xigua862/SMARTCAR2/CYH-NYY19届负压镜头纯跟踪算法/CYH-NYY19届负压镜头逆透视代码/视觉/灰度分布图/415e09331354bd54e4fce17c8508f7d.jpg

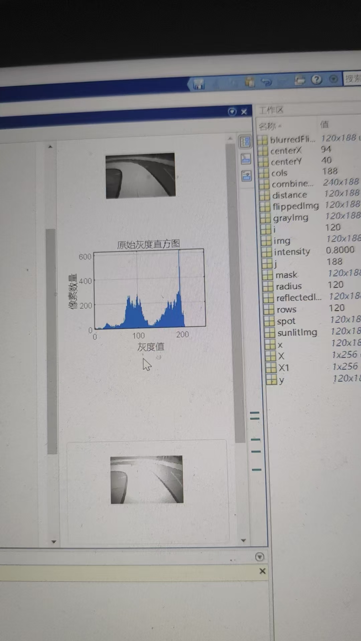
CYH-NYY19届负压镜头纯跟踪算法/CYH-NYY19届负压镜头逆透视代码/视觉/灰度分布图/415e09331354bd54e4fce17c8508f7d.jpg
