xigua862/SMARTCAR2/交接3-唯一入口-20261003.md

# B 车（微缩车）· 唯一入口 · 合并版

---

## §0 一页现状（2026-10-04 夜 · **PCB 阶段**）★ 新对话先读这一节

> 本节比下面的 §1~§5 新。**冲突时以本节为准。**

### 0.1 一句话

**原理图全部画完（DRC 已清）；PCB 刚开始 —— 板框和 5 个安装孔已定，正在布局。**

### 0.2 PCB 当前数据（直接可画）

```
板框      66 × 88mm  【实际做 87】（每侧 0.5mm 磨轮量）；厚 2.0mm
          后缘与框架后缘平齐，超长的 11.5mm 全部堆在车头
安装孔 5 个：Y（距板前缘）= 14 / 28 / 37 / 54 / 63     ← 前轴 28、后轴 54（轴距 26 ✓）
          孔径 φ2.2~2.4；配 M2×8~10 + 六面螺母
          X = 框架孔横向位置 ⏳【仍未量】——量法：框架孔中心 → 轮子内侧面的距离；<3mm 就把孔改成"板边开口槽"
转向中心  板前缘后 41mm
探头连线  板前缘【前】17mm（L=45）；可调 −7 ~ −27（L=35~55）⇒ 舌板前伸 ≥17mm
电路板    垫高 6~8mm（架在上排孔上方）→ 夹层 17~18mm 装下 15mm 电池
```

### 0.3 机械上的大变更（2026-10-04）

**侧框架前后翻转** → **编码器靠近车头、电机靠近车尾** ⇒ 编码器→前·核心、电机→后·驱动，**两条线不再交叉** ✓

⚠ 固件里 **"电机方向"翻一次**（两个一起）；编码器"左右一侧取负号"**不用变**（电机与编码器同在一框，相对关系未变）

### 0.4 这次会话（10-03→10-04）定下/改掉的东西

| 项 | 结论 |
|---|---|
| **灰度** | 外购龙邱 8 路模拟量 + **用「并出」10P**：**A0~A7 → PA0~PA7**（ADC 扫描+DMA，≈10µs、零偏斜）；**8 组 1k/1.5k + 100nF 分压**（模块供 5V）；"串出/1ADC+3GPIO"方案**作废** |
| **按键 ×2** | `PC13` = 正式发车键；`PB0` = 测试开始键（测试模式：电机 IN1=IN2=0 滑行+休眠、不循迹、等串口采数）|
| **LED ×3** | `PC14 / PC15 / PA12`，**串 470Ω** |
| **蜂鸣器** | **有源 5V**（PB10 → 1kΩ → SS8050 低边 + 1N4148W 续流）；**有源 = 只能开/关，不能 PWM 调音** |
| **编码器线序** | 6P（**GH1.25-6PWT**）：`1 GND / 2 VCC(3.3V) / 3 LSB(A相) / 4 DIR / 5 Z相 / 6 B相` —— **只用 A/B**（DIR、Z 留焊盘悬空）。左 = 3→PA15、6→PB3；右 = 3→PB4、6→PB5 |
| **驱动** | AT8236（**普通版**：VREF 接 3.3V；或 N 版）**R_ISEN = 0.11Ω/2512/≥1W → 3A**；⚠ ISEN 绝对最大 0.5V ⇒ R ≤ 0.167Ω |
| **保险** | VM 轨 = **一次性慢熔 10A（2410）**；逻辑轨 = 0.5A PTC（SMD1206-050-16）**两路分开** |
| **电源** | 5V 轨 ≈**320mA**（灰度 170 + LDO 输入 120 + 蜂鸣 30）→ 降压模块 **≥400mA**；**LDO = ME6211C33M5G-N**（3.3V 只喂 MCU/IMU/编码器/LED ≈120mA）|
| **空闲脚** | 全车只剩 **PB11**（PA4~PA7 已给灰度的 A4~A7）|
| **结构结论** | 结构件用 **PCB 不用碳板**（碳纤维导电 + 校赛不称重）|

### 0.5 ⏳ 待实测（按优先级；前 3 条阻塞后续）

1. **★喷绘布 940nm 对比度**（最高优先）：布 = 白 PVC + 黑墨，近红外可能穿透 → 黑态地基塌。用灰度模块**供 5V**在布上压白线/压黑底，量 **AO** 输出差
2. **★BN30-HSA 内部减速比**：总比 = 内部比 × 4.4。**总比 >28 连 R200 的 1.4m/s 都到不了**；建议 ≤20 ⇒ 决定要不要换齿轮配对（44+10 / 40+14 / 34+20，中心距都是 13.5mm）
3. **★框架孔的横向位置 X**（板框孔位最后一块拼图）
4. **灰度模块**：最小检测高度（6mm 能否认线）、**输出电平**（确认 8 组 1k/1.5k 分压到底需不需要）
5. **编码器实际计数率**（推车 1m）→ 若 k=4.4 则 1.2m/s 时 ≈**299kHz**，>200kHz 要换方案
6. **IMU 静止 10s 漂移 <1°** → 不过关则"惯导为主线"降级
7. 电池内阻（顶住轮子看压降，跌 >1.5V 要换）

### 0.6 ⚠ 悬案：串口"能发不能收"（历史复发问题）

用户原话："**之前串口总是出现单片机能发不能收的情况**"。常规项**他都已查出过、当时毫无问题**，所以别再从头念常规清单。

**已排除（查过没问题的）**：`huart1.Init.Mode = UART_MODE_TX_RX`、RX 脚配成输入（不是 AF_PP）、USART1 重映射、RXNEIE + NVIC 使能、TX/RX 交叉、共地。

**下一步该量的（用户自己列过、当时没量完）**：
1. **只插一条 USB** 时发命令应能回（验地环）—— 你板子现在是 **SWD + 串口合在一个 6P 座** ✓ 若 DAPLink 带 **虚拟串口(VCP)** ⇒ 只用一根 USB，地环从根上消失 ★ 最优先试这个
2. 量**板子 GND ↔ USB转TTL GND 的直流电压**：**>0.3V 即地环** ✗
3. 量 **USB转TTL 的 TXD ↔ MCU 的 RX 脚通断**：须 **0Ω**
4. 拿示波器看 RX 脚**空闲电平**与**收到数据时的实际波形**（是不是电压幅度不够 / 被拉死 / 一直低）

**板子上已做的 3 条防它**：① RX（PB7）**别加电容**（可加 10k 上拉到 3.3V）② 丝印写清 **`TX→接对方RX` / `RX←接对方TX`** ③ 尽量**只用一根 USB**（DAPLink VCP）

### 0.7 纪律（这次重申过的，接手人必须遵守）

1. **改稿先商量** ✗ 不许用"很自然的口吻"擅自改 —— 用户 10-04 明确批评过。要动文件先交"**要动哪几处**"清单
2. **机械 / 结构 / 装配 / 走线布局：不主动出主意** ✗ —— 用户原话"**只要关于机械你真的啥都不行，算了算了我自己搞**"。他问才答，且先说明"这是猜的、依据是什么、哪里不确定"
3. **机械数据只能靠他量**（我看的是截图，没有实物和三维感 ✗）
4. 结论先行 + 厚实质（每个结论带算术或出处）；但**"厚实质"不等于"厚猜测"**
5. 每改一步 **commit**（ASCII message）；军师只写文件、**提交归工人**
6. 项目隔离：只谈 B 车，不串 test17 / A 车
7. 只有他能决定的：**尺寸测量 / 空间判断 / 装配顺序 / 手感**

---

> **接手请只从这里读起。** 本文件由军师 2026-10-03 整合，**取代 `交接-B车-微缩车-20261002.md`（已作废）与 `交接2-B车-进度打包-20261002.md`（降为历史细节）作为入口**。
> 本文件只做两件事：**① 教你怎么判断哪份文档是真实信息；② 给出全部文档的状态表。** 具体的接口/尺寸/电路定稿一律以 §3 那三份正文为准，本文不复制它们的内容（复制必过期）。

---

## §0.5 唯一判定规则：按修改时间，从新往旧找

**真实信息 = 最近被修改的那几份。** 以后拿到这个文件夹，先跑这两条：

```bash
cd C:\Users\asus\Desktop\test16
ls -lat --time-style=long-iso .          # 根目录
ls -lat --time-style=long-iso 文档\      # 文档
```

落款日期**不可信**——文档正文里的"日期/v1.7"只是写作时的版本号，不代表它现在还有效。
例：`框架定稿` 落款 10-02 v1.7，但其中 **§1.1 尺寸表、§2.5 收腰排布、§2.1/§2.4 自画灰度子板** 都已被 10-03 的增量清单推翻（见 §2 表末"待并入"一行）。

> **历史件一律保留、不删**（这是 交接2 §10 的硬要求），但**禁止当现状引用**。

---

## 1. 一句话现状（2026-10-03）

- **项目**：B 车（微缩车），报 **机器车循迹**（校赛 + 普通省赛）——**不是**"飞檐走壁"组口径，电磁那套已整块删除。
- **规则硬点**：投影宽 ≤300mm；主控/传感器不限；**"主控/电机驱动/传感器至少其一"的板必须自画并印"2026 机器车循迹+队伍名"丝印** → 传感器可买，**主板必须自画**；不要求重量（减重优化已撤销）。
- **赛道**：5m×5m 黑色哑光喷绘布 + **25mm 白线**；A 区 R200 四连 S 波（瓶颈）→ C 区十字 → E 区 4 个 R300 相切圆环。
- **已定架构（v1.8）**：**结构底板（2.0mm PCB、双面铺铜、哑黑阻焊、不装元件）+ 上方电路板（核心+电源+传感接口，驱动可分可合）**；3S / 严禁 4S；AT8236×2（+1 预留风机）；**驱动构型 = 2 个电机**（每侧一个 N30 带同侧两轮）；循迹用**外购龙邱 8 路模拟量灰度模块**（自画灰度子板作废，原理图留档）；**★主线 = 惯导为主、光电为辅**（IMU660RC）；**控制周期目标 5ms**；**结构件用 PCB 不用碳板**（碳纤维导电 + 校赛不称重）。
- **实测真值**：轮距 **110** / 外到外 **132** / **轴距 26** / 轮径 **23** / 原车底板 **88×66** / 侧框架孔 y=0/9/26/35/49（φ2）/ 齿轮 0.5 模 44T+10T（合计 54、中心距 13.5）/ 电池 3S 2000mAh 63×18×15。
- **实测真值**（覆盖所有旧假设）：轮距 **110**、外到外 **132**、车底板 **88×66**。
- **最大风险**：喷绘布是"白 PVC + 黑墨"，**940nm 近红外可能穿透** → 黑白对比度不成立。

---

## 2. ★文档状态表

> 状态口径：**权威** = 现在照着做；**有效** = 内容仍对、供参考；**历史** = 只作来龙去脉，别当现状；**作废** = 明确别用。

### 根目录

| 文件 | 最后修改 | 状态 | 一句话 |
|---|---|---|---|
| **`交接3-唯一入口-20261003.md`（本文）** | 10-03 12:0x | **权威·入口** | 你正在看的；判定规则 + 文档状态表 |
| `README.md` | 10-03 00:15 | **权威** | **军师/工人协作规范**（可移植模板）：改文档的三道门、硬纪律、画图习惯 |
| `交接-B车-微缩车-20261002.md` | 10-02 15:33 | ❌ **作废** | 开工交接，当时结论是"已搁置"（三合一板 1800~2060 元太贵）→ 已被 交接2 推翻 |
| `交接2-B车-进度打包-20261002.md` | 10-02 22:25 | ⚠️ **历史（细节仍值钱）** | 进度打包；**§3 实测真值、§8 错误黑名单、§9 阻塞项**仍是最全的一份，值得读 |

### 文档 /

| 文件 | 最后修改 | 状态 | 一句话 |
|---|---|---|---|
| **`开场提示词-与设计理念-20261003.md`** | **10-03** | **★权威·入口配套** | 开新对话（任何 AI）时把 **§1 整段贴进去**；§2 是十条设计理念各自的来由 |
| **`框架定稿-B车C8T6-20261002.md`** | **10-03（v1.8）** | **★权威·法律** | 接口/架构/尺寸定稿。**v1.8 已并入 10-03 全部结论**（含 §0.5 变更表 + 末尾"画板检查表"）；§1.1/§2.1/§2.4/§2.5/§2.6 已按实测真值重写 |
| `待并入v1.8-清单-20261003.md` | 10-03 00:40 | ✅ **已并入 v1.8，降为留档** | 增量来源记录（规则依据、惯导主线、2 电机口径、6 个待测数、军师自查项、§五实测值）|
| **`讨论-外购循迹模块选型-20261003.md`** | 10-03 00:31 | **★权威·最新** | 模块选型讨论稿 → 已定：**买龙邱 8 路模拟量款**；含向客服的 8 个问题 |
| **`引脚图-B车C8T6-20261002.html`** | **10-03（v1.8）** | **★权威·配套** | 48 脚逐脚分配 + 电源树 + 前瞻/舌板 + 画板前必读；**灰度那整块已换成"外购模块接口"** |
| **`文档/PCB布线作业指导-20261004.md`** | **10-04** | **★权威·配套（画板时贴手边）** | §1 开工前定死 7 项（板框 66×88→**实际做 87**、**5 个孔位 Y=14.5/23.5/40.5/49.5/63.5**、垫高 6~8mm、铺铜、丝印、舌板）· §2 布局顺序 · §3 三条最要命（星形单点地 / 灰度模拟线 / AT8236 散热）· §4 小事 · §5 出 Gerber 前自检 |
| **`文档/AT8236-照这个画-20261003.md`** | **10-03** | **★权威·配套** | AT8236 应用电路"照这个画"：管脚定义 / 真值表 / **限流公式 `ITRIP=VREF/(10·R)`** / 版图建议 + **两个固件坑**（`00`=滑行且休眠、消隐 2.2µs）。**手册存 `硬件工程/AT8236数据手册.pdf`** |
| **`购物车清单-B车C8T6-20261002.md`** | **10-03（v1.8）** | **★权威·配套** | 总账 ≈320；ITR9909/LM393/电位器转**"暂缓（退路）"**；新增灰度模块/连接器/弹簧垫圈；电池已有 |
| `赛道情报-黑底白线5m-20261002.md` | 10-02 15:14 | 有效 | 赛道尺寸/最小半径 R200/红外规格/圆环与十字方案（§5 §6 已自我更正） |
| `源码调查-Retirement-Dance-20261002.md` | 10-02 14:58 | 有效 | 国赛源码（STC32G 逐飞库）+ **规则原文** + 引脚占用表 + 差比和公式与默认参数 |
| `开源整车情报-飞檐走壁致远探界-20261002.md` | 10-02 13:41 | 有效 | 那份 epro2 的出处：**21 届国一第二名整车开源**（三合一 V3.0 板） |
| `提速情报-三个开源包扒出来的-20260924.md` | 09-24 23:55 | 有效 | 三个竞赛开源包的算法/提速情报整理 |
| `赛道图-5000x5000-黑底白线.png` | 09-22 16:18 | 有效 | **赛道原图**（960×960 CAD 截图） |
| `接线对照表.html` | 10-02 17:27 | 有效（入门用） | 旧车入门款（TB6612 + 5 路）接线，已加作废指引 |
| `下单清单-今天就能拍板-20261002.md` | 10-02 17:27 | ❌ **费用/器件部分作废** | 2000 元三合一板方案 → 看 `购物车清单` |
| `改板清单-三合一板改红外-20261002.md` | 10-02 15:14 | ⚠️ **历史** | "沿用三合一板（STC32G）"的方向已被"自画 C8T6"取代 |
| `D1-能抄什么-必须改什么-20261002.md` | 10-02 12:39 | ⚠️ **历史** | D1 产出；其"TC264 还是 C8T6"的待定问题**已定 = C8T6** |
| `循迹小车使用手册.md` / `画板手册.md` | 08-20 / 08-19 | ⚠️ **历史** | **旧车（已出售那台）**资料，与 B 车无关 |

### 其他目录

| 目录 | 内容 | 状态 |
|---|---|---|
| `开源工程/`（8 包） | 飞檐走壁 STC32G 源码 / Micro_car 微缩车模型 / 车模 / TC264 库 / 马铃薯区赛+国赛 / 19 届负压 / 100g 爬壁车 | **算法情报可抄，机械尺寸别抄** |
| `硬件工程/` | 两份 `.epro2` + BOM + STC32G 电调说明书 | 有效（疯狂电路_V2 那份是别人的板，参考用） |
| `固件-STM32空壳/` | 旧车遗留代码 | **废弃，参考价值不多**（用户 10-03 判定）|
| `脚本/` | probe-epro2 / -bom / -titles / probe-xlsx | 四个探测工具，可复用 |
| `压缩包/` | zip / 7z / rar（git 已忽略） | 原始下载件 |
| `.qoder-cn/` | 另一个 AI IDE 的配置 | 与项目无关 |

---

## 3. 当前唯一权威（改设计只能看这三份）

1. **`文档\框架定稿-B车C8T6-20261002.md`** —— 法律（改它最贵）；改动要先走 §2 表末那行"待并入"清单，**攒够了一次性出 v1.8**。
2. **`文档\待并入v1.8-清单-20261003.md`** —— 尚未并入正文的增量；**它比框架定稿新**，两者冲突时**以它为准**。
3. **`文档\讨论-外购循迹模块选型-20261003.md`** —— 模块选型的最终结论（买龙邱模拟量款）。

> 规矩：数据没实测完**不动正文数字**；改正文要过"实测/出处 + 用户拍板 + 写出处"三道门（见 `README.md` §三）。

---

## 4. 待办与阻塞（v1.8 刷新，按优先级）

**画板可以直接开始**——尺寸真值已到齐。下面按"卡不卡画板"分两类。

### A. 卡"画板"的三条（动笔前最好先有）
1. **侧框架上下两排孔各自离地多高 + 两框架内侧间距** → 决定结构底板与电路板的分层高度、底板横向可用宽度。
2. **灰度模块"安装耳平面 → 探头面"高度** → 倒推舌板（上板）必须落在哪个高度。模块到手就量。
3. **校赛规则复核**：限宽/限长、**是否允许成品传感器模块**（决定了"主板必须自画带丝印"这条怎么落地）。

### B. 不卡画板、但决定成败的五条
4. **★喷绘布 940nm 对比度**（最高优先）：布 = 白 PVC + 黑墨，近红外可能穿透 → 黑态地基塌。用灰度模块（供 3.3V）在布上分别压白线/压黑底，量模拟输出差。
5. **★BN30-HSA 内部减速比**：总比 = 内部比 × 4.4。**总比 >28 连 R200 的 1.4m/s 都到不了**；空载会掉，建议 ≤20。它决定"能不能提速"，也决定要不要换齿轮配对（44+10 / 40+14 / 34+20）。
6. **★灰度模块 8 问**（框架定稿 §2.4）：**最小检测高度（6mm 能不能认线）** 与 **地址切换 settling（≤20µs）** 是生死线。
7. **编码器标度改推车 1m 标定**，并顺便实测**实际计数率**（k=4.4 时 1.2m/s 就 299kHz，>200kHz 要换方案）。
8. **IMU 静止 10s 航向漂移 <1°** → 不过则"惯导为主线"降级，退光电为主。

### C. 已验证/已销案（别再重复问）
- ✅ IMU 型号 = 逐飞 **IMU660RC**（照片确认，8P，针序已抄进引脚图）
- ✅ 赛道 = 5m 黑底喷绘布 + 25mm 白线；R200 是全场瓶颈；E 区 4 个 R300 相切环
- ✅ 规则口径、复用件合规话术、丝印要求（见框架定稿 §4）
- ✅ 6 个待测数中的几何项（轮径/轴距/轮距/轮宽）已实测，见 §1"实测真值"

### D. 收工纪律
- 改一步 **commit** 一次（ASCII message）；**军师只写文件，提交归工人**
- 本轮改动（v1.8 三份 + 交接3）**尚未提交**

> **git 状态**：`README.md`、`文档\待并入v1.8-清单-20261003.md`、`文档\讨论-外购循迹模块选型-20261003.md` 三份**尚未提交**。军师只写文件、**提交归工人**。

---

## 5. 协作规矩入口

**怎么和我（或下一个 AI）协作，看 `README.md`。** 三条最容易踩的：

1. **先建 `文档\讨论-<主题>-<日期>.md` 再讨论**；讨论完才谈要不要改正文。
2. **一句话 ≠ 授权**：要动正文，先交"要动哪几处"的清单，等点头。
3. **回答风格 = 结论先行 + 厚实质**：每个结论都带算术或出处；不绕圈，也不短到没料。

---

*本文为指路文件，本身不含接口/尺寸数据 → 不会因设计变更而过期；只在新文档增删时更新。最后更新：2026-10-03*
