xigua862/SMARTCAR2/交接-B车-微缩车-20261002.md

> ⛔ **2026-10-03 作废**：本文件的"已搁置"结论以及全部方案，已被 `交接2-…` 与 **`交接3-唯一入口-20261003.md`** 取代。
> **入口请从 `交接3-唯一入口-20261003.md` 读起。** 本文仅作历史留档（按 交接2 §10：旧文档不删）。

---

# B 车（微缩车）· 开工交接 · 2026-10-02

> ⏸ **2026-10-02 状态：已搁置**（DRV8701 三合一板方案总账 **1,800~2,060 元**过高，其中 SMT 工程费 500~600 省不掉）。
> 本次调查的**可复用情报已移交 A 车** → `test17/文档/B车搁置-可复用情报-20261002.md`（含**白线宽 25mm**、R200 速度上限、国一圆环状态机、斑马线判据、成本结论）。
> 本仓库资料**不删**，重启时从 `文档/下单清单-今天就能拍板-20261002.md` 接着跑。

> **一句话**：国庆 7 天队友不在、A 车（test17）等新板没法调 → **不空等，启动 B 车研究**。
> 定位：**求上得中**——A 继续主线，B 作新平台推进。
> 本文件 = B 车所有工作的**入口**（就放在 test16 根目录）。

---

## 0. 开工第 0 步（✅ 已完成 2026-10-02）

`git init` + `.gitignore` 已做，已有 5 个 commit（`git log --oneline` 可查）。git 已加进用户 PATH。
→ 以后**每改一步就 commit**（A 车血泪纪律：能回退 > 一切）。

---

## 0.5 目录结构（2026-10-02 整理后，**旧路径全部作废**）

```
test16\
├─ 交接-B车-微缩车-20261002.md   ← 你正在看的入口
├─ 文档\            所有情报/手册/改板清单（.md .html）
├─ 硬件工程\        两个 .epro2 + BOM + STC32G 电调说明书
├─ 开源工程\        8 个参考包（飞檐走壁源码 / 微缩车模型 / 车模 / TC264库 / 马铃薯×2 / 19届 / 100g）
├─ 固件-STM32空壳\  Core / Drivers / MDK-ARM / test16.ioc（C8T6 遗留壳，暂不动）
├─ 脚本\            probe-epro2 / -bom / -titles / probe-xlsx 四个探测工具
└─ 压缩包\          zip / 7z / rar（git 已忽略）
```

---

## 1. 手上已有什么（别再重复找）

| 位置 | 内容 |
|---|---|
| ★`开源工程/飞檐走壁-STC32G源码/` | **B 车主控板 + 软件的直接来源**：21 届飞檐走壁国一第二名的整车工程 + 国赛源码（逐飞 STC32G 库）。解读见 `文档/源码调查-Retirement-Dance-20261002.md` |
| ★`硬件工程/ProPrj_21届智能车-飞檐走壁-致远探界整车工程_2026-10-02.epro2` | 同上那份的**嘉立创EDA 整车工程**（4 块板，含「飞檐走壁三合一 V3.0」主控+驱动板）→ **B 车就沿用这块板改** |
| `开源工程/微缩车模型-Micro_car/` + `…/更新_看这个/` | 微缩车**全套 SolidWorks 模型**（030 电机 / 负压 / 磁编码器 / 碳板）+ 物料清单 + 避坑说明 |
| `开源工程/100g爬壁小车/` | 参照二号：100g 超轻量化，附基础循迹代码 |
| `开源工程/车模-SolidWorks/` | 第三份模型（碳杆 / 轮毂 / 摄像头支架） |
| `硬件工程/STC32G 无感 FOC-mini 电调使用说明书.docx` + `压缩包/minifoc….zip` | 无刷/FOC 电调资料（**若负压改有刷就用不上**） |
| `硬件工程/ProPrj_疯狂电路_V2_2026-09-22.epro2` | 另一份开源板（TC264 平台，作者 marling）——已调查，见 `文档/D1-能抄什么-必须改什么-20261002.md` |
| `开源工程/` 其余 4 包（国赛/区赛/19届/TC264库） | 软件与调参情报（详细解读见 test17 的《提速情报》） |
| `test17/`（A 车项目） | 固件 / 判据 / 串口工具 / 双AI工作流——**但注意：B 已转 STC32G（8051），HAL 驱动层不能直接搬，只能搬算法和工作流** |

## 2. 先定三件事（不用全定完才动手，但越早定越省事）

1. **B 的目标**：~~冲名次 / 学习探索 / 备胎？~~ → 已定：**沿用开源整车工程复刻 + 改红外**，7 天一个人；
2. **比赛口径**：✅ 已从开源页拿到**飞檐走壁组规则节选**（电磁载流导线 / 负压吸附 / **100g 以内不罚时、每 20g 罚 1s** / **连续两圈**）——见 `文档/源码调查…md` §1。
   ✅ **已确认：我们的赛道 = 5000×5000 黑底白线**（`文档/赛道图-5000x5000-黑底白线.png`）→ **红外成立，电磁整块删**；也说明我们跑的**不是飞檐走壁国赛同一口径**，罚时规则要按自己赛规重核。
   ⚠️ **仅剩待确认：白线线宽**（定红外间距）+ **逐飞车模电机带不带编码器** → 见 `文档/赛道情报-黑底白线5m-20261002.md` §7。
3. **重量与目标（已定）**：✅ **普通省赛、不要求重量、只要快** → 减重优化全部撤销，风机与飞坡逻辑保留；
   ✅ **负压风机实测 5Ω/两根线 = 有刷** → `EG2134 + Q1~Q6 + 第 2 片 STC32G` 直接删，风机接 **DRV8701 第 3 半桥（IN5=PWM、IN6 常低、VS3→风机）**，零新增元件；
   ✅ **驱动电机 = 逐飞车模标配 030 有刷** → 电池定稿 **3S 450~600mAh ≥20C + XT30**，峰值按 8A 留余量。
   👉 **执行入口：`文档/下单清单-今天就能拍板-20261002.md`**（今天该下的单全在里面）。
4. **和 A 的关系**：主控已定 **STC32G12K128（8051，Keil C251，串口 ISP 下载，无在线调试）** → A 的 HAL 驱动不能搬，**只搬算法层与串口调参工作流**；采购别和 A 的 BOM 混。

## 3. 这 7 天建议排期（板子没到 ≠ 停工）

| 天 | 干什么 | 产出 |
|---|---|---|
| D1 | ✅ 已做：读 `Micro_car/README.md` + 两份 epro2 调查 + 国赛源码调查 | 已产出 3 份文档（见 `文档/`） |
| D2 | ✅ 基本定：主控沿用三合一板（STC32G）、负压建议改有刷、循迹改红外 | 待你拍板：赛道有没有可见线 + 电机型号清单 |
| D3-4 | 底板 + 支架出图（碳板切割 或 PCB 当结构板）；电路框图（主控 / 驱动 / 电源） | 切板文件 或 打样单 |
| D5 | 采购清单（对照 README 物料表，逐项标“已有 / 要买”）→ 下单 | 淘宝 / 立创订单 |
| D6-7 | 软件移植：从 test17 抄循迹 + 遥测骨架，建 B 的 Keil 工程 | 能编译的空壳工程 |

**每天收工写 3 行日志**放进本文件夹（`日志-2026xx.md`）——A 车最大的痛点就是信息断层，靠文档才没断片。

## 4. 纪律（全是从 A 车血泪里抄的，直接搬）

1. 改东西前先 commit；固件版本号用**真实时间**；
2. **模块禁止悬空叠装**；外挂模块固定死、背面针脚剪短 + 绝缘（A 车连环烧板的元凶）；
3. 电池走 **XT30**，大电流别过 0.5A 级接插件；DC 座只做台架口，一次只插一个电源；
4. 电源第一次上电三步：**量极性 → 量输出（调到 5.0V）→ 最后挂负载**；
5. 陀螺仪**不要翻面装**（GZ 符号会反）；上电时车要静止（零偏标定）。

## 5. 开工必读顺序

1. 本文件
2. `文档/下单清单-今天就能拍板-20261002.md`（**当前执行入口**：电源定稿 + 板子删改 + 现成件 + 结构件）
3. `文档/赛道情报-黑底白线5m-20261002.md`（赛道尺寸/最小半径 R200/红外规格/圆环与十字方案）
4. `文档/源码调查-Retirement-Dance-20261002.md`（规则节选 + 引脚占用表 + 电源需求）
5. `文档/改板清单-三合一板改红外-20261002.md`（删什么 / 加什么 / 保什么，带位号）
6. `开源工程/微缩车模型-Micro_car/README.md`（物料清单 + 设计要点）
7. `开源工程/微缩车模型-Micro_car/更新_看这个/A整车.SLDASM`（最新版模型）
8. 软件要抄时回 test17 → 入口 `test17/文档/交接-双AI分工-20260925.md`

## 6. 给 B 车新对话的开场提示词（开新对话就复制这段）

```text
# 角色：B 车（微缩车）项目助手
项目：B 车（微缩车），参照 test16 里的开源车模。工作目录 C:\Users\asus\Desktop\test16。
本提示词配合 交接-B车-微缩车-20261002.md 使用。

# 第一步
读：交接-B车-微缩车-20261002.md → 文档/源码调查-Retirement-Dance-20261002.md → 文档/改板清单-三合一板改红外-20261002.md。
（目录已于 2026-10-02 整理：文档/硬件工程/开源工程/固件-STM32空壳/脚本/压缩包，旧路径作废。）
读完回我：一页纸"能抄什么 / 必须改什么" + 建议先定哪件事。

# 规矩
- 先把"三件事"（目标 / 规则口径 / 与A车关系）定掉再动手；规则原文没找到之前不订任何定制件；
- 任何物理动作（切板 / 下单 / 烧录 / 通电）之前先跟我说一声；
- 沿用 A 车纪律：改前 commit、模块不悬空、电源上电三步（量极性→调5V→挂负载）；
- 回复短、结论先行（我在手机上）。
```
