xigua862/SMARTCAR2/交接2-B车-进度打包-20261002.md

> ⚠️ **2026-10-03 更新**：**入口已迁移到 `交接3-唯一入口-20261003.md`**（含判定规则 + 全文件夹文档状态表）。
> 本文**降为历史细节**：§7 的 v1.8 待办与 §9 的阻塞项**部分已被 10-03 的三份增量超越**（以 `文档\待并入v1.8-清单-20261003.md` 为准）。
> **但 §3（实测真值）、§8（错误黑名单）仍然是最全的一份，值得读。**

---

# B 车（微缩车）· 进度打包 / 第二次交接 · 2026-10-02

> **接手人从这里读起。** 这份文件取代上一条 `交接-B车-微缩车-20261002.md` 里"已搁置"的状态：B 车已复活，且已推进到**画板前夕**。
> 出这份打包的人（原军师）已把当天所有推理、算术、**以及自己犯过的错**都写进来了 —— 第 8 节那张"错误黑名单"是这份文件最有价值的部分，**先读第 3 节和第 8 节，否则会重复踩**。

---

## 0. 一句话现状

自画 STM32F103C8T6 两层板的方案已经推到 **v1.7**：电源架构、引脚分配、灰度前端电路**全部定稿并有文档**；灰度子板原理图**已经画完（用户手绘，含 8 路 ITR9909 + 4 片 LM393DR2G + 4 只 100nF + 11P 排针 U17）**；**主板和子板的 PCB 都还没画**，所以任何决定现在改都是零成本。

**当天最后 20 分钟发生的方向变更（尚未同步进文档，见第 7 节）**：用户决定**灰度子板改为采购市售成品模块，不自画**（原话"现在画的感觉收获盖不上投入"），已画的子板原理图**停在不打样**的状态。同时用户实测了车的真尺寸，**推翻了此前所有文档里的尺寸假设**。

---

## 1. 沟通与工作纪律（这条项目里换人最容易出事故的地方）

用户的明确要求，**逐字遵守**：

1. **"每一次要进行大改动的时候，先跟我确定好你要干什么，然后我再确定。"** 他抱怨过"你总是埋头苦干，但是我想跟你沟通却做不到"。→ 多文件改动前先交一份"要动哪几处"的清单，等他点头。
2. **"每次我给你新方案，先给我调查、给出意见，等我确定。"** → 他提任何新想法（换路数、换模块、换方案）时，**先查、先算、先给结论**，不要直接改文档，也不要直接否定。
3. **回答风格**：他被两种回答都呛过 —— "扯东扯西"（绕圈 + 空话）和"太短太短了"（结论对但没料）。**标准是：结论先行 + 厚实质**，每个结论都要带算术或出处。
4. **任何物理动作（下单 / 切板 / 烧录 / 通电）前必须先说一声。**
5. **只管 test16（B 车），不许串 test17 / A 车的结论。** A 车是另一条线（主体结构定型但 PCB 故障）。
6. **每改一步就 commit**（A 车血泪纪律：能回退 > 一切）；commit message 用 **ASCII**（PowerShell 中文会乱码）。
7. 军师**错了要公开撤销**，不许悄悄改数。

---

## 2. 文件地图与 git 状态

| 位置 | 内容 | 状态 |
|---|---|---|
| `文档\框架定稿-B车C8T6-20261002.md`（451 行） | **画板与写码的"法律"**：§0 电源、§1.1 尺寸、§2.1 分板、§2.2 电源树、§2.4 灰度单路定稿、§2.5 灰度排布坐标与循迹几何、§2.6 PCB 分区、§4 赛道、§5 待实测、§8 修订记录 | v1.7，**尺寸与灰度方向已过时**（见第 7 节） |
| `文档\引脚图-B车C8T6-20261002.html`（180 行） | 48 脚逐脚分配 + 11P 子板排针表 + 电源树 + 画板前必读 danger box | v1.7，**11P 那节要换成外购模块接口** |
| `文档\购物车清单-B车C8T6-20261002.md`（150 行） | 总账 375~395、白嫖 6 项、必买电子 20 项、动力杂项、不买清单 | v1.7，**#5/#6/#7 待转"若自画再买"** |
| `文档\赛道情报-黑底白线5m-20261002.md` | 场地：5m×5m **黑色哑光喷绘布 + 25mm 白线**、R200 四连 S 波、E 区 4 个 R300 相切圆环 | ✅ 有效 |
| `文档\提速情报-三个开源包扒出来的-20260924.md`、`循迹小车使用手册.md`、`画板手册.md` | 参考 | 有效 |
| `开源工程\` | 8 个参考包：飞檐走壁 STC32G 源码 / Micro_car 微缩车模型 / 车模 / TC264 纯跟踪开源库 / 马铃薯区赛摄像头 + 国赛光电管 / 19 届负压镜头纯跟踪 / 100g 爬壁车 | **算法情报可抄，硬件别抄** |
| `固件-STM32空壳\` | CubeMX 生成的 C8T6 空壳（Core/Drivers/MDK-ARM/test16.ioc） | **未动，一行用户代码都没有** |

```
HEAD = 2dd2cf2  docs(B-che): v1.7 revert to dual rail 5V+3.3V per final schematic ...
         14735c5 → 345ba03 → 125f79c → 4677bba(v1.5) → a98992f(v1.6) → 2dd2cf2(v1.7)
工作区：干净（只有 开源工程\Micro_car\~$*.SLDPRT 这几个 SolidWorks 临时文件是 untracked，可删可忽略）
```

---

## 3. ★实测尺寸真值（今天才拿到，**覆盖所有旧文档的假设**）

| 项 | **真值** | 旧文档里写的（作废） |
|---|---|---|
| 轮距（两轮**中心**距） | **110mm** | ~~75~85mm~~ |
| 轮宽 | **22mm × 2 = 44mm** | 未定 |
| 横向外侧面到外侧面（整车总宽） | **132mm** | 未定 |
| **车底板**在轮轴方向的尺寸 | **88mm** | ← 这个数被误读过，见第 8 节 |
| **车底板**纵深（车头-车尾） | **66mm** | 未定 |
| 灰度板 | **可伸出底板安装** | ~~"板宽 88 比轮距略宽，⚠装不下"~~ |

**关键读法（接手人别再错）**：**88 是底板的尺寸，不是灰度板的尺寸。** 灰度板横向能伸出去，所以上限取"轮外侧 132"与"规则限宽"的较小者；但**伸出去就是悬臂，悬臂会下垂，下垂直接毁掉离地 6mm 这个地基** —— 所以推荐值仍是 **≤88mm**（理由从"装不下"变成"零悬臂最稳"，见第 4 节）。

**还没量到的两个数**（第 9 节）：① 驱动轴在底板 66mm 纵深里的**哪个位置** → 决定前瞻量；② 校赛的**限长/限宽/是否允许成品传感器模块**。

---

## 4. 灰度方案：当前推荐（v1.8 应写进文档的内容）

### 4.1 定稿尺寸建议

| 维度 | 建议 | 依据 |
|---|---|---|
| 横向总宽 | **≤88mm**（买不到就 90mm；**≥100mm 一律不要**） | 88 = 底板尺寸 → 零悬臂；每多悬出 6mm，弧上侧倾 + 接缝冲击就把板头往下压，**下垂 0.5mm = 8% 离地漂移** |
| 路数 / 档距 | **8 路 @ 均匀 10~12mm，首选 11mm** | 11mm 让 25/11 = 2.27 **错开** 1:2 整数比（12.5mm 档会必然出现"管子正好骑在线边沿"的相位，差比和失真最大）；<10mm 是串光区 |
| 纵深（板短边） | **20~25mm** | 一排 8 只管只需 4.5mm 横向 + 隔墙，电位器/排针往纵深摆。**别做成 88×66**，越窄刚度越高 |
| 捕获范围 | 均匀 11mm 档 → span 77 → **±44mm** | 见下面 4.2 的算术，±44 已经过剩 |
| 前缘→驱动轴 | **40~45mm**（要配支撑），量不出来退到 **25~30mm** | 45mm 时弧上提前量 `d²/2R` = 5.1mm（≈0.5 档）；30mm 时 2.25mm；**25mm 以下"提速靠前瞻"直接作废**，改靠陀螺前馈 |
| 离地 | **6±1mm**，螺丝/铜柱定死 | ITR9909 手册测试条件；整套阈值的地基 |
| 板形 | **直排，不弯** | 弓高 `L²/8R = 612/R`：R200→3.1mm、R100→6.1mm，竞赛弧 R≥100 → 弯板零收益 |

### 4.2 为什么 ±44mm 捕获就够（这条算术直接判了"加宽 / 加路"死刑）

算的是**丢线之后车能跑掉多远**，不是"板子能做多宽"：

- 最坏按"车斜 15° 冲出线"（弧上出弯量级）→ 横向逃逸速度 = 1.2 × sin15° ≈ **0.31 m/s**。
- 检测 + 转向生效约 **50ms**（10ms 拍 × 5）→ 横向只跑掉 **15.5mm**。
- 再叠满舵后的侧滑余量 → **±30mm 够用，±44mm 已带余量**。

→ **所以"多几只管去抓更宽"在这台车上没有理由。** 原军师 v1.7 给的 ±52.5mm 收腰方案，是把横向尺寸换成了悬臂风险，**方向错了，已撤回**。

### 4.3 12 路 / 16 路 的正确判语（别再抄标准车的排布）

- **市面"循迹板宽 = 车宽、16 路"是标准车（车宽 200mm 级）的排布 → 档距 ≈13mm。我们 110 轮距 / 88 底板里放 8 路 @11mm，密度反而更高，不是缩水。**
- **12 路的真门槛是芯片的脚，不是板子。** C8T6（LQFP48）上真正空闲的**只有 PA12（USB D-）和 PC15（现那块空闲测试盘）**；第 11、12 路必须从 **PB1/PB2（负压第三颗 AT8236 的退路）**身上抠。要 12 路就得先决定舍不舍得负压。
- 12 路 @11mm 需 121mm 总宽 → 每边悬出 16.5mm 的悬臂板，代价是离地守不住。
- 现成模块**确实有 12 路**（立创开源那套工程就有七路/八路/十二路三个版本），买来即用，但 GPIO 那道墙一样在。

### 4.4 ★采购成品模块的 5 条硬指标（用户已决定采购）

| # | 指标 | 为什么 |
|---|---|---|
| 1 | **供电 3.3~5V 宽压，且输出电平跟随供电**（或明确标 3.3V 可用） | **PA0~PA7 是非 FT 脚**（绝对上限 VDD+0.3 = 3.6V），5V 输出直怼会被内部 ESD 二极管钳住并倒灌。找不到宽压款就退一步：**每路 1k/2.2k 分压**（0603 共 16 只，主板还没画 → 零成本）。⚠ **只串一只电阻不分压是错的** |
| 2 | **并行 8 路 DO 输出，不要 I²C / 串口款** | I²C 款要吃 PB6/PB7，那正是 USART1 遥测；为它重排引脚表比画子板还贵。并行款正好落回 PA0~PA7，`GPIOA->IDR & 0xFF` 一条指令拿全帧的好处原样保住 |
| 3 | 档距 **10~15mm**，向客服要**板框图与档距标尺** | <10mm 串光区；≥25mm 踩第 4.5 节那条致命线 |
| 4 | 每路**独立电位器**或**一键校准 + 断电记忆**；每路**状态 LED** | 8 颗 LED 是 30 秒验极性 / 验场地 / 验遮光的工具，比任何说明书可信 |
| 5 | 板总高能否达到**离地 6mm**；伸出段下压不晃 | 离地是阈值的地基；延伸安装要 2mm 厚板 / 双面覆铜当桁架，必要时前缘加定高滚轮或铜柱 |

**买回来仍要落到固件的三件事**（不因采购而消失）：
1. `IR_POS[]` 按厂家**真实档距**填（11 就填 11，12.9 就填 12.9），别默认等间距后用 `(i-3.5)`；
2. **符号标定**：线放车体**右侧**，err 应为正，反了就翻 `IR_SIGN_FLIP`（装反排线 / 镜像安装是"越纠越偏"的头号来源）；
3. **上电自检**：黑底应全 `0x00`、跨白线应见 `0xFF`，不对就蜂鸣。⚠ 现成模块板载滤波会拖慢响应 → **过采样的子采样间隔仍需 ≥50µs**（ITR9909 的 tr=tf=15µs，1µs 间隔突发采样对这颗管毫无意义，这也解释了 A 车"OS 恒为 0"的悬案）。

### 4.5 曾经用来论证"必须自画"的三条硬规矩（现在变成"验收成品模块的标准"）

1. **中心一对的间距必须明显小于线宽。** 25mm 线正压中心时覆盖 [−12.5,+12.5]；若中心管放 ±13（间距 26mm）→ **两管全在线外 → 8 位全 0 → 误判丢线**，而这正是最常待的状态（7mm 光斑把瞎区糊成 ±3mm）。**这是"能不能用"级别的问题，不是精度问题。**
2. 全档 ≥10mm（6mm 处光斑 ≈7mm + 封装宽 4.5mm → 隔墙净空要 5.5mm）。
3. 相邻档不得台阶跳变（非均匀时 10→12.5 缓变可以，12→25 会造出台阶）。

→ **市售 8 路 / 90mm / 7 档 ≈12.9mm 天然满足这三条**，所以"坐标可控"不构成自画的理由 —— 原军师据此**撤销了"必须自画"的建议**，支持采购。

---

## 5. 半圆弧的硬账（用户指定赛道元素，与采购无关，全部有效）

| 量 | 数值 | 备注 |
|---|---|---|
| 侧向加速度 | R200 @1.2m/s → `v²/R` = **7.2 m/s² ≈ 0.73g** | **这就是 R200 是全场唯一速度瓶颈的原因** |
| **差速比（用真轮距 110）** | 内轮半径 145 / 外轮 255 → **1.76** | 旧文档按 80mm 算是 1.44/0.96，**低估了** |
| 弧上轮速 | v=1.2 → 外轮 **1.53**、内轮 **0.87 m/s**，**Δv = 0.66 m/s** | 比按 80mm 算的 0.48 高 **37%** |
| 角速度 | `v/R` = 6 rad/s = **344°/s** | ±4000dps 量程零头都不到；10ms 一拍最大 3.44° |
| 弧长 | 半圆弧 R200 = πR = **628mm = 180°** | **弧的几何是已知的，别当未知量做反馈**：陀螺累计转角到 **150~160° 就主动回正** |
| 提前量 | `d²/2R`：d=20→1.0、30→2.25、40→4.0、45→**5.06mm** | 前瞻的物理收益 |
| 时间提前 | 45mm / 1200mm/s = **37.5ms ≈ 3.7 拍** | |
| 宽轮距的好处 | 轮距 80→110 使横滚刚度 ↑约 37% → **弧上离地漂移比原估计小** | 唯一的好消息 |

**四条控制律层面的结论（写码时必须遵守）**：
1. **稳态跟弧时 error 必须持续非零** → "error 大就减速"的逻辑会在弧心把车刹到几乎停下。**减速判据只能挂曲率估计或陀螺角速度，不能挂 |error|。**
2. 进弧判据用"**连续 3 拍 error 同号且 \|error\| 递增**"，不要用单拍幅度。
3. 差速车绕驱动轴转 → **灰度板装在驱动轴之后必读"已经转过去的线"**，所以前缘必须在轴前。
4. **弧是打滑高发区**（内外轮路径差 76% → 必须横向滑磨）→ 轮轴编码器的**里程系统性虚高** → 圆环 / 终点判据必须叠陀螺角度积分兜底。

---

## 6. 已定稿·**不要再复议**的技术结论

**电源架构（v1.7 定稿）**
```
12.6V ─┬─ 功率轨 VM 12.6V ── AT8236×2(+1 预留) ── 电机 / 风机
       └─ 逻辑轨 12V→【5V 降压模块，连续 ≥400mA，⚠不能是 4.7V】
              ├─ 一路直接上子板 / 模块：发射管 + LM393 的 VCC      ≈171mA
              └─ 一路 AMS1117-3.3（≥300mA）→ 3.3V = MCU/IMU/信号侧  ≈90~120mA
```
- 5V 预算 165(LED 8×21) + 6(4 片 LM393) + 120(LDO 输入) = **290mA → 模块必须连续 ≥400mA**。
- **模块必须 5V，4.7V 不行**：LM393 输入共模上限 = VCC−1.5V → 4.7V 时 3.2V，而**黑态节点就是 3.3V → 超限 0.1V**，症状＝"阈值拧到上半段没反应"。
- **严禁让 AMS1117 直吃 12.6V**：(12.6−3.3)×0.12 = **1.1W** → SOT-223 热保护。LDO 耗 (5−3.3)×0.12 = **0.2W** ✅。
- **严禁 4S**。每颗 AT8236 **必须按手册算采样电阻把限流设到 3A**（N30 堵转标称 <15A，超芯片 6A 峰值）。
- 星形单点地：功率地 / 逻辑地 / 子板地 在输出电容负极汇一点；灰度回线不穿功率区。

**灰度前端电路（若改回自画才用得上，但极性/共模这些结论仍适用）**
- 极性：**白线 = 1、黑底 = 0**（`IR_WHITE_IS=1`）；指示灯**黑底时亮**。验法：白线上 OUT 读 3.3V、黑布上读 0.1V。
- 单路：R1 **180Ω/0805**（5V→发射管 ≈21mA = 手册条件；⚠0603 自耗 76mW 到额定 76%；330Ω 只 11mA → 白态节点 2.2V → 电位器可用行程只剩 56%）· R2 10k（3V3→集电极）· R3 10k 电位器**逐路 8 只** + 下端 10k→GND（行程 1.65~3.3V 全有效，**拧到 2.2~2.6V 那一带，别用端点**）· R4 4.7k（3V3→OUT，**严禁接 5V**）· R5 470Ω（指示灯）· 每片 LM393 就近 100nF 贴 8/4 脚 <2mm · 迟滞 R6 470k **不焊但每路留空 0603** · **节点 100pF 不需要**（10k×100p = 1µs，对 15µs 的管子无意义）· **输出严禁挂 100nF**。
- 摆幅：白态节点 ≤1.3V（手册下限；实际深饱和 0.2~0.4V），黑态 3.1~3.3V → **≥1.8V**。
- **LM393 是双路 → 8 路要 4 片**（2 片的话得换 LM339 四路）。
- 上电：LM393 无 EN → **固件前 100ms 丢弃灰度**。

**其他已核实项**
- **逐飞 IMU660RC = LSM6DSV16X：只有 I2C/SPI，没有 UART**（官方 Gitee + 本地 TC264 库 `zf_device_imu660ra.c/h` 查证）→ 默认硬件 SPI2，**分频 /4 = 9MHz**（芯片上限 10MHz，**别用 /2**）；模块自带 LDO 但仍给 3.3V；⚠ **SDO 与 SA0 是同一根脚 → SPI 下是 MISO，严禁接地或接 3V3**；IMU 座 **8P**（3V3/GND/CS/SCK/MISO/MOSI/INT1/INT2），INT1 做 DRDY 外部中断；IMU 区离风机 ≥40mm + 四角减震柱 + 板面印方向箭头。
- **逐飞迷你编码器 Pro 1024P/R 装轮轴** → `mm/count = π·D/4096`（D=32mm → 0.0245），**减速比彻底不用知道**，标定降为量轮径；1.2m/s → 12.2kHz、4× 后 48.9k count/s、16 位溢出 1.34s。
- **引脚分配定稿**：IR1~8 = PA0~PA7（整口读，兼 ADC1_IN0~IN7）· 电机 L_IN1/2、R_IN1/2 = PA8~PA11（**TIM1_CH1~4，必须 `__HAL_TIM_MOE_ENABLE`，忘了＝程序在跑电机不转**）· 左编码器 PA15+PB3（TIM2 部分重映射）、右 PB4+PB5（TIM3 部分重映射）· IMU SPI2 PB12~PB15 + INT PB8/PB9 · 遥测 USART1 PB6/PB7（TX 走 DMA）· 蜂鸣 PB10 · 按键 PB0/PC13 · LED PC14 · 风机预留 PB1/PB2 · SWD PA13/PA14 **必须留 4P 座** · BOOT0 10k 下拉 · 空闲 PA12/PC15。⚠ **PA15/PB3/PB4 默认是 JTAG 脚 → 固件第一件事 `AFIO->MAPR |= (2u<<24)` 禁 JTAG 保留 SWD。**
- 主板上留 **4 个板边测试盘**（3.3V / VM / GND / 空闲 ADC）—— 治"电机会因为震动突然断电"。
- 软件骨架：SysTick **10ms 唯一控制周期**；TIM1 20kHz PWM；编码器硬件计数不开中断；分层 drivers/middleware/control/app；**每种赛道元素只允许一套判据**；**禁 while(1) 死循环停车**。
- 负压：**装不装等首次实测圈速再定，校赛前夜绝不装**。结构侧零成本（扇叶/支架已有，底板开孔 + 留 4 螺丝孔即可），板上留第 3 颗 AT8236 焊盘 + PB1/PB2 引出。风机 5Ω → 12.6V 约 2.5A。
- 电机 N30 **扭矩过剩 13 倍**，别再找"大扭矩电机"。胎皮是"唯一买得到的物理上限"（开源作者原话"抓地第一"）。

---

## 7. ★v1.8 待办清单（文档还没改的部分，接手人优先做这个）

| 文件 | 小节 | 要改什么 |
|---|---|---|
| 框架定稿 | **§1.1 尺寸表** | 轮距 75~85 → **中心距 110 / 外到外 132 / 底板 88×66**；**删掉"板宽 88 比轮距略宽 ⚠"那条错误警告**；新增"灰度板可伸出底板，横向上限取 132 与规则限宽的较小者" |
| 框架定稿 | **§2.5** | ① 撤销"收腰 ±5/±15/±27.5/±40 + 捕获 ±52.5" → 改为**"均匀 10~12mm（首选 11mm）、横向 ≤88、纵深 20~25、捕获 ±44 够用"**，并把第 4.2 节那段逃逸算术写进去；② 前缘→轴 45mm 保留但**必须配"2mm 厚板 / 双面覆铜 / 前缘定高支撑"三条**；③ 本节整块标为**"备选：若改回自画"** |
| 框架定稿 | **§2.4 / §2.6** | 自画子板电路整块降级为**留档备选**（不删）；**新增一节"外购模块接口·安装·波长验证"**，内容 = 第 4.4 节 5 条硬指标 + 买回来仍要做的三件事 |
| 框架定稿 | **§5 待实测** | 新增两条：① **黑色喷绘布在 940nm 下的对比度**（见第 8 节，最高优先级）② **v_max 与弧上 PWM 余量**（差速比 1.76 → 外轮要 1.53m/s，"R200 能否全速"目前是未知） |
| 框架定稿 | **§8** | 加 v1.8 记录，把 v1.7 标注"尺寸口径已被实测推翻" |
| 引脚图 html | PA0~PA7 行 | 加"若模块为 5V 输出 → 每路 1k/2.2k 分压；宽压模块直入" |
| 引脚图 html | **11P 子板排针表** | 整节换成**外购模块接口（8DO + VCC + GND）**，并保留"5V 放最外端防错位"的思路 |
| 引脚图 html | 电源树 / danger box | **5V 轨照样要**（模块供电吃它）→ v1.7 的"降压模块必买 ≥400mA"**不撤**；关键尺寸行换真值 |
| 购物车 | #5 ITR9909×20 / #6 LM393×8 / #7 电位器×20 / #8 里的 180Ω·10k | 转"**若改回自画再买**"，别现在就退（还不确定） |
| 购物车 | 新增 | **外购 8 路模块 ×2（不同波长：940nm 红外 + 红/白光），48~70 元档，≈100~140**；总账重算 |
| 你的 PCB | — | 子板**停在这里不打样**（省钱就省在这一步）；主板**还没开始画**，先定模块再画排针那一块 |

**建议的下一手顺序**：量驱动轴位置 → 下单两块不同波长的模块 → **在赛道布上做波长交叉验证（第 8 节第 1 条）** → 依结论改 v1.8 → 画主板（含分压/接口）→ 写固件骨架。

---

## 8. ⚠⚠ 原军师犯过的错·黑名单（**接手人请先读这张表，别在同样位置再摔一次**）

| # | 我错过什么 | 教训 |
|---|---|---|
| 1 | **把"底板 88"当成"灰度板横向 ≤88"**，于是推出"零余量、板框要收到 86~87、90mm 宽成品装不上车、只能当标尺"。**四条全塌。** | **尺寸口径必须先问清"这块板是谁"。** 用户说"板长 88"时不要默认它在说灰度板。 |
| 2 | 拿**学长的 4.7V 模块当约束**去限制设计，被用户呛"这个只是个模块我想换就换了" | 现成件是**可替换变量**，不是边界条件。别替用户省他不想省的钱。 |
| 3 | 建议灰度**档距 12.5mm**，后来弧分析发现 **25/12.5 = 1:2 整数比**是最坏相位，自己改口 | 涉及周期性几何（线宽 vs 档距）时，**先算整数比**再给数。 |
| 4 | 说收腰量化台阶"**约 ±1mm**"，逐点算完实际是**中心 ±2~3mm、外区 ±4~6mm** | 别在没算完之前抛数字。 |
| 5 | 扫原理图整页时**误报"缺 4 只 100nF"**，实际 U13~U16 就是 | 看图先数一遍再下结论；被纠正要当场公开撤回（已撤回）。 |
| 6 | 用户自己提的 ±13/±25/±50/±70 里，**"中心间距 10mm"其实写成了 ±13 = 26mm**，且最密的 12mm 档落在 ±13~±25（**中心反而最宽，与他意图相反**） | 别人给的坐标**一定要画在数轴上排一遍间距**，不只看总宽。 |
| 7 | 旧文档"轮距 75~85、总长 ≤130"来源是**我按开源微缩车估的，不是实测**，一估就是三版 | 结构尺寸**只认卡尺**，估算值必须在文档里标"未实测"。 |
| 8 | 曾断言"IMU 默认 UART、需切 SPI" → **误判**，逐飞官方确认模块根本没有 UART | 外设接口类型**不可臆测**，必须查官方 README + 驱动源码宏定义。 |
| 9 | 曾主张"负压镜头纯跟踪那套 16 路排布"可参考 → 实际是**标准车规格**，抄到微缩车上直接装不下 | 开源包抄**算法判据**，别抄**机械尺寸**。 |

---

## 9. 等用户回的问题（阻塞项，按优先级）

1. **★那块赛道布到底是"黑色喷绘布"还是"黑绒布"？**（第 8 节之外**方案级最大的未知**）
   - **黑色喷绘布 = 白 PVC 基底 + 一层黑墨**。940nm 近红外**穿透力比可见光强**，墨层薄或不吸红外时，光穿过去打在白色基底上又反射回来 → **肉眼看着黑，在 ITR9909 眼里是灰白** → 整套"黑态节点 3.1V"的地基塌。
   - **黑绒布吸红外很好，安全。**
   - 独立情报支持这个担心：① 电赛 2024 H 题队伍原话"**红外传感器对于哑光布不一定能识别出来**，巡线必须用灰度（可见光）"；② 感为把同一块板做成**红外 / 红 / 绿 / 蓝四种波长分开卖**，并在手册里写明避开阳光。
   - **最便宜的消险法：48~70 元档买两块，一块 940nm 红外（同 ITR9909 波长）、一块红光或白光，放赛道布上推一遍看 8 颗 LED。** 今天下单、这周出结论；自画版要先等 3~5 天打样。
2. **驱动轴在底板 66mm 纵深的什么位置？** → 决定前瞻是 40~45mm 还是 25~30mm；**25mm 以下"提速靠前瞻"作废**，改靠陀螺前馈。
3. **买哪个方案**：48~70 元档两块做波长交叉验证（我的建议），还是直接上 109~153 元的感为当主传感器？
4. **校赛规则**：限宽 / 限长（前伸 45mm 会把总长推到 66+45+后悬 ≈ 120~130mm，要核）；**是否允许成品传感器模块**。
5. **模拟抽头要不要留**（老问题，从未回答）：主板排针要不要给"比较器之前的 AO"留位。走外购就自然作废，但主板仍要留一路空闲 ADC 给别的用途。

---

## 10. 接手人不该做的事

- **不要**擅自开工写固件、碰实车、下单、切板 —— 任何物理动作先说一声。
- **不要**在没给"改动清单"的情况下改多文件文档。
- **不要**把 test17 / A 车的结论串进来。
- **不要**删旧文档：`下单清单-今天就能拍板-20261002.md`（2000 元三合一板方案，费用部分已作废）与旧 `接线对照表.html`（入门车 TB6612+5 路）已加作废指引，留着当历史。
- **不要**相信任何没标"实测"的尺寸和电流。
- **不要**为了"沉没成本"继续画已经决定不画的板 —— 子板原理图的时间已经花了，那是沉没成本，不是继续打样的理由。
