xigua862/SMARTCAR2/开源整车情报-飞檐走壁致远探界-20261002.md

# 开源整车情报 · 21届飞檐走壁「致远探界」· 2026-10-02

> 你发的那张原理图 = **`ProPrj_21届智能车-飞檐走壁-致远探界整车工程_2026-10-02.epro2`** 里的
> **「飞檐走壁三合一 V3.0」板 · MCU 页**（标题栏：图页=MCU，原理图=Schematic18_1，日期 2026-08-31）。
> 这份工程的来头（工程自带说明原文）：**「21届智能车全国一等奖（第二名）-飞檐走壁-致远探界整车工程」，软硬件完整开源。**

---

## 1. 一句话

**这是一套已经拿国一、且完整开源的 100g 级「电磁循迹 + 负压吸附飞檐走壁」整车方案**——正好就是 B 车（微缩车）要做的东西。
它和 test16 里已有的 `100g-wall-climbing-mini-car/`、《STC32G 无感 FOC-mini 电调使用说明书.docx》、`minifoc改善死区可不接外部大电容.zip` 是**同一条技术路线**。

---

## 2. 工程指纹（脚本扒出来的，不是我猜的）

| 项 | 值 |
|---|---|
| 立创账号 | **ifdefine**（全部 13 个文档同一作者） |
| 编辑器版本 | 嘉立创EDA专业版 **4.1.60**（比疯狂电路那份的 3.2.135 新一个大版本） |
| 编辑时间 | 2026-08-16 23:57 → **2026-08-31 14:52** |
| 规模 | **4 个 BOARD / 4 个 PCB / 4 个 SCH / 8 张原理图页** · 72 器件 · 43 封装 · 489 元件 · 202 网络 · 图元 21402 个 |
| 复用模块 | `Channel ID / Reuse Block / Group ID` 各 **191** 处 → 大量**同构电路块复用**（4 路电感采样、多路驱动都是复制模块），改一处全同步 |
| 附件 | 说明里写了「附件一 车模底板 / 附件二 横向支撑件 / **附件三 国赛软件源码**」→ **源码要另外去开源广场页面下** |

---

## 3. 整车硬指标（他们文档原话）

| 项 | 值 | 对 B 车的意义 |
|---|---|---|
| 整车重量 | **108.15 g**（含电池） | 规则：**100g 内不罚时，超出每 20g 罚 1s** → 他们选择"超 8g 换性能"，说明**罚时比减重划算** |
| 尺寸 | **165 × 140 × 105 mm** | B 车结构的第一版参考框 |
| 物料成本 | **约 500 元** | 预算锚点 |
| 最快时速 | **约 3.8 m/s** | — |
| 控制周期 | **2 ms（TIM1 中断，500 Hz）** | A 车是 10ms → **快 5 倍** |
| PWM 频率 | **17 kHz** | 和 19 届那份 17000 一致（有刷电机静音/电流纹波） |
| 底盘 | 碳纤维 | 和 `Micro_car` 的碳板思路一致 |

---

## 4. 系统架构（★ 最关键的一条：双 MCU 异构）

```
3S 锂电 ─ SS54F 防反接 ─ TPS62933 同步降压 → 5V 母线
                                        ├─ RT9013 LDO → 3.3V（主控 + ICM42688）
                                        └─ LDO → VCCCOP（运放模拟电源，0Ω 单点分地）

【1 号 STC32G12K128】循迹主控
   4 路电感(电磁) → RS824XQ 四运放调理 → ADC → 差比和差解算 ERR
   ICM42688 六轴（Z 轴角速度做阻尼环）
   双路编码器（轮速）
   → 三环串级 PID → **DRV8701E + 分立 MOS 搭两个 H 桥 → 左右有刷电机**
   人机：按键 / 屏幕 / 蓝牙（在线调参、看数据）

【2 号 STC32G12K128】专职负压
   **EG2134 栅极驱动 + Q1~Q6 三相半桥 → 无刷负压风机**
   无霍尔：采 U/V/W 三相端电压做**反电势换向检测**
```

**算法**（他们原话）：位置外环 PD（ERR→转向量）+ **陀螺仪阻尼环 PD**（补侧摆）→ 合成左右轮差速设定 → 速度内环 PI 跟踪 → PWM 限幅 17kHz 输出；再加**赛道逻辑状态机**识别直道/弯道/环岛/十字/跷跷板。

---

## 5. 你发的这一页（MCU 页）逐块读

| 图上东西 | 是什么 | 备注 |
|---|---|---|
| **U1 `STC32G12K128-38I-LQFP64`** | 宏晶 STC32G12K128（8051 1T 内核，128KB Flash，64 脚） | 库里同时有 **-35I-LQFP48** 版本 → 二号负压板用的是 48 脚 |
| 引脚名 `PWM0P/PWM0L … PWM3P/PWM3L` | **4 对互补 PWM = 6~8 路半桥驱动** | 有刷 H 桥 + 无刷三相都靠它 |
| 引脚名 `COMPO / CMP0 / CMP1 / CMP2` | 片上**比较器**输出/输入 | 无感**反电势过零**就靠它（"换向检测"那一页） |
| `XTAL1/XTAL2` | 外部晶振 | 时钟源（FOC/2ms 周期靠它） |
| **左下「下载电路」`PZ127V-11-04-0720` 4P**：GND/TXD/RXD + VCC3V3 | **STC-ISP 串口下载座** | 板子上留了标准下载口，不用飞线 |
| `R6 10kΩ` 上拉 + `C46 100nF` + `SW1` 按键 → RST | **冷启动/复位下载键** | STC 系列下载必须能复位，这个设计照抄 |
| `L6 CBG100505U000T` 磁珠 + `C51 10µF` `C52 100nF` `C1 1µF` `C48 100nF` | 3V3 **磁珠隔离 + 逐脚去耦** | 模拟/数字电源分离的具体做法 |
| 中间 **4 个红色线圈符号** | **4 路电磁前瞻拾取线圈（电感）位** | 对应"四路电感采集赛道导线信号" |
| 引脚旁的彩色小数（`5.3` `0.4` `2.7` `7.2` …） | **跨图页的网络端口编号（页.序号）** | 说明这板还有 预驱 / 三相半桥 / 电源 / 采样 等页，别以为线断了 |
| 标题栏 | 板子=**飞檐走壁三合一V3.0 1**，图页=MCU | "三合一"=**主控+驱动+电源 三合一** |

**图上出现过的中文功能块名**（全工程，等于一张目录）：
`电源输入` `5V供电` `5V稳压` `信号输入` `预驱` `三相半桥` `左电机驱动电路` `右电机驱动电路` `换向检测` `运放模块` `运放3V3` `外设3V3` `电压检测` `姿态传感器` `编码器` `下载电路` `下载点` `按键` `屏幕` `蓝牙` `发车`

---

## 6. 关键器件清单（B 车采购直接对着这张表）

| 类别 | 型号 | 数量 | 干什么 |
|---|---|---|---|
| 主控 | **STC32G12K128-38I-LQFP64 / -35I-LQFP48** | 2 | 双 MCU 异构 |
| 有刷驱动 | **DRV8701ERGET** | 2 | H 桥栅极预驱（左右轮） |
| 无刷驱动 | **EG2134** | 1 | 半桥栅极驱动 → 负压三相全桥 |
| 功率管 | **TPN2R703NL**（TI，N+N 双管，2.7mΩ） | **8** | 主功率级 |
| 功率管 | **100N03DF**（30V/100A N-MOS） | 6 | 三相桥 Q1~Q6 |
| 姿态 | **ICM-42688-P** | 1 | 六轴（他们叫"陀螺仪"） |
| 模拟 | **RS824XQ** 四通道轨到轨运放 | 4 | 电感微弱信号调理放大 |
| 降压 | **TPS62933FDRLR** 同步降压 | 1 | 3S→5V |
| LDO | **RT9013-12GB**、**TPS7A2033** | — | 3.3V 主控 / VCCCOP 运放 |
| 防护 | **SS54F**（防反接）、**SMAJ16CA**（TVS）、1N5819W / B5819WS、FC-F1005 磁珠/PTC | — | 电源入口 |
| 磁性元件 | **NLCV32T-6R8M-EF** 6.8µH 功率电感、CBG100505U000T 磁珠 | — | 降压 + 去耦 |
| 大电容 | HY1C221M060120CD288(220µF/63V)、CGA0805X5R226M250MT、TAJA106K016RNJ(钽) | — | 母线储能（对应"死区可不接外部大电容"那条讨论） |
| 可调 | **3224W-1-104E**(100k 电位器) | 4 | 采样/阈值现场可调 |
| 接口 | PZ127V-11-04-0720(下载)、PZ254V-11-04P、HX PZ1.27-1X6P、ZX-PZ2.0-2-3P、**ZX-SH1.0-6P**、Header 2.54 1×8、TM-4175-B、TS-1101-C-W 按键、Test-Point | — | 全**线对板**，无悬空叠装 |
| 位号统计 | R118 · C108 · **U47** · D44 · H16 · Q12 · LED10 · L8 · **SCREW8** · SW6 · TP4 · P2 | — | 器件量级参考 |

---

## 7. 他们写在文档里的 4 条注意事项（直接进 B 车纪律）

1. **侧板切勿用铝制螺丝固定** → 容易断裂导致侧板报废；
2. 前瞻板用**尼龙螺丝**固定后**再点 502** 加强刚性；
3. 车顶 PCB 固定件可换**碳纤维**进一步加强度；
4. 负压膜：**裙边能接触的前提下，双面胶面积越大、空腔体积越大 → 吸附力越大**。

---

## 8. 对 B 车的结论（★ 这条改变 D1 的判断）

1. **主控路线基本可以定了：STC32G12K128**，不是我 D1 里列的 TC264 / C8T6。理由：① 这套是**国一第二、已验证**的方案，且**软硬件全开源**；② 它和 `Micro_car`（碳板+负压+030/8520）、`100g-wall-climbing-mini-car`（100g 超轻）本来就是一条线；③ 根目录那份《STC32G 无感 FOC-mini 电调使用说明书》+ `minifoc…zip` **正好就是它的软件侧资料**——三条证据互相咬合。
2. **B 车的 7 天排期可以大幅改写**：不用"从零画板"，改成**先把这份工程吃透 + 复刻它的电源树和驱动级**，把精力留给结构/负压/调参。
3. **待补的三块**：① 附件里的**国赛软件源码**（这份 epro2 里没有，要去立创开源广场页面下）；② 另外 **3 块 PCB 分别是什么板**（我只确认了「三合一板」的 MCU 页）；③ **微缩组/飞檐走壁组规则原文**（100g 罚时口径要自己核）。

---

## 9. 我用的工具（已存进仓库，下次直接跑）

```powershell
# 体检任意 .epro2（作者/时间/板页数/器件名/关键字）
pwsh -NoProfile -File 脚本\probe-epro2.ps1 -Epro2 "ProPrj_xxx.epro2"
# 挖图上的中文标注 + 位号统计 + BOM + 网络名（先跑上面那条，它会解出 main.epru）
pwsh -NoProfile -File 脚本\probe-epro2-bom.ps1 -Epru "<解出的 main.epru 路径>"
```
> 另：`.epro2` 里那个 **`project2.json`（约 9KB）是宝藏**——开源说明全文（设计概述、电路讲解、B站视频链接、注意事项）都在里面，比扒图快得多。
