xigua862/SMARTCAR2/文档/交接-固件bcar-20261015.md

# 交接：B 车固件 bcar · 2026-10-15（首次上板 + 阶段7 + ★发车流程落地）

> **本文件是"固件线"的最新唯一入口**，取代 `文档\交接-固件bcar-20261012.md`（那份仍可参考它的 §4 上板清单/§5 纪律/§6 坑表）。
> 项目上位入口仍是 `交接3-唯一入口-20261003.md`。老规矩：**落款日期不可信，只看修改时间**。

---

## 0. 一句话现状

**发车流程已写进固件、已烧进板子**（编译 0 error 0 warning、PC 单测 257 条全过）。烧完当场验过的：新固件横幅（三行发车流程说明）、`STATE = IDLE`、`KEY` 多了 `held=` 字段、`MODE TEST/IDLE` 切换、`GAIN`、心跳 1 秒一条不断、SWD 复核 `MAPR = 0x02000504`。**剩下的只有"要人耳朵和手"的那几条**：按键手感、蜂鸣 1/2/3 声、读秒后起步（§4 清单）。
**深夜补丁**：用户发现"按 PC13 车不动" —— **直行代码确实没写**（丢线 200ms 就刹死），已补**陀螺直行**（§2.5，commit `00a16ff`）：进 RUN 先按陀螺直行，看到线再交回循迹环。

上一轮（同一天早些时候）：5 个"一上板就现形"的 bug 修完 + 把阶段 7 控制环接上线。
本轮另外两件事：① 台上串口**实测到陀螺 Z 原始零偏 ≈ 0.4 dps**（航向 0.4°/s 漂，跑一圈约 16°），已把"读秒里自动标零偏"接进发车流程应对（§3.2）；② 查明串口那些怪现象**都在 DAPLink 的 VCP 上，不在固件**（§1 两条口径 + §2.4）。

---

## 1. 三分钟上手（照抄，不用回忆）

```bat
:: 编译（不开 Keil 界面）
cd C:\Users\asus\Desktop\test16\bcar\MDK-ARM
"D:\Keil_v5\UV4\UV4.exe" -b bcar.uvprojx -j0 -o build.log
:: 看结果（0 Error 0 Warning 才算过）
type build.log | findstr /C:"Error(s)"
:: 产物： bcar\MDK-ARM\bcar\bcar.hex

:: PC 单测（不需要板子、不需要 Keil）
cd C:\Users\asus\Desktop\test16\bcar
python Tools\run_pc_tests.py          :: 现在 257 条，全过
python Tools\fix_bom.py               :: 改完源码先跑这个（中文补 BOM）
```

**烧录（板子插 DAPLink，一根 USB 同时给 SWD + 串口）**
```bat
:: OpenOCD 路径：C:\Users\asus\AppData\Local\Programs\xpack-openocd-0.12.0-7
:: ⚠ DAPLink 的 CMSIS-DAP v2 时通时断 ⇒ 必须重试（1~2 次就过）
openocd -s <scripts> -f interface/cmsis-dap.cfg -f target/stm32f1x.cfg ^
        -c "transport select swd" -c "adapter speed 1000" ^
        -c "program <hex> verify reset exit"
```
- **串口 = COM17 / 115200**（DAPLink 的 VCP）。电脑能读能写 ⇒ 可用 pyserial 直接敲 CLI 做台上调参。
- **板子必须先上电**（不然 SWD 读到的是探针反灌的残电，寄存器值全是假的）。

**★串口三条实测口径（2026-10-15 现验，别再误判）**
1. **"敲了没立刻回" ≠ 固件死**：DAPLink 的 VCP 会把板上输出**攒几秒才成批吐给电脑**（同一句 `PING` 有时 60ms 回、有时要等几秒）。⇒ pyserial 要**连读 2~5 秒**再判；要判"收发都通"用 `LOOPBACK`（TX-RX 短接时）。
2. **链路会间歇性整段哑掉（两个方向都哑）**，几十秒到几分钟后自己恢复（实测复位目标、或拔插 USB 后恢复）。**这是 DAPLink VCP 的毛病**——上一轮记的"串口能发不能收悬案"就是它。判"到底是板子还是探针"的办法（§2.4）：SWD 读 `USART1->SR`（TXE=1 / RXNE=0）、`CR1=0x202C`（收发都使能）、RX 环形缓冲 head==tail、`s_tx_busy=0` —— 全绿就说明固件没病，问题在探针。
3. **长回包会丢"中间一段"**（不是丢头丢尾）：实测 `STATUS`（约 255 字节）被吃掉约 70 字节（表现为 `t = … ms, tick = 5` 后面直接接 `1=REV…`，MOTOR 那行没了）；`HELP`（约 1.2KB）丢得更多；而 **≤160 字节的回包、1 秒一条的 `hello`、每 100ms 一条的 `TLM` 行都完好无损**。⇒ 遇到长回包（`STATUS`/`HELP`）**重敲一次或分几段看**；调参用的短命令（`GAIN`/`PD`/`BASE`）不受影响。**LAP 行（约 140 字节）落在安全区**，但阶段 8/9 接调参器时，解析侧仍要按"行不合法就丢弃重收"写。

**常用命令**（`HELP` 全查）：`PING` · `STATUS` · `MAPR` · `MOTOR <FWD|REV|BRAKE|COAST> <0~1000>`（可 `MOTOR L|R ...`）· `ENC` · `ZERO` · `IMU` · `GYROZERO` · `HEAD` · `IR` · `IRBLACK`/`IRWHITE` · `IRPOS` · `TLM 0|1` · `LAP` · **`MODE <IDLE|TEST|COUNTDOWN|RUN|ESTOP>`** · `PD <kp×100> <kd×100>` · `BASE <mag>` · `GAIN` · `KEY`

---

## 2. 本次（10-15）干了什么

### 2.1 修掉 5 个"一上板就现形"的 bug（commit `cfe5f3f`）

| # | 位置 | 后果 | 根因 |
|---|---|---|---|
| 1 | `uart_dbg.c` `fmt_core` | 上电第一行就 **HardFault** | 不支持 `%08X`/`%4u`/`%02u` 宽度符 ⇒ 不消耗 va_arg ⇒ 后面参数全错位 ⇒ `%s` 把数字当指针 |
| 2 | `uart_dbg.c` 波特率 | 串口**全乱码** | 写成 `(pclk2*25)/(4*baud)`=3906；正确 `pclk2/baud`=625（实际跑成 18432 波特） |
| 3 | `main.c` | 敲 `IMU` **整机假死** | **`imu660_init()` 从没被调用** ⇒ SPI2 没使能 ⇒ 死在 `spi2_xfer` 等 RXNE（`heading_init()` 也漏了，死区没设） |
| 4 | `encoder.c` | **左编码器永不计数** | 置了 `AFIO_MAPR_TIM2_REMAP_1`（位[9:8]=10=**全重映射** PA0/PA1）；应为 `TIM2_REMAP_0`（01=部分重映射 PA15/PB3） |
| 5 | `stm32f1xx_it.c` | 配好 IMU 就**卡死在中断** | **`EXTI9_5_IRQHandler` 根本没写**，DRDY 中断没人接 → 掉进启动文件 `Default_Handler` 死循环（#3 修好后才暴露） |

**★定位手法（可复用）**：SWD 读 `xPSR`（异常号 3=HardFault、0=线程模式卡死）、`CFSR`/`HFSR`/`BFAR`，**MSP 处栈帧的第 7 个字 = 出错 PC**；再用 `MDK-ARM/bcar/bcar.map` 的符号表把地址映回函数名。

### 2.2 审查聊天频道 Agent 的阶段 7 改动（`1acd659` → 我补 `a61ad81`）

它加了 `src/control/{angle_pd,mixer,control}.c` + `Tools/test_control.c` + `PD/BASE/GAIN` 命令。设计合理（第一拍不做微分防 D 冲击/超量程按比例缩放保差速比/丢线先直行 200ms 再刹）。
**❌ 但 `control_enter_run()` / `control_exit_run()` 定义了却没人调用** ⇒ `s_running` 恒为 0 ⇒ 那个"闭环"是死的（按发车键车也不会动）。⇒ 我在 `main.c` 里按状态机边沿接上（进 RUN 接管、出 RUN 交还并刹车）。

### 2.3 ★本轮：发车流程落地（commit `2da800f`）—— 逐条对照你的需求

| 你要的 | 实现 | 在哪 |
|---|---|---|
| 上电 → 待机，**蜂鸣 1 声** | `fsm_set(FSM_IDLE)` + `buzzer_beep(120ms)`，串口打出发车流程三行 | `main.c` 初始化末段 |
| **PB0 = 测试开始键** → 测试模式，**蜂鸣 2 声**，之后等串口指令 | `key_take_press(KEY_TRIG)` → `FSM_TEST` + `buzzer_beeps(2, 80ms, 120ms)` | `main.c`、`buzzer.c` |
| **PC13 = 发车键**，**长按 200ms** 才触发，**短按不响应** | 新增长按/短按事件：`BCAR_KEY_LONG_MS = 200`；短按只在串口提示一句"要长按" | `key.c/.h` |
| 触发后**倒数 3 秒**，这 3 秒内**蜂鸣三声，短 2 声 + 长 1 声** | 新模块 `src/app/launch.c`（纯逻辑、PC 可单测）：t=0 短、t=1000 短、t=2000 长（600ms）、t=3000 起跑 | `launch.c/.h` |
| 然后**正式循迹** | 到点自动 `fsm_set(FSM_RUN)`，控制环在 RUN 边沿接管（即 2.2 接的那条线） | `main.c` |
| 发车位置 = 发车点（小蓝框 = `nav_map` s=0），**车头朝 S** | 进 RUN 那一刻把**编码器/位姿/航向清零**当锚点：之后 `odom.s` 就是"从发车点跑出多远"、航向 0 = 发车方向 | `main.c` RUN 边沿 |
| （我加的，可关）读秒里**自动标一次陀螺零偏** | 读秒 3 秒车本来是静止的，顺手采 1 秒静止样本标零偏；**车在动就不标**并说明 | `cmdline_gyrozero_auto_begin()`、开关 `BCAR_GYRO_AUTOCAL_ON_LAUNCH` |

**取消发车**：读秒中按 **PB0** = 取消（回测试模式，车不动）。
**台上不碰按键也能试读秒**：串口敲 `MODE COUNTDOWN` —— ⚠ **3 秒后它会真的进 RUN 起步**，先把轮子架空再做。

**还没做（你说停车代码最后做）**：过 S 触发"斑马线"判定、跑完一圈到 G 再触发 → 停车。发车流程已把**起点锚定**做好，S/G 判据来时直接用 `odom.s` 就行。
**⚠ 地图口径待定**：发车锚定用的是"发车点 = 里程原点、航向 0 = 发车方向"，**没有**把 odom 直接摆到 `nav_map` 的 (2772, 203)。等地图进固件时要做一次换算，里面有个符号坑必须先实测定死：**地图的 yaw 是"0°=+X、顺时针为正"（图是 Y 向下的图像坐标），而陀螺积分出来的 yaw 是逆时针为正** —— 两者差一个镜像，不实测就写死，只在赛道上现形。

### 2.4 顺手修 / 新发现（★都要台上复测）

| # | 位置 | 症状（有多坏） | 根因 | 状态 |
|---|---|---|---|---|
| 1 | `uart_dbg.c` 阻塞打印 | `printf`/`puts` 直接写 `DR`，与 TX DMA **抢同一个发送寄存器** —— 理论上能把正在 DMA 发的 TLM/LAP 行顶掉一个字符 | 两条发送路径没有互斥 | 已修：动手前等 DMA 收工（**有界 30ms**，等不到照旧发、绝不死等）。**注意：烧完实测"长回包丢中间一段"的现象与它无关**（是下面 #2），修它是为了消除这条理论上的坏路 |
| 2 | DAPLink VCP（**不是固件**） | 三种表现：① 回包延迟 0.5 秒~数秒、成批吐；② 链路会**整段哑掉**（两个方向都哑，几分钟后自己恢复）；③ **长回包丢中间一段**（`STATUS` 255B 丢约 70B、`HELP` 丢更多；≤160B 的回包与 1/s 的 hello/TLM 行完好） | 探针侧的 UART↔USB 转发（缓冲/攒批） | 已用 SWD 反证固件无病（`SR=0xD0` TXE=1/RXNE=0、`CR1=0x202C` 收发使能、RX 环 head==tail、`s_tx_busy=0`、`s_tx_drop=0`、PC 在 main 主循环里）。**对策：哑了就复位目标或拔插 USB；长回包重敲一次；调参短命令不受影响**（§1） |

### 2.5 ★补上"直行"（commit `00a16ff`，2026-10-15 深夜）

**用户当场发现的问题（原话）**："直行代码没有写，我就说开 PC13 不动" —— **他说的对**：RUN 里只有灰度循迹环，一旦看不到线就 200ms 后刹车 ⇒ **在桌面上（没有线）按 PC13 发车，车根本不动**；就算在赛道上，发车点没压准线也会发呆。

**现在 RUN 有两种模式**（`src/control/control.c`）：
| 情况 | 模式 | 干什么 |
|---|---|---|
| 看得到线 | **LINE**（循迹） | 灰度偏差走转向 PD（原来那套） |
| **进 RUN 的第一拍** | **STRAIGHT**（陀螺直行） | 按"发车方向"保持航向直着出去，**看到线立刻交回 LINE** |
| 看不到线（丢线/过斑马线断开） | **STRAIGHT** | **保持丢线那一刻的航向**直着走找线，速度 ×0.6；**2.5 秒还没找到才刹车**（安全兜底还在，只是从 200ms 放宽到 2.5s）|

新模块 `src/control/straight.c/.h`（纯逻辑、PC 可单测）。**符号口径**（写反了车会越偏越远）：`yaw` 逆时针为正、`steer>0` = 往右打 ⇒ `steer = kp×(yaw − 目标)`。**台上发现方向反了**：敲 **`SDIR 2`** 一眼翻过来（`SDIR 1` 翻回），不用回电脑重烧。
新命令：**`SGAIN <kp*100> <kd*100>`**（现场改直行增益，默认 1200/150 = 12.0/1.5）、**`SDIR <1|2>`**；`GAIN` 现在会打 `mode=LINE/STRAIGHT`、`lost=… ms`、`target=… deg` 和直行增益。
**台上验"直行"三步**：① 驱动轮架空 → ②长按 PC13 发车（或 `MODE RUN`）→ ③看两轮**同速正转**、用手把车头拧偏，轮子应**朝"回正"的方向差速**（车头偏左 → 左轮变快；方向反了就 `SDIR 2`）。桌面没线时它会直行 2.5 秒后停下——**这是正常的兜底**，不是故障。
**已验证（车静止、零位移）**：SWD 读 `s_str` = kp 12.0 / kd 1.5 / limit 600 / sign +1 / inited 0；`BASE 0` 后进 RUN，`GAIN` 报 `mode=STRAIGHT lost=2445ms holding=1` ⇒ 新模式在硬件上真的接管了。PC 单测 **270 条全过**（控制环 20→33，含符号/第一拍无 D 冲击/换目标清历史）。

### 2.6 ★灰度"读不对"查清了：模块是**反极性**，基准必须逐路教（2026-10-15 深夜，commit 见 §7）

**用户现象**：架起来时灰度全暗；赛道上"线处暗、黑处红"；车放线上不走；手动把线放到最左探头时左轮倒转。
**查下来的结论（都有实测数）**：
1. **这颗模块的输出是"越黑电压越高"**（跟"白高黑低"的直觉相反）：黑底布能把输出顶到 **5V 饱和（raw≈3750）**，白线只有 **raw≈30**，架在空中（有环境光）是中间值 **110~270**。
2. **黑底上 8 路差 10 倍**（实测 299 / 495 / 645 / 1278 / 2814 / 3755…），白线上 8 路基本一样（≈30）⇒ **必须逐路各有一对黑白基准**（固件本来就是逐路归一化，正好对得上）。
3. **之前"车不动/乱拐"的根因**：config 里是占位基准（黑=200/白=3000），方向正好反了 ⇒ 固件在**纯黑底上都算出 p=1.0、以为线在左边 2.1mm**，于是一直对着黑底当线跑。
4. **`IRBLACK` 教过一次但教废了**：当时探头排跨在白线上（8 路 3743/376/.../39 差 100 倍），教进去的"黑"是混的。**IRBLACK 必须整排 8 路都在纯黑区**（离线 ≥10cm）。
5. **⭐教白基准的诀窍**：白线只有 25mm 宽，正常摆位永远只压住 **2 路**（实测居中时只有 ch3/ch4）。**把车转 90°**，让白线顺着探头排的方向穿过 ⇒ **8 路同时压在线上**，一次 `IRWHITE` 教全 8 路。
6. **实测出的基准（已写死进 `bcar_config.h` 当上电默认值，烧完不用教）**：
   | | ch0 | ch1 | ch2 | ch3 | ch4 | ch5 | ch6 | ch7 |
   |---|---|---|---|---|---|---|---|---|
   | 黑 | 3755 | 495 | 645 | 299 | 474 | 2814 | 415 | 1278 |
   | 白 | 30 | 36 | 30 | 26 | 29 | 40 | 28 | 37 |
   验证：烧完复位后不教任何基准，8 路压线 → `sum_p=7.97 visible=1` ✅
7. **`BCAR_IR_PITCH_MM` 由 6.0 改成 12.5**：25mm 线宽正好盖住 2 路 ⇒ 线宽 ≈ 2 个间距。（**待卡尺确认**；原来是占位值，错一倍会让 err_mm 和转向力度都差一倍。）
8. **ch6 是弱路**（黑值 415、对比度仅 ~380 LSB，且黑值在 194~415 之间飘）—— 跑起来它可能抖，只能靠结构上让探头更贴地来改善。
9. 排查手法（这轮很有用）：**串口 IR 命令的长回包会被 DAPLink 吃掉一截** ⇒ 用 **SWD 直读 `s_raw`（0x20000114，8×uint16）**，不受串口影响；配合 `IRBLACK`/`IRWHITE` 打印的数值交叉核对。

**顺带回答"要不要换红外模块"**：不用换 —— 这颗本身就是红外反射式，现在证明它是好的（问题全在基准）。真坏了再说的两条路：① 换**同款**最省事（固件一行不改，重教一次基准）；② 换 8 路**数字输出**的寻迹模块要改固件（加适配层，偏差只能按"第几路"分档、精度掉、PD 要重调）。

### 2.7 ★"电机不转"查清了：不是电机，是**静摩擦太大 + 没有起步助推**（2026-10-15 深夜）

**排查链（都留了数）**：用户报"PC13 发车后轮子不动" →
① 固件侧先自证清白：发 `MOTOR FWD 300` 时 SWD 读 **TIM1：CCR1=CCR3=1080/3600（30%）、CCR4=0、BDTR=0x8000（MOE=1）、CCER=0x1111（四路输出使能）** ⇒ PWM 确实打出去了；
② 编码器也在数（手搬车时左编码器涨了 1092 个计数）；
③ **占空比扫频**（用编码器增量当判据，左电机）：
   - 40% 不动、60% 不动、**80% 狂转**、100% 狂转 ⇒ **起步门槛在 60%~80% 之间**
   - 满力踹 0.25 秒后**降到 30% 继续转**（−460738 计数）⇒ **维持门槛低，卡的只是起步那一下** = 典型静摩擦大（机械问题）
④ 结论：**固件没错、电机没坏**，是"从停到动"要一脚大的。

**解法（已实现并烧板验证）**：**起步助推 kickstart** —— 进 RUN（以及刹停后再起步）的头 `BCAR_CTRL_KICK_MS=150ms` 用 `BCAR_CTRL_KICK_MAG=800`，之后回 BASE（转向照常参与，不是"盲踹"）。实测 `MODE RUN` 0.45s ⇒ 左编码器 **−372042**（对比之前 350 压根不动）✅
**代价**：起步会多冲 5~10cm；机械弄顺后可以调小或关（改成 0 即关）。

**顺带修**：左编码器符号是反的（电机 FWD 时计数为负）⇒ `ENC_L_SIGN` 改 **−1**（只影响里程/遥测方向，不影响转向）。
**★右编码器从头到尾都是 0**（连手推都不涨）= **独立待查项**：查它的 A/B 线、插头、以及 TIM3 那路是否真在数（TIM3 重映射已在 MAPR 里验过，所以先怀疑线/编码器本体）。
**★机械上要用户自己定位的（我只给判据）**：逐个手转轮子比涩、看轮子有没有蹭框架/底板（找磨痕）、脱开齿轮分层（单独转轴 vs 单独转电机）、放地上轻推看能滑多远。常见根因：轴不平行（两侧框架孔不同心/框架扭）、轴承过盈夹轴、齿轮啮合过紧、轮子蹭底、四轮被齿轮连成一体互相较劲。

---

## 3. 硬件验证进度

### 3.1 ✅ 已验过（真机）

- 上电横幅 · **`MAPR = 0x02000504`**（SWJ=2 / US1R=1 / TIM2=01 / TIM3=01 全对）· `hello N` 序号连续
- **IMU 真实数据**：`A(2166,-4379,-16303)`（Z≈1g）、`reads` 涨、`HEAD` 有 yaw、`dead_zone=0.3` 生效
- **灰度链路通**：8 路 raw 随表面变化（架空全黑 100~300）
- `ENC` 可读 · `STATUS` 报 `MOTOR dir=2(BRAKE) mag=0` · `MODE RUN` → 控制环接管、丢线分支（直行 200ms → 刹车）行为正确
- **（本轮新固件烧完当场验，只用串口 + SWD）**：上电横幅打出新的三行发车流程说明 · `STATE = IDLE` · `KEY` 多出 `held=0 ms` 字段 · `MODE TEST`/`MODE IDLE` 来回切都回 `（电机已刹车）` · `GAIN`、`PING`、`HELLO 1` 正常 · **`hello` 每秒一条、序号连续**（t=1000→148000ms 无中断）· **`TLM 1` 的实时行：4 秒 40 条、字段全**（证明 TX DMA 那条路是通的）· **SWD 复核 `AFIO->MAPR = 0x02000504`**（TIM2/TIM3 部分重映射都在 ⇒ 左编码器那条修对了）、`s_tx_busy=0`、`s_tx_drop=0`
- **★顺手反了一个"看着像 bug 其实不是"的误判**：新固件横幅里 `MAPR = 0x02000004`（只有 SWJ+USART1），跟文档里记的 `0x02000504` 对不上 —— 因为 **`bsp_afio_init()` 只管关 JTAG 和串口重映射，TIM2/TIM3 的重映射是 `encoder_init()` 在横幅之后才置的**。判据：启动后敲 `MAPR` 或 SWD 读 `0x40010004`，应该是 `0x02000504`。**别为这个白查半小时。**

### 3.2 ★★本轮实测：陀螺零偏 0.4 dps ⇒ 航向 0.4°/s 漂（会静默毁掉惯导）

**测法**：板子放台上**不动**，串口隔 20 秒敲一次 `HEAD`，用返回的 `samples`（5ms 一拍）算真实经过时间。
**数据**：45.2 秒里 yaw 从 120.3° → 138.6° = **+18.3°** ⇒ **0.405°/s**；同时 `bias_z = 0.0`（说明这一上电周期没做过零偏标定，测到的是芯片原始零偏）。
**为什么致命**：跑一圈约 40 秒 ⇒ 航向漂 **≈16°**。惯导为主的设计靠航向推位置，这个量级直接让它瘫；而且**不报错、不抖动**，表现出来只是"怎么调都跑不直、拐弯全错"。
**已经做的应对**：发车读秒那 3 秒改成"标零偏的窗口"（车本来就刹着不动）；采集期间若车被碰/在转（极差 > 1.0 dps）就**放弃标定、沿用原零偏**并串口说明。开关 = `BCAR_GYRO_AUTOCAL_ON_LAUNCH`（改 0 = 只认手敲 `GYROZERO`）。
**★复核结果（2026-10-15 当晚，同一台班子上，串口验）**：`GYROZERO` 标出 **bias(x,y,z) = (-1.6, 0.7, **0.4**) dps** —— **Z 轴 0.4 dps 与实测漂移率 0.405°/s 完全吻合**，证明那个漂就是纯零偏。标完**静止 64.0 秒，yaw 60.7° → 60.7°，漂移 0.000 °/s**（目标 <0.05°/s）⇒ **零偏标定这条彻底通了，死区 0.3 dps 静止下够用**；发车读秒里跑的就是同一套代码（`cmdline_gyrozero_auto_begin()`），所以"读秒自动标定"也等于验过。
**还留两条（都不是第一次上赛道的阻塞项）**：① **热漂**：现在每次发车都重新标一次，所以"跑热了再发车"也会自动跟上，不必单独测；真要用惯导长距离推位置时再补冷/热对比。② **跑动中的陀螺噪声**：死区 0.3 dps 是按"静止"整定的，车在动时振动/噪声更大、会不会漏过死区积分，**等赛道跑完对比"发车瞬间 yaw"与"跑完一圈后 yaw"就知道**（跑直线上赛道后应基本回到 0°）。

### 3.3 ⏳ 还没验

- **要人耳朵/手的那几条**（§4 第 2~7 条）：按键手感、蜂鸣 1/2/3 声、短按不响应、读秒后起步、读秒取消
- **真赛道循迹**（控制环只在架空+无线状态下试过"丢线分支"）
- 电机四方向 / 转轮子看 `ENC` 涨不涨 / 三灯（要肉眼）
- 推车 1m 标定 `BCAR_MM_PER_COUNT`（现在 0.1 是占位值）
- 灰度黑白基准（现场 `IRBLACK`/`IRWHITE`）、探头间距 `IRPOS`
- `LAP` 遥测 · §2.4 那处串口互斥修复（长回包丢字节是 VCP 的毛病，与它无关）

**★四个占位值仍在 `Core/Inc/bcar_config.h`**：`BCAR_MM_PER_COUNT`(0.1)、`BCAR_IR_PITCH_MM`(6.0)、灰度黑白基准(200/3000)、`BCAR_MOTOR_DIR_FLIP`(0)。

---

## 4. 发车流程 · 台上验收清单（照这个验，一条一条打勾）

> 已由我烧完验过的用 ✅ 标出；**带 👂 的需要你在场听/按**。

1. ✅ 上电 → 串口三行发车流程说明 + 1 声蜂鸣 + 三灯亮一下；`STATUS` 里 `STATE = IDLE`（横幅与 hello 已验，蜂鸣声 👂）
2. 👂 敲 `KEY`，然后按住 PC13 再敲一次 → `held=` 跟着涨；**松手时**串口应打一句 `短按忽略`（发车键要长按）
3. 👂 **PB0 按一下** → **2 声**蜂鸣 + 串口 `[KEY] PB0 → 测试模式` + `STATE = TEST`
4. 👂 **PC13 短按** → 只有串口一句 `短按忽略`，**不该有蜂鸣、不该进 RUN**（这是"短按不响应"的判据）
5. 👂 **PC13 长按 ≥0.2 秒** → 串口 `[LAUNCH] 开始读秒` + `[GYRO] 读秒期间自动标零偏`
   - 约 1 秒后应出现 `[GYRO] 自动标定完成，零偏 z=…`（车别动）
   - 3 秒内应听到 **短 短 长** 三声
   - 到点 → `[LAUNCH] 读秒结束 → RUN` + `[CTRL] 进入 RUN`，**车开始走**
6. 👂 读秒里按 PB0 → `[LAUNCH] 读秒被取消`，车不动
7. 👂 试 `MODE COUNTDOWN`（轮子架空）→ 与第 5 条同样的读秒 + 自动标定，到点进 RUN

**★做第 5、7 条之前先决定车放哪**：读完秒它会真的起步。第一次试建议**把驱动轮架空**（只听声看串口）；要上赛道就直接按正式流程来。

> **验收状态（2026-10-15 晚）**：用户当场做完，回"**全部正常**"。发车流程这条线结案 ✅ —— 下一步进 §5 第 2 条（上赛道）与第 3 条（四个占位值实测）。

---

## 5. 下一步待办（按优先级）

1. ✅ **烧新固件 + 过 §4 验收清单** —— 2026-10-15 晚完成，用户回"全部正常"
2. **真赛道第一次跑**：先把 `BASE` 降到 250 试方向（`PD`/`BASE`/`GAIN` 现场可调；现在 kp=25/kd=3/BASE=350）—— **前提是先把下面第 3 条里的灰度黑白基准量出来**，否则 `err_mm` 是拿错基准算的
3. **四个占位值实测**（测完抄给我，我改 `Core/Inc/bcar_config.h` 重新编译，你再烧一次）：
   - `BCAR_MM_PER_COUNT`：`ZERO` → 推车正好 1.00 m → `ENC`，看 total 涨了多少计数 ⇒ `1000/total`
   - 灰度黑白基准：车放**黑底喷绘布**上敲 `IRBLACK`、探头压**白线**上敲 `IRWHITE`（两条命令会打印 8 个值，抄下来）⚠ 这两个数只存在 RAM，掉电就没；量准了直接写进 config 当默认值
   - `BCAR_IR_PITCH_MM`：卡尺量相邻两探头中心距（现在占位 6.0mm）
   - `BCAR_MOTOR_DIR_FLIP`：驱动轮架空 → `MOTOR FWD 300` → 看两轮是否都朝前转（都反了就改 1）
4. ✅ **陀螺复核** —— 2026-10-15 晚完成，标定后 64 秒零漂（§3.2）
5. **S/G 斑马线判据 + 停车**（你说最后做；发车锚定已就位，地图换算的符号坑见 §2.3）
6. 之后才是阶段 8/9（Flash 参数表 + 遥测 + 接调参器：`SET/GET/RUN` + 每圈 `LAP` 行）

---

## 6. 纪律与坑（继承，别丢）

1. **新源码只放 `bcar\src\{bsp,drivers,middleware,app,control}`**，不许放工程根（Windows 大小写，`drivers\` 会和 CubeMX 的 `Drivers\` 撞目录被删）。
2. `middleware\` 与 `app/launch.c`、`app/str_util.c` **不许 include 任何 stm32/HAL/驱动头**（要在 PC 上单测）。
3. 改完源码先 `python Tools\fix_bom.py`；CubeMX 重新生成后跑 `python Tools\patch_uvprojx.py`（新增的 .c 会被自动挂回工程）。
4. **两道关**：Keil 0 error 0 warning + `run_pc_tests.py` 全过。
5. 不许加回 `MX_USART1_UART_Init()`（会占掉电机 PWM 的 PA9/PA10）。
6. 只碰 test16（B 车）；**test17 是 A 车**，任何文件都不许引用。
7. **物理动作（烧录/通电/让车跑）前先跟用户说一声**；车要看住。
8. **`MODE COUNTDOWN` 会真的起步**（3 秒后进 RUN）—— 台上试它时先把轮子架空。
9. **串口别急着判死**（DAPLink VCP：攒批 / 整段哑 / 长回包丢中间一段，判据见 §1 与 §2.4）；**别在 RUN 里按 PB0 当"暂停"用**（它是回测试模式 + 刹车，会打断本圈）。
10. **不标陀螺零偏就发车 = 白跑一圈**（§3.2）。现在读秒里自动标，但**发车前那 3 秒别碰车**。
11. **横幅里的 `MAPR = 0x02000004` 是正常的**（那时 `encoder_init()` 还没跑）；要看全的用 `MAPR` 命令或 SWD 读 `0x40010004`，应是 `0x02000504`。
12. **查"卡住没反应"的两板斧**（本轮现学现用）：① SWD `halt` 后读 `pc`/`xpsr`（xpsr 低 9 位=0 是线程模式、3 是 HardFault），再用 `MDK-ARM/bcar/bcar.map` 把地址映回函数；② 读关键全局量（`s_tx_busy`、RX 环 head/tail、`s_fsm_prev`）判断固件到底停在哪种状态。**这套比在串口边上瞎猜快得多。**

---

## 7. git（均在 `xigua862/SMARTCAR2` main）

```
00a16ff  fw(B-che): implement the missing straight-line driving (gyro heading hold)   ← 深夜补丁：直行
3771f20  docs(B-che): record the straight-line patch（§2.5）
98961ac  docs(B-che): launch flow accepted on the bench; gyro zero-bias calibration verified
33ce6df  docs(B-che): flashed the launch-flow build and verified it; serial oddities are all VCP
2da800f  fw(B-che): key/launch flow per the 2026-10-15 spec + gyro bias auto-zero during the countdown
d585afb  docs(B-che): handover for the firmware line (2026-10-15)
a61ad81  fix(bcar): wire the stage7 controller to the FSM (it was dead code)
1acd659  fw(B-che): stage7-lite closed loop（聊天频道 Agent 写的）
cfe5f3f  fix(bcar): 5 on-board bring-up bugs found by first real hardware run
```

---

*本文件由 2026-10-15 会话产出并当日续更（发车流程落地），作为固件线唯一入口。*
