xigua862/SMARTCAR2/文档/交接-固件bcar-20261012.md

> ⚠ **2026-10-15 已被 `文档\交接-固件bcar-20261015.md` 取代** —— 那份是固件线的最新入口（含首次上板结果、5 个 bring-up bug、按键/发车流程需求）。
> 本文的 **§4 上板验证清单 / §5 五条硬纪律 / §6 已踩坑表 / §8 占位值** 仍然有效、值得查；但"阶段 0~6 代码完成、硬件判据未验"这句话已经过时。

---

# 交接：B 车固件 bcar · 2026-10-12

> **本文件是"固件线"的唯一入口。** 项目上位入口仍是 `交接3-唯一入口-20261003.md`。
> 老规矩：**落款日期不可信，只看修改时间**。
> 前身：`文档\状态-固件bcar-20261012.md`（已被本文件取代，仅留作过程记录）。
> 依据：`文档\讨论-固件框架-20261012.md`（框架提案）+ `文档\开场提示词-军师-固件框架-20261012.md`。

---

## 0. 一句话现状（先看这个）

**阶段 0~6 全部写完，编译 0 error 0 warning（Code=18.7KB / RAM 2.8KB），PC 单测 196 条全过，`bcar.hex` 已生成。**
**硬件判据一条都还没验 —— 必须有人守在板子边上才能过。** 这是当前唯一的卡点。

| 阶段 | 内容 | 软件判据 | 硬件判据 |
|---|---|---|---|
| 0 | 工程/编译/hex/不撞 A 车名 | ✅ | ⏳ SWD 识别 + 烧进去能跑 |
| 1 | 三色灯 / 串口 / 蜂鸣器 / 两个按键 | ✅ | ⏳ 全待验 |
| 2 | 电机 PWM（TIM1 20kHz + MOE）| ✅ | ⏳ 四方向动作待验 |
| 3 | 编码器（TIM2/TIM3 正交）+ 里程位姿 | ✅ | ⏳ 推车标定待做 |
| 4 | IMU660RC（SPI2 + DRDY）+ 陀螺航向 | ✅ | ⏳ WHO_AM_I / 零偏待验 |
| 5 | 8 路灰度（ADC+DMA）+ 归一化质心 | ✅ | ⏳ 黑白标定待做 |
| 6 | 遥测（TX DMA + P² 分位 + 单圈指标）| ✅ | ⏳ LAP 行待看 |

---

## 1. 三分钟上手（照抄即可）

```bat
:: 编译（不用开 Keil 界面）
cd C:\Users\asus\Desktop\test16\bcar\MDK-ARM
"D:\Keil_v5\UV4\UV4.exe" -b bcar.uvprojx -j0 -o build.log
:: 看结果
type build.log | findstr /C:"Error(s)"
:: 产物
::   bcar\MDK-ARM\bcar\bcar.hex

:: 跑全部 PC 单测（不需要板子、不需要 Keil）
cd C:\Users\asus\Desktop\test16\bcar
python Tools\run_pc_tests.py
```

- **烧录**：Keil 打开 `bcar.uvprojx` → Download（DAPLink）。本板**无 ISP，只能 SWD**。
- **板上 6P PH2.0 下载/串口座**：`1=VCC 2=SWDIO 3=SWCLK 4=GND 5=PB7(RX) 6=PB6(TX)`
- **串口**：115200 8N1（中文按 UTF-8 显示）

---

## 2. 代码地图

```
bcar/
├─ Core/Inc/bcar_config.h   ★所有编译期开关（版本/节拍/波特率/LED 极性/电机方向翻转/
│                              探头间距/丢线阈值/待标定量），改行为先改这里
├─ Core/Src/main.c             只有初始化顺序 + 主循环骨架，业务都在 src/
├─ Core/Src/stm32f1xx_it.c     SysTick（1ms→累 5ms 拍）、USART1 RX、EXTI9_5(DRDY)、
│                              DMA1_CH1(灰度)、DMA1_CH4(串口 TX) —— 只搬数据不做业务
├─ src/bsp/      bsp_afio（禁 JTAG 保 SWD + USART1/TIM2/TIM3 重映射）
│                bsp_gpio（运行期改脚）、bsp_systick（5ms 拍 + DWT 微秒）
├─ src/drivers/  led / uart_dbg / buzzer / key / motor / encoder / imu660 / adc_ir
├─ src/middleware/  ← ★纯逻辑，可在 PC 单测，禁止 include 任何硬件头
│                odom（里程位姿）/ heading（陀螺航向+零偏+死区）/
│                line_pos（灰度归一化+质心）/ p2quant（P² 分位）/ lapstat（单圈指标）
├─ src/app/      fsm（5 态最小版）/ cmdline（命令解析+现场标定）/ str_util（纯解析）/
│                telemetry（每圈结算 + 实时行，走 TX DMA）
└─ Tools/        patch_uvprojx.py（门 3）/ fix_bom.py（门 2）/
                 run_pc_tests.py（跑全部单测）/ test_*.c（单测）
```

**分层依赖严格单向**：`app → middleware → drivers → bsp/HAL`。
`middleware` 不许 include `drivers/`；`drivers` 不许 include `middleware/` 或 `app/`。

---

## 3. 串口命令表（17 条，`HELP` 随时可查）

| 命令 | 作用 |
|---|---|
| `HELP` / `?` | 命令列表 |
| `PING` | 应答 `PONG`（测链路）|
| `STATUS` | 状态/节拍/电机/按键/蜂鸣器/MAPR |
| `MAPR` | 打印 `AFIO->MAPR`（查重映射是否生效）|
| `HELLO 0\|1` | 每秒心跳开关（调参时关掉免得刷屏）|
| `BEEP [ms]` | 蜂鸣 |
| `MODE <IDLE\|TEST\|RUN\|ESTOP>` | 切模式（切换时强制刹车）|
| `MOTOR <FWD\|REV\|BRAKE\|COAST> <0~1000>` | 两侧同设（**RUN 下禁 COAST**）|
| `MOTOR L\|R <dir> <mag>` | 只设一侧 |
| `KEY` | 读两个按键电平 |
| `LOOPBACK [ms]` | TX-RX 短接时的回环自检 |
| `ENC` | 编码器累计/增量（**标定就看这行**）|
| `ODOM` | 里程位姿 x/y/yaw/s/v |
| `ZERO` | 编码器与位姿清零 |
| `IMU` | 陀螺/加速度原始值 + dps（查 SPI 接线）|
| `GYROZERO` | 陀螺零偏标定（**车必须静止约 1 秒**）|
| `HEAD` | 航向 / 零偏 / 死区 |
| `IR` | 8 路原始值 + 归一化值 + `err/sum_p/visible` |
| `IRBLACK` / `IRWHITE` | 把当前读数教成"全黑"/"白线"基准 |
| `IRPOS <间距mm*100>` | 改探头间距（`IRPOS 600` = 6.00mm）|
| `TLM <0\|1>` | 实时行开关（每 100ms 一行，走 DMA）|
| `LAP` | 结算当前圈并发一行 LAP，自动进下一圈 |
| `LAPSTART` | 丢弃累积、重开一圈 |

---

## 4. 上板验证清单（按顺序做，全绿才算过阶段）

**准备**：接 DAPLink、串口助手开 115200 8N1、**车放在地上别让它跑**（电机还没接闭环）。

**阶段 0/1**
- ☐ 下载成功（Keil 报 `Download Verified OK`）
- ☐ 三色灯 500ms 走马（PC14→PC15→PA12→全灭→循环）
- ☐ 上电横幅打印出来，其中 `MAPR = 0x…` 里 **`SWJ=2`、`US1R=1`**
- ☐ 每秒一行 `hello N`，**盯 60 秒序号不跳号**
- ☐ 上电时蜂鸣器响一声（PB10 通路）
- ☐ 按 PC13 / PB0，串口各打一行 `[KEY] …`

**阶段 2（电机，⚠ 轮子悬空或车顶着墙再做）**
- ☐ `MODE TEST` → `MOTOR FWD 500` → **两个轮子朝同一个方向转**
  - 反了就把 `bcar_config.h` 的 `BCAR_MOTOR_DIR_FLIP` 改成 1（两只一起翻，别改线）
- ☐ `MOTOR REV 500` 反向；`MOTOR BRAKE 0` 两轮硬锁（手拧不动）
- ☐ `MOTOR COAST 0` 两轮自由（手能拧）
- ☐ `MOTOR FWD 40` **不转**（占空比低于消隐 4.4%，这是正常的，不是坏了）
- ☐ 跑 30 秒 mag=800 摸 AT8236 不烫手

**阶段 3（编码器）**
- ☐ `ZERO` 清零 → **推车走 1 米** → `ENC` 看 `total` 涨了多少 → **把这个数报出来**，
      我算 `BCAR_MM_PER_COUNT`（现在 `0.1` 是占位值）
- ☐ 反向推，`total` 应该往负走

**阶段 4（IMU）**
- ☐ 上电横幅有 `IMU660RC OK (WHO_AM_I=0x70)`；如果没有 → 查 SPI 接线/CS
- ☐ `IMU` 反复看：静止时 raw 在 0 附近小幅抖；`reads` 在涨
- ☐ `GYROZERO`（车别动）→ 打完三轴零偏
- ☐ 把车**原地转 90°** → `HEAD` 的 yaw 应该接近 90（差太多说明量程系数/方向不对）

**阶段 5（灰度）**
- ☐ 车放**黑底**上 `IRBLACK`，放**白线**上 `IRWHITE`（8 个数抄进 `bcar_config.h`）
- ☐ 把车骑在线上左右平移，`IR` 里的 `err_mm` 应跟着变、符号对得上
- ☐ 车整个抬离地面（全黑）→ `visible=0`
- ☐ 量一下**相邻两个探头的中心距** → `IRPOS <间距×100>`

**阶段 6（遥测）**
- ☐ `TLM 1` → 手推车，每 100ms 一行 `TLM … err/vis/v/yaw/lost`
- ☐ `LAP` → 打一行 `LAP 1 t=… s=… vavg=… errP95=… lost=…`

---

## 5. ★五条硬纪律（接手必看，全是踩出来的）

1. **新源码一律放 `bcar\src\`**（`src/bsp` / `src/drivers` / `src/middleware` / `src/app`）。
   *为什么*：Windows 不区分大小写，工程根目录的 `drivers/` 会和 CubeMX 的 `Drivers/`（HAL 库）
   **撞成同一个目录**，CubeMX 重新生成时 `DeletePrevious=true` 会把我们写的驱动一起删掉。
2. **改完源码先跑 `python Tools\fix_bom.py`**。
   *为什么*：中文 Windows 下 ARMCC 按 GBK 解析，UTF-8 源码里的中文会被判非法（`#870-D`），
   一堆 warning 会破坏"0 warning"判据。加 BOM 后正常（二进制里仍是 UTF-8，串口显示中文没问题）。
3. **CubeMX 重新生成工程后跑 `python Tools\patch_uvprojx.py`**。
   *为什么*：CubeMX 只列它自己生成的文件，我们 `src/` 下的会被挤出 Keil 工程。
   脚本幂等（先删旧组再按磁盘重建），跑几次都行。
4. **外设初始化手写在驱动里**（USART1 / TIM1 / TIM2 / TIM3 / ADC1 都是），不走 CubeMX 生成。
   *为什么*：重映射、MOE、编码器 4 倍频这些 CubeMX 命令行搞不定（实测 `IP not ready`）；
   手写还有个好处：意图在明面上，重新生成工程也不会被改回去。
5. **`middleware/` 不许 include 任何 stm32/HAL/驱动头文件**。
   *为什么*：这样才能在电脑上用 gcc 直接编译单测。要加可测算法 → 放 `middleware/`
   并在 `Tools\run_pc_tests.py` 里注册一行。

---

## 6. ★已经踩过的坑（别再踩回去）

| 坑 | 现象 | 现状 |
|---|---|---|
| `MX_USART1_UART_Init()` | 把 **PA9/PA10 配成串口**，而那两块脚是**电机 PWM** | **已删除调用并删掉 usart.c/usart.h**。别再加回来（main.c 里有注释警告）|
| 中文源码没 BOM | ARMCC 报一堆 `#870-D` | `Tools\fix_bom.py` |
| `drivers/` vs `Drivers/` | 驱动混进 HAL、被 CubeMX 删掉 | 统一放 `src/` |
| CubeMX 不肯生成 USART1 重映射 | `IP not ready` | USART1 手写（含重映射）|
| PA15/PB3/PB4 是 JTAG 脚 | 编码器计数永远是 0 | `bsp_afio_init()` 先禁 JTAG（初始化顺序里已保证）|
| TIM1 忘开 `MOE` | 程序在跑、电机不转，能白耗半天 | `motor_init()` 会读回 BDTR 自检并打印 |
| AT8236 输入 `00` | 滑行，**1ms 后进休眠** | 只允许 TEST/IDLE 模式用（`fsm_coast_allowed()` 拦着）|
| AT8236 消隐 2.2µs | 占空比 <4.4%（20kHz）电机不转 | `mag` 下限设 50/1000，低于就当 0 |
| 串口发长串挡控制环 | 一条 LAP 行 100 字节阻塞发 = 9ms = 两个控制拍 | 遥测走 `uart_dbg_write_dma()` |

---

## 7. 下一步（阶段 7~9）

- **阶段 7 控制环**（下一个该干的）：
  `src/control/` 下建 `angle_pd.c`（转向 PD，吃 `line_pos.err_mm`）→
  `mixer.c`（差速混合：`u_speed ± u_steer` → 左右轮）→
  `speed_pid.c`（增量式 PID，吃编码器速度）→ `slowsafe.c`（弯道减速 `v=√(a·R)`）。
  建议：先在 PC 上拿仿真轨迹跑通收敛再上板，别直接实车瞎试参数。
- **阶段 8/9**：Flash 参数表（末页 1KB 乒乓双备份 + CRC32）+ 串口 `SET/GET` 读写 →
  这样调参不用重烧固件。**等控制环定了参数名单再做更省事。**
- **还缺的中间件**：`finish.c`（斑马线终点 + LAP 触发）、`ring.c`（圆环 5 态）、`cross.c`（十字识别）。
  现在 `LAP` 是**手动**打的；自动判圈要等 `finish.c`。
- **E-STOP**：`app/estop.c`（EXTI 直断 MOE + 蜂鸣 + LED）还没写。

---

## 8. ★代码里 4 个占位值（必须实测后改）

| 常量（在 `Core/Inc/bcar_config.h`） | 现值 | 怎么得到真值 |
|---|---|---|
| `BCAR_MM_PER_COUNT` | `0.1f` | `ZERO` 后推车 1 米 → `ENC` 的 total → `1000/total` |
| `BCAR_IR_PITCH_MM` | `6.0f` | 卡尺量相邻两探头中心距（或用 `IRPOS` 现场试）|
| 灰度黑白基准 | `black=200 / white=3000` | 现场 `IRBLACK` / `IRWHITE`，把 8 组数抄回来 |
| `BCAR_MOTOR_DIR_FLIP` | `0` | 如果 `MOTOR FWD` 反而倒着走 → 改 `1` |

⚠ 编码器是**齿轮驱动**（不是装轮轴），老的 `mm/count = πD/4096` **不成立** —— 只能推车标定。

---

## 9. 几个关键设计决定（为什么这么做）

1. **5ms 主循环 + SysTick 置标志**：ISR 里只 `tick++` 和搬字节，业务全在主循环。
   避免 ISR 里跑算法导致时长失控（框架 §3.2）。
2. **惯导为主 + 光电为辅**：航向用陀螺积分（**先减零偏、再过死区**），
   拿不到 DRDY 就退回"差速推算"——IMU 挂了车还能勉强跑，不会直接瘫。
3. **丢线拍不计入偏差统计**：丢线时 `err` 恒为 0，混进来会把指标做漂亮，
   而丢线恰恰是最危险的时候。这条专门写了单测卡住。
4. **用 P95 而不是 max 当收敛判据**：max 被单次反光/震动拉爆，调参器会一直追噪声；
   P95 才是"常态最坏情况"。
5. **遥测走 TX DMA**：见坑清单最后一条。
6. **灰度每路各自归一化**：8 个探头一致性差（发射管亮度/贴纸高度/反光都不同），
   用统一阈值必然有的永远亮、有的永远灭。
7. **`err_mm` 直接给毫米**：转向环拿它就能用，不用再标一层系数。

---

## 10. 给接手 AI 的开场提示词（直接复制）

```
你是 B 车固件 bcar 的接手工。工程在 C:\Users\asus\Desktop\test16\bcar。

先按顺序读这三份，别跳：
1. 文档\交接-固件bcar-20261012.md          ← 固件线唯一入口（先读第 0、5、6、8 节）
2. 文档\讨论-固件框架-20261012.md          ← 框架提案（分层/接口/阶段划分的由来）
3. 交接3-唯一入口-20261003.md              ← 项目上位入口 + 文档状态表

硬约束（违反会返工）：
- 新源码只能放 bcar\src\{bsp,drivers,middleware,app}，不许放工程根目录（Windows 大小写
  会和 CubeMX 的 Drivers\ 撞目录，被重新生成时删掉）
- middleware\ 里的文件不许 include 任何 stm32/HAL/驱动头文件（要在电脑上单测）
- 改完源码先 python Tools\fix_bom.py；CubeMX 重新生成后 python Tools\patch_uvprojx.py
- 每次改完必须过两道关：① Keil 编译 0 error 0 warning ② python Tools\run_pc_tests.py 全过
- 不许加回 MX_USART1_UART_Init()（它会占掉电机 PWM 的 PA9/PA10）
- 只碰 test16（B 车），test17 是 A 车，任何文件都不许引用

当前进度：阶段 0~6 代码完成，硬件判据未验。下一步做阶段 7 控制环（见交接文档 §7）。
先给我"你读到了什么 + 打算怎么动"，我点头再改代码。
```

---

## 11. git（均在 `xigua862/SMARTCAR2` main）

```
596c0f9 阶段0+1 骨架        cae7eeb 阶段1+2 电机PWM+命令+解析单测
8e89113 阶段3 编码器+里程    ec5afae 阶段4 IMU+惯导
d9c4da3 阶段5 灰度ADC+质心   09e7565 阶段6 遥测（TX DMA+P²+单圈指标）
ca17ee4 状态文档            + 本次：删除 usart.c 死代码 + 本交接文档
```

**建议你点头的一处改动**（我没擅自改正式文档）：
`交接3-唯一入口-20261003.md` 的文档状态表里加一行——

```
| 文档\交接-固件bcar-20261012.md | **固件线唯一入口**：bcar 固件现状/上手/纪律/验收清单 |
```
你说声"加"，我就把这一行并进去。
