xigua862/SMARTCAR2/文档/状态-固件bcar-20261012.md

> ⚠ **本文件已被 `文档\交接-固件bcar-20261012.md` 取代**—— 那份是固件线的唯一入口，含上手步骤/纪律/验收清单。本文件仅留作过程记录。

# 状态：B 车固件 bcar（阶段 0 ✅ / 阶段 1~6 代码就位，全部等上电验证）

> 建立 2026-10-12 夜，**2026-10-12 深夜更新**（ZCode 代工，用户上课远控）
> 依据：`文档\讨论-固件框架-20261012.md`（框架提案）
> 工程：`test16\bcar\`　Keil：`MDK-ARM\bcar.uvprojx`　产物：`bcar.hex`

---

## 一、一句话现状

**从零写到"六路传感全通 + 每圈出指标"**：编译 **0 error 0 warning**（Code≈19KB、RAM 2.9KB）、**PC 单测 196 条全过**（解析 78 + 里程 22 + 航向 17 + 灰度 27 + P²分位 18 + 单圈统计 34）、`bcar.hex` 已生成。
**剩下的全是硬件判据**（SWD、烧录、灯/串口/蜂鸣器/按键/电机/编码器实测），必须你在板子边上才能过。

---

## 二、判据进度

| 阶段 | 判据 | 状态 |
|---|---|---|
| 0 | 编译 0/0、hex 生成、**不叫 test16.hex** | ✅ |
| 0 | DAPLink 识别 SWD / 烧进去能跑 | ⏳ 需你在场 |
| 1 | 三色灯走马、串口 `hello N` 连续、MAPR 自证 | ⏳ 需你在场（代码就位）|
| 1 | 蜂鸣器短鸣、两个按键触发 | ⏳ 需你在场（驱动已写）|
| 2 | `MOTOR FWD/REV/BRAKE/COAST` 四种动作 | ⏳ 需你在场（驱动+命令已写）|
| 3 | 编码器读数、推车 1m 标定 mm/count | ⏳ 需你在场（驱动+命令已写）|
| 4 | IMU 能读到 0x70、`IMU` 命令出数、GYROZERO 标定 | ⏳ 需你在场（驱动+命令已写）|
| 5 | 8 路灰度出数、IRBLACK/IRWHITE 教黑白、`IR` 看偏差 | ⏳ 需你在场（驱动+命令已写）|
| 6 | 遥测：`TLM 1` 手推车看实时行；`LAP` 结算一行 | ⏳ 需你在场（代码就位）|
| — | 命令解析正确性 | ✅ **78/78**（`Tools\test_parse.c`）|
| — | 里程/位姿解算（含走直角） | ✅ **22/22**（`Tools\test_odom.c`）|
| — | 陀螺零偏标定 + 死区 + 积分不漂 | ✅ **17/17**（`Tools\test_heading.c`）|
| — | 灰度归一化+质心（钳位/丢线/反极性/各自标定） | ✅ **27/27**（`Tools\test_line_pos.c`）|
| — | P² 分位估计（与排序真值对比） | ✅ **18/18**（`Tools\test_p2quant.c`）|
| — | 单圈指标（含"丢线不拉低偏差"） | ✅ **34/34**（`Tools\test_lapstat.c`）|

---

## 三、代码清单

```
bcar/
├─ Core/Inc/bcar_config.h      ← 全局开关（版本/节拍/波特率/LED 极性/电机方向/★mm_per_count 待标定）
├─ Core/Src/main.c             ← 初始化顺序 + 主循环（5ms 拍：按键消抖 + 编码器→里程）
├─ Core/Src/stm32f1xx_it.c     ← SysTick 累加 5ms；USART1_IRQHandler 只搬字节
├─ src/bsp/        bsp_afio（关 JTAG/重映射）/ bsp_gpio / bsp_systick
├─ src/drivers/    led / uart_dbg / buzzer / key / motor / encoder / imu660 / ★adc_ir
├─ src/middleware/ ★odom（里程位姿）/ ★heading（陀螺航向）/ ★line_pos（灰度质心）—— 全部纯逻辑可单测
├─ src/app/        fsm（5 态最小版）/ cmdline / str_util（纯逻辑）
└─ Tools/          patch_uvprojx.py（重新生成后挂回工程）
                   fix_bom.py（中文源码补 UTF-8 BOM）
                   test_parse.c / test_odom.c（★PC 单测）
```

---

## 四、串口命令（115200 8N1，PB6=TX / PB7=RX）

| 命令 | 作用 |
|---|---|
| `HELP` | 命令列表 |
| `PING` | 应答 `PONG` |
| `STATUS` | 状态/节拍/电机/按键/蜂鸣器/MAPR |
| `MAPR` | 打印 AFIO->MAPR |
| `HELLO 0\|1` | 关/开每秒心跳（调参时关掉）|
| `BEEP [ms]` | 蜂鸣 |
| `MODE <IDLE\|TEST\|RUN\|ESTOP>` | 切模式（切换时强制刹车）|
| `MOTOR <FWD\|REV\|BRAKE\|COAST> <0~1000>` | 两侧同设（运行中禁 COAST）|
| `MOTOR L\|R <dir> <mag>` | 只设一侧 |
| `KEY` | 读两个按键电平 |
| **`ENC`** | **编码器累计/增量 —— 推车 1m 标定就看这行** |
| **`ODOM`** | **里程位姿 x/y/yaw/s/v（定点一位小数）** |
| **`ZERO`** | **编码器与位姿清零（标定起点）** |
| **`IMU`** | **陀螺/加速度原始值与 dps（查 SPI 接线用）** |
| **`GYROZERO`** | **陀螺零偏标定（车静止约 1 秒）** |
| **`HEAD`** | **当前航向、零偏、死区** |
| **`IR`** | **8 路原始值 + 归一化值 + err/sum_p/visible** |
| **`IRBLACK` / `IRWHITE`** | **现场把当前读数教成"全黑"/"白线"基准** |
| **`IRPOS <间距mm*100>`** | **改探头间距（如 IRPOS 600 = 6.00mm）** |
| **`TLM <0\|1>`** | **实时行开关（每 100ms 一行 err/vis/v/yaw/lost，走 DMA）** |
| **`LAP`** | **结算当前圈并发一行 LAP，然后自动进下一圈** |
| **`LAPSTART`** | **丢弃当前累积、重开一圈** |
| `LOOPBACK [ms]` | TX-RX 短接时的回环自检 |

---

## 五、★施工中发现的 4 个真问题（都已绕开/修掉）

1. **Windows 不区分大小写**：`drivers/` 与 CubeMX 的 `Drivers/`（HAL）是同一个目录 ⇒ 自写源码统一放 **`bcar/src/`**，否则 CubeMX 重新生成时会把驱动删掉。**框架文档 §1.2 的目录树按此修正。**
2. **CubeMX 命令行不肯生成"USART1 走 PB6/PB7 重映射"**（`IP not ready`）⇒ USART1、TIM1、编码器 TIM2/TIM3 **全部手写寄存器版**。好处：AFIO 重映射、MOE、编码器重映射这些"错了极难查"的点都写在明面上。
3. **中文源码必须补 UTF-8 BOM**：中文 Windows 下 ARMCC 按 GBK 解析 UTF-8 → 一堆 `#870-D` warning，破坏"0 warning"判据。已写 `Tools\fix_bom.py`（二进制里仍是 UTF-8，串口显示中文正常，已验证）。
4. **命令解析 bug（被单测抓到）**：`MOTOR FWD 500` 曾永远解析失败（先截断命令词导致后面参数取不到）；`MOTOR L FWD 500` 又因拿整串比 `"L"` 而失败。解析已抽成纯模块 `str_util.c` + 78 条单测，**改完在电脑上跑，不用上板**。

---

## 六、下一步

- **你在场时（约 15 分钟）**：接 DAPLink → 烧 `bcar.hex` → 阶段 0/1 判据（灯走马 / 串口 hello / MAPR）→ 阶段 2（`MOTOR FWD 500` 两轮同向）→ 阶段 3（`ENC` 推车标定）。
- **我再往下做**（不需要你在场）：**阶段 7 控制环**（转向 PD / 速度 PID / 差速混合 / 弯道减速）—— 控制律也可以先在 PC 上拿仿真数据跑通再上板。
- 还欠一块：**Flash 参数表**（框架 §5：参数存 Flash 末页乒乓 + CRC32，串口 SET/GET 读写）—— 属于阶段 8/9，等控制环定了参数名单再做更省事。
- **一条命令跑全部单测**：`python Tools\run_pc_tests.py`（不需要板子、不需要 Keil）。
- **待你拍板的两个数**（框架 §9 里的）：① 编码器齿轮比/是否要换驱动方式 ② `BCAR_MM_PER_COUNT` 只能推车实测，别用占位值算距离。

---

## 七、git（均已在 `xigua862/SMARTCAR2` main）

`dab98f7` 军师提示词 → `5b6c8f1` 框架提案 → `596c0f9` 阶段0+1骨架 → `333c3ce` src/ 重组 →
`ecd3e1d` 阶段0 → `cae7eeb` 阶段1+2 → `8e89113` 阶段3 → `ec5afae` 阶段4 → `d9c4da3` 阶段5 → **`09e7565` 阶段6 遥测（TX DMA + P² + 单圈指标）**
