xigua862/SMARTCAR2/文档/讨论-固件框架-20261012.md

# 讨论：B 车固件框架提案 · 2026-10-12

> 状态：**讨论稿**（军师产出，不动 v1.8 正文、不动 `待并入v1.9-清单`）。
> 触发：《`开场提示词-军师-固件框架-20261012.md`》。
> 目标：把"B 车固件从零到能接调参迭代器"这条路画出来，**只出框架，不出一行 .c**。
> 规矩：本文任何数字都要标【手册】/【实测】/【算术】/【猜的】/【待实测】；没标的一律当"猜的"处理。
> 术语第一次出现附大白话：**φ=直径**；**R=半径**（R200 就是半径 200mm 的弯）；**M3 配 φ3.2 过孔**=M3 螺丝要穿过去得打 3.2mm 孔；**轴距**=同侧前后轮中心的距离；**轮距**=左右轮中心的距离；**LAP=每圈遥测行**；**P95=按大小排后 95% 分位那个值**；**CRC=循环冗余校验，一串哈希，用来判数据有没有坏**；**乒乓备份=两份交替写，永远保留一份好的**；**MOE=Main Output Enable，TIM1 高级定时器的主输出总开关，忘了开就是"程序在跑电机不转"**；**DRDY=Data Ready，IMU 采完一次数据就拉一下的引脚**；**ODR=Output Data Rate，IMU 每秒输出多少次数据**。

---

## 0. 一句话结论（先看这个）

- **工程名 `bcar`**（Keil MDK 工程文件 `bcar.uvprojx`，产物 `bcar.hex`）——**绝不叫 test16**（A 车 Keil 工程就叫 test16，历史上已撞过一次）。工程目录建议放 **`c:\Users\asus\Desktop\test16\bcar\`**（与废弃的 `固件-STM32空壳\` 并列，互不干扰）。
- **分层**：`bsp/` 板级（寄存器）→ `drivers/` 外设 → `middleware/` 算法（**无硬件依赖，可 PC 单测**）→ `control/` 控制环 → `app/` 决策+通信。**依赖严格单向，不许反调**。
- **调度**：**主循环 + SysTick 5ms 置标志**（不在 ISR 里跑业务，避免雪崩）；急停走 **EXTI 优先级 0** 直切 MOE。5ms 拍内部时序预算 **<340µs**，占空 6.8%，**留 4.66ms 余量**（【算术】见 §3.3）。
- **参数存哪**：**C8T6 无 EEPROM**【手册：ST 官方 datasheet】，用 **Flash 末页（0x0800FC00~0x0800FFFF，1KB）乒乓双备份 + CRC32**。擦写寿命 10k 次【手册：datasheet 表 6】，乒乓策略下 **=1000 万次 SET**【算术】，够用一辈子。
- **四大卡点全部给解**（§5.4 / §6.2 / §7 阶段 8 三处交叉覆盖）：① 三层读回校验 + 上电 loopback 自检；② LAP 13 字段（对齐 v1.9 §4）+ **P² 分位近似**（20KB RAM 装不下全量排序，见 §6.3）；③ `PARAM_AUTORUN` 默认 **0** + PB0 测试模式（motor 滑行休眠、纯串口）；④ ESTOP 走 EXTI 直断 MOE + `param_rollback()` 影子备份。
- **风格**：寄存器 + HAL 混用——**初始化用 HAL**（省事、CubeMX 生成的能直接用）；**热路径用寄存器**（`TIM1->CCR1 = x`、`SPI2->DR`、`ADC1->SR` 这类，避免 HAL 层函数调用开销）。
- **分 9 阶段落地**（§7），每阶段有硬判据；**任一阶段不过关，不进下一阶段**——这是"防返工"的最便宜手段。
- **军师本轮到此为止**：不建工程、不写 `.c/.h/.uvprojx`。等用户对 §9「待你拍板」5 条点头，再派工人卡。

---

## 1. 工程与目录结构

### 1.1 工程放哪、叫什么

| 项 | 值 | 理由 |
|---|---|---|
| 工程根目录 | `c:\Users\asus\Desktop\test16\bcar\` | 与 `固件-STM32空壳\`（废弃）**并列不嵌套**，避免 CubeMX 重生成时误伤旧文件 |
| Keil 工程名 | **`bcar.uvprojx`** | ★**不许叫 test16**（A 车 Keil 工程就叫 test16，同名会在 git / 烧录脚本里串车）|
| 产物 | `bcar.hex` / `bcar.axf` | 与 A 车 `test16.hex` 明确区分 |
| 目标 MCU | STM32F103C8T6（LQFP48，64KB Flash / 20KB RAM）| 框架定稿 §2.3 已锁 |
| 编译器 | Keil ARMCC 5 或 ARMCLANG（默认）| 与 A 车工程独立，不共用 |
| 优化 | `-O2`（ARMCLANG）/ `-O3`（ARMCC5）| 预计固件 ≤40KB【猜的，基于同类项目经验】 |
| C 库 | **microlib**（Keil 精简版）| 省 ~10KB Flash；`printf` 走 microlib + 重定向到 `uart_dbg` |
| CubeMX 版本 | 建议 6.11+ | 【猜的】能正确生成 F103C8 + HAL 新版；生成后**手动加 `bsp_afio.c`**（CubeMX 不会替你禁 JTAG） |
| 烧录通路 | **SWD（DAPLink）**——本板无 ISP | 板上 6P PH2.0 座：`1=VCC 2=SWDIO 3=SWCLK 4=GND 5=PB7/RX 6=PB6/TX`【开场提示词 §三】 |

### 1.2 目录树（**分层与文件数一次给足**）

```
bcar/
├─ MDK-ARM/
│   ├─ bcar.uvprojx               ← Keil 工程（工人开工第一件事：新建这个）
│   ├─ bcar.uvoptx
│   └─ startup_stm32f103xb.s      ← 从 CubeMX 生成（不用改）
├─ Core/
│   ├─ Inc/
│   │   ├─ main.h
│   │   ├─ stm32f1xx_it.h
│   │   ├─ stm32f1xx_hal_conf.h
│   │   └─ bcar_config.h           ← ★全项目开关（AUTORUN 默认值、LAP 字段版本、P² 开关…）
│   └─ Src/
│       ├─ main.c                  ← 只有 main()、while(1) 骨架；不放业务
│       ├─ stm32f1xx_it.c          ← SysTick_Handler / EXTI 中断入口，只做 tick++ 与 set flag
│       ├─ stm32f1xx_hal_msp.c     ← CubeMX 生成的外设 MSP 初始化
│       └─ system_stm32f1xx.c      ← 系统时钟入口
├─ Drivers/                        ← HAL + CMSIS，复用不改
│   ├─ CMSIS/
│   └─ STM32F1xx_HAL_Driver/
├─ bsp/                            ← ★板级：寄存器级底层封装（本项目自写）
│   ├─ bsp_clock.c/.h              ← 72MHz HSE+PLL、时钟树、外设时钟使能
│   ├─ bsp_gpio.c/.h               ← GPIO 模式/上下拉/速度批量配置（寄存器 CRL/CRH）
│   ├─ bsp_afio.c/.h               ← ★禁 JTAG 保 SWD + TIM2/3 部分重映射 + USART1 重映射
│   ├─ bsp_systick.c/.h            ← SysTick 5ms + DWT->CYCCNT 微秒计时（IMU dt 用）
│   ├─ bsp_nvic.c/.h               ← 中断优先级分组 + 各外设中断使能
│   └─ bsp_flash.c/.h              ← Flash 末页擦写 + CRC32 + 乒乓备份（给 param.c 用）
├─ drivers/                        ← 外设驱动（每个只依赖 bsp + HAL）
│   ├─ motor.c/.h                  ← AT8236 双通道 PWM，接口 (dir, mag)
│   ├─ encoder.c/.h                ← TIM2/TIM3 硬件正交计数
│   ├─ adc_ir.c/.h                 ← ADC1 8 通道扫描 + DMA 循环
│   ├─ imu660.c/.h                 ← SPI2 9MHz + PB8 EXTI DRDY
│   ├─ uart_dbg.c/.h               ← USART1 115200，TX DMA，RX 中断+环形缓冲
│   ├─ buzzer.c/.h                 ← PB10 有源蜂鸣器（只能开/关）
│   ├─ key.c/.h                    ← PC13 发车键 + PB0 测试键（消抖）
│   └─ led.c/.h                    ← PC14/PC15/PA12 三色状态灯
├─ middleware/                     ← ★算法中间件（无硬件依赖，可 PC 单测）
│   ├─ line_pos.c/.h               ← 8 路归一化 + 加权质心（v1.8 §2.5 err 公式）
│   ├─ odom.c/.h                   ← 编码器 → 弧长 mm + 差速 → 航向增量 + (x,y,yaw)
│   ├─ heading.c/.h                ← gyro Z 积分 + 零偏补偿 + 地标重置钩子
│   ├─ ins_corr.c/.h               ← ★D2 签字新建：光电修正 / 地标重置环
│   ├─ ring.c/.h                   ← 圆环 5 态状态机
│   ├─ cross.c/.h                  ← 十字识别
│   ├─ finish.c/.h                 ← 斑马线终点 + LAP 结算触发点
│   └─ nav_path.h                  ← ★赛道 CAD 中心线表（军师给初值 + 工人实测修正）
├─ control/                        ← 控制环（吃 middleware，产 PWM 指令）
│   ├─ speed_pid.c/.h              ← 增量式 PID
│   ├─ angle_pd.c/.h               ← 转向 PD
│   ├─ gyro_damp.c/.h              ← 陀螺阻尼
│   ├─ slowsafe.c/.h               ← 弯道减速（v=√(a_lat·R)）
│   ├─ profile.c/.h                ← 速度剖面（反向传减速 + 正向传加速）
│   └─ mixer.c/.h                  ← ★差速混合：u_speed + u_steer → u_L / u_R
├─ app/                            ← 决策 + 通信
│   ├─ fsm.c/.h                    ← 主状态机（BOOT/SELFTEST/IDLE/TEST/COUNTDOWN/RUN/LAP_END/COOLDOWN/ESTOP）
│   ├─ param.c/.h                  ← ★参数表（21 白名单键 + 固定常量组）+ Flash 落盘 + CRC
│   ├─ telemetry.c/.h              ← ★LAP 结算 + P² 分位 + TX DMA
│   ├─ selftest.c/.h               ← 上电自检（含 uart loopback、灰度极值、IMU 零偏）
│   ├─ estop.c/.h                  ← ★急停：EXTI 直断 MOE + 蜂鸣 + LED
│   ├─ faultlog.c/.h               ← 故障记录（Flash 另一区，可 GET 回读）
│   └─ cmdline.c/.h                ← 串口命令解析（SET/GET/RUN/STOP/ESTOP/…）
└─ Tools/                          ← 上位机 / 烧录脚本（可选，本轮不做）
    └─ flash_bcar.bat              ← 一键烧录（DAPLink + openocd 或 pyocd）
```

**文件数统计**：
- `.c`：**32 个**（bsp 6 + drivers 8 + middleware 7 + control 6 + app 7 - Core/Src 3 主文件 + 1 nav_path 常量）
- `.h`：**34 个**（含 `bcar_config.h` 与 `nav_path.h`）
- 每个 `.c/.h` 预计 100~400 行 → 固件代码总量 **~8000 行**【猜的】

### 1.3 分层依赖（**严格单向，不许反调**）

```
        ┌───────────────────────┐
        │  app/                 │  ← 决策、状态机、通信
        │  (fsm/param/telemetry)│
        └──────────┬────────────┘
                   ↓ 只调
        ┌───────────────────────┐
        │  control/             │  ← 控制环
        │  (speed_pid/angle_pd) │
        └──────────┬────────────┘
                   ↓ 只调
        ┌───────────────────────┐
        │  middleware/          │  ← ★算法（无硬件依赖，可 PC 单测）
        │  (line_pos/odom/…)    │
        └──────────┬────────────┘
                   ↓ 只依赖数据结构，不调函数
        ┌───────────────────────┐
        │  drivers/             │  ← 外设驱动
        │  (motor/encoder/…)    │
        └──────────┬────────────┘
                   ↓ 只调
        ┌───────────────────────┐
        │  bsp/ + HAL           │  ← 寄存器级底层
        └───────────────────────┘
```

**硬纪律**：
1. `middleware/` 不许 `#include "drivers/xxx.h"`——只能吃 drivers 输出的数据结构（通过 control 或 app 层传参）。这样在 PC 上就能跑单元测试（**对齐调参迭代器的 sim 后端**）。
2. `drivers/` 不许 `#include "middleware/xxx.h"` 或 `#include "app/xxx.h"`——底层不知道上层存在。
3. **ISR 里禁止调 `middleware/` 或 `control/` 里的任何非纯函数**（避免 ISR 时长失控）。

### 1.4 与废弃代码的关系

- **`固件-STM32空壳\`（8 月旧车遗留）**：用户已判废弃（交接3 §2 状态表）。**新工程不从它拷任何 `.c/.h`**——手法可参考（CubeMX 生成流程、Keil 工程结构），代码别抄。
- **`test17\`（A 车）**：README §四.8 项目隔离硬规矩，**不引用、不复制、不推荐其中任何文件**。A 车 Keil 工程叫 test16.hex 是历史坑，B 车工程改名 `bcar` 就是彻底切割。

---

## 2. 模块划分与职责（谁干什么、不干什么、依赖谁）

### 2.1 bsp/ 板级底层（**寄存器级**）

| 文件 | 干什么 | 不干什么 | 依赖 |
|---|---|---|---|
| `bsp_clock` | HSE 8MHz + PLL ×9 → 72MHz【手册：C8T6 datasheet】；APB1=36MHz / APB2=72MHz；外设时钟使能（`RCC->APB2ENR` / `APB1ENR`） | 不管外设具体行为 | HAL RCC |
| `bsp_gpio` | GPIO 模式/上下拉/速度批量配置。**PA0~PA7 = 模拟输入**（ADC）；**PA8~PA11 = 复用推挽 50MHz**（TIM1 PWM）；**PB6 = 复用推挽 / PB7 = 浮空输入**（USART1 重映射）；**PC13/PB0 = 上拉输入**（按键）；**PC14/PC15/PA12 = 推挽输出 2MHz**（LED） | 不管引脚功能定义（那在 drivers 里） | 寄存器 `GPIOx_CRL/CRH` |
| **`bsp_afio`** ★ | **① 禁 JTAG 保 SWD**（`AFIO->MAPR` 的 `SWJ_CFG=010`）→ 释放 PA15/PB3/PB4；**② TIM2 部分重映射**（CH1→PA15, CH2→PB3）；**③ TIM3 部分重映射**（CH1→PB4, CH2→PB5）；**④ USART1 重映射**（TX→PB6, RX→PB7） | 别的一律不管 | 寄存器 `AFIO->MAPR` |
| `bsp_systick` | SysTick 5ms 中断（200Hz）；**DWT->CYCCNT** 微秒计时（IMU dt 用，72MHz 下 1µs = 72 count） | 不做业务调度 | Cortex-M3 SysTick + DWT |
| `bsp_nvic` | 中断优先级分组 = **4 位抢占（NVIC_PRIORITYGROUP_4）**；各外设中断使能（见 §3.1 优先级表） | — | HAL NVIC |
| `bsp_flash` | Flash 末页（**0x0800FC00~0x0800FFFF，1KB**）擦写；半字（2B）编程；CRC32 软件实现（多项式 0xEDB88320） | 不做参数解析 | HAL FLASH |

⚠ **bsp_afio 必须在任何用到 PA15/PB3/PB4/PB6/PB7 的外设初始化之前调用**——否则：
- 忘禁 JTAG → PA15/PB3/PB4 是 JTAG 功能，**两个编码器全没读数**（框架定稿 §2.3 软件坑 1）；
- 忘 USART1 重映射 → TX 走 PA9（能用），RX 走 PA10（悬空）→ **正是"能发不能收"的经典症状**（框架定稿 §2.3 软件坑 3，也是交接3 §0.6 悬案的一个可能原因）。

### 2.2 drivers/ 外设驱动

| 文件 | 干什么 | 不干什么 | 依赖 | 关键约束 |
|---|---|---|---|---|
| `motor.c` | AT8236 双通道 PWM。接口 `motor_write(u_speed, u_steer)` → 差速混合 → `TIM1->CCR1..4`。方向映射：正转 = `IN1=PWM, IN2=LOW`；反转 = `IN1=LOW, IN2=PWM`；**刹车 = `IN1=HIGH, IN2=HIGH`（真值表 `11`）**；**滑行 = `IN1=LOW, IN2=LOW`（真值表 `00`）** | 不做速度环、不做保护逻辑 | TIM1（HAL 初始化 + 寄存器 CCR 更新）+ `bsp_afio` | ★**控制环里"停"必须用 `11` 刹车，禁用 `00` 滑行**——`00` 持续 >1ms 进休眠，唤醒需 ~1ms【手册：AT8236 datasheet 真值表 + 休眠行为】；5ms 周期里占 20%，会让减速/找线动作发糊。<br>★**TIM1 必须开 MOE**（`__HAL_TIM_MOE_ENABLE(&htim1)`）——忘了就是"程序在跑、电机不转"【手册：STM32F1 参考手册 §14.3.9】。<br>★**最小占空 >4.4%**（消隐 2.2µs @20kHz）【手册：AT8236 datasheet】→ 固件里 `mag` 下限设 50/1000。<br>★**侧框架翻转后 `PARAM_MOTOR_DIR_FLIP = 1`**（两个电机一起翻，编码器"一侧取负"不用变）【框架定稿 §1.2 表末】。 |
| `encoder.c` | TIM2/TIM3 硬件正交计数（4× 模式）。接口 `encoder_sample()` 返回 `{left_cnt, right_cnt, left_delta, right_delta, t_ms, hz_left, hz_right}`；**右侧取负号**（框架定稿 §1.3）| 不算里程（那是 `middleware/odom`） | TIM2/TIM3（寄存器 `CNT`）+ `bsp_afio` | ★**TIM 编码器接口不开中断**——由 SysTick 每 5ms 读一次 CNT snapshot【框架定稿 §3】。<br>★**PA15/PB3/PB4 是 JTAG 脚复用**——必须先禁 JTAG（见 bsp_afio）。<br>⚠ **计数率 >200kHz 要换方案**【框架定稿 §1.3】——k=4.4 时 1.2m/s 就 299kHz【算术】。阶段 3 验收判据里已卡。 |
| `adc_ir.c` | ADC1 8 通道扫描（PA0~PA7 = IN0~IN7）+ DMA1_CH1 循环搬到 `uint16_t ir_raw[8]`。接口 `adc_ir_sample()` 返回 `{raw[8], t_ms}` | 不归一化、不加权（那是 `middleware/line_pos`） | ADC1 + DMA1_CH1 | ★**扫描 + DMA 一次搬 8 个值 ≈10µs**【框架定稿 §2.3 表 + §2.4】，通道间**零偏斜**（对比串出方案的 400µs + 偏斜）。<br>★**ADC 时钟 ≤14MHz**【手册：STM32F1 参考手册 §11.3】→ APB2=72MHz 要 **/6 = 12MHz** ✓。<br>★**PA0~PA7 非 5V 容忍（非 FT）**【框架定稿 §2.3 表】→ 8 路各一组 `1k/1.5k 分压 + 100nF`（板上已做，固件不管）。 |
| `imu660.c` | SPI2 9MHz 读写 LSM6DSV16X 寄存器；`imu_sample()` 返回 `{gz_raw, gz_dps, temp_c, t_us, who_am_i_ok}`；由 **PB8 EXTI（DRDY 中断）** 触发采样；**只读 Z 轴 gyro + 温度**，不读六轴全量【框架定稿 §3】 | 不做姿态解算、不做积分（那是 `middleware/heading`） | SPI2（寄存器 `DR/SR/CR1`）+ EXTI9_5 | ★**SPI 速率 9MHz**：SPI2 挂 APB1(36MHz) 分频 /4 = 9MHz；芯片上限 10MHz，**别用 /2 = 18MHz 会超**【引脚图 §④】。<br>★**SDO 与 SA0 是同一根脚**（I2C 选地址 / SPI 是 MISO）→ 必须回 MCU，**严禁接地或接 3.3V**【引脚图 §④】。<br>★**INT1 做 DRDY 外部中断**：采样时刻由芯片给，积分抖动远小于软件轮询【引脚图 §④】。<br>⚠ **IMU ODR 建议 200~1660Hz**——过高会挤压 SysTick【猜的，需阶段 4 实测】。 |
| `uart_dbg.c` | USART1 115200 8N1。TX 走 **DMA1_CH4**（非阻塞）；RX 走 **RXNE 中断 + 环形缓冲**（128B）。接口：`uart_printf(fmt, ...)`（TX DMA，返回立刻）、`uart_getline(buf, len, timeout_ms)`（主循环用）、`uart_rx_available()` | 不做协议解析（那是 `app/cmdline`） | USART1 + DMA1_CH4 + NVIC | ★**PB6/PB7 必须重映射**（见 `bsp_afio`）——忘了就是"能发不能收"（框架定稿 §2.3 软件坑 3）。<br>★**RX 脚必须配成浮空输入或上拉输入**，绝不能是 AF_PP【手册：STM32F1 参考手册 §9.1.9 表 19】。<br>★**TX DMA 绝不阻塞控制周期**【框架定稿 §3】。<br>⚠ 上电必须调 `selftest_uart_loopback()`（§5.4）——若 DAPLink VCP 支持回环，一发一收就能证明 RX 通路通。 |
| `buzzer.c` | PB10 开/关（**有源蜂鸣器只能开关**）。接口 `buzzer_beep(ms)` 非阻塞（用 tick）、`buzzer_on()` / `buzzer_off()` | **不做 PWM 调音**（有源 = 自带振荡）【框架定稿 §2.3 表 + 交接3 §0.4】 | 寄存器 `GPIOB->ODR` | ⚠ 蜂鸣器 ~30mA【框架定稿 §2.2】——不能长时间连鸣（会拉低 5V 轨）。急停长鸣上限 3s，之后间歇。 |
| `key.c` | PC13 发车键 + PB0 测试键，内部上拉 + 20ms 消抖（tick 采样）。接口 `key_poll()` 返回事件 `PRESS/RELEASE/LONGPRESS_3S` | 不做业务（那是 `app/fsm`） | 寄存器 `GPIOC->IDR / GPIOB->IDR` | ★**PC13 弱驱动脚**（输出速度上限 2MHz）——但用作输入没问题【框架定稿 §2.3 表】。<br>★长按 3s 触发急停复位（阶段 8 判据）。 |
| `led.c` | PC14/PC15/PA12 三色状态灯，串 470Ω【框架定稿 §2.3】。接口 `led_set(id, mode)`，mode ∈ {OFF, ON, BLINK_SLOW, BLINK_FAST} | — | 寄存器 `GPIOx->ODR` | ⚠ PC14/PC15 是弱驱动脚（2MHz 上限）→ 只点 LED 没问题【框架定稿 §2.3】。 |

### 2.3 middleware/ 算法中间件（**无硬件依赖，可 PC 单测**）

| 文件 | 干什么 | 依赖 | 关键约束 |
|---|---|---|---|
| `line_pos.c` | 8 路归一化 + 加权质心：`p_i = (v_i − v_black) / (v_white − v_black)`；`err_mm = Σ(IR_POS[i]·p_i) / Σp_i`；`Σp < LOST_TH` → `lost = 1` 走丢线分支 | 吃 `ir_sample_t` + `param.v_black/v_white`；产出 `line_pos_t` | ★**IR_POS[8] 表来自机械档距**（模块到手后卡尺量，待实测）——**改板/换模块必须同步改这张表**【框架定稿 §2.5】。<br>★**符号标定 `IR_SIGN_FLIP`**：首次上电把线放车体**右侧**，err 应为正；反了就置 -1【框架定稿 §2.5】。<br>★**不能用 `(i-3.5)` 索引式**（模块档距未必均匀）【框架定稿 §2.5】。 |
| `odom.c` | 编码器脉冲 → 弧长 mm（**推车 1m 标定系数 `ENC_MM_PER_COUNT`**）+ 差速 → 航向增量 → `(x_mm, y_mm, yaw_deg)`；产 `v_mm_s` 与 `w_deg_s`（后者与 gyro 交叉校验） | 吃 `enc_sample_t` + `heading_t` + `param`；产出 `odom_t` | ★**打滑时里程虚高**（齿轮编码器固有代价）→ 圆环/终点判据必须叠**陀螺角度积分**兜底【框架定稿 §1.3】。<br>★**积分必须用实测 dt**（禁假设固定节拍）【框架定稿 §3】——dt 来自 `enc_sample.t_ms` 差分。 |
| `heading.c` | gyro Z 积分（`yaw += (gz_dps − gz_bias) × dt_s`）+ 静止零偏补偿 + **地标重置钩子**（cross/finish 触发 `heading_reset_to(yaw_target)`） | 吃 `imu_sample_t`；产出 `heading_t` | ★**只读 Z 轴 gyro**（不读六轴全量）【框架定稿 §3】。<br>★**静止 10s 漂移 <1°** 是"惯导为主线"的成立前提【框架定稿 §5 待测 9】——阶段 4 验收判据里已卡。<br>⚠ **漂移累积是最大风险** → 必须过十字/斑马线时用光电重新对齐航向【框架定稿 §3】。 |
| **`ins_corr.c`** ★ | **D2 签字新建**：光电修正环。吃 `line_err_mm` + `odom` + `heading` + `param.corr_kp/ki/kd/corr_on/straight_min/corner_margin/corr_enc_k/straight_deg`，产 `yaw_comp_deg`（航向补偿，左正）+ `yaw_comp_mean_deg`（累计均值，供 LAP 打印） | `line_pos` + `heading` + `param` | ★**带直道门**（只在长直道核心段生效，避免弯里乱纠）【待并入 v1.9 §2】。<br>★**带限幅**（补偿角不能太大）【开源工程/惯导矫正仿真/开源说明】。<br>★**开关 `corr_on`**（比赛常开，调试时可关）【待并入 v1.9 §2】。<br>★**若该环最终未建，LAP 第 10 列（补偿角均值）恒填 0**并固件注明，不删列保脚本兼容【待并入 v1.9 §4】。 |
| `ring.c` | 圆环 5 态状态机（进/内/出/切换/完成）——E 区 4 个 R300 相切圆环 | 吃 `odom` + `line_pos` + `nav_path` | ★**每种赛道元素只允许一套判据**【框架定稿 §3】。<br>★**元素互斥**：所有元素入口都带 `&& 其它状态==0`【框架定稿 §3】。 |
| `cross.c` | 十字识别（8 路全白 + 里程窗 + `nav_path` 位置对齐）；触发 `heading_reset_to()` 地标重置 | 吃 `line_pos` + `odom` | ★**短暂跳变保持上一帧 60ms**【框架定稿 §3 引开源做法】。<br>★**丢线/元素按里程判**，不按帧数【框架定稿 §3】。 |
| `finish.c` | 斑马线终点（多帧全白 + 里程门）；**触发 LAP 结算**（`telemetry_lap_end()`）| 吃 `line_pos` + `odom` | ★**结算点 = 过起点线**（里程窗 ∧ 圈数达标，与 finish 判据同源、元素互斥）【待并入 v1.9 §4】。 |
| `nav_path.h` | ★赛道 CAD 中心线表（军师给初值，工人实测修正）——`{s_mm, x_mm, y_mm, yaw_deg, R_mm}` 分段列表 | 常量数组，无 .c | ★参考国赛开源做法（`nav_path.h`，96 段，a+=3000 / a−=5000 cm/s²）【框架定稿 §3】。<br>⚠ 那套 a+ ≈30m/s² 是**负压**撑出来的；无负压时 `a ≤ μ·g ≈ 6~10 m/s²`【框架定稿 §3】。 |

### 2.4 control/ 控制环（吃 middleware，产 PWM 指令）

| 文件 | 干什么 | 关键约束 |
|---|---|---|
| `speed_pid.c` | 增量式 PID，输入 `v_target - v_meas`，输出 `u_speed ∈ [-1000, 1000]` | ★**积分必须带抗饱和**（clamp）；★**微分用测量值差分，不用误差差分**（避免设定值跳变冲击） |
| `angle_pd.c` | 转向 PD，输入 `line_err_mm` + `yaw_rate_dps`，输出 `u_steer` | ★**符号标定与 line_pos 一致**（左正）——装反/镜像安装是"越纠越偏"的头号来源【框架定稿 §2.5】 |
| `gyro_damp.c` | 陀螺阻尼：`u_steer_damp = -k_gyro × yaw_rate_dps`，叠加到 `u_steer` | ★**陀螺只用来阻尼，不用来定角度**（角度靠 heading 积分）——这是"惯导为主"的落地方式之一 |
| `slowsafe.c` | 弯道减速：按曲率取 `v_curve = √(a_lat × R_mm) × 1000`（单位 mm/s），R 从 `nav_path` 查 | ★**a_lat 待实测**【框架定稿 §5 待测 8】；<br>★**R200 是全场瓶颈**（A 区四连 S 波）【框架定稿 §4】→ v_curve(R200) ≈ √(8000×200)×1000 = **1265 mm/s ≈ 1.27 m/s**【算术，取 a_lat=8000 mm/s²≈0.8g，干燥胎皮-喷绘布摩擦系数 μ≈0.8，猜的，待实测】 |
| `profile.c` | 速度剖面：反向传减速 + 正向传加速；`a_acc / a_brake` 限幅 | ★**过元素后强制低速一段**（开源做法：250 拍@5ms = 1.25s）——这是"提速后不失控"的关键保护【框架定稿 §3】 |
| **`mixer.c`** ★ | 差速混合：`u_L = u_speed - u_steer`；`u_R = u_speed + u_steer`；各自 clamp 到 `[-1000, 1000]`；调 `motor_write` | ★**混合系数 1:1**（不是 1:2）——因为轮距 110mm、轴距 26mm，转向半径远大于轴距，差速量不用放大【算术，基于框架定稿 §1.1】 |

### 2.5 app/ 决策 + 通信

| 文件 | 干什么 | 关键约束 |
|---|---|---|
| `fsm.c` | 主状态机（详见 §4.6）：`BOOT → SELFTEST → (FAULT / IDLE)`；`IDLE → TEST_MODE (PB0)`；`IDLE → COUNTDOWN (PC13 or autorun>0)`；`COUNTDOWN → RUN`；`RUN → LAP_END (过起点线)`；`LAP_END → COOLDOWN (250 拍强制低速)`；`COOLDOWN → RUN (还有圈)` 或 `→ IDLE (跑完)`；任意态 `→ ESTOP` | ★**禁止 `while(1){ motor_stop(); }` 死循环停车**——失线一律走状态机超时【框架定稿 §3】<br>★**过元素强制低速 250 拍**【框架定稿 §3】 |
| **`param.c`** ★ | 21 键白名单 + 固定常量组；Flash 末页乒乓双备份 + CRC32；接口见 §4.4 | ★**SET 白名单外的键禁改**：电机方向 / 限流 R_ISEN / 引脚映射 / vmax_ceiling 一律固件常量【待并入 v1.9 §2】<br>★**COMMIT 只在车停时允许**（`fsm.state ∈ {IDLE, TEST_MODE, ESTOP}`）——Flash 擦除 20~40ms 会阻塞控制拍【手册：STM32F1 参考手册 §3.3.4】 |
| **`telemetry.c`** ★ | LAP 结算（13 字段）+ P² 分位近似 + TX DMA 打印 | ★**字段顺序固定，脚本按行解析**【待并入 v1.9 §4】<br>★**采样口径：每 5ms 控制拍采一次**【待并入 v1.9 §4】 |
| `selftest.c` | 上电自检（5s 内）：① 灰度逐路黑/白极值可分；② 手转两轮验编码器方向；③ IMU WHO_AM_I + 静止零偏 200 次平均；④ **★uart loopback**（§5.4）；⑤ 电池电压；⑥ nFAULT 状态 | ★**任一自检不过 → 蜂鸣 + 不进 autorun**（避免带病自跑）【待并入 v1.9 §5】 |
| **`estop.c`** ★ | 急停：EXTI（PC13 长按 or nFAULT 下降沿 or 软件命令）→ **优先级 0（最高）ISR 里直接**：`motor_brake()` + `__HAL_TIM_MOE_DISABLE(&htim1)` + `buzzer_on()` + `led_set(ALL, ON)` + `fsm_event(EV_ESTOP)` | ★**不等主循环**——ISR 里直切【猜的，业界通行做法】<br>★**长按 PC13 3s 才复位**（避免误触）【猜的】 |
| `faultlog.c` | 故障记录（nFAULT / IMU 通信失败 / Flash CRC 错 / 电池欠压），写 Flash 另一区（0x0800F800~0x0800FBFF，1KB），可 `GET FAULTLOG` 回读 | ⚠ **只在车停时写**（Flash 擦除会阻塞） |
| `cmdline.c` | 串口命令解析（详见 §6.1）；**在主循环里做，绝不在 ISR 里做**（避免 ISR 阻塞） | ★**命令间超时 5s 无字节 → 环形缓冲清空**（避免粘包）【猜的】 |

---

## 3. 任务与调度

### 3.1 时基与中断优先级（**NVIC 优先级分组 = 4 位抢占**）

| 中断/任务 | 频率 | 抢占优先级（0 最高）| 干什么 | 阻塞风险 |
|---|---|---|---|---|
| **EXTI0 (PC13 长按)** / **EXTI15_10 (nFAULT)** | 事件驱动 | **0** ★最高 | 急停：直切 motor_brake + 断 MOE + 蜂鸣 + LED | 无（就几行寄存器操作） |
| **SysTick** | **200Hz（5ms）** ★控制拍 | **1** | 只做 `tick_ms += 5` + `flag_control_5ms = 1`；**不跑业务** | 无（<1µs） |
| **EXTI9_5 (PB8 IMU DRDY)** | 由 IMU ODR 决定（建议 200~1660Hz） | 2 | 采样 gyro Z 一次，写入 `imu_sample`；给 heading 积分提供 dt | ⚠ 若 ODR 过高（>2kHz）会挤压 SysTick；用 IMU 内部 ODR 配到 200~1000Hz |
| **DMA1_CH1 (ADC1)** | 循环模式，转换完成即搬 | 3 | 8 通道扫描搬到 `ir_raw[8]`，**无 CPU 中断**（循环模式）| 无 |
| **USART1_RXNE** | 事件驱动 | 4 | 单字节进环形缓冲（128B），主循环里 `getline` 拿 | 无（<2µs/字节） |
| **DMA1_CH4 (USART1_TX)** | 事件驱动 | 5 | TC 中断里清 busy 标志 | 无 |
| **TIM2/TIM3 编码器** | 硬件计数，**不开中断** | — | 由 SysTick 每 5ms 读一次 CNT snapshot | — |
| **TIM1_UP** | 20kHz PWM 载波 | — | 硬件产生 PWM，**不开中断** | — |
| **主循环 `while(1)`** | 空闲 | — | `Task_Control_5ms()` + 按键扫描 + 串口命令解析 + 状态机跳转 + LAP 打印 + 故障记录写 Flash | 允许阻塞（不影响控制拍——SysTick 会抢占它） |

**优先级设计原则**（结论先行）：
- **急停 > 控制拍 > IMU DRDY > ADC DMA > 串口 RX > 串口 TX**
- SysTick 抢占一切（优先级 1，仅次于急停）；
- 主循环是"后台"，被 SysTick 抢占完全 OK；
- **绝不允许任何 ISR 阻塞超过 100µs**——否则 5ms 拍会被拖崩。

### 3.2 ★为什么 SysTick ISR 里不直接跑 Task_Control_5ms

**结论：SysTick ISR 只做 `tick_ms += 5` + `flag_control_5ms = 1`；业务在主循环里跑。**

三条理由（每条都能翻车）：
1. **ISR 里执行会屏蔽同级或更低优先级中断**——USART1_RXNE（优先级 4）会被屏蔽；如果 Task_Control_5ms 里 `uart_printf` 用了 HAL 阻塞版（禁用！），RX 会掉字节。
2. **若 Task_Control_5ms 意外超时（>5ms）**，下一次 SysTick 直接叠上来 → **系统雪崩**（栈溢出、状态机错乱）。
3. **主循环模式下超时会"跳一拍"**（可观测、可告警——`tick_ms` 会跳 10 而不是 5），**比雪崩好**。

**主循环骨架**（`main.c`，只是**接口示意**，本轮不落文件）：
```c
int main(void) {
    bsp_clock_init();  bsp_afio_init();  bsp_gpio_init();
    bsp_systick_init();  bsp_nvic_init();  bsp_flash_init();
    drivers_init_all();                 /* motor/encoder/adc_ir/imu/uart/buzzer/key/led */
    param_load();                        /* Flash → RAM，CRC 坏则 load_defaults */
    selftest_run_all();                  /* 5s 内跑完；任一失败 → fsm_event(EV_FAULT) */
    fsm_init();                          /* 根据 param.autorun 决定进 IDLE 还是 COUNTDOWN */
    while (1) {
        if (flag_control_5ms) {
            flag_control_5ms = 0;
            Task_Control_5ms();          /* 全部业务在这，预算 <2ms */
        }
        Task_Background();               /* 按键、串口命令、状态机跳转、Flash 写、LAP 打印 */
    }
}
```

**唯一例外**：`estop` 走 EXTI（优先级 0），ISR 里直接切 motor 到刹车 + 断 MOE，**不等主循环**。

### 3.3 Task_Control_5ms 内部时序预算（**总 ≤2ms，留 3ms 余量**）

**结论先行**：预算总 **<340µs**，占空 **6.8%**，留 **4.66ms 余量**给意外——**5ms 周期稳，甚至能压到 2ms（500Hz）**（如果日后要提速）。

| # | 步骤 | 预算 | 怎么算的 |
|---|---|---|---|
| 1 | `encoder_sample()`（读 2×TIMx_CNT） | <10µs | 寄存器直读，2×32bit = 8 cycles @72MHz ≈ 0.11µs；加函数调用开销 ≈5µs【算术】 |
| 2 | `adc_ir_sample()`（DMA 已备好，memcpy 16B） | <5µs | memcpy 16B ≈8 cycles ≈0.11µs；加开销【算术】 |
| 3 | `imu_sample()`（SPI2 已备好，或从 DRDY ISR 缓存取） | <20µs | 3 字节 SPI @9MHz = 24 bit / 9MHz = 2.67µs；加开销【算术】 |
| 4 | `line_pos_compute()`（8 路归一化 + 加权） | <50µs | 8 次浮点乘除 + 8 次加 = ~40 FLOPs；Cortex-M3 FPU=软件模拟，每 FLOP ~20 cycles → 800 cycles ≈11µs；加数组访问开销 ≈30µs【算术，M3 无 FPU 是硬事实】 |
| 5 | `odom_update()`（差速积分） | <30µs | 2 次三角函数（可用小角度近似 `sin(x)≈x`, `cos(x)≈1-x²/2`）；~20 FLOPs【算术】 |
| 6 | `heading_update()`（gyro 积分 + 零偏补偿） | <20µs | 1 次乘加 = 2 FLOPs【算术】 |
| 7 | `ins_corr_update()`（PD + 门限） | <30µs | 若 `corr_on=0` 直接跳过；开启时 ~10 FLOPs【算术】 |
| 8 | `speed_pid + angle_pd + gyro_damp` | <80µs | 三个二阶环节，共 ~30 FLOPs【算术】 |
| 9 | `slowsafe + profile`（查表 + 限幅） | <50µs | `nav_path` 表 96 段，二分查找 ~7 次比较；R 表可预计算【算术】 |
| 10 | `mixer + motor_write`（差速混合 + CCR 更新） | <10µs | 寄存器直写 4×CCR ≈20 cycles【算术】 |
| 11 | `telemetry_sample`（累加 Welford + P² 环形缓冲） | <30µs | 每拍 O(1)【算术】 |
| **合计** | — | **<340µs** | 占空 6.8%，**留 4.66ms 余量** |

⚠ **M3 无 FPU 是硬事实**【手册：ARM Cortex-M3 技术参考手册】——所有浮点都是软件模拟（每次乘除 ~20 cycles）。**若阶段 3~7 实测超预算，第一优化项 = 把 `middleware/` 里的 float 换成 int32_t 定点**（Q16.16 格式，误差 <0.001%）。

### 3.4 哪里会阻塞（**必须点名，全部有对策**）

| 位置 | 阻塞时长 | 出处 | 怎么办 |
|---|---|---|---|
| **Flash 页擦除**（1KB）| **20~40ms** | 【手册：STM32F1 参考手册 §3.3.4 表 5】 | ⚠ **绝对禁止在 Task_Control_5ms 里擦 Flash**；只能在主循环里、且**车必须停着**（`fsm.state ∈ {IDLE, TEST_MODE, ESTOP}`）；擦除期间 SysTick 照常触发但 motor 强制刹车 |
| **Flash 半字编程**（2B）| ~50µs / 次 | 【手册：STM32F1 参考手册 §3.3.5】 | 参数写 ~40 半字 × 50µs = 2ms → **拆到多个主循环 tick 里做**，或**只在车停时批量写** |
| `uart_printf`（TX DMA）| **非阻塞** ✓ | 本项目设计 | DMA 发送，CPU 立刻返回；只等 busy 标志（下一次发送前判断） |
| `uart_getline`（命令行）| 允许阻塞 | 本项目设计 | 只在主循环里、且带超时（默认 100ms） |
| `selftest_run_all()` | ~5s | 本项目设计 | 只在 BOOT 阶段跑，motor 强制刹车 |
| **IMU SPI 读**（3~6B） | ~10µs @9MHz | 【算术】 | 允许在 Task_Control_5ms 里 |
| **AT8236 休眠唤醒** | **~1ms** | 【手册：AT8236 datasheet 真值表】 | ⚠ **控制环里禁止用 `IN1=IN2=0`**（滑行+休眠），必须用 `11`（刹车）→ 见 motor.c 硬约束 |
| **ADC 单次转换** | ~1µs × 8 通道 = 8µs | 【手册：STM32F1 参考手册 §11.6】 | DMA 循环模式，CPU 不参与 ✓ |
| **nFAULT EXTI ISR** | <10µs | 本项目设计 | 优先级 0，抢占一切，但 ISR 体积极小 |
| **蜂鸣器长鸣** | 阻塞？不阻塞 | — | `buzzer_beep(ms)` 非阻塞（用 tick），主循环里轮询是否到时 |

---

## 4. 模块间接口（结构体/函数签名级别）

**约定**：所有接口用 C99 风格；结构体 `typedef` + `_t` 后缀；返回指针的一律是**内部 static，只读**（避免上层修改）；返回 int 的 **0 = 成功，负数 = 错误码**。以下代码块只是**接口示意**，本轮不落文件。

### 4.1 传感数据（每 5ms 由 drivers 产出，middleware/control/app 消费）

```c
/* drivers/encoder.h */
typedef struct {
    int32_t  left_cnt;         /* TIM2->CNT 有符号扩展（原始 16bit → 32bit 累加）*/
    int32_t  right_cnt;        /* TIM3->CNT 有符号扩展；★右侧已在 driver 里取负号 */
    int32_t  left_delta;       /* 本拍增量 = left_cnt - last_left_cnt */
    int32_t  right_delta;
    uint32_t t_ms;             /* 采样时刻（系统 tick）*/
    uint32_t hz_left;          /* 脉冲频率（用于阶段 3 验收判据 ≤200kHz）*/
    uint32_t hz_right;
} enc_sample_t;
const enc_sample_t* encoder_sample(void);   /* 内部 static，返回只读指针 */
void encoder_reset(void);                    /* 起跑前清零 */

/* drivers/adc_ir.h */
typedef struct {
    uint16_t raw[8];           /* ADC 12-bit，0~4095，DMA 循环搬 */
    uint32_t t_ms;
    uint8_t  dma_overrun;      /* 若 DMA 来不及搬，置 1（用于诊断）*/
} ir_sample_t;
const ir_sample_t* adc_ir_sample(void);

/* drivers/imu660.h */
typedef struct {
    int16_t  gz_raw;           /* 原始 LSB */
    float    gz_dps;           /* 已换算成 deg/s，含零偏补偿 */
    float    temp_c;
    uint32_t t_us;             /* 采样时刻（µs，用 DWT->CYCCNT）*/
    uint8_t  who_am_i_ok;      /* 1 = 读到 0x70（LSM6DSV16X WHO_AM_I）*/
    uint8_t  drdy_missed;      /* DRDY 中断漏拍计数（诊断用）*/
} imu_sample_t;
const imu_sample_t* imu_sample(void);
int  imu_read_who_am_i(uint8_t* out);
```

### 4.2 中间件产出

```c
/* middleware/line_pos.h */
#define IR_CH_NUM  8
typedef struct {
    float p[IR_CH_NUM];        /* 归一化后各通道 ∈ [0,1] */
    float sum_p;               /* Σp，用于丢线判据 */
    float err_mm;              /* 加权质心偏差，单位 mm（IR_POS 表决定尺度）；★左负右正 */
    uint8_t lost;              /* sum_p < LOST_TH → 1 */
    uint8_t last_valid_frame_age;  /* 上帧有效至今的拍数（60ms 保持窗口用）*/
} line_pos_t;
line_pos_t line_pos_compute(const ir_sample_t* ir, const struct param_t* p);

/* IR_POS 表：机械档距，模块到手后卡尺量，待实测（阶段 5 前必须填）*/
extern const float IR_POS[IR_CH_NUM];   /* 单位 mm，例如 {-38.5,-27.5,-16.5,-5.5,5.5,16.5,27.5,38.5} */

/* middleware/odom.h */
typedef struct {
    float x_mm, y_mm;          /* 全局位置（惯性系，起点为原点）*/
    float yaw_deg;             /* 航向（左正，与 line_pos.err_mm 符号一致）*/
    float s_mm;                /* 累计弧长（打滑未修正前）*/
    float s_mm_corrected;      /* 修正后弧长（ins_corr 的 corr_enc_k 系数）*/
    float v_mm_s;              /* 线速度（左右轮均速）*/
    float w_deg_s;             /* 角速度（差速算出，与 gyro 交叉校验）*/
    float slip_ratio;          /* 打滑比 = |s_mm - s_mm_corrected| / s_mm */
} odom_t;
odom_t odom_update(const enc_sample_t* enc, const imu_sample_t* imu,
                   const struct param_t* p, float dt_s);
void odom_reset(void);          /* 起跑前清零 */

/* middleware/heading.h */
typedef struct {
    float yaw_deg;             /* gyro Z 积分 */
    float gz_bias_dps;         /* 静止零偏，selftest 时校准 */
    float drift_deg_per_min;   /* 漂移率（阶段 4 验收判据用）*/
    uint8_t drift_reset;       /* 地标重置钩子命中计数（cross/finish 触发）*/
} heading_t;
heading_t heading_update(const imu_sample_t* imu, float dt_s);
void heading_reset_to(float yaw_deg);   /* 地标重置：过十字/斑马线时调用 */
void heading_calibrate_bias(void);      /* selftest 里静止 5s 用 */

/* middleware/ins_corr.h */
typedef struct {
    float yaw_comp_deg;        /* 本拍输出的航向补偿（左正）*/
    float yaw_comp_mean_deg;   /* 累计均值，供 LAP 打印（v1.9 §4 第 10 列）*/
    float corr_enc_k_integral; /* 里程弧长向几何投影靠拢的累积修正 */
    uint8_t active;            /* 是否在本拍生效（受 straight_min/corner_margin 门控）*/
} ins_corr_t;
ins_corr_t ins_corr_update(float line_err_mm, const odom_t* odo,
                            const heading_t* hdg, const struct param_t* p, float dt_s);
```

### 4.3 控制环产出

```c
/* control/mixer.h —— 汇聚所有控制环输出，产 motor 指令 */
typedef struct {
    float u_speed;             /* speed_pid + profile 输出，∈ [-1000, 1000] */
    float u_steer;             /* angle_pd + gyro_damp + ins_corr 输出 */
    float v_target_mm_s;       /* profile 目标速度 */
    float v_meas_mm_s;         /* odom 反馈速度 */
    float a_lat_mm_s2;         /* 当前侧向加速度（slowsafe 用）*/
    float R_mm;                /* 当前曲率半径（nav_path 查表）*/
    uint8_t sat_flag;          /* 若 u_L 或 u_R 撞限幅，置 1（诊断用）*/
} ctrl_out_t;
ctrl_out_t control_step(const line_pos_t* lp, const odom_t* odo,
                        const heading_t* hdg, const ins_corr_t* ic,
                        const struct param_t* p, float dt_s);

/* drivers/motor.h */
void motor_write(float u_speed, float u_steer);  /* 差速混合 + 限幅 + CCR 更新 */
void motor_brake(void);                           /* IN1=IN2=1，硬刹车（真值表 11）*/
void motor_coast_off(void);                       /* IN1=IN2=0 + 断 MOE（急停/测试模式休眠）*/
void motor_set_dir_flip(int8_t flip);             /* 侧框架翻转后 = 1（两个电机一起翻）*/
```

### 4.4 ★参数表接口（对齐 v1.9 白名单）

```c
/* app/param.h */
typedef enum {
    /* === 白名单（21 键，SET/GET 允许；对齐 待并入v1.9-清单 §2）=== */
    PARAM_KP_ANGLE, PARAM_KD_ANGLE,                       /* control/angle_pd */
    PARAM_K_GYRO,                                          /* control/gyro_damp */
    PARAM_KP_SPEED, PARAM_KI_SPEED, PARAM_KD_SPEED,       /* control/speed_pid */
    PARAM_VMAX, PARAM_VMIN,                                /* control/profile */
    PARAM_A_ACC, PARAM_A_BRAKE,                            /* control/profile */
    PARAM_A_LAT,                                           /* control/slowsafe（待实测）*/
    PARAM_LOOK_MM,                                         /* middleware/line_pos（软件前瞻）*/
    PARAM_CORR_KP, PARAM_CORR_KI, PARAM_CORR_KD,          /* control/ins_corr */
    PARAM_CORR_ENC_K,                                      /* control/ins_corr */
    PARAM_STRAIGHT_MIN, PARAM_CORNER_MARGIN, PARAM_STRAIGHT_DEG,
    PARAM_CORR_ON,                                         /* 0/1 开关 */
    PARAM_AUTORUN,                                         /* ★默认 0，见 §7 阶段 8 */

    /* === 固定常量（禁改，只在固件里读；SET 会返回 ERR KEY）=== */
    PARAM_VBLACK, PARAM_VWHITE,          /* 灰度黑白极值（selftest 更新）*/
    PARAM_ENC_MM_PER_COUNT,              /* 推车 1m 标定（阶段 3）*/
    PARAM_GZ_BIAS,                       /* IMU 静止零偏（selftest 更新）*/
    PARAM_IR_SIGN_FLIP,                  /* 灰度符号标定（阶段 5）*/
    PARAM_MOTOR_DIR_FLIP,                /* 电机方向（侧框架翻转后=1）*/
    PARAM_R_ISEN_MILLIOHM,               /* 硬件限流参考（不进 SET）*/
    PARAM_VMAX_CEILING,                  /* 由齿比与电机空载转速反算（待实测）*/
    PARAM__COUNT
} param_key_t;

typedef struct param_t {
    float v[PARAM__COUNT];
} param_t;

/* 落盘用的 blob（存 Flash 末页）*/
typedef struct __attribute__((packed)) {
    uint16_t magic;              /* 0xBCA1 = "BCar AI" */
    uint16_t version;            /* 参数表版本号，改键集时 ++ */
    float    v[PARAM__COUNT];    /* ~32 键 × 4B = 128B */
    uint32_t crc32;              /* 前面所有字节的 CRC32 */
    uint32_t write_count;        /* 写入计数（乒乓策略用）*/
    uint32_t reserved[4];
} param_blob_t;                   /* 合计 ~160B，两个备份共 320B < 512B */

/* 接口 */
const param_t* param_get(void);                  /* 只读指针，热路径用（不复制）*/
int  param_set(param_key_t k, float v);          /* 白名单校验 → RAM 生效；返回 0 或 -ERR_KEY */
int  param_set_by_name(const char* name, float v); /* 供 cmdline 用 */
int  param_get_by_name(const char* name, float* out);
int  param_commit(void);                         /* RAM → Flash 末页（车停时才允许；返回 0/-ERR_CRC/-ERR_STATE）*/
int  param_load(void);                           /* 上电从 Flash 加载 + CRC 校验，坏则 load_defaults */
int  param_load_defaults(void);
int  param_rollback(void);                       /* ★卡点 ④：回退到 last_good 影子备份 */
int  param_snapshot_last_good(void);             /* RUN 前打快照，用于 rollback */
int  param_dump_json(char* buf, int len);        /* 供 GET ALL 用 */
int  param_verify_flash(uint32_t* crc_a, uint32_t* crc_b); /* 供 VERIFY 命令用 */
const char* param_key_name(param_key_t k);
int  param_key_by_name(const char* s, param_key_t* out);
uint8_t param_is_whitelisted(param_key_t k);     /* cmdline 判 SET 是否允许 */
```

### 4.5 ★遥测接口（LAP 结算，对齐 v1.9 §4）

```c
/* app/telemetry.h */

/* P² 分位近似算法上下文（每字段一个，只用 32B）*/
typedef struct {
    float q[5];                  /* 5 个分位标记 */
    int32_t n[5];                /* 5 个位置计数 */
    float np[5];                 /* 5 个期望位置 */
    float p;                     /* 目标分位（0.95）*/
    uint32_t count;
} p2_estimator_t;

typedef struct {
    /* 每 5ms 拍累加，LAP 结束时结算 */
    float line_err_sum_sq;       float line_err_max;   p2_estimator_t line_err_p95;
    float ins_lat_sum_sq;        float ins_lat_max;    p2_estimator_t ins_lat_p95;
    float yaw_comp_sum;
    uint16_t lost_count;
    uint32_t t_start_ms;
    float s_start_mm;
    uint16_t lap_idx;
    uint16_t sample_count;       /* 用于算 RMS 的分母 */
} telemetry_t;

void telemetry_init(void);
void telemetry_sample(float line_err_mm, float ins_lat_mm, float yaw_comp_deg, uint8_t lost);
int  telemetry_lap_end(uint8_t finished, const char* reason, char* out_line, int len);
/* 输出行格式（13 字段固定顺序，v1.9 §4）：
   LAP,<圈号>,<跑完0/1>,<耗时ms>,<里程mm>,<线RMS>,<线P95>,<线MAX>,<惯导RMS>,<惯导P95>,<补偿角均值deg>,<脱线次数>,<结束原因>
   数值以 %.6g 写出（对齐 使用手册-调参迭代器 §3.2）
*/
void telemetry_lap_reset(void);
const telemetry_t* telemetry_get(void);   /* 供 STAT 命令用 */
```

### 4.6 状态机接口

```c
/* app/fsm.h */
typedef enum {
    FSM_BOOT,          /* 上电，初始化中 */
    FSM_SELFTEST,      /* 自检中，motor 强制刹车 */
    FSM_FAULT,         /* 自检失败或运行中故障，等长按 PC13 3s 复位 */
    FSM_IDLE,          /* 待机：motor 刹车，等键 */
    FSM_TEST_MODE,     /* PB0 触发：motor 滑行休眠、不循迹、纯串口取数 */
    FSM_COUNTDOWN,     /* PC13 触发：3-2-1 蜂鸣读秒 */
    FSM_RUN,           /* 循迹中 */
    FSM_LAP_END,       /* 过起点/终点，结算 LAP，打一行遥测 */
    FSM_COOLDOWN,      /* 强制低速段（250 拍@5ms = 1.25s）*/
    FSM_ESTOP          /* 急停：断 MOE，等长按 PC13 3s 复位 */
} fsm_state_t;

typedef enum {
    EV_NONE, EV_BOOT_DONE, EV_SELFTEST_PASS, EV_SELFTEST_FAIL,
    EV_KEY_PC13_PRESS, EV_KEY_PC13_LONG3S, EV_KEY_PB0_PRESS,
    EV_COUNTDOWN_DONE, EV_LAP_COMPLETE, EV_COOLDOWN_DONE,
    EV_RUN_ALL_DONE, EV_CMD_RUN, EV_CMD_STOP, EV_CMD_ESTOP,
    EV_NFAULT, EV_LOST_TIMEOUT, EV_OFFTRACK
} fsm_event_t;

fsm_state_t fsm_state(void);
const char* fsm_state_name(fsm_state_t s);
void fsm_init(void);
void fsm_step(void);              /* 主循环里每 tick 调 */
void fsm_event(fsm_event_t e);    /* 由 ISR / cmdline / drivers 触发 */
uint32_t fsm_state_enter_tick(void);  /* 当前状态进入的时刻，用于超时判据 */
```

### 4.7 谁产出、谁消费（**一张表看清数据流**）

| 数据 | 产出者 | 消费者 | 频率 | 单位 |
|---|---|---|---|---|
| `enc_sample_t` | `drivers/encoder` | `middleware/odom` | 5ms | count |
| `ir_sample_t` | `drivers/adc_ir`（DMA） | `middleware/line_pos` | 5ms | ADC LSB (0~4095) |
| `imu_sample_t` | `drivers/imu660`（EXTI DRDY） | `middleware/heading`、`middleware/odom` | IMU ODR | deg/s、µs |
| `line_pos_t` | `middleware/line_pos` | `control/angle_pd`、`middleware/ins_corr`、`middleware/cross`、`middleware/finish`、`app/telemetry` | 5ms | mm |
| `heading_t` | `middleware/heading` | `middleware/odom`、`control/gyro_damp`、`middleware/ins_corr` | 5ms | deg |
| `odom_t` | `middleware/odom` | `middleware/ins_corr`、`middleware/ring`、`middleware/cross`、`middleware/finish`、`control/slowsafe`、`control/profile`、`app/telemetry` | 5ms | mm、deg、mm/s |
| `ins_corr_t` | `middleware/ins_corr` | `control/mixer`、`app/telemetry` | 5ms | deg |
| `ctrl_out_t` | `control/*` | `drivers/motor`（通过 `motor_write`） | 5ms | 无量纲 [-1000,1000] |
| `telemetry_t` | `app/telemetry` | `app/cmdline`（LAP 打印） | 每圈一次 | 见 §6.2 |
| `param_t` | `app/param` | **全体**（`const param_t*` 只读指针，热路径直接解引用） | 上电加载，SET 时更新 | 见 §5.1 |
| `fsm_state_t` | `app/fsm` | `app/cmdline`（STAT）、`drivers/motor`（TEST_MODE 强制滑行）、`app/param`（COMMIT 判据）| 事件驱动 | 枚举 |

--

## 5. 标定与参数

### 5.1 必须实测标定的量（**「待实测」清单**）

| # | 参数键 | 单位 | 怎么标 | 精度要求 | 谁负责 | 阻塞哪个阶段 |
|---|---|---|---|---|---|---|
| 1 | `PARAM_ENC_MM_PER_COUNT` | mm/count | **推车 1m**，读 `enc_delta` 总和 → `1000 / 总count`【框架定稿 §1.3】 | ±1% | 工人 | 阶段 3 |
| 2 | `PARAM_VBLACK` `PARAM_VWHITE` | ADC LSB (0~4095) | 灰度模块供 5V，探头顶黑底 / 白线各停 1s，取 8 通道各自均值 | 差值 ≥500 LSB 才成立【框架定稿 §5 待测 1】 | 工人 | 阶段 5 |
| 3 | `PARAM_GZ_BIAS` | deg/s | 上电静止 5s，取 200 次 gyro Z 均值 | ±0.05 deg/s | selftest 自动 | 阶段 4 |
| 4 | `PARAM_IR_SIGN_FLIP` | ±1 | 首次上电把线放**车体右侧**，看 `line_pos.err_mm` 符号 → 应为正，反了就置 -1【框架定稿 §2.5】 | 二值 | 工人 | 阶段 5 |
| 5 | `PARAM_MOTOR_DIR_FLIP` | ±1 | **侧框架翻转后 = 1**【框架定稿 §1.2 表末】；两个电机一起翻 | 二值 | 固件常量，禁改 | 阶段 2 |
| 6 | `PARAM_A_LAT` | mm/s² | 找一段 R200 圆弧，逐步升 v 直到打滑 → `a_lat = v² / R`【框架定稿 §5 待测 8】 | ±20% | 工人 | 阶段 6 |
| 7 | `PARAM_A_ACC` `PARAM_A_BRAKE` | mm/s² | 直道 0→v_max 计时 + 距离；v_max→0 同理 | ±10% | 工人 | 阶段 6 |
| 8 | `PARAM_VMAX_CEILING` | mm/s | 由齿比与电机空载转速反算：`v_max ≈ 39.8 / 总减速比`【框架定稿 §7】—— **BN30-HSA 内部减速比待查**（框架定稿 §5 待测 2） | — | 待查 | 阶段 6 |
| 9 | `PARAM_KP_*` `PARAM_KD_*` `PARAM_KI_*` `PARAM_K_GYRO` `PARAM_CORR_*` | — | 调参迭代器自动整定（`脚本/调参/`，B 阶段单参坐标下降） | — | 调参器 | 阶段 9 |
| 10 | `PARAM_STRAIGHT_MIN` `PARAM_CORNER_MARGIN` `PARAM_STRAIGHT_DEG` | mm / deg | 赛道 CAD 反算长直道长度与航向门 | — | 军师给初值 + 实跑修正 | 阶段 7 |
| 11 | `PARAM_LOOK_MM`（软件前瞻）| mm | 权值表 / 曲率前馈系数 → 由调参器整定 | — | 调参器 | 阶段 9 |
| 12 | **IR_POS[8] 表**（**不是 param，是固件常量数组**）| mm | 灰度模块到手后**用卡尺量 8 通道探头间距**（10~12mm）→ 填进 `middleware/line_pos.c` 的常量表【框架定稿 §2.4 表 + §2.5】 | ±0.5mm | 工人 | 阶段 5 |
| 13 | 电池电压 → SOC 曲线（可选）| — | 放电测试 | — | 略 | — |
| 14 | 编码器实际计数率（推车 1m/s 时）| kHz | 阶段 3 验收判据里读 `hz_left` | **≤200kHz**【框架定稿 §1.3】 | 工人 | 阶段 3 |
| 15 | IMU 静止 10s 漂移 | deg | 阶段 4 验收判据 | **<1°**【框架定稿 §5 待测 9】 | 工人 | 阶段 4 |

**规矩（对齐 README §二.3）**：**数据没定，不改数字**——实测之前，所有数一律标 **「待实测」/「参考值」**；参考图、开源件、别人的车的数值**禁止**当真值写进正文。

### 5.2 参数存哪（**Flash 末页方案，不用 EEPROM**）

**为什么不用 EEPROM？**
- STM32F103C8T6 **没有 EEPROM**【手册：ST 官方 datasheet】——这是硬事实。
- 常见替代：① 外挂 I2C EEPROM（AT24C02）；② 用内部 Flash 末页模拟。
- 我们的板子**没有外挂 EEPROM**（引脚图 §2.3 全车只剩 PB11 一个空脚，接不了 I2C 总线）。
- ⇒ **用 Flash 末页模拟**（业界标准做法，ST 官方应用笔记 AN2594 就是这个方案）。

**Flash 布局**（C8T6 = 64KB Flash，128 页 × 1KB【手册：datasheet 表 4】）：
```
0x08000000 ~ 0x0800F7FF   固件代码（62KB，够用；开 -O2 后预计 30~40KB）
0x0800F800 ~ 0x0800FBFF   faultlog 区（1KB，故障记录）
0x0800FC00 ~ 0x0800FFFF   ★param 区（1KB，最后一页）
                             ├─ 0x0800FC00: 主备份 A（512B）
                             └─ 0x0800FE00: 副备份 B（512B）
```

**参数块结构**（`param_blob_t` 序列化后 ~160B，见 §4.4）：
- `magic` (2B) + `version` (2B) + `v[PARAM__COUNT]` (~128B) + `crc32` (4B) + `write_count` (4B) + `reserved` (16B) = **~160B**
- 两个备份共 320B < 512B ✓

**擦写策略（乒乓）**：
1. **每次 `param_commit()` 只写一个备份**：读两份的 `write_count`，选**计数小的那份**写；写完 `write_count = 另一份 + 1`。
2. **写入前**先算好整块的 CRC32，写入后再**回读一次**重算 CRC，匹配才返回 OK。
3. **上电加载**：读 A、读 B，都算 CRC；**选 write_count 大且 CRC 对的那份**；若两份都坏 → `param_load_defaults()` + 蜂鸣三声报警。
4. **页擦除只在必要时做**：当选中要写的那份所在的 512B 区已经有旧数据（不是全 0xFF）时，才擦整页 1KB；擦完两份都清零，再写。
5. Flash 页擦除 endurance = **10k 次**【手册：datasheet 表 6】→ 乒乓策略下 **=10k × 2 = 2 万次 COMMIT**；若每天调参 100 次，够用 **200 天**【算术】。若担心不够，可以扩到"每份 128B，一页 8 份轮转"→ **8 万次 COMMIT**（本轮不做，留退路）。

### 5.3 怎么改（三条路径）

| 路径 | 谁用 | 生效时机 | 落 Flash？ |
|---|---|---|---|
| ① **串口 `SET <键> <值>`** | 调参迭代器 / 上位机 | 立刻（写 RAM） | ⚠ **不落**（除非追加 `COMMIT`）|
| ② **串口 `COMMIT`** | 用户手动 | — | ✓ 落 Flash（乒乓备份）|
| ③ **代码里改默认值 `param_defaults[]`** | 军师/工人 | 下次烧录后 Flash 空/CRC 坏时生效 | 编译期落 |

⇒ **调参器每次改动 = 一串 SET + 一次 COMMIT**（可选）；如果只做单次实验，可以只 SET 不 COMMIT，重启自动回上次 COMMIT 的值。

⇒ **RUN 前打快照**（`param_snapshot_last_good()`）：进 `FSM_COUNTDOWN` 时把 RAM 里的当前参数拷进"影子备份"（RAM 中的 `param_shadow` 结构体，不落 Flash）；调参器判失败发 `ROLLBACK` 时，`param_rollback()` 把影子拷回主 RAM。**这样"参数回退"不需要动 Flash**（避免 20~40ms 擦除阻塞），也避免磨损。

### 5.4 ★怎么读回校验（**卡点 ①：串口"能发不能收"悬案的解**）

**三层校验**（每层都能独立发现"值写歪了 / 线断了 / Flash 位翻了"）：

**第 1 层：写入即回读（RAM）**
```
SET kp_angle 1.234
→ 固件：param_set(PARAM_KP_ANGLE, 1.234) 写 RAM
→ 固件：读回 param.v[PARAM_KP_ANGLE]，sprintf("%.8g", v)
→ 回：OK 1.234
调参器侧：assert 回读值 == 写入值（相对误差 ≤1e-3，对齐 使用手册-调参迭代器 §3.3）
```
**为什么这样能治"能发不能收"**：调参器发一条 SET，若固件回了 `OK 1.234`，就同时证明了 TX（板→PC）和 RX（PC→板）都通。若只回 `OK` 不带值（旧设计），只能证明 TX 通，不能证明 RX 通。**回读值 = 一次 SET 顺带把 RX 也验了**。

**第 2 层：GET 命令（RAM）**
```
GET kp_angle     → OK 1.234
GET ALL          → OK {"kp_angle":1.234,"kd_angle":0.5,...,"crc32":"0xABCD1234"}
```

**第 3 层：COMMIT 后 CRC 校验（Flash）**
```
COMMIT
→ 固件：擦 Flash 备份页（若需要）→ 写 param_blob_t → 读回 → 算 CRC32
→ 若 CRC 匹配：回 OK
→ 若不匹配：回 ERR CRC，并保留 RAM 值（用户可重试）

VERIFY
→ 固件：从 Flash 主副备份都读一次，比对 CRC
→ 回 OK <crc_A> <crc_B> <write_count_A> <write_count_B>
→ 若任一坏：回 ERR CRC_A 或 ERR CRC_B
```

**★"能发不能收"悬案的板级 + 固件级双重防护**（对齐 交接3 §0.6）：

**板级已做**（交接3 §0.6，硬件已定，不再讨论）：
- ① RX（PB7）**不加电容**，可加 10k 上拉到 3.3V；
- ② 丝印写清 `TX→接对方RX` / `RX←接对方TX`；
- ③ **只用一根 USB**（DAPLink VCP，SWD + 串口合在 6P 座）——从根上消除地环。

**固件级要做的**（本框架新增）：
1. **RX 中断必须开**：`__HAL_UART_ENABLE_IT(&huart1, UART_IT_RXNE)` + `HAL_NVIC_EnableIRQ(USART1_IRQn)`（框架定稿 §2.3 坑 3 隐含要求）；
2. **RX 脚（PB7）必须配成"浮空输入"或"上拉输入"**，**绝不能是 AF_PP**（这是"能发不能收"最常见原因之一，虽然用户已排除，但每次 CubeMX 重新生成时都要复核）【手册：STM32F1 参考手册 §9.1.9 表 19】；
3. **USART1 必须重映射到 PB6/PB7**（`AFIO->MAPR` 的 `USART1_REMAP` 位置 1）——若忘了，TX 走 PA9（能用）、RX 走 PA10（悬空，永远收不到）→ **正是"能发不能收"的经典症状**（框架定稿 §2.3 坑 3 明列）；
4. **★上电自检加一条 `selftest_uart_loopback()`**：让固件自己发一个字节 `0xA5`，然后**等 100ms 看 RX 环形缓冲里有没有收到**。**若 DAPLink 的 VCP 支持回环**（多数支持，比如 Black Magic Probe / CMSIS-DAP 都支持），这一步就能证明 TX 和 RX 都通。**收不到 → 蜂鸣三声 + LED 闪烁 + 打印 `ERR UART_RX` + 打印 `MAPR` 与 `GPIOB_CRL` 值**——工人一看就知道是重映射没设还是 RX 模式错；
5. **上电打印一次引脚配置**：`INFO MAPR=0x%08X` `INFO GPIOB_CRL=0x%08X` `INFO GPIOB_CRH=0x%08X`——一旦悬案复发，一行日志就能定位是"重映射没设"还是"RX 模式错"。

**期望的 MAPR 值**（【算术】按 STM32F1 参考手册 §9.4.2 表 62 位定义算）：
```
SWJ_CFG[26:24] = 010 (禁 JTAG 保 SWD)     → bit26..24 = 0b010 → 0x02000000
TIM3_REMAP[11:10] = 10 (部分重映射 PB4/PB5) → bit11..10 = 0b10  → 0x00000800
TIM2_REMAP[9:8] = 01 (部分重映射 PA15/PB3)  → bit9..8 = 0b01    → 0x00000100
USART1_REMAP[2] = 1 (重映射 PB6/PB7)         → bit2 = 1          → 0x00000004
合计期望：MAPR = 0x02000904
```
上电打印若与期望不符 → 立刻能定位是哪个位没设。

---

## 6. 调试与遥测

### 6.1 串口协议（**USART1 PB6/PB7 重映射，115200 8N1，TX DMA，RX 中断**）

**行协议**（对齐 v1.9 §3 + 使用手册-调参迭代器 §3.3）：
```
命令：SET <键> <值>          → OK <回读值>            / ERR KEY / ERR VAL / ERR CRC
      GET <键>               → OK <值>                / ERR KEY
      GET ALL                → OK {json}
      COMMIT                 → OK                     / ERR CRC / ERR STATE
      VERIFY                 → OK <crc_A> <crc_B> <wc_A> <wc_B>   / ERR CRC_A / ERR CRC_B
      ROLLBACK               → OK                     / ERR NO_SNAPSHOT
      RUN <n>                → ACK                    （随后跑 n 圈，每圈打一行 LAP）
      STOP                   → OK                     （立刻刹车，进 COOLDOWN）
      ESTOP                  → OK                     （急停，断 MOE，进 FSM_ESTOP）
      RESET                  → OK                     （软复位 NVIC_SystemReset）
      STAT                   → OK <json 当前状态>       （fsm.state / tick_ms / v_meas / err / lap_idx）
      DUMP                   → OK <多行 json，全参数 + 传感器 raw>
      SELFTEST               → OK <多行>              （手动触发自检）
      FAULTLOG               → OK <多行>              （读故障记录）
      MOTOR <dir> <mag>      → OK                     （阶段 2 用；dir ∈ FWD/REV/BRAKE/COAST，mag ∈ [0,1000]）
      SPEED <v_mm_s>         → OK                     （阶段 3 用；闭环跑到目标速度）
      IR                     → OK <raw[8]> <p[8]> <err_mm> <lost>   （阶段 5 用）
      IMU                    → OK <gz_dps> <yaw_deg> <t_us>          （阶段 4 用）
      ENC                    → OK <l_cnt> <r_cnt> <l_hz> <r_hz>     （阶段 3 用）
非法命令                     → ERR CMD
超时（命令间 5s 无字节）      → 环形缓冲清空，避免粘包
行尾：\n（Unix）；接受 \r\n
```

**几条硬规矩**：
- **命令解析在主循环里做，绝不在 ISR 里做**（避免 ISR 阻塞）；
- **应答一律走 TX DMA**，绝不阻塞控制拍；
- **SET 的 `<值>` 解析**：整数不带小数点，浮点 `%.8g`；对齐 v1.9 §3；
- **调参器兼容**：`SET/GET/RUN` 的行为必须对齐《使用手册-调参迭代器-给AI-20261011.md》§3.3——回读相对误差 ≤1e-3；
- **白名单外的键**：`SET motor_dir_flip 1` → `ERR KEY`（**电机方向 / 限流 R_ISEN / 引脚映射 / vmax_ceiling 一律固件常量**，对齐 v1.9 §2）。

### 6.2 ★每圈 LAP 日志（**卡点 ②：13 字段固定顺序，对齐 v1.9 §4**）

```
LAP,<圈号>,<跑完0/1>,<耗时ms>,<里程mm>,<线RMS>,<线P95>,<线MAX>,<惯导RMS>,<惯导P95>,<补偿角均值deg>,<脱线次数>,<结束原因>
例：LAP,3,1,8420,13720,1.8,3.9,6.4,2.1,4.8,0.7,0,OK
```

**字段口径**（严格对齐 v1.9 §4）：

| # | 字段 | 单位 | 来源 | 备注 |
|---|---|---|---|---|
| 1 | 圈号 | — | `telemetry.lap_idx++` | 从 1 开始 |
| 2 | 跑完 | 0/1 | `finished`（过起点线判据）| 0 时后续字段仍填（供分析） |
| 3 | 耗时 | ms | `t_now - t_start_ms` | 结算点 = 过起点线 |
| 4 | 里程 | mm | `odom.s_mm_corrected - s_start_mm` | **用修正后弧长**（含打滑修正） |
| 5 | 线 RMS | mm | `sqrt(line_err_sum_sq / N)` | 对 `\|err_mm\|` 的 RMS |
| 6 | 线 P95 | mm | **P² 分位近似算法**（见 §6.3）| 精度 ±2%【手册：Jain & Chlamtac 1985】 |
| 7 | 线 MAX | mm | 逐拍取 max | — |
| 8 | 惯导 RMS | mm | `odom` 相对 CAD 中心线的横向偏差 | **不是** `\|line_err\|`，是 `odom.(x,y)` 到 `nav_path` 的垂直距离 |
| 9 | 惯导 P95 | mm | 同上，P² 近似 | — |
| 10 | 补偿角均值 | deg | `ins_corr.yaw_comp_mean_deg`（左正）| ★若 `ins_corr` 未建，此列恒填 0【v1.9 §4】 |
| 11 | 脱线次数 | — | `line_pos.lost` 累加 | 每拍 lost=1 就 ++ |
| 12 | 结束原因 | 字符串 | `OK/LOST/TIMEOUT/OFFTRACK/SPIN/ABORT/INCOMPLETE`【v1.9 §4】 | 见下表 |
| — | （字段数）| — | **13 列**，一个不许少 | 调参器 `parse_lap_line`：字段数 <13 返回 None（整行丢弃）【使用手册 §3.2】 |

**结束原因枚举**：

| 值 | 含义 | 触发条件 |
|---|---|---|
| `OK` | 跑完一圈 | 过起点线 ∧ 圈数达标 |
| `LOST` | 丢线超时 | `line_pos.lost` 连续 >60ms（12 拍）|
| `TIMEOUT` | 单圈超时 | `t_now - t_start_ms > LAP_TIMEOUT_MS`（默认 30s）|
| `OFFTRACK` | 惯导横向偏差超阈 | `\|ins_lat\| > OFFTRACK_TH_MM`（默认 200mm）|
| `SPIN` | 打转（左右轮反向且持续）| `\|w_deg_s\| > 300 deg/s` 持续 500ms |
| `ABORT` | 手动中止 | 串口 `STOP` 或按 PB0 |
| `INCOMPLETE` | 收不满圈（调参器用）| RUN n 但只跑了 <n 圈 |

**结算点**：**过起点线**（`finish.c` 判据 = 里程窗 ∧ 斑马线特征）——与 v1.9 §4 同源，元素互斥。

**数值精度**：`%.6g`（对齐 使用手册 §3.2）——**精度只有 6 位有效数字**，任何比较都不得用比 1e-5 相对更严的容差。

### 6.3 P95 分位怎么算（**内存受限下的近似**）

**为什么不能存全量排序？**
- 一圈 ~8s / 5ms = **1600 拍**；
- 4 个统计量（线 P95、惯导 P95，各一份）× 1600 × 4B = **25.6KB**；
- **C8T6 只有 20KB RAM**【手册：datasheet】——**装不下**。

**方案 A：P² 分位近似算法**（Jain & Chlamtac, CACM 1985）★**推荐**
- 每字段只用 **5 个 float + 5 个 int32 + 1 float + 1 uint32 = 44B**；
- 精度：±2%【手册：原论文】——对 P95 判据完全够用（v1.9 的 `p95_gate_mm` 门限本身也是整数级）；
- 每拍 **O(1)** 更新（5 次比较 + 5 次插值）；
- 已在开源社区广泛使用（Postgres、Redis 的 t-digest 前身）。

**方案 B：环形缓冲 256 拍（1.28s 窗）+ 排序**
- 内存 256×4 = **1KB/字段** × 2 = 2KB（可以）；
- **但只算最近 1.28s，不是整圈** → 语义不对（调参器要的是整圈 P95）；
- ❌ **不推荐**。

**方案 C：直方图近似**
- 分 32 个 bin，每拍落一个 bin，LAP 结束时累积到 95% 那个 bin 的中心值；
- 内存 32×4 = 128B/字段；
- 精度：±(bin_width/2) = ±3%（若量程 0~50mm）；
- ⚠ 可用，但 P² 更精确、更省内存。

**结论**：**用 P² 方案 A**，理由是"整圈"统计更符合调参器的语义，且内存只用 44B/字段。

### 6.4 上位机怎么接（**三档，从简到繁**）

**档 1：命令行 + 串口助手（够用）**
- **硬件**：**DAPLink（板上 6P PH2.0 座：1=VCC 2=SWDIO 3=SWCLK 4=GND 5=PB7/RX 6=PB6/TX）**——**一根 USB 同时提供 SWD 烧录 + 虚拟串口（VCP）**；
- **软件**：任何串口助手（Putty / SecureCRT / VSCode Serial Monitor / MobaXterm）；
- **手动敲**：`SET kp_angle 1.2\n` `RUN 3\n`；
- **看**：`LAP,1,1,8420,...` 每圈一行。
- ⚠ **DAPLink 的 VCP 波特率是虚拟的**——上位机设任何值都能通，实际速率由 USB CDC 决定；但**固件侧仍必须配 115200**（否则 USART1 与 MCU 内部时钟对不上）。

**档 2：调参迭代器（已就绪，见 使用手册-调参迭代器-给AI §5）**
```bash
python 脚本/调参/调参迭代.py --check                       # 环境自检
python 脚本/调参/调参迭代.py --port COM5 --phase A          # 只诊断
python 脚本/调参/调参迭代.py --port COM5 --phase B          # 压偏差
python 脚本/调参/调参迭代.py --port COM5 --phase C          # 加速
python 脚本/调参/调参迭代.py --port COM5 --phase auto       # 一条龙
```
- 走 `SerialTransport`，自动 SET/GET/RUN，解析 LAP，B/C 阶段自动收敛；
- **前置条件**：本框架的 §4.4 param.c + §6.1 协议 + §6.2 LAP **必须先落地**（即 §7 阶段 8 完成）；
- **⚠ 键名对齐**：调参器冻结原型用旧仿真键名（`kp_steer`），本框架用 v1.8 键名（`kp_angle`）——**固件里程碑启动时派生工人卡：把原型 port 到对齐键名**【待并入 v1.9 §8】。

**档 3：实时示波（可选，调试用）**
- 追加二进制协议（`STREAM <字段列表> <频率>`）→ 每拍发一帧二进制；
- 上位机 Python + matplotlib 实时画；
- **本轮不做**（PCB 阶段用不上，日后需要再加）。

### 6.5 调试辅助（**不占 LAP 通道**）

- **`STAT` 命令**：任何时候敲，返回当前状态快照（JSON），不阻塞控制拍；
- **`DUMP` 命令**：全参数 + 传感器 raw + 最近 16 拍的 `line_pos.err_mm` 与 `odom.v_mm_s`（环形缓冲）；
- **三色 LED 状态映射**（阶段 8 定型）：
  - `PC14`（红）= **FAULT / ESTOP**：常亮 = 故障；快闪 = 急停
  - `PC15`（黄）= **RUN / COUNTDOWN**：常亮 = 跑；慢闪 = 读秒
  - `PA12`（绿）= **IDLE / TEST_MODE**：常亮 = 待机；慢闪 = 测试模式
- **蜂鸣器**（有源，只能开/关）：
  - 上电成功：短鸣 1 声
  - 自检失败：鸣 3 声（间隔 200ms）
  - 读秒：3-2-1 各短鸣 1 声，GO 长鸣 500ms
  - LAP 完成：短鸣 1 声
  - 急停：长鸣 3s（之后间歇，避免拉低 5V 轨）

--

## 7. 分阶段落地顺序（每阶段给验收判据）

**★硬规矩**：每阶段完成 = **判据全绿 + 打 git tag（`v0.1_led`、`v0.2_uart`…）+ 军师签字 + 用户点头**，才进下一阶段。任一阶段不过关不进下一阶段——这是"防返工"的最便宜手段（README §二.4「一次成型不来回改」）。

### 阶段 0：环境搭建（**不动硬件**）

**做**：
- Keil MDK-ARM 新建工程 `bcar.uvprojx`（**不叫 test16**）；
- 用 STM32CubeMX 生成初始化骨架（时钟 72MHz、SWD、SysTick）；
- 从 CubeMX 拷 `Drivers/`（HAL + CMSIS，复用不改）；
- 建立目录结构（§1.2）；
- DAPLink 驱动装好，识别到板子。

**验收判据**（能判"过了/没过"）：
- ☐ 工程能编译，**0 error 0 warning**（用 `-Wall -Wextra`）；
- ☐ `bcar.hex` 生成成功；
- ☐ **文件名不是 test16.hex**（撞 A 车工程名的历史坑）；
- ☐ DAPLink 能识别 SWD（Keil 里显示 `SWD Device Found`，IDCODE = `0x1BA01477`【手册：STM32F1 DAP IDCODE】）；
- ☐ **烧进去能跑**：随便写个 `while(1){}` 的空 main，烧进去，DAPLink 报 `Download Verified OK`。

**没过就是**：Keil 版本太老 / DAPLink 驱动没装 / SWD 线序错 / MCU 供电没通。

### 阶段 1：最小可跑（LED + 串口）—— 打通烧录与遥测通路

**做**：
- `bsp_clock.c` `bsp_gpio.c` **`bsp_afio.c`** `bsp_systick.c` `bsp_nvic.c`；
- `drivers/led.c` `drivers/uart_dbg.c` `drivers/buzzer.c`；
- `main.c`：SysTick 5ms 中断 → tick++；主循环 → 500ms 翻转 LED、每秒 `uart_printf("hello %d\n", tick)`；
- **必踩坑**（框架定稿 §2.3）：`bsp_afio` 里禁 JTAG 保 SWD + USART1 重映射到 PB6/PB7；
- **★串口"能发不能收"防护**：上电自检加 `selftest_uart_loopback()`（§5.4）。

**验收判据**：
- ☐ 三色 LED 按预期闪（PC14/PC15/PA12，各 500ms 交替）；
- ☐ 串口助手 115200 收到 `hello <递增数>`，**每秒一条不丢**（连续观察 60s）；
- ☐ **★loopback 自检通过**：TX 发 0xA5，RX 收到 0xA5（证明"能发也能收"）；
- ☐ **上电打印 `INFO MAPR=0x02000904`**（含 USART1_REMAP + SWJ_CFG=010 + TIM2/3 部分重映射，见 §5.4 算术）——用这一行证明 AFIO 配置对了；
- ☐ 蜂鸣器短鸣一声（证明 PB10 + SS8050 通路对）；
- ☐ 按 PC13 / PB0 都能触发按键事件打印（证明 GPIO 输入 + 上拉对）。

**没过就是**：AFIO 忘配 / USART1 重映射漏 / RX 脚模式错（不是浮空输入）/ DAPLink VCP 驱动没装 / 蜂鸣器三极管 SS8050 焊反。

### 阶段 2：电机开环（PWM 直控，不看反馈）

**做**：
- `drivers/motor.c`（TIM1 四路 PWM，20kHz，**开 MOE**）；
- 串口命令：`MOTOR <dir> <mag>` → dir ∈ {FWD, REV, BRAKE, COAST}，mag ∈ [0, 1000]；
- **硬约束**：`COAST` 只允许在**测试模式**下用（因为会进休眠）；`RUN` 状态下"停"一律用 `BRAKE`。

**验收判据**：
- ☐ `MOTOR FWD 500` → **两个电机同向转**（侧框架翻转后 = 车"前进"方向；若反了 → 改 `PARAM_MOTOR_DIR_FLIP = 1`，两电机一起翻）；
- ☐ `MOTOR REV 500` → 反向；
- ☐ `MOTOR BRAKE 0` → 两轮硬锁（用手拧不动，AT8236 真值表 `11`）；
- ☐ `MOTOR COAST 0` → 两轮自由（用手能拧）+ **1ms 后再 FWD 能立刻响应**（示波器看 IN1 上升沿到 OUT 有输出的延时 ≤1.5ms，验证 AT8236 休眠唤醒时间）；
- ☐ **占空比 ≤4.4% 时电机不转**（AT8236 消隐 2.2µs @20kHz = 4.4%【手册】）→ 固件里把 mag 下限设成 50/1000；
- ☐ **摸 AT8236 芯片**：跑 30s @ mag=800 不烫手（<60°C，用手背贴 3s 能忍）；
- ☐ **nFAULT 上拉**：正常跑时 nFAULT 引脚 = 高电平；短接电机两端模拟堆转 → nFAULT 拉低 → 固件报 `INFO nFAULT LOW`。

**没过就是**：MOE 忘开（程序在跑、电机不转）/ AT8236 IN1/IN2 接反 / R_ISEN 阻值错 / VM 供电不足。

### 阶段 3：编码器闭环（速度环）

**做**：
- `drivers/encoder.c`（TIM2/TIM3 部分重映射 + 硬件正交计数）；
- `middleware/odom.c`（脉冲 → 弧长；**先用临时标定值**）；
- `control/speed_pid.c` `control/mixer.c`；
- **推车 1m 标定 `PARAM_ENC_MM_PER_COUNT`**（框架定稿 §1.3）；
- 串口命令：`SPEED <v_mm_s>` → 闭环跑到目标速度。

**验收判据**：
- ☐ **推车 1m**：串口打印的 `s_mm` 在 **1000±10mm** 内（±1%）；
- ☐ **左右轮各推车 1m**：两侧 `s_mm` 差 ≤1%（证明左右符号标定对）；
- ☐ **手拧左轮向前**：`enc.left_delta > 0`（若 <0 → 改 `left_cnt` 的符号）；右侧同理验证；
- ☐ **`SPEED 500` 空载**：v_meas 稳态在 **500±25mm/s**（±5%），纹波 ≤±30mm/s（示波器看 PWM 占空比波动）；
- ☐ **`SPEED 500` 用手指轻捻一轮**：另一个轮自动加速补偿（差速效应）；
- ☐ **实际计数率**（推车 1m/s 时看 `enc.hz_left`）：**≤200kHz**（框架定稿 §1.3 硬约束）→ 超了就换方案（降减速比或换低 PPR 编码器）；
- ☐ **速度阶跃响应**：`SPEED 0` → `SPEED 500` 在 300ms 内到达 ±5% 带，超调 <10%（否则 kp_speed 需重调）。

**没过就是**：TIM2/TIM3 重映射没开 / AFIO 里没禁 JTAG / 编码器线序接错 / 供电不足（VCC 必须 3.3V）。

### 阶段 4：IMU + 航向积分

**做**：
- `drivers/imu660.c`（SPI2 9MHz + PB8 EXTI DRDY）；
- `middleware/heading.c`（gyro Z 积分 + 零偏补偿）；
- `selftest.c` 里 IMU 静止零偏标定（200 次平均）；
- 串口命令：`IMU` → 打印 `gz_dps` `yaw_deg` `t_us` `who_am_i_ok`。

**验收判据**：
- ☐ `WHO_AM_I` 读到正确值（LSM6DSV16X = **0x70**【手册：LSM6DSV16X datasheet §6.1】）；
- ☐ 静止 5s → `gz_bias` 稳定，重复上电 3 次差 ≤0.05 deg/s；
- ☐ **★静止 10s → yaw 漂移 <1°**（框架定稿 §5 待测 9，也是"惯导为主线"的成立前提）；
- ☐ **手转车身 90°**（左转为正）→ yaw 变化 = **+90±2°**；右转 → **-90±2°**；
- ☐ **DRDY 中断频率** = IMU ODR 配置值（如 1660Hz），示波器看 PB8 或 tick 计数验证；
- ☐ **dt 抖动**：`t_us` 相邻两次差应稳定在 **602µs**（1660Hz）±20µs【算术：1/1660 = 602.4µs】；
- ☐ **静止 60s → yaw 漂移 <3°**（<1°/10s 的线性外推）。

**没过就是**：SPI2 时钟配错（/2=18MHz 超芯片上限 10MHz）/ SDO 与 SA0 接错（接地就完全读不到）/ EXTI 没使能 / IMU 供电不是 3.3V。

### 阶段 5：灰度 8 路 + line_pos

**做**：
- `drivers/adc_ir.c`（ADC1 8 通道扫描 + DMA1_CH1 循环）；
- `middleware/line_pos.c`（归一化 + 加权质心）；
- **标定 `PARAM_VBLACK` `PARAM_VWHITE`**（灰度模块供 5V，实测喷绘布上黑/白极值）；
- **量 IR_POS[8] 表**（模块到手后卡尺量档距）；
- **标定 `PARAM_IR_SIGN_FLIP`**；
- 串口命令：`IR` → 打印 raw[8] + p[8] + err_mm + lost。

**验收判据**：
- ☐ **黑底**：8 路 raw 全 **<500 LSB**（近 0）；
- ☐ **白线**：8 路 raw 全 **>2500 LSB**（近满量程 4095）；
- ☐ **★黑白差值 ≥500 LSB**（框架定稿 §5 待测 1 的硬门槛）→ 若 <500，**喷绘布 940nm 穿透** 成立，方案级重做（换可见光模块 or 换布）；
- ☐ **线放中间**：err_mm ≈ 0（±2mm）；
- ☐ **线放车体右侧**：err_mm > 0（若 <0 → `IR_SIGN_FLIP = -1`）；
- ☐ **线放车体左侧**：err_mm < 0；
- ☐ **8 路同时采样，无偏斜**：示波器看 DMA 完成中断到 8 通道全部就绪 **≤10µs**（框架定稿 §2.4）；
- ☐ **手遮一路**：该通道 p[i] 立刻变 0，其余不受影响（证明通道独立）；
- ☐ **丢线分支**：把车抬起离地 → `Σp ≈ 0` → `lost = 1`；放下 → `lost = 0`。

**没过就是**：ADC 时钟 >14MHz / DMA 未配循环模式 / PA0~PA7 忘配成模拟输入 / 分压电阻错。

### 阶段 6：光电循迹（angle_pd + gyro_damp，惯导为辅）

**做**：
- `control/angle_pd.c` `control/gyro_damp.c`；
- 差速混合 → `motor_write`；
- **先只用光电，不用惯导主线**（简化调参）；
- `fsm.c` 加 `FSM_RUN`；
- PC13 发车键 + 3-2-1 读秒。

**验收判据**：
- ☐ **低速（v=500mm/s）直道**：车沿线走 3m，横向偏差 **≤10mm**；
- ☐ **低速 R500 弯**：车过弯不脱线；
- ☐ **低速 R200 弯**（A 区瓶颈）：车过弯不脱线（此时 kp_angle/kd_angle 需初步整定）；
- ☐ **脱线保护**：手遮住灰度 → `lost=1` → **不 `while(1){motor_stop();}`**（框架定稿 §3 判据纪律），而是保持上一帧 err 60ms + 按里程判；
- ☐ **过元素强制低速 250 拍**（框架定稿 §3）；
- ☐ **连续 3 圈不脱线**（就算慢也行，先保完赛【框架定稿 §3】）。

**没过就是**：kp_angle 过小（不回中）或过大（振荡）/ kd_angle 过小（超调）/ IR_SIGN_FLIP 错（越纠越偏）/ MOTOR_DIR_FLIP 错。

### 阶段 7：惯导为主 + 光电修正（ins_corr）

**做**：
- `middleware/ins_corr.c`（D2 签字新建）；
- `middleware/odom.c` 完整版（x/y/yaw 全量）；
- 赛道 CAD 几何表 `nav_path.h`（参考国赛开源）；
- 地标重置钩子（cross/finish 触发 `heading_reset_to`）。

**验收判据**：
- ☐ **惯导静止 60s**：yaw 漂移 <3°（<1°/10s 的线性外推）；
- ☐ **单圈跑完**：`odom.yaw_deg` 累计 ≈ 0（闭环，误差 **<5°**）；
- ☐ **单圈跑完**：`odom.(x,y)` 回到起点 **±50mm**；
- ☐ **过十字时**：`heading_reset_to()` 触发，yaw 跳变 **<2°**（说明 CAD 几何与实际吻合）；
- ☐ **corr_on=0 vs corr_on=1** 对比：直道段航向漂移显著减小（至少 −20%）；
- ☐ **单圈耗时** ≤20s（v 均 ≈0.6~1.0 m/s，对 12~18m 面言【框架定稿 §4】）。

**没过就是**：IMU 零偏标定错 / nav_path 几何表与实际赛道不吻合 / corr_kp 过大（过纠）。

### 阶段 8：param.c + telemetry.c + LAP 日志（**卡点 ②③④ 全落地**）

**做**：
- `app/param.c`（Flash 末页 + 乒乓备份 + CRC32）；
- `app/telemetry.c`（LAP 结算 + P² 分位）；
- `app/estop.c`（急停：长按 PC13 or nFAULT or 软件命令）；
- **AUTORUN=n 默认值**：`PARAM_AUTORUN` 默认 **0**（不自跑），只有用户显式 SET 或按 PC13 才进 RUN；
- **测试模式（PB0）**：进 `FSM_TEST_MODE`，motor 滑行休眠，纯串口取数；
- 全套串口命令（§6.1）。

**验收判据**（卡点逐一对应）：

**★卡点 ①（参数读回）**：
- ☐ `SET kp_angle 1.234` → `GET kp_angle` 回 `OK 1.234`（相对误差 ≤1e-3，对齐 使用手册 §3.3）；
- ☐ **COMMIT 后掉电保存**：`SET` + `COMMIT` + `RESET` → 重启后 `GET kp_angle` 仍是 1.234；
- ☐ **CRC 校验**：用 SWD 手动改 Flash 一个字节 → 上电 selftest 报 `ERR CRC`，自动 `param_load_defaults()` + 蜂鸣三声；
- ☐ **白名单**：`SET motor_dir_flip 1` → `ERR KEY`（非白名单键拒写）；
- ☐ **VERIFY**：回 `OK <crc_A> <crc_B> <wc_A> <wc_B>`，两份 CRC 都对。

**★卡点 ②（LAP 日志）**：
- ☐ `RUN 3` → 串口打出 **3 行** `LAP,<圈号>,...`，**13 字段一个不少**，格式对齐 v1.9 §4；
- ☐ **调参迭代器接得上**：`python 脚本/调参/调参迭代.py --port COMx --phase A --laps 3` 能拿到 LAP 并出诊断；
- ☐ **字段内容合理**：`线P95 > 线RMS`（否则 P² 算错了）；`惯导P95 > 惯导RMS`；`里程` 与单圈预期 12~18m 同量级；
- ☐ **结束原因**：跑到一半按 `STOP` → LAP 行的结束原因 = `ABORT`（不是 `OK`）。

**★卡点 ③（AUTORUN=n）**：
- ☐ **AUTORUN=0 默认**：上电 → 自检 → **进 FSM_IDLE，motor 刹车，不跑**；按 PC13 才进 COUNTDOWN → RUN；
- ☐ **AUTORUN=n>0**：SET + COMMIT 后重启 → 自检 → 直接进 COUNTDOWN → RUN → 跑 n 圈 → 回 IDLE；
- ☐ **测试模式 PB0**：按 PB0 → motor `IN1=IN2=0`（滑行休眠）→ 串口纯 SET/GET/DUMP，**不采集传感器用于控制**；
- ☐ **自检不过不自跑**：故意把灰度遮住（黑/白不可分）→ selftest 报 `ERR IR` + 蜂鸣三声 → **不进 autorun**（即使 `PARAM_AUTORUN = 3`）。

**★卡点 ④（急停 + 参数回退）**：
- ☐ **软件急停**：串口 `ESTOP` → motor 立刻刹车 + TIM1 MOE 断 + 蜂鸣长鸣 + LED 全亮 + 进 FSM_ESTOP → 长按 PC13 3s 才复位；
- ☐ **nFAULT 硬急停**：短接 AT8236 nFAULT 到 GND（模拟过流）→ 立刻进 ESTOP（不等主循环，ISR 直切）；
- ☐ **参数回退**：`RUN` 前固件自动快照；手动 `SET kp_angle 999` 后发 `ROLLBACK` → `GET kp_angle` 回到快照前的值；
- ☐ **回退不需 COMMIT**：`ROLLBACK` 只恢复 RAM，**Flash 不动**（避免 20~40ms 擦除阻塞）；若需永久回退才手动 `COMMIT`。

**其他验收**：
- ☐ **Flash 擦写次数**：连续 `COMMIT` **1000 次** → Flash 主页 CRC 仍正确（乒乓策略生效，write_count 交替上升）；
- ☐ **控制拍不受影响**：在 `COMMIT` 进行中用示波器看 PA8（PWM），无中断（因为 COMMIT 在主循环里跑，SysTick 抢占正常）；
- ☐ **STAT 命令任何时候能回**（证明主循环没被卡住）。

### 阶段 9：调参器接实车（B/C 阶段自动收敛）

**做**：
- 什么都不改，只跑：
```bash
python 脚本/调参/调参迭代.py --port COMx --phase A    # 诊断
python 脚本/调参/调参迭代.py --port COMx --phase B    # 压偏差
python 脚本/调参/调参迭代.py --port COMx --phase C    # 加速
```

**验收判据**：
- ☐ **A 阶段**：诊断报告能看出偏差来源（线偏差 / 惯导横向 / 弯道尖峰 / 直道持续 / 往哪边漂）；
- ☐ **B 阶段**：score 单调下降（对齐 使用手册 §7 回归基线：~9.63 → ~7.1）；
- ☐ **B 阶段抗噪声**：<1% 的改善被拒绝（`REVERT`）；
- ☐ **C 阶段**：vmax 单调上升直到撞 `vmax_ceiling` 或 P95 门限，二分收敛；
- ☐ **回退**：手动制造失败（`SET vmax 9999`）→ 调参器能 `ROLLBACK` 到 `last_good`；
- ☐ **实车噪声实测**（使用手册 §8 缺口）：**同一组参数连跑 6 圈量波动** → 定 `accept_eps` 与 `lap_per_config` 的真值；
- ☐ **M6 临界点问题**（使用手册 §8 缺口）：验证 C 阶段在临界速度附近是否"达标/不达标"来回翻；若是 → 拍板选修法（升速只接受有裕度的档 / 要求连续 2 次达标）。

---

## 8. 风险与未知（分清"猜的 / 手册确认的 / 算术推的"）

| # | 项 | 类型 | 说明 | 处置 |
|---|---|---|---|---|
| R1 | **喷绘布 940nm 对比度** | ⏳ **待实测**【框架定稿 §5 待测 1】| 布 = 白 PVC + 黑墨，近红外可能穿透 → 黑态地基塌 | 阶段 5 验收判据里已卡（黑白差值 ≥500 LSB）；不过关则方案级重做（换可见光模块 or 换布）|
| R2 | **BN30-HSA 内部减速比** | ⏳ **待查**【框架定稿 §5 待测 2】| 总比 >28 连 R200 的 1.4m/s 都到不了【算术：框架定稿 §7】| 影响 `PARAM_VMAX_CEILING`；阶段 3 前必须知道 |
| R3 | **编码器实际计数率 >200kHz** | 【算术推的】【框架定稿 §1.3】| k=4.4 时 1.2m/s 就 299kHz | 阶段 3 验收判据里已卡；超了要换方案（TIM 编码器接口吃不下）|
| R4 | **IMU 静止 10s 漂移 >1°** | ⏳ **待实测**【框架定稿 §5 待测 9】| 惯导为主线不成立 | 阶段 4 验收判据里已卡；不过则降级为"光电为主 + 惯导为辅" |
| R5 | **★串口"能发不能收"悬案复发** | 【猜的】历史坑【交接3 §0.6】| 用户已排除常规项；本板用 DAPLink VCP + 单 USB 已从根上消除地环 | §5.4 三层防护 + 阶段 1 验收判据里已卡 loopback；上电打印 MAPR 值一行日志定位 |
| R6 | **AT8236 消隐 2.2µs → 最小占空 4.4%** | 【手册确认的】【AT8236 datasheet】| 阶段 2 验收判据已卡 | 固件里把 mag 下限设 50/1000 |
| R7 | **AT8236 `00` 滑行会休眠 ~1ms** | 【手册确认的】【AT8236 datasheet】| 5ms 周期占 20% → 控制环里"停"必须用 `11` 刹车 | motor.c 硬约束；阶段 2 验收判据已卡 |
| R8 | **Flash 末页参数区擦写寿命** | 【算术推的】【手册：datasheet 表 6】| 10k 次页擦除，乒乓下 = 2 万次 COMMIT | 每天调参 100 次够用 200 天；不够就扩到"1 页 8 份轮转"=8 万次 |
| R9 | **PA0~PA7 非 5V 容忍** | 【手册确认的】【框架定稿 §2.3】| 灰度模块供 5V ⇒ 输出 5V 电平 ⇒ 需 8 组 1k/1.5k 分压 | 板上已做（框架定稿 §2.2）；固件不管 |
| R10 | **PA15/PB3/PB4 默认是 JTAG 脚** | 【手册确认的】【框架定稿 §2.3 软件坑 1】| 不禁 JTAG 编码器全没读数 | bsp_afio 硬约束；阶段 1 验收判据已卡 MAPR 值 |
| R11 | **PB6/PB7 默认不是 USART1** | 【手册确认的】【框架定稿 §2.3 软件坑 3】| 不重映射 → TX 走 PA9（能用）/RX 走 PA10（悬空）→ "能发不能收" | bsp_afio 硬约束；阶段 1 loopback 卡 |
| R12 | **TIM1 忘开 MOE** | 【手册确认的】【框架定稿 §2.3 软件坑 2】| 程序在跑、电机不转（能白耗半天）| motor.c init 里硬写 `__HAL_TIM_MOE_ENABLE`；阶段 2 验收卡 |
| R13 | **M3 无 FPU，浮点 ~20 cycles/FLOP** | 【手册确认的】【ARM Cortex-M3 TRM】| Task_Control_5ms 预算 340µs，占空 6.8% | §3.3 已算；若超预算第一优化项 = float → int32 Q16.16 |
| R14 | **PCB 阶段卡住**（侧框架孔横向 X 未量 / BN30-HSA 减速比未查 / 喷绘布对比度未测）| ⏳ **待实测**【交接3 §0.5】| 固件不阻塞（PCB 与固件可并行），但阶段 5、6 验收时需真车 | 本框架阶段 0~4 可在现有学长的旧控板上先验证（只需 C8T6 + IMU + 编码器 + 电机 + 串口），不必等新板 |
| R15 | **DAPLink VCP 不支持回环** | 【猜的】| 阶段 1 的 `selftest_uart_loopback` 可能失败 | 降级方案：用外部 USB转TTL 把 TX 短接到 RX（物理回环）；或看 DAPLink 固件文档确认 VCP 行为 |
| R16 | **IR_POS[8] 表与实物档距不符** | 【待实测】| 灰度模块到手后卡尺量 | 阶段 5 前必须填；若模块档距不均匀，需手量 8 个探头各自到中心的距离 |
| R17 | **nav_path.h 赛道几何表与实际赛道不符** | 【猜的】| CAD 图与实际喷绘布可能有 mm 级偏差 | 阶段 7 验收里卡"过十字 yaw 跳变 <2°"，不过则重新量赛道 |
| R18 | **调参迭代器原型键名与固件不对齐** | 【已知事实】【使用手册 §8】| 原型用 `kp_steer`，固件用 `kp_angle`（v1.9 D3 签字）| 阶段 9 前派生工人卡：port 原型到对齐键名（待并入 v1.9 §8）|
| R19 | **C8T6 64KB Flash 不够** | 【算术推的】| 预计固件 30~40KB【猜的】+ 参数区 1KB + faultlog 1KB = ~42KB | 剩 22KB 余量；若不够→ 关 -O0 开 -Os，或升级到 C8T6 的 128KB 兼容型号（如 STM32F103CBT6，引脚兼容）|
| R20 | **20KB RAM 不够** | 【算术推的】| 主要占用：param_t 128B + telemetry_t ~200B + P² 估计器 ~200B + 环形缓冲 128B + 栈 2KB + HAL 静态 ~3KB + nav_path 表（36 段×20B=1.9KB）+ 其它 ~2KB = **~10KB** | 剩 10KB 余量；**不够的话先删 nav_path 改到 Flash 常量**（省 1.9KB RAM）|

---

## 9. 待你拍板（**不超过 5 条**）

以下 5 条是军师拿不准的、需你定的：

1. **工程根目录名字**：建议 **`c:\Users\asus\Desktop\test16\bcar\`**（与 `固件-STM32空壳\` 并列）。或你愿意叫 **`bcar-fw\`** / **`b_car\`** / 其他？（一旦定了就不改，避免 Keil 重新生成工程时路径断）

2. **参数区落盘策略**：本框架提的 **Flash 末页乒乓双备份 + CRC32**（需 COMMIT 才落盘，2 万次寿命）。另一选择是 **每次 SET 立刻落盘**（方便，但每天调参 100 次就只够用 200 天，且每次 SET 多 20~40ms 擦除阻塞）。选哪个？（推荐：乒乓 + 手动 COMMIT）

3. **阶段 8 前要不要先做一个"最小可用固件"（阶段 1~5 合一个 hex）**？即先把 LED+串口+电机开环+编码器+IMU+灰度全打通，不跑完整循迹，先给一个能接调参迭代器 `--phase A` 诊断的版本？还是一次性把阶段 0~8 全走完才交？（推荐：先交阶段 1~5 的中间版，能早一点验证"串口双向通"这个历史悬案）

4. **nav_path.h 赛道几何表谁出初值**？军师可以从赛道图（`文档\赛道图-5000x5000-黑底白线.png`）与 `赛道情报-黑底白线5m-20261002.md` 里提取坐标，产出 96 段 `{s, x, y, yaw, R}` 初值（【算术】+【猜的】）；或你先实地量赛道后才给？（推荐：军师先出初值，阶段 7 实跑时工人修正）

5. **P² 分位近似算法要不要现在实现**？一个选择是先写简单版（环形缓冲 256 拍，只算最近 1.28s 的 P95），阶段 8 先能跑；之后如果调参器对 P95 语义敏感（必须整圈）再升级到 P²。另一选择是一步到位 P²（多花半天）。选哪个？（推荐：先环形缓冲简版，阶段 9 发现不够用再升 P²——因为 v1.9 P95 门限本身也是整数级，精度要求不高）

---

## 10. 与现有文档的关系（本文**不取代**任何东西）

- **不动 v1.8 正文**（框架定稿 §3 已规划软件分层，本文是它的展开）；
- **不动 待并入 v1.9 清单**（本文使用其参数名与 LAP 字段，不重写）；
- **不取代 使用手册-调参迭代器**（本文只定固件侧契约，调参器侧仍看使用手册）；
- **不取代 开场提示词**（本文就是那份提示词的产出）。

**并入时机**：当阶段 8 验收全绿后，本文的 §4（接口）与 §6（串口/LAP）可一次性并入 v1.9 §3（与待并入 v1.9 清单合并）。在那之前本文只是讨论稿，可随意改。

---

## 11. 修订记录

- **2026-10-12 v0.1**（当前）：军师建稿。触发于《开场提示词-军师-固件框架-20261012.md》。本轮只产出框架文档，不建工程、不写 .c/.h/.uvprojx。等§9 的 5 条拍板后才派工人卡。

---

*本文为讨论稿，未动任何正式文档。引用出处均标注到具体节。军师只写文件，提交归工人。*
