xigua862/SMARTCAR2/文档/工作报告-调参迭代器-20261011.md

# 工作报告 · 调参迭代器（军师阶段）· 2026-10-11

> 提交对象：**检察官**（独立复核）。作者：**军师**。项目：**test16 / B 车（微缩车 · 机器车循迹）**。
> 一句话结论：**任务方向成立但阶段过早**；本轮产出＝设计 + 决策 + 待并入清单，实现原型**冻结留档**；**未碰法律 / git / 实车**；有 **1 处已如实记录的验证缺口**（C 阶段未复跑）与 **1 处已纠正的角色越界**（纠正前写了实现代码）。

---

## 1. 背景与任务

- **原始任务（用户口述）**：为 B 车（STM32F103C8T6，惯导为主 + 光电为辅，5ms 控制周期）写"一圈一次迭代"自动调参器 `脚本/调参迭代.py` + 两份契约（参数 / 遥测），三阶段 A 诊断 / B 压偏差 / C 加速 + 安全阀 + `--sim` 离线自证（不追噪声 / 能回退 / 能停止）。
- **角色纠正（关键）**：用户中途澄清我应是 **"军师"**（只做设计与决策、写文档 + 任务卡；**不写实现代码、不碰 git、不碰实车**），且开场提示词**误串到 test17 旧项目** → 我按 **test16 现状**重新推断，不套用 test17 的文件清单与大纲。

## 2. 现状推断（先读后设计）

已读：`交接3-唯一入口` · `开场提示词-与设计理念` · `README`（军师/工人协作规范）· `框架定稿-B车C8T6 v1.8`（法律）· `讨论-待办执行包`。

**结论**：test16 = B 车，机器车循迹（校赛 + 省赛），STM32F103C8T6，**惯导为主 + 光电为辅、5ms 周期**；**当前处 PCB 阶段（原理图完、布局中），固件一行未写**（`固件-STM32空壳/` 是旧车废弃件）；**法律 = 框架定稿 v1.8**（§3 已规划软件分层）。

## 3. 核心判断：原任务与现状的 3 处错位

| # | 错位 | 内容 |
|---|---|---|
| 1 | **阶段错位** | 固件未写 → 串口 `SET/GET/RUN` + 每圈 `LAP` 遥测**没有对端** → 现在只能离线验证策略，不能接实车 |
| 2 | **架构错位（最要命）** | 调参器参数抄自仿真的"**建图圈→路表→跟表 + 直道矫正环**"；v1.8 主线是"**里程 + 航向 + 已知 CAD 几何 + 地标重置**"。⇒ `corr_*`/`straight_min`/`corner_margin`/`look_mm` 在 v1.8 无对应物；**SET 键名必须 = 固件 `param.c` 表，不能 = 仿真键名** |
| 3 | **口径错位** | 遥测"线偏差 / 惯导横向偏差"须映射到 v1.8 的 `line_pos` err（§2.5）与 `odom` vs CAD 中心线，否则 RMS/P95 不可比 |

## 4. 决策（用户签字 2026-10-11）

| # | 决策 | 签字 |
|---|---|---|
| D1 | 离线调参器 **冻结留档**（不占 PCB 关键路径） | 冻结 |
| D2 | `corr_*` 等 **保留** → 固件新建 `control/ins_corr.c`（光电修正 / 地标重置环）承接 | 保留 |
| D3 | 参数命名 **以 v1.8 §3 模块名为准**重落（仅 `kp_steer→kp_angle`、`kd_steer→kd_angle` 改名） | 是 |
| D4 | `脚本/调参/` **保留为原型**（冻结态） | 保留 |
| D5 | 串口协议 + LAP 遥测 + AUTORUN **并入 v1.8 §3** → 但**挂起**到固件里程碑再一次性出 v1.9（不现在改法律） | 加吧 / 挂起 |

## 5. 交付物清单（均为文件，**尚未提交**）

| 文件 | 性质 | 说明 |
|---|---|---|
| `文档/讨论-调参迭代器与固件契约-20261011.md` | 军师·讨论稿 | 推断 + 3 处错位 + 对齐设计 + 决策日志（§9） |
| `文档/待并入v1.9-清单-20261011.md` | 军师·增量暂存 | D5 的"要动哪几处"清单 + §3 增量逐条提案 + **对齐后参数键表** + 三道门自检 |
| `文档/工作报告-调参迭代器-20261011.md` | 军师·本报告 | 交检察官复核 |
| `脚本/调参/调参迭代.py` | **冻结原型**（越界产物，见 §7） | 约 1070 行、能跑：A/B/C + 安全阀 + 串口/sim/replay + 日志 + ASCII 收敛曲线 + `--check` |
| `脚本/调参/调参参数.json` | 冻结原型 | 平铺参数（车参 + 元参 + 合成系数），`--check` 80 键通过 |
| `脚本/调参/{调参日志.csv, 调参参数_best.json, 调参收敛.txt}` | 冻结原型·运行产物 | ⚠ 是 gate=3.5、C 被跳过那次跑的，见 §6 |

> 注：原任务要的"两份契约 `.md`"**不再单独产出**——被 D5 取代（契约并入 §3 法律，见待并入清单 §2~§5）。

## 6. 原型自证状态（诚实披露）

- ✅ **已自证（`--sim` 合成数据）**：`--check` 8 项通过；A 诊断能判"惯导为主 / 瞬态尖峰在弯 / 往左漂"；**B 单参坐标下降 score 8.8→6.5 单调收敛，且正确拒绝 <1% 的噪声级改善（"不追噪声"成立）**。
- ⚠ **唯一缺口**：**C 阶段"升 vmax→连续失败→二分退一半→回退"代码已写，但未复跑验证**。上次完整跑 C 被闸门(3.5)挡住没进；军师把 `p95_gate_mm` 调到 4.0 后**没再跑**。⇒ 现存 `调参收敛.txt / 日志 / best` 与 JSON 里的 gate **不一致**；"能回退 / 能停止"这条自证**差临门一脚**。
- **实车验证**：用户确认"**车还没弄好、跑不了**" → 实车本就阻塞（与 §3 阶段错位一致）。
- **缺口处置**：属**离线**验证，不需要车，一条命令（`python 调参迭代.py --sim`）即可补齐；军师建议**留到固件里程碑**随其它 port 一起做（用户尚未就此单独拍板）。

## 7. 纪律合规（供检察官逐条核对）

| 纪律 | 状态 |
|---|---|
| 军师只写文档（数据/调查/算术/判据/提案/任务卡） | ✅ 本轮产出＝讨论稿 + 待并入清单 + 本报告 |
| 不改法律（框架定稿 v1.8 正文） | ✅ 增量走"待并入清单"、**挂起**，正文一字未动 |
| 不碰 git（提交归工人/用户） | ✅ 所有文件**未提交** |
| 不碰实车 / 不烧录 | ✅ 车未就绪 |
| 项目隔离（不串 test17 / A 车） | ✅ 全程只针对 test16 / B 车 |
| 先读后设计 | ✅ 读完入口 + 法律 + 协作规范才动手 |
| **不改代码（军师红线）** | ⚠ **越界一次，已纠正**：角色纠正**之前**，我以工人模式写了 `脚本/调参/` 实现代码。纠正后**立即停手**，按 D1/D4 冻结为原型、在讨论稿 §5/§9 公开记录，此后不再改代码。**这是本次唯一越界。** |

## 8. 请检察官重点复核

1. **3 处错位判断是否成立**——尤其"架构错位"：仿真的路表跟表 vs v1.8 的已知 CAD 几何，我判为"不是一回事"是否准确。
2. **D2 新建 `control/ins_corr.c` 是否与 v1.8 §3"地标重置点"自洽**，会不会违反 v1.8 硬纪律"**每种元素只允许一套判据**"（旧屎山就是两套出口触发并行打竞态）。
3. **对齐参数键表**（待并入清单 §2）与 v1.8 §3 模块划分是否一致；`look_mm` 语义改为"软件前瞻量"是否恰当。
4. **冻结原型的 C 验证缺口**：接受"留到里程碑"，还是要求现在让工人补跑一次离线 `--sim` 再冻。

## 9. 下一步与阻塞

- **阻塞点**：PCB 打样 → 焊接 → 上电自检 → 驱动/编码器/IMU 打通 → **固件里程碑**。**当前无可交给工人的代码卡。**
- **里程碑触发时派卡**（从待并入清单派生）：`param.c 参数表 + 串口 SET/GET/RUN + LAP 遥测 + ins_corr 环`；并把冻结原型 **port 到对齐键名 + 复跑 `--sim` 补齐 C + 重生成存档到 gate 一致**。
- **v1.9**：待并入清单与其它 §3 改动届时**一次性并入**（走三道门）。

## 10. 附：未提交文件与建议 commit message（提交归工人）

```
docs: add tuner+firmware-contract discussion with D1-D5 decisions
docs: add pending-merge v1.9 list for S3 tuning/telemetry/autorun
docs: add work report for tuner advisor phase
scripts: add offline tuning prototype (frozen, sim-validated; C-phase re-verify pending)
```

---

*本报告由军师 2026-10-11 出具，未改动任何法律正文、未提交 git。*
