xigua862/SMARTCAR2/文档/讨论-调参迭代器与固件契约-20261011.md

# 讨论：调参迭代器与固件契约 · 2026-10-11

> 状态：**讨论稿**（未并入正文；**不动**《框架定稿 v1.8》）。作者：军师。
> 触发：用户纠正角色（军师 ≠ 工人），并指出上一轮开场提示词串到了 **test17 旧项目**。本稿**只针对 test16 / B 车**。
> 规矩：按 README §二，**签字前不拆任务卡、不让工人动手**；要改法律另交"要动哪几处"清单走三道门。

---

## 0. 一句话结论（先看这个）

- **现在这个项目 = test16 = B 车（微缩车 · 机器车循迹）**，处在 **PCB 阶段**（原理图完、布局中）；**固件一行没写**（`固件-STM32空壳/` 是旧车废弃件）。**法律 = 框架定稿 v1.8**（§3 已规划软件分层）。
- 你要的"一圈一次迭代自动调参器"**方向成立，但现在做早了，且与 v1.8 架构有 3 处错位**（§1）。
- **现在唯一能落地的 = 离线策略验证**（在 `开源工程/惯导矫正仿真/` 的参数结构上跑合成数据）；**实车那半（串口 SET/GET/RUN + 每圈 LAP 遥测 + AUTORUN）依赖还没设计的 `app/param.c` 与遥测链路 → 阻塞**（§2）。
- 我上一轮**误在工人模式**写了 `脚本/调参/` 的实现，**属越界**。本稿把它折成"已有进度"（§5），**去留交你定**，我不再自行改代码。

---

## 1. 三处错位（核心判断：先解决这个，再谈实现）

1. **阶段错位**：v1.8 §3 列了 `app/param.c(EEPROM/串口调参)`，但固件未开写。调参器的实车契约**没有对端** → 现在只能验证"策略"，不能接实车。
2. **架构错位（最要命）**：调参器原始参数表抄自 惯导矫正仿真 的"**建图圈 → 路表 → 跟表 + 直道航向矫正环**（`corr_kp/ki/kd`、`straight_min`、`corner_margin`）"模型；而 **v1.8 §3 主线是"里程 + 航向 + 已知 CAD 几何"为主、光电做位置修正 + 脱线保护、地标重置点**。两者不是一回事：
   - v1.8 **没有"学出来的路表"**；前瞻是**物理探头位 35~55mm + 软件权值表/曲率前馈**（§2.5），不是仿真的 `look_mm` 路表前瞻。
   - ⇒ `corr_*`、`straight_min`、`corner_margin`、`look_mm` 在 v1.8 里**没有一一对应物**，硬塞进契约会和固件真实参数表对不上。
   - ⇒ **串口 SET/GET 的键名必须 = 固件 `param.c` 的参数表**，不能 = 仿真键名。
3. **误差口径错位**：遥测的"线偏差 / 惯导横向偏差"在仿真是"相对路表投影"；在 v1.8 应映射为 **`line_pos` 归一化加权质心 err（§2.5 公式）** 与 **`odom` 相对已知 CAD 中心线的横向偏差**。口径不统一，RMS/P95 不可比。

---

## 2. 现在能做 vs 被阻塞

- ✅ **能做（不依赖固件）**：三阶段策略（A 诊断 / B 压偏差单参坐标下降 / C 加速）+ 安全阀 + 合成数据离线自证（不追噪声 / 能回退 / 能停止）。已跑出可用结果（§5）。
- ⛔ **阻塞（依赖固件开写）**：串口协议对端、每圈 LAP 结算与打印、AUTORUN、参数落 EEPROM、上电自检联动。→ 要等 **PCB 打样 → 焊接 → 固件里程碑启动**，且先在 v1.8 §3 把 `param.c` 的**参数表 + 协议定死**。

---

## 3. 对齐后的调参器设计（把原任务翻译到 v1.8 口径）

**参数契约**：以 v1.8 §3 的 `control/` 模块为准重落键名（提案，待签字 D3）：

| 原（仿真）键 | v1.8 对应模块 | 处置 |
|---|---|---|
| `kp_steer` `kd_steer` | `control/angle_pd` | 保留 |
| `k_gyro` | `control/gyro_damp` | 保留 |
| `kp_speed` `ki_speed` `kd_speed` | `control/speed_pid` | 保留 |
| `vmax` `vmin` `a_acc` `a_brake` | `control/profile` + `slowsafe` | 保留 |
| `look_mm` | 软件前瞻（权值表/曲率前馈，§2.5） | 保留，但**语义改为软件前瞻量**，非物理探头位 |
| `corr_kp/ki/kd` `straight_min` `corner_margin` `corr_on` | ⚠ v1.8 原无直道矫正环 | **保留（D2 已签字）**：固件新建 `control/ins_corr.c`（光电修正 / 地标重置环）承接这组键；`look_mm` 归软件前瞻 |
| `autorun` | `app/fsm` | 保留（上电跑几圈） |

**遥测契约（LAP 行）**：字段与顺序不变，但口径改 v1.8——线偏差 = `line_pos` err；惯导横向偏差 = `odom` vs CAD 中心线；补偿角 = 地标重置/修正环输出（若该环不建，此列填 0 并标注）。

**三阶段策略 + 安全阀**：**不变**（纯上层迭代逻辑，与架构无关）。

**硬约束**：C 阶段 `vmax_ceiling` **不是调参器能拍的**——受 v1.8 §7 物理上限约束（R200 → 1.1~1.4 m/s；齿比总比 >28 连 1.4 都到不了）⇒ 上限值来自**齿比/推车实测**，写进 JSON 时标注出处。

**白名单**：只允许 SET 上表控制键；**电机方向 / 限流(R_ISEN) / 引脚映射 一律禁改**（v1.8 §0.3 侧框架翻转要"电机方向翻一次"——那是**固件常量**，绝不进调参器白名单）。

---

## 4. "参数只走 JSON、代码不写死数值"

已按此实现：全部数值（车参 + 步长/阈值/权重/界限 + 合成系数）平铺在 `调参参数.json`，代码只留键名与阶段顺序。此原则与架构无关，**保留**。

---

## 5. 已有进度（冻结态原型 · D1 冻结 / D4 保留）

- **文件**：`脚本/调参/{调参迭代.py（约 1070 行、能跑）, 调参参数.json（键齐全、--check 80 键通过）, 调参日志.csv, 调参参数_best.json, 调参收敛.txt}`。**两份契约 `.md` 不再单独产出**（被 D5 取代，已并入《待并入v1.9-清单》）。
- **脚本状态：代码写完、不缺代码、不缺参数**——三阶段(A/B/C) + 安全阀 + 串口/sim/replay 三后端 + 日志 + ASCII 收敛曲线 + `--check` 都在。
- **已自证（`--sim`）**：`--check` 8 项通过；A 能判"惯导为主 / 瞬态尖峰在弯 / 往左漂"；B 单参坐标下降 **score 8.8 → 6.5 单调收敛**，且**正确拒绝 <1% 的噪声级改善**（**"不追噪声"成立**）。
- **⚠ 唯一缺口（冻结时如实记）**：C 阶段"升 vmax → 连续失败 → 二分退一半 → 回退"**代码已写但未复跑验证**——上次完整跑 C 被闸门(3.5)挡住没进；军师把 `p95_gate_mm` 调到 4.0 后**没再跑**。⇒ 现存 `调参收敛.txt / 日志 / best` 是 **gate=3.5、C 被跳过**那版，与 JSON 里的 4.0 **不一致**；"能回退 / 能停止"这条自证**差临门一脚**。
- **判断**：原型可复用，但键名仍是旧仿真名（`kp_steer`）；D3 对齐名（`kp_angle`）是**固件里程碑的前向契约**，原型按 D1 冻结**不需要现在改**。缺口复跑 + port 对齐键名 + 接串口，一并留给固件里程碑的工人卡。

---

## 6. 决策（✅ 已于 2026-10-11 签字，答案与后续见 §9）

- **D1**：调参器**离线部分现在继续推进**，还是**挂起**到固件里程碑再一起做？（建议：**冻结留档**，不占 PCB 关键路径。）
- **D2**：`corr_*`/`straight_min`/`corner_margin`/`look_mm` 这组仿真专属键——**在 v1.8 固件里新建"光电修正/地标重置环"**（则保留），还是**从契约删除**（调参器只管 speed/angle/gyro/profile）？
- **D3**：参数命名**以 v1.8 §3 模块名为准**（我按 §3 表重落键名），确认？
- **D4**：`脚本/调参/` 越界产物：**保留为原型 / 移讨论附件 / 删除**？
- **D5**：是否把"串口 SET/GET/RUN 协议 + 每圈 LAP 遥测 + AUTORUN"作为**增量并入 v1.8 §3**？（若要，我另交"要动哪几处"清单，走三道门，**绝不擅自改法律**。）

---

## 7. 抄什么 / 不抄什么（标到出处）

- **抄（算法/判据）**：`开源工程/惯导矫正仿真/开源说明/惯导控制思路.md` 的"改 yaw 不改 (x,y)、只修长直道、丢线冻结、补偿角限幅"→ 对应 v1.8 §3 **地标重置点**设计；`控制参数_跑图.json` 的**键名风格 + mm/mm·s⁻¹ 单位**。
- **抄（本项目法律）**：`框架定稿 v1.8` §3（分层/判据纪律/5ms）、§2.5（err 公式与符号标定）、§7（R200 物理上限）。
- **不抄**：仿真的"建图圈 + 路表跟表"整套（v1.8 用已知 CAD 几何，不学路表）；仿真的机械尺寸与 `CTRL_HZ=10000`（v1.8 是 5ms）；任何 **test17 / A 车**口径（README §四.8 项目隔离）。

---

## 8. 修订记录

- **2026-10-11**：军师建稿。起因＝用户纠正角色 + 提示词串到 test17 旧项目；本稿只针对 test16/B 车，未动任何正文。

---

## 9. 决策日志（用户签字 2026-10-11）

| # | 决策 | 签字 |
|---|---|---|
| D1 | 离线调参器 → **冻结留档**（不占 PCB 关键路径） | 冻结 |
| D2 | `corr_*`/`straight_min`/`corner_margin`/`look_mm` → **保留**；固件新建 `control/ins_corr.c`（光电修正/地标重置环）承接 | 保留 |
| D3 | 参数命名 **以 v1.8 §3 模块名为准**重落（angle_pd/speed_pid/gyro_damp/profile/ins_corr/fsm） | 是 |
| D4 | `脚本/调参/` → **保留为原型**（冻结态，不再改） | 保留为原型 |
| D5 | 串口协议 + LAP 遥测 + AUTORUN → **并入 v1.8 §3**（走三道门、先交清单） | 加吧 |

**据此的后续动作（军师，均不碰正文/git/代码）**：
1. 已按 D5 交出《`文档/待并入v1.9-清单-20261011.md`》＝"要动哪几处"清单（§3 增量逐条提案 + 出处 + 对齐后参数键表）。
2. 原任务要的"两份契约 .md"**被 D5 取代**（契约并入 §3 法律，不再单独产出散件）。
3. **点头结果（2026-10-11）：挂起**——增量**不现在并入**，留到固件里程碑与其它 §3 改动**一次性出 v1.9**（理由见清单 §0）。

**现在没有可交给工人的代码卡**：离线调参器已冻结（D1）、固件契约卡要等 **PCB → 固件里程碑**才触发。下一张工人卡＝固件里程碑启动时的 `param.c 参数表 + 串口协议 + LAP 遥测`（届时从待并入清单派生，并把原型 port 到对齐键名、**复跑 `--sim` 补齐 C 的二分/回退验证、重生成存档到 gate 一致**）。
