xigua862/SMARTCAR2/文档/框架定稿-B车C8T6-20261002.md

# B 车框架定稿 v1.8 —— STM32F103C8T6 自画板（微缩车 · 机器车循迹口径）

> 日期：**2026-10-03**　作者：军师　状态：**已并入 10-03 讨论结论**（合并来源见 §0.5）
> 取代：`v1.7（2026-10-02）`。v1.7 中**尺寸口径、灰度方案、分板策略**已被本版推翻，见 §0.5。
> 前提：**3D 打印免费**（实验室机器）+ **电机/轮子/编码器/负压风机/陀螺仪/电池全部是学长现成件**
> ⚠ 本版全部数字均标了出处：**【实测】/【算术】/【官方】/【待实测】**。**没标"实测"的尺寸不许当真值用。**

---

## 0. 一句话框架

**结构底板（纯结构 PCB，不装元件）＋ 上方电路板（核心 + 电源 + 传感接口，驱动可分可合）；
3S 直给驱动、逻辑走 12V→5V→3.3V；软件 5ms 一个控制周期，每 10ms 兼容；
循迹用外购 8 路模拟量灰度模块，前瞻可调 35~55mm；**惯导为主线、光电为辅**；每种赛道元素只允许一套判据。**

## 0.5 ★本版改了什么（接手人先看这张表）

| # | v1.7 写的是 | v1.8 改成 | 依据 |
|---|---|---|---|
| 1 | 轮距 75~85 / 总长 ≤130 / "板宽 88 比轮距略宽 ⚠" | **轮距 110 / 外到外 132 / 轴距 26 / 轮径 23 / 原车底板 88×66**；删掉那条错警 | 【实测】 |
| 2 | 编码器"装轮轴"→ `mm/count=πD/4096`，减速比不用知道 | **编码器带 5mm 齿轮 = 齿轮驱动**，该式作废 → **改推车 1m 标定为主** | 【实测】照片 + 【算术】 |
| 3 | 分板 = 主板 + 灰度子板；**自画灰度子板** | **结构底板（纯结构，不装元件）+ 上方电路板**；**灰度改外购模块，自画子板彻底作废**（原理图留档不打样） | 用户 10-03 拍板 |
| 4 | 灰度 = 8×ITR9909 + 4×LM393 + 逐路电位器 | **外购龙邱 8 路模拟量模块**（3.3~5V 宽压）；**接法见第 12 条（用「并出」）** | 用户 10-03 拍板 |
| 5 | 灰度排布"轻度收腰" pos=±5/±15/±27.5/±40，板宽≈88 | **作废**：档距以实物为准；前瞻改口径为"**探头连线→前轴**" | 采购模块后无意义 |
| 6 | 前瞻 45mm（按"板前缘→驱动轴"） | **探头连线 → 前轴 45mm，可调 35~55**（连续长槽）；基准从"驱动轴"改"前轴"、从"板前缘"改"探头连线" | 【算术】+ 用户 10-03 |
| 7 | 10ms 控制周期 | **5ms 为目标**（高速前提）；10ms 作降级兼容 | 【算术】 |
| 8 | 架构未定 | **惯导为主线、光电为辅**（用户原话）；元素识别以 里程+航向+已知几何 为主 | 用户 10-03 口述 |
| 9 | 底板/结构件材料未定 | **结构件用 PCB（2.0mm、哑黑）；碳板否决（导电）；3D 打印只做遮光件/法兰** | 开源 Micro_car README + 用户 10-03 |
| 10 | 5V 模块 ≥400mA | **灰度模块走 5V**（宽压下发射管更亮 → 直接对冲"喷绘布对比度"这个头号风险；且不占 LDO）→ 5V 需求 = 模块 ≈170 + LDO 输入 ≈120 ≈ **290mA** → **模块要 ≥400mA**。⚠ 供 5V ⇒ 8 路输出都是 5V 电平 ⇒ **8 路各一组分压** | 【算术】 |
| 12 | 灰度 = "1 ADC + 3 GPIO" 地址选通 | **★改用模块的「并出」模式**：**A0~A7 → PA0~PA7**（8 路 ADC，扫描 + DMA）——**采样 ≈10µs、通道间零偏斜**；"串出"方案（400µs + 偏斜）**作废**。代价：8 组分压（16 只电阻）+ 接口 6P→10P | 用户 10-04 拍板 |
| 11 | LDO 用 AMS1117-3.3 | **LDO = ME6211C33M5G-N**（SOT-23-5，按实际画的原理图）。3.3V 只喂 MCU/IMU/编码器/蜂鸣 ≈**120mA** → 够（下单前核一眼 datasheet 的 Iout） | 用户 10-03 原理图 |

---

## 1. 结构路线

### 1.1 ★实测真值（覆盖所有旧假设，**别再引用旧数**）

| 项 | **真值** | 怎么来的 | 用途 |
|---|---|---|---|
| 左右轮中心距（轮距） | **110 mm** | 【实测】 | 差速比、抗侧倾 |
| 单轮宽 | **22 mm**（×2） | 【实测】 | 底板横向净空 |
| 外侧面到外侧面 | **132 mm** | 【实测】（110+22 自洽 ✓） | 整车宽（规则上限 300） |
| **轴距**（同侧前后轮中心） | **26 mm** | 【实测】（孔列表 0→26 自洽 ✓） | ★**转向中心 = 前轴后 13mm** |
| 轮径 D | **23 mm** | 【实测】 | 周长 72.26mm；标度 |
| 原车底板 | **88 × 66 mm**（88 在轮轴方向） | 【实测】 | 88 = 110−22 = **两轮内侧面净空** |
| 侧框架孔位 | y = **0 / 9 / 26 / 35 / 49**，φ2 通孔，位于中线 | 【实测】 | 0↔26 与 9↔35 各差 26 → **轴承孔是哪一对待确认** |
| 侧框架齿轮 | 轮上 **22mm(44T)** / 电机 **5mm(10T)** / 编码器 **5mm**，**0.5 模，合计 54，中心距 13.5mm** | 【实测】+【算术】 | 一级齿比 4.4:1 |
| 电机型号 | **SEEKFREE BN30-HSA** | 【实测】照片丝印 | 查内部减速比 |
| 陀螺 | **逐飞 IMU660RC**（LSM6DSV16X），8P | 【实测】照片 | ✅ 型号风险解除 |
| 电池 | **3S 11.1V 2000mAh，63×18×15mm**，带平衡头 | 【实测】 | 已有；底板硬输入 |
| 赛道布 | **黑色哑光喷绘布（550 布）+ 25mm 白线** | 规则原文 | 见 §4 |

**⚠ 未确认**：`0↔26` 还是 `9↔35` 才是轴承孔。**两种情况下前瞻算术完全一样**（轴距 26、转轴在前轴后 13mm），只有"底板上绝对坐标"差 9mm。画板时认准"轮轴穿过去的那一对"。

### 1.2 底板设计约束（分层）

```
（地面）
  0 ~ 6mm    只有灰度模块探头——别的任何东西不许进来
  6 ~ 18mm   模块本体（约 12mm）
  11.5mm     ← 轮轴（轮径 23 ÷ 2）
  ↑ 以上才是"可以放元件"的区间
```

| 项 | 定稿值 | 依据 |
|---|---|---|
| **结构底板** | **2.0mm PCB，双面铺铜，哑黑阻焊，不装元件** | 材料结论见 §2.1；哑黑=遮光 |
| **下表面规则** | **零元件、零引脚**；朝下排针剪平 ≤0.5mm；下表面离地 **≥5mm** 且完全平坦 | 学长车"底下裹胶带"的教训 |
| 电路板 | 挂侧框架**上排孔**；核心与驱动可分可合（见 §2.1） | 用户 10-03 |
| 结构底板挂点 | 侧框架**下排孔** | 用户 10-03 |
| **舌板（传感器臂）** | 长在前方，**开窗**让模块穿过；探头面落 6mm；**两条平行长槽**调到 35~55 | §2.5 |
| **底板横向** | **87~88mm**（不是 300——300 是规则上限）；每侧留 0.25~0.5mm 公差 | 【算术】110−22=88，零间隙会磨 |
| **板框（2026-10-04 定）** | 长 **66mm**、宽 **88mm**（用户 10-04 加宽；**推荐实际做 87**，每侧留 0.5mm 磨量 —— 88 是两轮内侧面的理论线，零间隙会磨轮子）；**后缘与框架后缘平齐**，超长的 11.5mm **全部堆在车头** | 侧框架实测 **长 54.5mm**，第 1 孔距框架前缘 **3mm** |
| **安装孔 X** | **= 框架孔的横向位置（⏳待实测）**。量法：**框架孔中心 → 轮子内侧面的距离**：≥3mm → 普通圆孔；<3mm → 改**从板边开口的槽** | 板宽 87 ⇒ 板边在 ±43.5，孔太靠边会崩 |
| **安装孔 Y（距板前缘）** | **14 / 28 / 37 / 54 / 63**（★ 2026-10-04 因**侧框架前后翻转**而更新，旧值 14.5/23.5/40.5/49.5/63.5 作废）| 板孔 **φ2.2~2.4**；配 **M2×8~10** + 六面螺母。第 5 孔距板后缘 **3mm** → 加 M2 平垫 |
| **由板框推出** | 前轴 **28** / 后轴 **54** / 转向中心 **41** / **探头连线 = 板前缘前 17**（可调 −7~−27，对应前瞻 35~55）| ⇒ **舌板要从板前缘往前伸 ≥17mm** |
| **自洽校验** | 框架前后边距 2.5/3（翻转后对调）；轴距 54 − 28 = **26** ✓ 与实测一致 | 数据可信 |
| ★ **侧框架前后翻转**（2026-10-04 用户决定）| 翻转后：**编码器靠近车头、电机靠近车尾** ⇒ 编码器→前·核心、电机→后·驱动，**两条线不再交叉** ✓ | ⚠ 固件里**"电机方向"翻一次**（两个一起）；编码器"左右一侧取负号"**不用变**（电机与编码器同在一框，相对关系未变）|
| ⏳ **仍缺** | **框架孔的横向位置 X**（距车体中心线多远）| 板上 5 孔的 X 必须与之一致 |
| 驱动轴→车尾 | 旧"≤50mm"**作废**（那是对着驱动轴量的）。按转轴量：框架尾在后轴后 14mm，后悬约 27mm → 偏摆 27²/400 = **1.82mm，可忽略** | 【算术】 |
| 电池位置 | 尽量靠后、贴低；尺寸 **63×18×15** | 配平前伸力矩 |
| 陀螺仪位 | 离风机 ≥40mm；四角减震柱；板面印方向箭头 | 开源作者：扇叶共振→螺丝松→陀螺漂 |
| 球脚 | **先不加**，按 §1.4 判据实测后再定 | 打印免费 |

### 1.3 ★编码器与标定（本版重大更正）

**v1.7 说"编码器已确认装在轮轴"→ `mm/count = πD/4096`、减速比不用知道。实测推翻：编码器带一个 5mm 齿轮，是齿轮驱动的。**

```
编码器 1024 P/R × 4(正交) = 4096 count / 编码器转
若编码器 5mm 齿轮咬轮上 22mm 齿轮 → k = 编码器转数/轮转数 = 22/5 = 4.4
  ⇒ 每轮转 = 4096 × 4.4 = 18022 count  ⇒ mm/count = 72.26/18022 = 0.00401 mm
  ⇒ 1.2 m/s 时计数率 = 299 kHz；3 m/s 时 = 748 kHz
若 k = 1（真的在轮轴上）⇒ mm/count = 0.01764；1.2 m/s 时 68 kHz
```

**处理（不要推导，直接标定）：**
1. **把"推车 1m 数脉冲"从"校验"升为"主标定"**：`mm/count = 1000 / 推1m的计数`。这样 k 和 D 都不必知道，齿轮咬错也算对。
2. 仍需**量轮径 D**（软尺绕胎一圈 ÷ π，绕 3 次取平均）——用于牵引力换算与交叉检查。
3. ⚠ **必测**：推车 1m 时顺便看**实际计数率**。**>200 kHz 就要换方案**（TIM 编码器接口可能吃不下；k=4.4 时 1.2m/s 就 299kHz）。
4. ⚠ 轮轴/齿轮编码器的固有代价：**打滑时里程虚高** → 圆环/终点判据必须叠**陀螺角度积分**兜底。

**★ 编码器那头的线序（实测丝印，6P 插座）**：
```
1 = GND    2 = VCC    3 = LSB(A相)    4 = DIR    5 = Z相    6 = B相
```
⇒ **用「正交模式」，只接 4 根**：**A相(3) + B相(6)**；**DIR(4) / Z相(5) 悬空**（DIR 是"脉冲+方向"模式下的方向线；Z 是每圈索引脉冲，以后做绝对里程再用）。

| | 1 GND | 2 VCC | 3 A相 | 4 DIR | 5 Z相 | 6 B相 |
|---|---|---|---|---|---|---|
| **左编码器** | GND | **3.3V** | **PA15**（TIM2_CH1） | 空 | 空（可留焊盘） | **PB3**（TIM2_CH2） |
| **右编码器** | GND | **3.3V** | **PB4**（TIM3_CH1） | 空 | 空（可留焊盘） | **PB5**（TIM3_CH2） |

⚠ 供电 **3.3V**（输出电平跟随 VCC）；⚠ **1/2 脚别接反**（烧编码器）→ 用**带防呆扣**的 6P 座；⚠ **针距要量实物**（1.0/1.25/1.5mm 都可能）。

### 1.4 前球脚判据（30 秒测完，别提前设计）

```
车放平，松手 → 看车头是否下沉、灰度模块前缘压到线
  压到 → 先只做两件事：① 电池后移 ② 缩减前伸
         仍压头 → 才加支撑，且用【小滚轮】不用万向球
         第三触点必须落在驱动轴中线上
```

---

## 2. 硬件框架（画板的直接输入）

### 2.1 分板策略 + 材料结论

| 板 | 内容 | 为什么 |
|---|---|---|
| **结构底板** | **2.0mm PCB，双面铺铜，哑黑阻焊，不装任何元件** | 承力 + 前伸舌板 + 遮光；不装元件 ⇒ 可以做得又低又薄，"下板贴地"的问题自动消失 |
| **电路板（上方）** | 核心（C8T6+晶振+SWD+丝印+IMU+灰度接口）+ 电源；**驱动可分可合** | 挂侧框架上排孔 |

**驱动要不要单独一块板？**（**唯一未拍板项**）先按**一块板**画（严格分区），只有满足以下任一条才拆成两块：
- 布局布不下；② 电机噪声串进 ADC（灰度读数抖）；③ 温升超（手摸烫）。

若拆：**功率级（VM/AT8236/大电容/降压模块）留在驱动板**，过板只走 `5V + GND + 4 路 PWM`
（≈0.3A）→ 用一个 **2×6 或 2×5** 带锁扣排针，**地针 ≥3 根**，PWM 串 22~47Ω，排线不并行电机线束。

**★材料结论（推翻 v1.7 的 3D 打印底板）：**
- **结构件用 PCB，不用碳板、不用 3D 打印。**
- 依据①（开源原文，`开源工程/微缩车模型-Micro_car/README.md` §8）：**"能用碳板用碳板，不要用 3d 打印……不想花钱直接打 pcb 替代碳板"**——作者反对的是 3D 打印，PCB 是他并列推荐项；
- 依据②：**碳纤维导电**，旁边就是模拟线/5V/传感器，摩擦即短路，且要全程绝缘；
- 依据③：**碳板唯一的优势是比刚度（轻），而校赛不称重不罚时 ⇒ 该优势等于零**；
- 依据④：PCB 可顺手做哑黑阻焊（遮光）、丝印、开窗，且打样免费。
- **3D 打印只做它不可替代的部分**：遮光围裙、法兰、螺纹座（黑色 PETG/尼龙，壁厚 ≥2mm）。

### 2.2 电源树

```
3S 锂电 11.1~12.6V（已有 2000mAh，63×18×15）
 └ XT30 ── TVS ──【VM 轨保险：一次性慢熔贴片保险丝 **10A**（2410，6.1×2.6mm）】
    ├─【功率轨 VM = 12.6V 直给】→ AT8236 ×2(+1 预留) → 电机 / 风机
    │     就近：470µF/25V ×1 + 0.1µF ×3；OUT→端子间 100nF + 磁珠
    └─【逻辑轨】→ 12V→【5V，必须 5V 不是 4.7V】降压模块
          ├ 灰度模块 VCC（≈170mA）+ **有源蜂鸣器（≈30mA，Q1 低边驱动）** ← 都走 5V：不占 LDO
          │     └ AO(5V) ── 1k ──┬── PA3(ADC1_IN3)；1.5k + 100nF 到 GND
          └ ME6211C33M5G-N（3.3V）→ C8T6 + IMU + 编码器 + 上拉/LED ≈120mA
   地：功率地与逻辑地单点相连（0Ω 或磁珠）
```

**五条硬约束**
1. **5V 预算 ≈320mA**（灰度模块 ≈170 + LDO 输入 ≈120 + **有源蜂鸣器 ≈30**）→ **降压模块要能连续 ≥400mA**。⚠ 买 **5V 不买 4.7V**。
2. **3.3V ≈120mA**（MCU/IMU/编码器/上拉/LED）→ **ME6211C33M5G-N** 即可；LDO 耗 (5−3.3)×0.12 = **0.2W** ✅。⚠ 严禁 RT9013（250mA，余量不足）
3. **严禁 LDO 直吃 12.6V**：`(12.6−3.3)×0.12 = 1.1W` → SOT-223 热保护。**降压那一级不能省。**
4. **严禁 4S**（入口 TVS 16V，4S 满电 16.8V 会长期导通）。每颗 AT8236 **按手册公式 `ITRIP = VREF/(10·R_ISEN)` 把限流设到 3A** → **AT8236N（内部 VREF 3.3V）+ R_ISEN 0.11Ω/≥1W(2512)**；⚠ 手册给 ISEN 的**绝对最大只有 0.5V ⇒ R ≤ 0.167Ω**。详见 `文档/AT8236-照这个画-20261003.md`
5. **开关可以留**（旧板 `SW2` 照搬）：板在**上层**，开关引脚朝下是伸进 12mm 夹层、**碰不到地面**——"开关在底部会刮蹭"那条教训**只适用于底层板**。（v1.8 曾错误建议"取消开关"，**已撤回**。）只需保证引脚长度不顶到下层板；且**开关只串逻辑轨**（~140mA），别串 VM（那要过 4~6A）。

### 2.3 引脚分配（48 脚，锁死）

| 功能 | 引脚 | 5V 容忍 | 备注 |
|---|---|---|---|
| **灰度 A0~A7（并出）** | **PA0~PA7**（= ADC1_IN0~IN7） | ❌ 非 FT | ★ **用模块的「并出」：8 路模拟同时输出** → 8 根全进 ADC，**扫描 + DMA** 一次搬 8 个值。**采样 ≈10µs、通道间零偏斜**（比"串出"的 400µs 快约 40 倍，settling / 位图失真的问题一并消失）。⚠ 模块供 5V ⇒ 每路是 5V 电平 ⇒ **8 路各一组 `1k/1.5k 分压 + 100nF`**（16 只电阻 + 8 只电容） |
| 电机 左 IN1/IN2 | PA8 / PA9 | ✅ | TIM1_CH1/CH2，四路独立 PWM |
| 电机 右 IN3/IN4 | PA10 / PA11 | ✅ | TIM1_CH3/CH4 |
| 风机（预留） | PB1 / PB2 | ⚠ **PB1 非 FT** | 留焊盘不贴件，见 §6 |
| 左编码器 A/B | **PA15 + PB3** | ✅ | TIM2 **部分重映射** CH1/CH2 |
| 右编码器 A/B | **PB4 + PB5** | ✅ | TIM3 **部分重映射** CH1/CH2 |
| 陀螺仪 SPI2 | PB13 SCK / PB14 MISO / PB15 MOSI / PB12 CS | ✅ | **不用 I2C**（会抢唯一遥测串口） |
| 陀螺 DRDY/中断 | PB8 INT1 / PB9 INT2 | ✅ | INT1 做 DRDY 外部中断（降积分抖动） |
| 遥测 USART1 | **PB6 TX / PB7 RX（必须重映射）** | ✅ | 115200；TX 走 DMA |
| **蜂鸣** | PB10 | ✅ | **有源 5V 蜂鸣器**（2.4kHz）：PB10 → 1kΩ → SS8050 基极；集电极接蜂鸣器 −、+ 接 5V；D2 1N4148W 续流 + 10k 下拉。⚠ **有源 = 自带振荡 ⇒ 固件只能开/关，不能用 PWM 调音** |
| **按键 ×2** | **PC13 = 正式发车键** / **PB0 = 测试开始键** | PB0 非 FT | 接 GND + 内部上拉。★ 两个键的语义见 §3 |
| **状态 LED ×3** | **PC14 / PC15 / PA12** | — | **串 470Ω**（3.3V 下 ≈2.8mA）。⚠ PC14/PC15 是弱驱动脚（输出速度上限 2MHz）→ 只点 LED 没问题 |
| **SWD** | PA13 / PA14 | — | **必须留 4P 座** |
| BOOT0 | 10k 下拉 + 跳线 | — | 串口下载用 |
| 空闲 | **PB11** | — | 全车就剩这一个空脚（**PA4~PA7 已给灰度的 A4~A7**，v1.8 那句"PA4~PA7 空闲"已过时）|

**★IMU 座 8P 针序 —— 照实物丝印排，别自己排**（照片实测）：
```
VCC / GND / SCL-SPC / SDA-SDI / SA0-SDO / CS / INT1 / INT2
⚠ SA0/SDO 在 SPI 模式下是 MISO，严禁接地或接 3V3
```

**★必踩的四个软件坑（画板不管，固件必须做）**
1. `PA15 / PB3 / PB4` 默认是 JTAG 脚 → 初始化第一件事**禁 JTAG 保留 SWD**（`AFIO->MAPR` SWJ_CFG=100），否则两个编码器没读数。
2. **TIM1 是高级定时器，必须手动开 MOE**（`__HAL_TIM_MOE_ENABLE`）→ 忘了就是"程序在跑、电机不转"。
3. **USART1 用 PB6/PB7 必须重映射**（`AFIO->MAPR` 的 USART1_REMAP），否则遥测是空的。
4. 编码器标度**用推车 1m 标定**（§1.3），不要写死 `πD/4096`。

### 2.4 灰度：外购模块的采购与验收（**原自画子板彻底作废**）

> 原 8×ITR9909 + 4×LM393 + 逐路电位器的子板方案**作废**，原理图**留档不打样**（沉没成本不是继续的理由）。
> ⚠ 但**主板必须自画**——规则第 3 条：主控/电机驱动/传感器三者至少其一必须自主开发并印丝印。

**采购（龙邱 8 路模拟量款，用户 10-03 拍板）**，买前问客服 8 条 + 验收阈值：

| 项 | 通过 | 边界 | 否 |
|---|---|---|---|
| **最小检测高度** | ≤6mm 可用 | 6~10mm（要重算几何） | >10mm → 与 6mm 地基正面冲突，方案级 |
| **地址切换 settling** | **≤20µs** | 20~100µs（1.2m/s 走 0.19~0.96mm） | **≥500µs 直接否** |
| 档距 | 10~12mm（首选 11） | 12.6mm | <10 串光；≥25 踩"中心对 > 线宽" |
| 输出电平 | — | **5V 供电（我们的方案）⇒ 8 路输出都是 5V 电平 ⇒ 8 路各一组 1k/1.5k 分压** | 改供 3.3V 可免分压，但发射管变暗 |
| 路数 | 8（模拟量最佳） | 8 路数字选通 | 4 路 → 定位精度不够 |

**8 问话术**：路数 / 档距（要板框图与标尺）/ **最小检测高度** / 输出电平 / 波长 / **地址切换 settling** / 板框尺寸 / 供电范围与总电流。

**买回来后必做的三件事**
1. 量**安装耳平面 → 探头面**的高度（倒推结构底板的分层高度）；
2. **喷绘布对比度实测**（最高优先级，见 §5）：按实际供电 **5V**，在布上分别压白线与黑底，量 **AO** 输出差值（分压后在 PA3 侧读）；
3. 上电自检：黑底应全 0、跨白线应满量程，不对就蜂鸣。

**判据体系随之升级**（方案级）：从"数字 0/1 + Σ(w·s)/Σs" → **每通道归一化后加权求位置**
```
p_i = (v_i − v_black) / (v_white − v_black)     ← 每通道滑窗极值自适应
err = Σ(w_i · p_i) / Σ p_i
```
~~轮询时间预算（**串出**方案）：每通道 50µs → 8 通道 400µs~~ → **改用「并出」后：8 通道 ADC 扫描 + DMA ≈10µs**，1.2m/s 只走 **0.01mm**，**且零偏斜**（"settling ≤20µs"那条前提不再需要）。

### 2.5 前瞻、安装与循迹几何

**★口径（两条都改了）**：约束是"**探头连线 → 前轴 = 45mm**"，不是"板前缘 → 驱动轴"。
理由：① 成品模块的探头**不在板前缘**（内缩几毫米）；② 转向中心是**轴距中点**（每侧两轮同速），不是驱动轴。

**转向中心 = 前轴后 13mm**（= 轴距 26 的一半）⇒ `d = L + 13`，稳态跟弧偏差 ≈ `d²/(2R)`：

| L（探头→前轴） | d | R200 偏差 | 1.4 m/s 预览 | 2.0 m/s | 2.5 m/s |
|---|---|---|---|---|---|
| **35（可调下限）** | 48 | 5.76mm | 34ms | 24ms | 19ms |
| 45（设计值） | 58 | 8.41mm | 41ms | 29ms | 23ms |
| **55（可调上限）** | 68 | 11.6mm | 49ms | **34ms ✓** | 27ms |
| 65（硬上限） | 78 | 15.2mm | 56ms | 39ms ✓ | 31ms |

参考线：国赛 **35ms** / 区赛 **43ms**。⇒ 55mm 覆盖到 **2.0 m/s**；65 覆盖到 2.4；**3 m/s 要 92mm，物理上做不到 ⇒ 高速那段交给软件前瞻**（探头权值表 + 曲率前馈）。

**调参板做法（6 条）**
1. **两条平行长槽**（不是三档圆孔）：行程 **20mm**（35↔55），可连续调；
2. 槽宽 **2.2~2.4mm**（φ2 孔配 M2 是零间隙，槽必须留公差）；
3. 端部**加宽成"桨叶"**（两侧各放宽 5~8mm）补偿开槽削弱；
4. **两颗 M2 都拧紧** + 弹簧垫圈 + **螺纹胶**（单螺丝会绕轴转）；
5. **丝印三样**：一条**"前轴线"** + 35/40/45/50/55 **刻线** + 安装方向箭头；
6. 每次改档**记下来**（L、速度、现象）——调参要可复现。

> ⚠ **更正**：v1.7 的排布方案（收腰 ±5/±15/±27.5/±40、板宽≈88、捕获 ±52.5）**整节作废**——那是对自画子板定的，现在模块是买来的，档距以实物为准。
> **"悬臂会下垂"也已更正**：按 2.0mm FR-4、伸 36mm、尖端挂 20g 算，**静态下垂 0.0026mm（占 6mm 地基 0.04%，可忽略）**，一阶弯曲共振 ≈700~800Hz（远高于齿轮激励 ~17Hz）。
> ⇒ **长度几乎不要钱，真正的敌人是"接头的夹紧刚度"和"模块自身固定"**。侧梁的真正价值是提高共振频率，不是抗静载。

**代码侧两条硬要求**
```c
/* 用真实位置加权（位置以实物档距为准），改板/换模块必须同步改这张表 */
err = Σ(IR_POS[i] * p_i) / Σ(p_i);       /* Σp == 0 → 丢线分支 */
```
1. 归一化后的加权中心，**不能再用 `(i-3.5)` 索引式**；
2. **符号标定**：板面印 `FRONT →`；首次上电把线放车体**右侧**，err 应为正，为负就翻 `IR_SIGN_FLIP`。装反/镜像安装是"越纠越偏"的头号来源。

### 2.6 PCB 分区 + 结构底板规则

```
【结构底板（无元件）】
 ① 下表面：零元件零引脚、完全平坦、离地 ≥5mm
 ② 双面铺铜（当抗弯翼缘 + 屏蔽）
 ③ 哑黑阻焊（遮光）
 ④ 丝印：前轴线 / 前瞻刻线 / 方向箭头
 ⑤ 舌板开窗 + 两条长槽；前端与上方电路板用铜柱锁一次（悬臂变夹层梁）
 ⑥ 安装孔：跟侧框架下排孔（φ2 需配螺母/六角螺母 6×6×6）

【电路板】
 ① 接插件全部走板边
 ② 功率区与逻辑区分置两端；走线 ≥1.2mm@1oz 每安培，铺铜+开窗加锡
 ③ 晶振贴 MCU、下方包地、禁走信号线
 ④ IMU 区离风机 ≥40mm、四角减震柱、排针立装可拆
 ⑤ 星形接地点：功率地/逻辑地/灰度地 在输出电容负极汇一点；**灰度模拟回线不穿功率区**
 ⑥ 板边留 4 个 2.54 测试盘：3.3V / VM / GND / 空闲 ADC
 ⑦ **丝印："2026 机器车循迹 + 队伍名"**（规则硬要求，检录要看）
```

---

## 3. 软件框架

```
周期与中断
  TIM1  20kHz     电机 PWM（四路：方向靠电平、大小靠占空比）
  TIM2/TIM3       编码器硬件正交计数，不开中断
  SysTick **5ms** ★唯一控制周期（10ms 为降级兼容）：读灰度→里程→误差→判据→三环→限幅→写PWM
  USART1 TX DMA   遥测，绝不阻塞控制

分层
  drivers/      ir8.c  encoder.c  motor.c  imu.c  uart_dbg.c  buzzer.c  key.c
  middleware/   line_pos.c(归一化加权)  odom.c(里程)  ring.c(圆环5态)
                cross.c(十字)  finish.c(斑马线终点)
  control/      speed_pid.c  angle_pd.c  gyro_damp.c  slowsafe.c(弯道减速)  profile.c(速度剖面)
  app/          fsm.c  param.c(EEPROM/串口调参)  selftest.c
```

**★架构主线：惯导为主、光电为辅**（用户 2026-10-03 原话）
- 元素识别（十字 / 圆环 / 终点 / 斑马线）以 **里程 + 航向 + 已知赛道几何（CAD）** 为主，光电做**位置修正 + 脱线保护**；
- ⇒ 灰度选型不追求亚档距精度；判据延迟的时间偏斜问题**降级**；
- **最大风险 = 漂移累积** → 必须设计**地标重置点**：过十字/斑马线时用光电重新对齐航向或里程；
- 标定升为主线：① 上电静止零偏 ② **积分必须用实测 dt**（禁假设固定节拍）③ 里程 = 推车标定 + 打滑修正；
- IMU 只读 **Z 轴角速度 + 航向角**，别把六轴全量拉进 5ms 周期。

**判据纪律**
- **每种赛道元素只允许一套判据**，多余做成默认关闭的编译开关；
- **禁止 `while(1){ motor_stop(); }` 死循环停车**，失线一律走状态机超时；
- **短暂跳变保持上一帧**（开源做法：60ms），丢线/元素**按里程判**而不是按帧数；
- **元素互斥**：所有元素入口都带 `&& 其它状态==0`（直接消掉一大类误判）；
- **过元素后强制低速一段**（开源做法：500 拍 ≈ 250 拍@5ms）——这是"提速后不失控"的关键保护。

**加速与压缩圈速（规则允许，但按顺序来）**
- 成绩**按行驶距离积分**、时间只作同分加赛 ⇒ **先保不脱线跑完全程，再谈圈速**；
- 速度剖面 = ① 按曲率取 `v_曲率=√(μ·g·R)` ② **反向传减速** ③ **正向传加速**（开源依据：国赛把逐点速度烘进 `nav_path.h`，96 段，a+=3000 / a−=5000 cm/s²）；
- ⚠ 那套 a+≈30 m/s² 是**负压**（正压力×4.4）撑出来的；无负压时 `a ≤ μ·g ≈ 6~10 m/s²`；
- **加速会让车抬头 → 传感器离地变 → 阈值漂** ⇒ 重心靠后靠低 + **加速度限幅（软启动）** + 阈值留余量。

**★ 两个按键的语义（用户 2026-10-04 定）**
- **PC13 = 正式发车键**：进"读秒"→ 运行（正式流程）
- **PB0 = 测试开始键**：进 **测试模式** —— 电机 `IN1=IN2=0`（**滑行 + 休眠**，AT8236 自动进低功耗），**不循迹、不采集传感器用于控制**，只**等串口指令**来采集数据（这时的串口纯做调试/取数）
- **状态 LED ×3（PC14 / PC15 / PA12）** 用来指示：待机 / 读秒 / 运行 / 测试 / 急停

**上电自检（蜂鸣 + 串口，5 秒内）**
① 灰度逐路：黑/白极值是否可分 → 不对立刻叫；② 手转两轮验编码器方向；③ IMU WHO_AM_I + 静止零偏 200 次平均。

---

## 4. 赛道与规则事实

| 项 | 值 | 来源 |
|---|---|---|
| 场地 | 5m × 5m，**黑色哑光喷绘布（550 布）** | 规则 |
| **白线宽** | **25mm** | 规则 |
| 最小半径 | **R200**（A 区四连 S 波）= 全场速度瓶颈 | 赛道图 |
| 其他 | B R500 / C 十字 R390+1342×2132 / D R500 / **E 区 4 个 R300 相切圆环** / F R495-500 / R665 | 赛道图 |
| 起终点 | S↔G 400mm，斑马线中心距 50mm | 规则 |
| 单圈 | 粗估 12~18m（两圈 24~36m） | 【算术】 |
| **规则硬点** | 垂直投影宽 **≤300mm**（唯一宽度条款，**不限长**）；**主控/传感器不限制**；**"主控/电机驱动/传感器至少其一"的板必须自主开发并印"2026 机器车循迹+队伍名"丝印**；严禁买成品车模 | 规则原文 |
| **复用件合规话术** | "车体自画 3D 打印、电控自画带丝印、固件自写；仅侧框架组件（含轮/电机/编码器）为学长件复用" ⇒ 属零件复用，非"整车现成作品" | 规则 + 用户 10-03 |
| 判分 | 15 分钟内 2 次发车；**按行驶距离积分**、时间排名；脱线判定"接触地面的车轮不允许明显全部出现在循迹线同一侧" | 规则 |
| **不要求重量** | ⇒ 减重优化全部撤销；电池 3S 2000mAh 沿用 | 用户 |
| 参考文件 | `文档/赛道情报-黑底白线5m-20261002.md`、`文档/赛道图-5000x5000-黑底白线.png` | |

---

## 5. ★待实测清单（按优先级；**前 3 条阻塞后续工作**）

| # | 测什么 | 怎么测 | 影响 |
|---|---|---|---|
| **1** | **★喷绘布 940nm 对比度** | 灰度模块**供 5V**，布上压白线 / 压黑底，量 **AO** 输出差（分压后在 PA3 侧读） | 布 = 白 PVC + 黑墨，**940nm 可能穿透** → 黑态地基塌。不过关则方案级重做 |
| **2** | **★BN30-HSA 内部减速比** | 逐飞产品页/客服（或数内部齿轮） | 总比 = 内部比 × 4.4。**总比 >28 连 R200 的 1.4m/s 都到不了**；空载会掉，建议 ≤20 |
| **3** | **★灰度模块最小检测高度 + 地址切换 settling** | 问客服；拿到实物用示波器实测 | 决定方案是否成立（阈值见 §2.4） |
| 4 | 轮径 D | 软尺绕胎一圈 ÷ π，绕 3 次取平均 | 牵引力换算 + 标度交叉检查 |
| 5 | 编码器咬合关系与实际计数率 | 推车 1m，读计数与波形 | >200kHz 要换方案（§1.3） |
| 6 | 侧框架上下排孔**离地高度** + 两框架**内侧间距** | 卡尺/带尺拍照 | 决定结构底板与电路板的分层高度、底板横向 |
| 7 | 模块"安装耳平面→探头面"高度 | 拿到实物量 | 倒推分层高度 |
| 8 | **a_加 / a_减** | 找直道测 0→v 的时间与距离 | 速度剖面用，别抄别人的 |
| 9 | IMU 静止漂移 | 上电静止 10s 看航向漂多少 | **<1° 才成立"惯导为主线"**，不过则降级 |
| 10 | 电池内阻 | 顶住轮子看瞬间跌压 | 跌 >1V 要换 |
| 11 | N30 实际 DCR | 万用表电阻档 | AT8236 限流阈值 = 12.6/DCR 的 60% |
| 12 | 5V 模块纹波 | 示波器 | 纹波直进陀螺 → Z 零偏漂 |
| 13 | 震动断电定位 | 万用表夹 3.3V 轨，抖车架看掉压 | ★先做这个，否则新板新电机照样断 |
| 14 | 校赛规则复核 | 问主办 | 限宽/限长、是否允许成品传感器模块 |

---

## 6. 负压：留退路，先不装

- 风机是学长的（0 元）+ 扇叶/支架打印 0 元 → 边际成本只剩 1 颗 AT8236 + 2.5A 电流 + 半天调试；
- **底板现在就开圆孔 + 留 4 个螺丝孔**，压边处留平（密封圈 + 纳米胶）；
- 板上**第 3 颗 AT8236 留焊盘不贴件**，PB1/PB2 引到排针；
- **装不装 = "要不要压缩圈速"的开关**：负压把正压力抬 ~4.4 倍 → 加减速上限从 6~10 提到 ~30 m/s²（§3）。若弯道打滑/出弯加速是瓶颈就装；
- ⚠ 它也是**全车最大震动源**（开源作者：螺丝共振→陀螺漂）；
- **校赛前夜绝对不装**。

---

## 7. 电机与齿轮（★提速旋钮在这里）

| 项 | 值 | 判断 |
|---|---|---|
| 型号 | **SEEKFREE BN30-HSA** | 内部减速比**待查** |
| 额定 11.1V / 空载 33000rpm | — | **必须减速箱**，直驱不可能 |
| 堵转力矩 200gf·cm = 19.6mN·m | — | 经减速后轮上扭矩 **过剩 13 倍** → 别再找"大扭矩电机" |
| 堵转"<15A" | — | 超 AT8236 峰值 6A → **必须设 3A 限流** |
| 齿轮（实测） | 轮 **22mm/44T**、电机 **5mm/10T**、**0.5 模、合计 54、中心距 13.5mm** | 一级齿比 **4.4:1** |

**★提速旋钮 = 在 0.5 模"合计 54"家族里换配对**（中心距恒为 13.5mm ⇒ 机械不用动）：

| 配对 | 齿比 | 作用 |
|---|---|---|
| 44 + 10（现在） | 4.4 : 1 | 扭矩最大、最慢 |
| 40 + 14 | 2.86 : 1 | — |
| 34 + 20 | 1.70 : 1 | 最快 |

理论最高速（空载，D=23）：`v ≈ 39.8 / 总减速比` m/s
→ 总比 13 ⇒ 3.06 m/s；**20 ⇒ 1.99**；**28 ⇒ 1.42（刚好只够 R200）**；44 ⇒ 0.90（**连 R200 都跑不到**）。

**花钱优先级：胎皮 > 电池 > 别的都别买**（抓地是唯一买得到的物理上限）。

---

## 8. 修订记录

- **v1.8（2026-10-03，当前版）**：并入 10-03 全部讨论结论，见 §0.5 变更表。要点：实测真值替换全部旧尺寸假设；编码器改正为**齿轮驱动 → 推车标定为主**；分板改为**结构底板（无元件）+ 上方电路板**并给出材料结论（**PCB 而非碳板/3D 打印**）；灰度改为**外购龙邱模拟量模块**（自画子板作废留档）并升级判据为**每通道归一化加权**；前瞻口径改为"**探头连线→前轴 45mm，可调 35~55**"；删除收腰排布；新增**惯导为主线**、**5ms 周期**、**速度剖面与提速旋钮**、**规则硬点（丝印/限宽/距离积分）**、**画板检查表**；更正"悬臂下垂"论断（静态 µm 级，真问题是接头刚度）。
- **v1.7（2026-10-02）**：原理图定稿 = 双轨（5V+3.3V）。⚠ **本版 §1.1/§2.1/§2.4/§2.5/§2.6 已被 v1.8 推翻，仅原理图细节留档。**
- **v1.6（2026-10-02，已作废）**：取消双轨、子板改全 3.3V。
- **v1.5（2026-10-02）**：型号定 ITR9909 + 手册核实（R1 180Ω/0805、离地 6mm、tr/tf=15µs）。
- **v1.4（2026-10-02）**：新增 §2.4 灰度子板单路定稿；极性更正为白=1/黑=0。
- **v1.3（2026-10-02）**：逻辑轨 4.7V → 5V；IMU 座 4P → 8P；LM393 双路 → 4 片。
- **v1.2（2026-10-02）**：核实 IMU660RC（无 UART，只有 I2C/SPI），SPI2 @9MHz。
- **v1.1（2026-10-02）**：底板自己设计；编码器装轮轴（**已被 v1.8 推翻**）；IMU 型号；负压留退路。
- **v1（2026-10-02）**：框架定稿，取代三合一板方案。

---

## 附：画板检查表（出 Gerber 前逐项打勾）

```
□ 电路板丝印有"2026 机器车循迹 + 队伍名"
□ 结构底板：2.0mm / 双面铺铜 / 哑黑阻焊 / 零元件
□ 下表面无凸起；朝下的针剪平 ≤0.5mm；下表面离地 ≥5mm
□ 开关**只串逻辑轨**（不串 VM）；板在上层，引脚朝下但保证不顶到下层板
□ 两路保险分开：**VM = 一次性慢熔 10A（2410）**；**逻辑轨 = 0.5A PTC（SMD1206-050-16）**
□ 舌板与上方电路板前端用铜柱锁一次（悬臂→夹层梁）
□ 舌板：开窗 + 两条平行长槽（行程 20mm，槽宽 2.2~2.4）+ 端部加宽
□ 丝印：前轴线 + 35/40/45/50/55 刻线 + FRONT→
□ 灰度用 **「并出」10P**：A0~A7 → PA0~PA7（ADC 扫描 + DMA）；模块供 **5V**，**8 路各一组 1k/1.5k 分压 + 100nF**；针序与模块实物一致
□ IMU 座 8P 针序 = VCC/GND/SCL-SPC/SDA-SDI/SA0-SDO/CS/INT1/INT2
□ SWD 4P 座；BOOT0 10k 下拉 + 跳线
□ 功率区/逻辑区分置；晶振贴 MCU 包地；IMU 离风机 ≥40mm + 减震柱
□ 星形单点地；灰度模拟回线不穿功率区
□ 板边 4 个测试盘（3.3V / VM / GND / 空闲 ADC）
□ 状态 LED ×3 = **PC14 / PC15 / PA12**，**串 470Ω**；**发车键 = PC13、测试开始键 = PB0**（都接 GND + 内部上拉）
□ AT8236 用 **N 版**（内部 VREF 3.3V + nFAULT）；**R_ISEN = 0.11Ω / 2512 / ≥1W**（3A 限流）
□ AT8236 的 **ESOP-8 裸露焊盘焊到大块铜皮 + 打散热过孔**（手册："芯片应该直接紧贴在散热片上"）；VM 就近 470µF/25V
□ 固件：要"停"用 `11`（刹车）不用 `00`（会休眠，唤醒约 1ms）；最小 PWM 导通时间 >2.2µs
```
