xigua862/SMARTCAR2/文档/源码调查-Retirement-Dance-20261002.md

# 源码调查 · Retirement_Dance（飞檐走壁国赛软件） · 2026-10-02

> 来源：立创开源广场 <https://oshwhub.com/ifdefine/project_aximioux>（作者 **ifdefine**，代码署名 **get_lucky() 2026.8.31**）
> 附件三「国赛软件源码」= `Retirement_Dance.zip` → 已展平放到 **`开源工程\飞檐走壁-STC32G源码\`**
> 网页 BOM 栏 = **暂无BOM**；你下载的 `BOM_...xlsx` 我解析过了，**只有表头 + 1 行**（等于空的）→ BOM 必须在 EDA 里自己导出。

---

## 1. 网页里扒到的**规则原文**（比板子更重要，先看这条）

> 1. 车辆**依靠电磁传感器识别载流导线**自主循迹，需通过直角、环岛、十字、跷跷板、垂直墙面等全部赛道元素。
> 2. 车模需搭载**负压吸附**结构，实现跷跷板、墙面以及圆桶等立体赛道的通行。
> 3. **整车重量（含电池）100g 以内不罚时，超出 100g 按每 20g 罚时 1s**。沿赛道**连续行驶完整两圈**完成比赛，最终成绩 = 循迹时长 + 重量罚时。

**三条直接推论：**

| # | 推论 | 对我们的影响 |
|---|---|---|
| ① | 这个组别的赛道是**地下埋通电导线**，表面**没有可见引导线** | ✅ **已排除**：我们的赛道是 **5000×5000 黑底白线**（见 `赛道情报-黑底白线5m-20261002.md`）→ **红外成立，电磁那套整块删**；同时说明我们跑的**不是飞檐走壁国赛规则**，罚时/元素口径要按自己赛规重核 |
| ② | 100g 是**罚时线**，不是硬上限（超 20g 才罚 1s） | 电池/结构不必为省 5g 玩命；他们 108.15g = 罚 1s 以内（我们这条是否适用待核） |
| ③ | 要**连续两圈** | 电量必须撑住两圈 + 中途不能过热；电池容量不能只按一圈选 |

> ✅ **2026-10-02 更新**：赛道已确认为**黑底白线**（`文档\赛道图-5000x5000-黑底白线.png`）→ **红外方案成立**，
> 电磁 + RS824XQ 运放那一整块**确定删除**（一行板子不用留）。详细推导见 **`文档/赛道情报-黑底白线5m-20261002.md`**。

---

## 2. 工程结构（好消息：驱动不用自己写）

```
飞檐走壁-STC32G源码\
├─ Libraries\            ← 逐飞科技 STC32G 开源库（GPL3.0），驱动层全在这里
│  ├─ zf_common\         时钟/调试串口/FIFO/常用函数/中断/类型  + stc32gxx.h(寄存器) + START251.A51(启动)
│  ├─ zf_driver\         gpio / uart / adc / pwm / encoder(正交) / pit / spi / soft_iic / soft_spi / exti / flash / eeprom / delay / timer
│  ├─ zf_device\         icm20602 / imu660* / ips114(屏幕) / ips200 / tft180 / ble6a20(蓝牙) / dl1a(激光测距) / gnss / tsl1401(灰度) / wireless_uart
│  └─ zf_components\     seekfree_assistant（上位机虚拟示波器 + 参数调节协议）
└─ Project\
   ├─ code\              12 个用户模块（下表）
   ├─ user\              main.c / isr.c / isr.h
   └─ mdk\               Keil **MDK FOR C251** 工程（seekfree.uvproj，不是 STM32 那套）
```

| 文件 | 干什么 | 我们要不要动 |
|---|---|---|
| `main.c` | 初始化 + 2ms 节拍跑三环串级 | 改：初始化换红外、删飞坡/圆环调用 |
| `adc.c/h` | **4 路电感采集 + 差比和 ERR + 圆环状态机 + 飞坡状态机** | ★**整个换成 `ir.c`**（唯一大改点） |
| `pid.c/h` | 角度环 PD / 角速度环 PD / 速度环增量 PI + 差速 | **不动** |
| `motor.c/h` | 17kHz PWM + 方向，占空比 ±10000 限幅 | 不动（引脚宏照抄） |
| `encoder.c/h` | 两路带方向正交编码器测速 + 里程累计 | 不动 |
| `gyro.c/h` | 陀螺仪零漂校准 + 角度积分 | 不动 |
| `dmx_icm42688.c/h` | ICM42688 **软件 SPI** 驱动 | 不动 |
| `Menu.c/h` | 屏幕菜单：PID 调参、偏移观察、参数存/取/复位、蜂鸣 | 小改（删圆环/飞坡项） |
| `eeprom_data.c/h` | IAP/EEPROM 参数掉电保存（1KB，2 扇区） | **不动，白捡的功能** |
| `isr.c` | 4 路 UART DMA + 5 个定时器中断（TIM1 = 2ms 主节拍） | 不动 |

---

## 3. ★ 引脚占用总表（改板/接红外的唯一依据，从代码宏里逐条扒的）

| 功能 | 引脚 | 代码宏 | 备注 |
|---|---|---|---|
| 左轮方向 | `P60` | `DIR_L` | 默认高=空档 |
| 左轮 PWM | `P62` | `PWM_L = PWMA_CH2P_P62` | 17kHz |
| 右轮方向 | `P64` | `DIR_R` | |
| 右轮 PWM | `P66` | `PWM_R = PWMA_CH4P_P66` | 17kHz |
| **负压风机 PWM** | `P77` | `PWMB_CH4_P77` | 初始 50，发车后设 `power=888` |
| 编码器 1 | 脉冲 `P34` / 方向 `P35` | `TIM0_ENCOEDER` | **右轮**（代码里 R） |
| 编码器 2 | 脉冲 `P04` / 方向 `P53` | `TIM3_ENCOEDER` | **左轮**，取负号 |
| IMU 软 SPI | `P40` SPC / `P41` SDI / `P42` SDO / `P43` CS | — | 4 根线 |
| 电感 1~4 | `P00`(CH8) `P05`(CH13) `P06`(CH14) `P01`(CH9) | `ADC_CHANNEL1..4` | **10 位 ADC，5 次均值** |
| 状态 LED | `P02` 环状态 / `P03` 飞坡状态 | — | 低电平点亮 |
| 按键 上/下/确认/左/右 | `P72` `P50` `P33` `P51` `P36` | `KEY1..5` | |
| 发车键 | `P76` | `gogogo` | 扫描在 2ms 中断里 |
| 蜂鸣器 | `P67` | `BUZZER_PIN` | |
| **调试/下载串口** | **`P30` RX / `P31` TX** | `DEBUG_UART = UART_1` @**115200** | **和 ISP 下载口是同一对脚** |
| 蓝牙（默认关） | 由 `Bluetooth_or_LED` 决定，**当前 = 0 → 蓝牙未启用** | `ble6a20_init()` | 开蓝牙会再占一路 UART |

### → 红外 8 路接哪里：**P1 整组 8 个脚全空**

`P1.0 ~ P1.7` 在代码里**一个都没用到** → 直接接 8 路红外，而且 8051 可以**一条指令读整个 P1 口**：

```c
#define IR_PORT   P1
ir_bits = (uint8)(~IR_PORT);      // 一次读 8 路，比 8 次 gpio_get_level 快一个量级
```

⚠️ 两个让位条件：`P1.0 = RxD2`、`P1.1 = TxD2`。**如果要用第二路串口接蓝牙/上位机遥测**，就让出 P1.0/P1.1，红外改用 `P1.2~P1.7 + P2.0 + P2.1`（P2 组也基本空着，但 LQFP64 只有 P2.0~P2.3，**下单前对着原理图数一遍**）。

---

## 4. 控制链路（2ms 一拍，500Hz）

```
TIM1 中断(2ms) ──> get_encoder_vle()  读编码器→轮速、累计里程
              └─> electro_magnetic_collect()  4路ADC→归一化→ERR→状态机
              └─> xunji_flag = 1
主循环 ──> 角度环 PD(ERR) ──> 角速度环 PD(gyro_z, 0.7*误差+0.3*上一级输出) ──> 速度环 增量PI(左右轮) ──> motor_control()
```

**误差公式（差比和，`adc.c:118`）**
\[
ERR=\frac{A(L_X-R_X)+B(L_Y-R_Y)}{A(L_X+R_X)+C|L_Y-R_Y|+1}\times 100,\quad A=C=1,\;B=K_b=1.2
\]
→ 换红外后，`L_X/R_X` 用**左右横向两对**、`L_Y/R_Y` 用**前后纵向两对**去凑，或者直接换成 8 路**加权重心**：
\[
ERR=\frac{\sum_{i=0}^{7}w_i s_i}{\sum w_i s_i}\;,\; w=[-7,-5,-3,-1,1,3,5,7]
\]

**默认参数（`pid.c` / `adc.c`，可直接当起点）**

| 参数 | 值 | 参数 | 值 |
|---|---|---|---|
| 角度环 `kp/kd` | **55 / 50** | 圆环专用 `kp/kd` | 70 / 50 |
| 角速度环 `kp/ki/kd` | **1.3 / 0 / 0.1** | 速度环 `kp/ki/kd` | 10 / 1.2 / 0 |
| 目标车速 `car_speed` | **650**（计数/2ms） | 负压占空比 `power` | **888**（满 10000） |
| 角度环限幅 | ±5000 | 角速度环限幅 | ±600 |
| 速度环限幅 | 0~10000 | 积分限幅（gyro） | ±30 |
| 电感满量程标定 | 925/925/928/926 | 入环阈值 | 1300（横）+400（纵） |
| 差速系数 | 内侧 ×1.2 / 外侧 ×0.9 | PWM | **17kHz**，占空比标度 10000 |

**两个坑（代码里能直接看出来）**
1. `speed_control()` 里 **失线就 `while(1){motor_control(0,0);}` 死循环停车**（`adc.c:200`）——赛道上一瞬间全 0 就会**当场停死**，这是他们的“终点检测”逻辑，**我们改红外必须重写这段**（红外抖一下很正常）→ 改成“**8 路全白 + 连续 N 拍才停 + 圈数计到两圈才停**”。
2. ~~两个状态机整块删~~ → ✅ **纠正（看了赛道图后）**：
   - **`ring_judge()` 圆环状态机 → 必须保留**！赛道 E 区有 **4 个 R300 相切圆环**，这套逻辑正好对得上（只需把“电感阈值入环”换成“**里程到点 + 误差形态**”，`angle_integral_Z` 60°/340° 那套**原样照搬**）；
   - **`flyboard()` 飞坡状态机 → 待定后删**（图上看不出坡道/跷跷板/墙面，纯平面就直接删）；
   - **十字要自己加**（C 区有 1342×2132 交叉，源码里没有这块）。

---

## 5. 电源需求（你要的：电池、电压、电流）

### 5.1 电压 —— **只能用 3S，严禁 4S**

| 项 | 值 | 依据 |
|---|---|---|
| 电池标称 | **3S 锂聚 11.1V**（满电 **12.6V**，截止 **9.6V** 建议停跑） | 作者原文"电源部分采用 3S 锂电池供电" |
| **硬上限** | **16V** —— 入口 TVS = **SMAJ16CA**（双向 16V） | 4S 满电 16.8V 会让 TVS 长期导通 → 发烫/炸管/起火 |
| 输入电容耐压 | 25V（原理图里 25V 料 16 处） | 3S 安全 |
| 防反接 | **SS54F 肖特基**，压降 0.3~0.5V（**别省，A 车烧板教训**） | |
| 5V 母线 | TPS62933 同步降压 | 供驱动逻辑/预驱/屏 |
| 3.3V | RT9013 LDO → 主控 + ICM42688 + **红外** | |
| VCCCOP | 另一路 LDO → 运放 | **删电感前端后这路可以一起删** |

### 5.2 电流预算（按 100g 微缩车的实际负载）

| 负载 | 平均 | **峰值** | 说明 |
|---|---|---|---|
| 左轮有刷（030/8520 级） | 0.3~0.6 A | **2~3 A**（堵转） | 待你报电机型号后收窄 |
| 右轮有刷 | 0.3~0.6 A | **2~3 A** | |
| 负压风机（有刷 8520，≈7W） | 0.6~0.9 A | **2~3 A 启动浪涌** | `Micro_car`：7W 吸 1.2kg |
| 全部电子（5V+3.3V） | 0.15~0.3 A | 0.4 A | 主控 30 + IMU 2 + **8路红外 40~80** + 屏 40 + 蓝牙 100 mA |
| **合计** | **≈1.5~2.5 A** | **≈6~8 A** | 峰值 = 双轮堵转 + 风机启动同拍 |

> 驱动能力**完全不是瓶颈**：`DRV8701E` + `TPN2R703NL`（7mΩ 级）按 20~30A 设计，跑 3A 电机是杀鸡用牛刀——好处是**发热极小、不用散热片**。

### 5.3 买什么电池（照这个规格买）

| 项 | 要求 | 为什么 |
|---|---|---|
| 类型 | **3S 动力软包锂聚**（FPV/无人机那种高倍率） | 18650 组太重 |
| 容量 | **300~450mAh** | 规则要**连续两圈**；3.3~5Wh 绰绰有余 |
| 放电 | **持续 ≥10A / 瞬时 ≥20A / ≥20C**（例：450mAh 45C ≈ 20A） | 峰值 6~8A，要留 2 倍余量 |
| 内阻 | **≤30mΩ** | 内阻大 → 启动压降 → 5V 掉 → 复位/重启（最常见"板子玄学"） |
| 重量 | **≤15g**（含线） | 每 20g 罚 1s |
| 放电端子 | **XT30**（或至少 XT20） | ⚠️ **原板电池入口是 `ZX-PZ2.0` 2.0mm 座/焊盘，额定只有 2~3A 级，扛不住 6~8A 峰值 → 必改！** |
| 平衡头 | 保留 3S 平衡头 | 必须用**平衡充电器**（B6/AC6 类） |
| **不要**带保护板的成品 3S | — | 保护板限流 3~8A，电机一启动就触发断电；保护交给板上的 SS54F+TVS |
| 数量 | **3 块 + 1 个平衡充** | 调车一天十几轮充放 |

### 5.4 报电机型号时顺便告诉我这几项（我才能把电流表算准）

`电机型号` · `标称电压` · `空载电流` · `额定/负载电流` · `堵转电流`（或产品页截图）· 负压风机型号 · 车轮直径和齿轮比（决定所需扭矩）。

---

## 6. 结论与待办

| | 事项 | 状态 |
|---|---|---|
| ✅ | 源码到手，**逐飞 STC32G 库 = 驱动层白捡**，`pid/motor/encoder/gyro/eeprom/Menu` 六块基本能直接用 | 已确认 |
| ✅ | 引脚占用表拿到，**红外接 P1 整组**，改动面比想象小 | 已确认 |
| ⚠️ | ~~赛道到底有没有可见线~~ | ✅ **已确认：黑底白线 → 红外成立** |
| ⚠️ | **赛道要不要爬墙/跷跷板**（决定负压整套留不留） | **待你确认** |
| ⚠️ | **白线线宽多少 mm**（决定红外管间距） | **待现场量** |
| ⚠️ | **电机 DCR（两根线间电阻）**——30 秒就能量，决定堵转电流和电池 C 数 | **待你量** |
| ⚠️ | 学长车上**有没有编码器**（源码要两路带方向正交） | 待你查 |
| ⚠️ | BOM 是空的 → 在 EDA 里自己导出（`BOM 表 → 导出`） | 待做 |
| ⚠️ | 电池入口 `PZ2.0` 载流不够 → 改 XT30 | 改板必做 |
| ⚠️ | 编译环境 = **MDK for C251（Keil C51）**，不是 STM32 的 MDK-ARM；STC-ISP 串口下载 | 待装 |
| ❓ | 学长车上元件型号清单 | 等你报 |
