xigua862/SMARTCAR2/文档/D1-能抄什么-必须改什么-20261002.md

# D1 · B 车「能抄什么 / 必须改什么」· 2026-10-02

> 交接文件第 0 步 + D1 任务的产出。结论先行，细节在每节末尾。
> 已做：`git init` + `.gitignore`（**还没 commit**，等你点头）；读完 `Micro_car/README.md`；解包并读透 `ProPrj_疯狂电路_V2_2026-09-22.epro2`。
> 没做：`A整车.SLDASM` 打不开（本机无 SolidWorks，我只读了文本/压缩包，**没动任何硬件**）。

---

## 0. 一句话结论

**那份 epro2 不是 A 车的板，是一套「TC264 主控 + DRV8701 分立 H 桥 + 负压」的 4 块板完整工程**——如果 B 车愿意走 TC264，硬件和软件（本文件夹里的 19 届 Seekfree TC264 开源码）**几乎可以整套接手**；如果坚持沿用 A 车 C8T6 软件层，这套板只能当"原理参考"，D3-4 的出图排期不够。

→ **所以第一件要先定的事 = 主控平台：TC264 还是 C8T6**（不是目标、不是规则，那个决定不了今天干什么）。

---

## 1. epro2 到底是什么（已确认，不用再猜）

| 项 | 内容 |
|---|---|
| 格式 | 嘉立创EDA **专业版** 工程（zip 内含 `疯狂电路_V2.epru`，JSON 明文，可直接解析）；编辑版本 3.2.121→3.2.135 |
| 谁画的 | 立创账号 **marling**（全部 65 个文档同一作者，无第二人） |
| 丝印 | 某板背面印着 **`SWPU 2026 4 26 铁人汪汪队`**（西南石油大学？队名"铁人汪汪队"） |
| 时间 | 文档最早改动 2026-04-23，最新 2026-05-16；文件名日期 09-22 是**导出**日 |
| 规模 | 4 个 BOARD / 4 个 PCB / 7 张原理图页 / 74 个器件 / 491 个元件实例 |

**4 块板分别是什么**（按 PCB 预览图 + 网络名认出来的）：

1. **驱动板** — `DRV8701ERGER`（TI H 桥**栅极驱动器**，立创属性写 "有刷直流电机"）+ 分立 MOS（`NCE6050KA` / `NCE30H10K` / `JSM7409`）+ 大电容位；网络 `VM / GH1·SH1·GL1 / GH2·SH2·GL2`，输出 3 组 `GND|VM` 8P 电机口 → **两路驱动 + 一路负压**的有刷方案。
2. **电源板** — `XT30U-M` 电池口 + DC 座 + `TPS5430DDAR` 降压 + `ME6211C33`/`AMS1117` LDO + `MF-FSMF050X` 自恢复保险 + TVS + `Pmos_switch` 防倒灌开关，`BAT/GND` 大焊盘。
3. **主控·传感底板** — 主控丝印 **`SAK-TC264D-40F200N BC`**（英飞凌 TC264D，就是本文件夹那套 19 届开源码的芯片）；网络有 `3.3V_MCU / 3.3V_CAM / 5V / IMU / SCREEN / 图传 / TX-RX`，连接器 `SM08B-GHS-TB`(8P) + `GH1.25` 系列；有大矩形开孔（屏幕）和大圆孔（镜头/负压）。
4. **底盘结构板** — 3 组 8P 驱动模块座 + `BAT` + `ON` 开关 + 中央大圆孔 + 一圈编号安装孔（26~43）→ **模块插接式**布局。

---

## 2. 能抄什么（直接搬，别重造）

| 来源 | 抄什么 |
|---|---|
| epro2 电源板 | **电源树**：XT30 → 自恢复保险+TVS → TPS5430 降压 → 3.3V LDO **分域**（`3.3V_MCU` / `3.3V_CAM` 分开）+ PMOS 电子开关。正好对上交接纪律 3/4（XT30、一次一个电源、上电三步） |
| epro2 驱动板 | **DRV8701 + 分立 MOS** 的一体驱动（比买现成模块轻、电流上限高），三路输出一路留给负压风机 |
| epro2 全局 | **连接器规范**：循迹/IMU/图传/屏幕全走 `GH1.25` / `SM08B` 板对板或线对板 → 天然满足"禁止悬空叠装" |
| epro2 底盘板 | 模块**插接式**安装 + 编号孔位（装配不容易装错） |
| `Micro_car/README.md` | 物料表（轮毂中径、硅胶胎皮、**径向**磁铁、F682 法兰轴承×8、0.5 模齿轮 40+14=54、六面螺母 6×6×6、m2 18/20/22、8520/8523 风机、大棚膜裙边 2㎡/2.6 元） |
| `Micro_car` 结构 | **只有扇叶和负压支架需要 3D 打印**，其余碳板/PCB 结构 → 精致且稳定，这条思路直接抄 |
| 19 届 `Seekfree_TC264` 源码 | 若走 TC264：`cyh_motor.c`（PWM 17000 频率、`pwm_init(ATOM1_CH1_P21_3)`）、`cyh_encoder.c`（TIM2 正交编码器 P33_6/P33_7）、纯跟踪 + 逆透视视觉全套现成 |
| test16 现有固件 | 若走 C8T6：`循迹小车使用手册.md` 已验证的 TIM2 双路 PWM + 4 路方向 + 5 路循迹 + 霍尔 EXTI + USART1 遥测骨架 |

---

## 3. 必须改什么 / 是坑

1. **平台不通吃**：TC264 用 AURIX/TASKING 工具链（`.cproject`/Lcf_Tasking_Tricore_Tc.lsl），**不是 Keil**，A 车的 C8T6 固件、串口工具、调参脚本**不能直接烧**；引脚也不兼容（P21_3/P33_6 这类端口命名）。
2. **Micro_car 作者原话：「我没下过地跑过」**，且"仅供参考，觉得不行就当看个乐" → 只当**结构参考**，不是已验证方案；负压部分他自己说"随便画的"。
3. **重量/功耗未知**：README 说 7W 负压吸 1.2kg、单层铝底板 20g —— 微缩组限制是多少**规则没找到前不订任何定制件**（交接 §2 的硬约束）。
4. **编码器磁干扰**：磁铁离电机太近会受影响 → 布局拉开，买磁铁认准 **"径向!!!!!!"**；芯片建议 TLE5012(E1000 默认正交) 或 MT6835。
5. **负压震动**：扇叶动平衡差 → 负压支架改**弹簧/柔性解耦**（他看到国外鼠车不直连），陀螺仪加减震柱，否则螺丝松动 + 陀螺仪漂。
6. **底板变形/轮子外八**：开负压后车架变形 → 加支撑（可用板子当支撑），底板从 1.5mm 铝基改 **1mm 或 PCB 当结构板**减重。
7. **裙边材质**：铁氟龙偏硬易变形 → 用**大棚膜**；贴膜纳米胶铺宽不留缝（漏气就白搭）。
8. **齿轮 54 齿是"加起来"**：40+14 只是他给的配比，轮径/减速比要按 B 车速度和电机扭力重算。
9. **epro2 归属未确认**：丝印是别的学校/队名，**先问清楚是谁画的、有没有实物和立创订单**，再决定"改"还是"重画"。

---

## 4. 今天需要你回答的 3 件事（手机回就行）

1. **`疯狂电路_V2` 这套板是谁的？** 我们队的（marling / SWPU 铁人汪汪队 是谁）？还是外队开源/淘来的？**有没有已打样的实物板？**
2. **B 车主控定哪个**：① TC264（抄 epro2 + 19 届开源码，硬件最省）② C8T6（复用 A 车软件/遥测/工具，硬件要重画）③ 无刷路线（`STC32G 无感 FOC mini 电调` + 好盈 1625）。
3. **微缩组规则原文**在哪？我把 `test17/文档/` 全翻了一遍——**只有 `5.机器车循迹比赛规则.pdf`（A 车那条校赛/省赛道）和两张四川省赛赛道尺寸图，没有任何微缩组规则**。是要我去网上找，还是你手上有？（找不到 → 按纪律不订定制件）

---

## 3.5 顺手在 test17 查到的三条（影响上面判断）

1. **TC264 这条路本地是有底的**：`test17/参考库/TC264_Library-master/` 里有完整 TC264 库 + `Infineon-TC26xBC-DS` 数据手册 + `TC26x_B-step-UM` 参考手册 + 核心板文档 → 走 TC264 不是从零开始，**工具链和库都已就位**。
2. **检录丝印是硬要求**：A 车文档记录「电路板（主控/驱动/传感器任选其一）必须有 **'2026 机器车循迹+队伍名'** 丝印，否则检录可能卡」→ B 车出图时**丝印层先留好**，别到时候手焊马克笔。
3. **A 车踩过的电源坑直接写进 B 车规范**：`事故-连环烧板-机械短接-20260927.md` 要求 PTC 选 `SMD0805-050-16/-24`（`-6`/`-12` 结尾的不行）、开关只走逻辑电流、12V 端加 TVS(SMBJ15A)+100~470µF、8 路模块 VCC 走 3.3V（PA0/PA1/PB0/PB1 不耐 5V）——**这份 epro2 的电源板正好有 PTC+TVS+PMOS，逐项对着核一遍就能用**。

---

## 5. 顺手记的两条环境事实

- `git` **不在 PATH**（实际在 `C:\Program Files\Git\cmd\git.exe`），命令行里要用全路径或把 PATH 加上。
- 仓库已 init；`.gitignore` 排除了 `*.zip/*.7z/*.rar`、`*.hex`、`MDK-ARM/test16/`、`*.o/*.d/*.crf/*.lst` 等；**待提交内容 2268 个文件 / 6.0 MB**（原目录 232 MB 主要是压缩包，已挡住）。
- `Micro_car/更新_看这个/README.md` 是**空文件**，交接文档里"README 有完整物料清单"指的是上一级 `Micro_car/README.md`（那份才是值钱的）。
