xigua862/SMARTCAR2/开源工程/惯导矫正仿真/输出.md

# 2026-08-28 改动记录

主程序仍是 `巡线演示.py`。第一圈光电建图，其后按惯导路表跑。噪声只进惯导坐标，不改转向/速度输出。

---

## 1. 第二圈循迹（先修对，再谈漂移）

上一版第二圈跟表是歪的，看起来不像「整条路转一个角」，而是乱画。

原因：

- 跑图把建图用的 **陀螺抑制 `k_gyro`** 直接减在几何转向上。你的建图参数里 `k_gyro ≈ 0.22`，弯里角速度一大，转向被压死。
- 建图结束曾把 **编码器清零**，路表下标会跳，闭环衔接错位。

改成：

- 第二圈按编码器弧长在路表上取点，闭环循环，不再清零重对齐。
- 跟表误差用路表前方点（后来又改成沿路表前瞻，见第 6 节），同一套转向 PD。
- 建图结束把车接到路表尾→起点，继续积坐标。

无漂移时：青色惯导贴在记下的路上，橙色真车也沿原路走。

---

## 2. 惯导误差模型（参数减过一轮）

去掉原来的「编码噪声 / 陀螺噪声」两条滑条。第二圈起误差如下，**只污染估计坐标**。

### 角度（2 个参数）

每步把 \(N(\mu,\sigma)\) 加进航向再积分算 \((x,y)\)。

| 滑条 | 含义 | 单位 |
|---|---|---|
| 角漂μ°/s | 正态分布中点，可正可负（如 `0.5` / `-0.5`） | °/s |
| 角漂σ°/s | 标准差，积成航向随机游走 | °/s |

μ=0.5 表示大约每秒偏 0.5°。圈数越多转得越开，不是固定转 0.5°。

### 编码器（3 个参数）

**只在有角速度时**加噪声，并和 \(|\omega|\) 成正比，积进路程比例。直线不再加新量，已经积上的比例一直留着。

| 滑条 | 含义 |
|---|---|
| 编码μ | 高斯中点（相对误差） |
| 编码σ | 高斯标准差 |
| 编码k\|ω\| | 乘在 \(N(\mu,\sigma)\times k\,|\omega|\) 上 |

相对路程：\(v \leftarrow v\,(1 + \text{积分偏置})\)。

### 跨圈积分

第二、三、四圈……**不把误差清掉**，在上一圈偏差上继续积。只有点「重新运行」才清零。路表下标按圈取模，惯导坐标不重置。

---

## 3. 建图 / 跑图两套参数

| 模式 | 文件 | 用途 |
|---|---|---|
| 建图 | `控制参数.json` | 光电、你现在这套速度 |
| 跑图 | `控制参数_跑图.json` | 跟表、速度规划、更大 vmax |

右侧滑条改的是**当前模式**那一套。「保存参数 / 导入参数」默认文件名会跟着模式走。

跑图默认（可再调）：

- vmax 1500 mm/s，vmin 280 mm/s
- 前瞻 120 mm
- 弯心加速度 `a_lat`、刹车/加速 `a_brake` / `a_acc`（刹车有滑条）
- 跑图 `k_gyro` 默认压到约 0.06，避免高速过弯被陀螺项拧死

第一圈记完表会自动切到跑图参数。

---

## 4. 第二圈速度规划 + 前瞻

按路表曲率做前后向规划：直道拉高，弯前按刹车加速度提前减速。

- **前瞻mm**：转向和速度都看路表前方这段（跑图默认 120 mm，建图光电仍是车头前 50 mm）
- **刹车acc**：规划里弯前减速有多急

速度环：`v_target = 规划速度`，再按惯导横向偏差略减。

---

## 5. 路表存盘和模式切换

| 按钮 | 作用 |
|---|---|
| 建图 | 光电记表，清当前运行中的路表 |
| 跑图 | 用已有路表跟表；没有则读 `惯导路点.json` 或弹框载入 |
| 保存路表 | 写出 JSON |
| 载入路表 | 读入后进入跑图 |
| 重新运行 | 跑图模式**保留路表**从起点再跟；建图模式才清表 |

路表文件：`惯导路点.json`（记表结束也会自动写一份）。

HUD：`建图记表 …` 或 `跑图 xx%  规划…`。当前模式按钮带 **●**。

---

## 6. 跑图「跳回建图」和轨迹不对

现象：点跑图后按钮又像建图，车也不贴路表。

原因：

- 切模式时整窗重绘，按钮颜色被刷回「建图」高亮。
- 跑图若没锁住 `nav`，仍可能继续光电记表。
- 前瞻加在**车头方向**上，头一偏就瞄飞；再叠建图那套大 `k_gyro`，高速弯转向被吃掉。

处理：

- 跑图且路表已冻结时，每拍强制 `nav = follow`，不再记表。
- 按钮用 **●** 标当前模式，重绘后会再刷一次。
- 跟表改成瞄**路表前方点**的车体左右误差；跑图陀螺抑制按 0.35 倍用。

---

## 7. 今天相关文件

| 文件 | 说明 |
|---|---|
| `巡线演示.py` | 上述逻辑都在这里 |
| `控制参数.json` | 建图参数（未擅自覆盖你的整定） |
| `控制参数_跑图.json` | 新建，跑图参数 |
| `惯导路点.json` | 路表（建图结束 / 保存路表） |
| `控制参数偏差.json` | 你本地的漂移试参，程序未改 |

启动仍是 `运行巡线演示.bat` 或 `python run_follow.py`。

---

## 8. 跑图直道矫正（光电 + 惯导）

只在**跑图**、路表已冻结、且当前点落在长直道**核心段**时修正惯导。弯道和出入弯保持上一拍的航向补偿，不把 PID 清零。

路表按 40 mm 内航向变化切直/弯，再按「出入弯」距离把直道两端裁掉：

| 颜色 | 含义 |
|---|---|
| 青绿 | 可矫正核心直道 |
| 黄 | 出入弯，不矫正 |
| 橙 | 弯道 |

偏差：`e_lat = 惯导横向(相对路表) − 光电横向(相对真赛道)`。光电在线且车贴线时，这一项就是惯导相对真位置的侧偏。增量式 PID 输出叠到 `yaw_corr`，惯导航向为 `积分陀螺 + yaw_corr`（限幅 ±18°）。关矫正时立刻把 `yaw_corr` 置零，方便对照。

**编码器为什么也要改、怎么改：** 跑图下标按 `enc_s` 取路表。航向补了以后，下一步位置积分会对，但弧长比例误差（转弯时积上的 `_enc_bias`）仍会让表上的「我走到哪」超前/滞后。长直道上把惯导 `(x,y)` 投到路表得到几何弧长 `s_proj`，再把 `enc_s` 向它靠拢（`编码修正` 滑条，单位 1/s，单拍限 ±3 mm）。不直接改比例偏置，避免弯里把噪声当成尺长。偏差超过 120 mm 不拉，防止投错段。

开关：右下 **矫正 关 / ●开**，或按 `C`。默认关。HUD 在青绿段显示 `e=` 和 `yaw°`。

相关滑条：最短直道、出入弯、矫正Kp、编码修正。Ki/Kd 在跑图 JSON 里，默认 Ki 很小，以免长直道积分顶满。

对照请先「重新运行」再开/关，中途开关只从当前圈接着比。

---

## 9. 建议怎么试

1. 建图模式跑完一圈（或载入已有路表）。
2. 确认右侧是 **跑图 ●**，左下是 `跑图 …%`。
3. 角漂μ 拉到 `0.3～0.8`：橙色真轨迹应整圈慢慢转开，青色仍跟表。
4. 要看转弯编码器误差：编码μ、σ 和 k|ω| 一起拉开，多圈会越积越多。
5. 跑图还想更快：加 vmax；弯进不去就加大「刹车acc」或略抬 vmin。
6. 直道矫正：跑图后看路表颜色（青绿才改）。角漂拉开后先关着跑一圈看橙色真轨迹转开，再开矫正 / 按 `C` 看是否贴回。编码μ 拉开时看 HUD 的编码是否在直道上被拉回。
