xigua862/SMARTCAR2/100g-wall-climbing-mini-car/100g-wall-climbing-mini-car-master/README.md

# 100g飞檐走壁小车

#### 介绍
21届智能车竞赛飞檐走壁电磁组小车
不喜欢可以说，轻点喷，毕竟有大佬80g 60g车模都是有的
采用框式架构PCB架在上面，刚性比较足

#### 软件架构
软件架构说明

#### 安装教程

1.  【【四驱指南】干货分享！街跑四驱车装胎拆胎全攻略，新手车友们别错过】 https://www.bilibili.com/video/BV1Yz4y1V7Rf/?share_source=copy_web&vd_source=24232ebbc2556cf4ebd4f93016c19592
2.   附赠一份陀螺仪未调好的基础循迹代码
3.  唐车运行效果【飞檐走壁唐车不玩了，开了开了】 https://www.bilibili.com/video/BV1WD5B6XEgW/?share_source=copy_web&vd_source=24232ebbc2556cf4ebd4f93016c19592
4.  轮毂选择有个技巧，小径可以适配海绵圈，你可以自己买裁刀，圆形割刀，切一下海绵圈，然后改成任意你想要的大小，直接用中劲的话就是抱抱龙的那一个版本，然后可以配成品胎皮，那种京商胎皮

#### 特技

1.  使用 Readme\_XXX.md 来支持不同的语言，例如 Readme\_en.md, Readme\_zh.md
2.  Gitee 官方博客 [blog.gitee.com](https://blog.gitee.com)
3.  你可以 [https://gitee.com/explore](https://gitee.com/explore) 这个地址来了解 Gitee 上的优秀开源项目
4.  [GVP](https://gitee.com/gvp) 全称是 Gitee 最有价值开源项目，是综合评定出的优秀开源项目
5.  Gitee 官方提供的使用手册 [https://gitee.com/help](https://gitee.com/help)
6.  Gitee 封面人物是一档用来展示 Gitee 会员风采的栏目 [https://gitee.com/gitee-stars/](https://gitee.com/gitee-stars/)
