xigua862/SMARTCAR2/文档/审查-调参迭代器-20261011.md

# 审查报告 · 调参迭代器 · 2026-10-11

> 角色：**检察官**（只读复核，不改代码、不改文档、不碰 git）。
> 审查对象：`脚本/调参/调参迭代.py`（1071 行，14:42）+ `脚本/调参/{调参参数.json, 调参参数_best.json, 调参日志.csv, 调参收敛.txt}`。
> 基准：`文档/讨论-调参迭代器与固件契约-20261011.md`（15:07，**比脚本新**）+ `文档/待并入v1.9-清单-20261011.md` §2~§5 + 用户口述契约。
> 规矩：每条给 **文件:行号 + 代码原文 + 为什么 + 最小改法**，并标 **【已证实】/【推测】**；推测附"怎么验证"。

---

## 0. 一句话结论（先看这个）

**不能上实车。** 缺的硬伤按致命度排序：①串口写参数**无回读校验**且 `push_all` 吞掉失败返回值 → "以为写进去了其实没生效"；②文档头承诺的"连续 2 次不达标→回退"在 B 阶段**是死变量，根本没实现**；③`run(n)` 收不满圈**静默降级**成 1 圈/0 圈结论；④`score`/`meets_gate` 里**没有时间项**，C-1 升 vmax 不判"更快"；⑤C 阶段**从未被跑过**（收敛记录只到 B 42 轮）。42 轮收敛只证明"迭代机器在合成碗上能转"，**不证明参数物理上正确**（§6）。

---

## 1. 必须改（5 条 · 不报错、只在实车/赛道现形）

### M1. 串口写参数无回读校验，且 `push_all` 吞掉失败返回值 —— "以为写进去了其实没生效"【已证实】

- **位置**：[调参迭代.py:330-333](file:///c:/Users/asus/Desktop/test16/脚本/调参/调参迭代.py#L330-L333) + [调参迭代.py:636-639](file:///c:/Users/asus/Desktop/test16/脚本/调参/调参迭代.py#L636-L639)
- **代码原文**：
  ```python
  def set(self, key, val):
      self._send("SET %s %s" % (key, fmt_val(val)))
      line = self._readline(time.time() + self.cmd_timeout)
      return bool(line) and line.upper().startswith("OK")   # 只等 OK，不回读
  ...
  def push_all(self):
      for k in FIRMWARE_KEYS:
          if k in self.p:
              self.guard.guarded_set(self.tp, k, self.p[k])  # 返回值被丢弃
  ```
- **为什么**：用户口述契约明确要"SET/GET/RUN + **回读确认**"。现状是：①`set` 收到 `OK` 就信，不 `GET` 回读，固件浮点截断/解析成别的值永远发现不了；②超时/丢帧/`ERR KEY` 时 `set` 返回 `False`，但 `push_all` 不检查，**静默继续 RUN**，车带着旧参数跑而脚本以为是新参数。这是最典型的"实车才现形"隐患。
- **最小改法**：
  ```python
  def set(self, key, val):
      self._send("SET %s %s" % (key, fmt_val(val)))
      line = self._readline(time.time() + self.cmd_timeout)
      if not (line and line.upper().startswith("OK")):
          return False
      got = self.get(key)                       # 回读校验
      try:
          return abs(float(got) - float(val)) <= abs(float(val)) * 1e-6 + 1e-9
      except (TypeError, ValueError):
          return False

  def push_all(self):
      for k in FIRMWARE_KEYS:
          if k in self.p and not self.guard.guarded_set(self.tp, k, self.p[k]):
              raise RuntimeError("SET %s 失败(超时/ERR/回读不一致)，停车" % k)
  ```

### M2. "连续 2 次不达标→回退"是死变量，B 阶段根本没实现【已证实】

- **位置**：文档头承诺 [调参迭代.py:16-17](file:///c:/Users/asus/Desktop/test16/脚本/调参/调参迭代.py#L16-L17)；死变量 [调参迭代.py:621](file:///c:/Users/asus/Desktop/test16/脚本/调参/调参迭代.py#L621)、[655](file:///c:/Users/asus/Desktop/test16/脚本/调参/调参迭代.py#L655)、[658](file:///c:/Users/asus/Desktop/test16/脚本/调参/调参迭代.py#L658)
- **代码原文**：
  ```python
  # 头注释：连续 2 次不达标 → 回退
  self.consec_fail = 0          # 621 初始化
  ...
  if ev.finished:
      self.consec_fail = 0      # 655 重置
      self.last_good = dict(self.p)
  else:
      self.consec_fail += 1     # 658 累加 —— 全文再无任何地方读它
  ```
- **为什么**：grep 全文，`self.consec_fail` 只被写、从不被读。B 阶段唯一的回退出口是 `check_abort`（line_max>20mm 或 lost≥2），**DNF 但偏差没超阈、丢线<2 时不回退**。反例见 §4.3 反例 3：连续多档 DNF，脚本只会一直换键试，`last_good` 永不恢复。C 阶段那个 `consec_fail`（825 行）是局部变量，只用来把 vmax 步长二分，**不是回退到 last_good**，两回事。
- **最小改法**：在 `eval_config` 累加后加消费：
  ```python
  else:
      self.consec_fail += 1
      if self.consec_fail >= 2:
          self.rollback(phase, "连续 %d 档未跑完" % self.consec_fail)
          self.consec_fail = 0
  ```

### M3. `run(n)` 收不满圈时静默降级成"1 圈/0 圈结论"【已证实】

- **位置**：[调参迭代.py:643-647](file:///c:/Users/asus/Desktop/test16/脚本/调参/调参迭代.py#L643-L647) + [调参迭代.py:568-601](file:///c:/Users/asus/Desktop/test16/脚本/调参/调参迭代.py#L568-L601)
- **代码原文**：
  ```python
  recs = self.tp.run(laps)
  # 收到的圈数可能少于请求（串口超时等），据实评估
  ev = EvalResult(recs, self.meta)
  ...
  self.finished = n > 0 and all(r.ok for r in self.records)   # n=1 也算"完成"
  ```
- **为什么**：契约承诺"每档 2 圈取最差"。但串口超时/丢帧导致 `run(2)` 只回 1 圈时，`EvalResult` 照算：`worst` 取那 1 圈、`finished` 判 True、`score` 基于单圈——**静默变成"1 圈结论"，无任何警告/降级标记**。回 0 圈时 `worst` 全取 `default=0.0`，`check_abort` 判"0<20 没超阈"，被当成正常 REVERT。实车串口一旦不稳，整个判据基础就塌了还不自知。
- **最小改法**：
  ```python
  recs = self.tp.run(laps)
  if len(recs) < laps:
      self.say("  [警告] 请求 %d 圈只收到 %d 圈，本档判失败(不收不满圈)" % (laps, len(recs)))
      recs = []                      # 强制 finished=False, score=fail_penalty
  ev = EvalResult(recs, self.meta)
  ```

### M4. `score`/`meets_gate` 里没有时间项，C-1 升 vmax 不判"更快"【已证实】

- **位置**：[调参迭代.py:593-601](file:///c:/Users/asus/Desktop/test16/脚本/调参/调参迭代.py#L593-L601)；C-1 [调参迭代.py:842-851](file:///c:/Users/asus/Desktop/test16/脚本/调参/调参迭代.py#L842-L851)
- **代码原文**：
  ```python
  self.score = float(m["w_line"]) * self.worst_line_p95 + float(m["w_ins"]) * self.worst_ins_p95   # 无 time
  self.meets_gate = (self.finished
                     and self.worst_line_p95 <= float(m["p95_gate_mm"])
                     and self.worst_ins_p95 <= float(m["ins_p95_gate_mm"])
                     and self.worst_lost <= int(m["lost_max"]))                                     # 无 time
  ...
  if ev.meets_gate:           # C-1：只要达标就无条件升 vmax，不比时间
      v_good = v_try
  ```
- **为什么**：C 阶段口号是"约束偏差下最小化单圈时间"，但目标函数 `score` 和闸门 `meets_gate` 里**都没有时间**。C-1 只判 `meets_gate` 就升 vmax，**隐含假设"vmax↑ 则 time↓ 单调"**——这在合成模型里碰巧成立（`time=track_len/v_eff`，`v_eff=vmax/corner_pen`），但实车上 vmax 升高可能触发打滑/失稳反而更慢，C-1 会照升不误。C-2（887 行 `ev.time_ms < best_time*(1-eps)`）才有时间判断，但只覆盖 look_mm/a_acc。
- **最小改法**：C-1 接受前加时间门：
  ```python
  if ev.meets_gate and ev.time_ms < v_good_time * (1.0 - eps):
      v_good, v_good_time = v_try, ev.time_ms
  ```
  或在 `score` 里显式加 `w_time * time_ms` 项并把权重写进 JSON。

### M5. C 阶段从未被验证过（收敛记录只到 B 42 轮）【已证实】

- **位置**：[调参收敛.txt:43](file:///c:/Users/asus/Desktop/test16/脚本/调参/调参收敛.txt#L43)（最后一条 `42 B corr_kp`）；工作报告 §6 自认"上次完整跑 C 被闸门(3.5)挡住没进；调到 4.0 后没再跑"
- **为什么**：`调参收敛.txt`/`调参日志.csv`/`调参参数_best.json` 全是 **gate=3.5、C 被跳过**那版跑的，与现 JSON 里 `p95_gate_mm=4.0`（[调参参数.json:40](file:///c:/Users/asus/Desktop/test16/脚本/调参/调参参数.json#L40)）**不一致**；best.json 里还是 3.5（[调参参数_best.json:33](file:///c:/Users/asus/Desktop/test16/脚本/调参/调参参数_best.json#L33)）。C 的二分/回退/触顶三条路径**一行实测记录都没有**。M4 的"不判时间"缺陷正因为 C 没跑过才没暴露。
- **最小改法**：把 `p95_gate_mm` 调到一个能让当前 best 过闸的值（如 3.6），`python 调参迭代.py --sim --phase C` 复跑一遍，确认收敛记录里出现 `C vmax PUSH/ACCEPT/REVERT/BISECT` 行，再重生成 best/curve 到 gate 一致。

---

## 2. 建议改（5 条 · 不致命但会在实车放大）

### S1. `accept_eps=1%` 与实测圈间噪声 ~2.5% 同量级，安全裕度不足 2×【已证实】

- **位置**：[调参参数.json:38](file:///c:/Users/asus/Desktop/test16/脚本/调参/调参参数.json#L38) `accept_eps=0.01`、[34](file:///c:/Users/asus/Desktop/test16/脚本/调参/调参参数.json#L34) `lap_per_config=2`；判据 [调参迭代.py:773](file:///c:/Users/asus/Desktop/test16/脚本/调参/调参迭代.py#L773)
- **实测噪声**（从 `调参日志.csv` 同 snapshot 2 圈量出，详见 §4.2）：`ins_p95` 圈间波动最大 **2.47%**（round 5：6.887 vs 6.719），`line_p95` 最大 1.50%。传导到 `score` 约 1~2%。
- **为什么**：日志里 REVERT 正确拒绝了 0.44%~0.92% 的改善（round 16/26/28/32/36，5 次），但 ACCEPT 的改善也常只有 **1.4%~2.0%**（round 34/38/40），已在噪声边缘。合成噪声尚且如此，实车（温漂/电池电压/赛道不一致）只会更大，1% 阈值大概率追噪声。
- **最小改法**：`accept_eps` 抬到 `0.03`；或 `lap_per_config` 抬到 4 圈并把 `EvalResult.worst`（max 聚合）改成中位数，压方差。

### S2. `clamp_bounds` 的 `or` 陷阱：种子值为 0 时边界锚点漂移【已证实】

- **位置**：[调参迭代.py:540](file:///c:/Users/asus/Desktop/test16/脚本/调参/调参迭代.py#L540)
- **代码原文**：`base = float(self.seed.get(key, val)) or val`
- **为什么**：Python `0 or val` 返回 `val`（0 是 falsy）。若某键种子=0（如 `autorun=0`），`base` 会退化成"当前值"，每次调用边界 `[base*0.6, base*1.6]` 都跟着漂，**"以种子为锚"的钳位失效**。当前 `autorun` 不在 `PHASE_B_ORDER`/`PHASE_C_ORDER`，不会被 `propose` 触发，所以**现在不炸但脆**；将来把 `autorun` 纳入自动调就会中招。
- **最小改法**：`base = float(self.seed[key]) if key in self.seed else float(val)`，显式区分"种子是 0"和"种子缺失"。

### S3. `best.json` 把 sim/meta/fixed 键全写进去，不是"固件参数表"【已证实】

- **位置**：[调参迭代.py:900-904](file:///c:/Users/asus/Desktop/test16/脚本/调参/调参迭代.py#L900-L904)；产物 [调参参数_best.json:52-81](file:///c:/Users/asus/Desktop/test16/脚本/调参/调参参数_best.json#L52-L81)
- **为什么**：`finalize` 直接 `save_json(best_path, self.best_params)`，而 `best_params=dict(self.p)` 是全量 JSON。结果 best.json 里混进 `sim_seed`/`sim_track_len_mm`/`lap_per_config` 等 30 多个无关键。工人拿它去烧 `param.c` 会带进一堆垃圾，且与契约 §2"固件参数表"对不上。
- **最小改法**：`save_json(best_path, {k: self.best_params[k] for k in FIRMWARE_KEYS if k in self.best_params})`。

### S4. `straight_deg` 在代码白名单但不在契约 §2 参数表【已证实】

- **位置**：代码 [调参迭代.py:55](file:///c:/Users/asus/Desktop/test16/脚本/调参/调参迭代.py#L55)；契约 `待并入v1.9-清单` §2 表只列了 `straight_min`/`corner_margin`，**无 `straight_deg`**
- **为什么**：D3 签字"键名以 v1.8 §3 模块名为准重落"，但 `straight_deg` 是原型自加、没进契约表。固件 `param.c` 照契约建表就不会有它，`SET straight_deg` 会被固件判 `ERR KEY`，而脚本白名单放行 → 静默失败（叠加 M1 更致命）。
- **最小改法**：要么把 `straight_deg` 补进契约 §2 表，要么从 `FIRMWARE_KEYS` 删掉。二选一，别两边不一致。

### S5. `kp_steer/kd_steer` 未按 D3 改名 `kp_angle/kd_angle`【已证实，已被承认冻结】

- **位置**：代码 [调参迭代.py:51](file:///c:/Users/asus/Desktop/test16/脚本/调参/调参迭代.py#L51) 仍是旧名；契约 §2 表要求改名
- **为什么**：grep 全文 `kp_angle/kd_angle` **零出现**。工作报告/契约 §5 已自认"原型按 D1 冻结、port 留到固件里程碑"，所以这是**已知可接受的差异**，不算隐瞒。但 port 时若漏改，固件 `param.c` 用新名、脚本 SET 旧名 → 全部 `ERR KEY`。
- **最小改法**：固件里程碑派工人卡时，把"改名 + 复跑 --sim"写成验收项；现在不动（尊重 D1 冻结）。

---

## 3. 已核对没问题（5 条）

### G1. LAP 行 13 字段与顺序完全对上契约 §4【已证实】
- [调参迭代.py:158-184](file:///c:/Users/asus/Desktop/test16/脚本/调参/调参迭代.py#L158-L184) `parse_lap_line` 解析 `LAP,lap,finished,time_ms,dist_mm,line_rms,line_p95,line_max,ins_rms,ins_p95,comp_deg_mean,lost_count,reason` —— 与契约 §4 及用户口述逐字段一致，`to_line`（150-155）回环也对得上。

### G2. 串口 SET/GET/RUN 命令格式对上契约 §3【已证实】
- [调参迭代.py:330-372](file:///c:/Users/asus/Desktop/test16/脚本/调参/调参迭代.py#L330-L372)：`SET <键> <值>`、`GET <键>`、`RUN <n>` 三条命令的发送格式与应答前缀（OK/OK <值>/ACK）都按契约来，且 `run` 宽容了"不回 ACK 直接打 LAP"的固件（366 行）。命令层面没问题（回读校验是另一回事，见 M1）。

### G3. 白名单 `guarded_set` 硬拒非 FIRMWARE_KEYS 键【已证实】
- [调参迭代.py:522-526](file:///c:/Users/asus/Desktop/test16/脚本/调参/调参迭代.py#L522-L526)：`if key not in FIRMWARE_KEYS: raise RefuseWrite`。反例 1（写 `motor_dir`）会走到 524 行抛异常，结果对。电机方向/R_ISEN/引脚映射均不在 `FIRMWARE_KEYS`，符合契约 §2 禁改清单。

### G4. 单圈步长 `clamp_step` 正常路径 ≤5%【已证实】
- [调参迭代.py:528-535](file:///c:/Users/asus/Desktop/test16/脚本/调参/调参迭代.py#L528-L535)：`maxd=abs(old)*max_step_pct`，`d=clamp(new-old,-maxd,maxd)`。反例 2（`clamp_step(100,150)`）返回 105，钳到 5%，结果对。（`old==0` 的边界漏洞见 S2，正常路径不触发。）

### G5. vmax 有 floor/ceiling 双钳位【已证实】
- [调参迭代.py:544-545](file:///c:/Users/asus/Desktop/test16/脚本/调参/调参迭代.py#L544-L545)：`if key=="vmax": val=clamp(val, vmax_floor, vmax_ceiling)`。契约 §3"vmax_ceiling 受 §7 物理上限约束、不由调参器拍"——代码确实把 ceiling 当硬边界，C-1 触顶即停（849-851 行），符合。

---

## 4. 五项逐条结论（用户点名的五件事）

### 4.1 契约一致性：逐字段核对

| 维度 | 基准 | 脚本现状 | 结论 |
|---|---|---|---|
| LAP 字段/顺序 | 契约 §4：13 字段 | `parse_lap_line` 13 字段 | ✅ 对得上（G1） |
| LAP 结束原因枚举 | §4：`OK/LOST/TIMEOUT/OFFTRACK/SPIN/ABORT/INCOMPLETE` | 只产生 `OK/LOST/SPIN/ROLLBACK`，且**不校验固件返回的枚举** | ⚠ 收得下但不校验；`ROLLBACK` 是脚本自造行不在枚举（可接受，非固件返回） |
| 参数键名 | 用户口述 12 键 | `FIRMWARE_KEYS` 全含 | ✅ 对得上 |
| 参数键名（文档后定） | 契约 §2/D3：`kp_steer→kp_angle`、`kd_steer→kd_angle` | 仍用旧名，`kp_angle` 全文零出现 | ❌ **未跟上**（S5，已被承认冻结） |
| 参数键（文档后定） | 契约 §2 表**无 `straight_deg`** | 代码白名单**有 `straight_deg`** | ❌ **多一个键**（S4） |
| 串口命令 | §3：SET/GET/RUN | 三条都实现 | ✅ 格式对得上（G2） |
| 串口 ERR 处理 | §3：`ERR KEY`/`ERR <原因>` | `set` 只判 `startswith("OK")`，**不区分 ERR** | ❌ ERR 被当成普通失败，叠加 push_all 吞返回值 → 静默（M1） |
| 回读确认 | 用户口述"SET/GET/RUN + **回读确认**" | `set` 后**无 GET 回读** | ❌ **未实现**（M1） |

**"文档后定的口径脚本是否已跟上"小结**：脚本（14:42）早于契约（15:07），契约后定的 4 处口径——①D3 改名、②删/补 `straight_deg`、③ERR 分支、④回读确认——脚本**一处都没跟上**。其中 ①② 已被工作报告如实记录为"冻结待 port"，③④ 是**报告里没点到的真缺口**（M1）。

### 4.2 判据有没有被噪声淹没（最关键）

**实测圈间噪声**（从 `调参日志.csv` 同 snapshot 的 2 圈量出，`lap_per_config=2`）：

| round | 调的键 | line_p95 两圈 | Δ% | ins_p95 两圈 | Δ% |
|---|---|---|---|---|---|
| 2 | BASE | 4.715 / 4.645 | 1.50% | 6.799 / 6.779 | 0.29% |
| 5 | kp_steer+3% | 4.654 / 4.634 | 0.43% | 6.887 / 6.719 | **2.47%** |
| 15 | look_mm+3% | 3.937 / 3.879 | 1.48% | 5.955 / 6.091 | **2.26%** |
| 25 | corr_ki+3% | 3.682 / 3.703 | 0.57% | 5.461 / 5.359 | 1.88% |
| 21 | k_gyro+3% | 3.632 / 3.640 | 0.22% | 5.985 / 6.037 | 0.86% |

→ **圈间噪声实测：line_p95 最大 1.50%，ins_p95 最大 2.47%**。`score = 1.0·max(line_p95) + 0.6·max(ins_p95)`，传导到 score 约 1~2%。

**参数响应 vs 噪声**（同键差 3% 的 score 变化）：
- 碗底：round 39→41，corr_kp +3%，score 6.5676→6.5920，**响应 0.37% < 噪声 2.47%**（分辨不出）
- 碗壁：round 40→39，corr_kp +6.2%，score 6.7919→6.5676，**响应 3.3% > 噪声**（能分辨）

**判据**：`accept_eps=0.01`（1%），`lap_per_config=2`，`worst` 用 **max 聚合**（578-579 行）。
- 日志实证：REVERT 正确拒绝 0.44%/0.45%/0.73%/0.88%/0.92%（round 16/26/28/32/36，5 次）——**"不追噪声"在合成数据上成立**。
- 但 ACCEPT 的改善也常只有 1.4%/1.6%/2.0%（round 34/38/40），**与噪声 2.47% 同量级**，安全裕度 < 2×。

**结论**：阈值 1% **没有被噪声完全淹没，但已在临界线上**。合成噪声（高斯、`sim_noise_ins=0.018`）尚且让 ins_p95 波动 2.47%，实车噪声（温漂/电池/赛道不一致/起步打滑）只会更大。**判定：合成数据上"勉强不追噪声"，实车上"大概率追噪声"**。最小修法见 S1（抬 eps 到 3% 或加圈数取中位数）。

### 4.3 安全阀反例（逐条对着代码走）

**反例 1：写非白名单键 `motor_dir`**
- 路径：`guarded_set(tp,"motor_dir",1)` → [524 行](file:///c:/Users/asus/Desktop/test16/脚本/调参/调参迭代.py#L524) `if key not in FIRMWARE_KEYS` 命中 → `raise RefuseWrite`。
- 结果：✅ **对**。电机方向/限流/引脚映射均不在白名单，硬拒。

**反例 2：超步长 `clamp_step(100, 150)`（+50%）**
- 路径：[533-535 行](file:///c:/Users/asus/Desktop/test16/脚本/调参/调参迭代.py#L533-L535) `maxd=100*0.05=5`，`d=clamp(50,-5,5)=5`，返回 `105`。
- 结果：✅ **对**，钳到 5%。
- 边界：`old==0` 时 [531-532 行](file:///c:/Users/asus/Desktop/test16/脚本/调参/调参迭代.py#L531-L532) 直接 `return float(new)` 无限制——当前 `propose` 用乘法 `cur*factor`，cur=0 则 raw=0，不触发；但 `clamp_step` 若被别处直接调用会漏（S2 同源脆点）。

**反例 3：连续 2 圈失败（DNF 但偏差没超阈、丢线<2）**
- 路径：`eval_config` → `ev.finished=False` → [658 行](file:///c:/Users/asus/Desktop/test16/脚本/调参/调参迭代.py#L658) `self.consec_fail += 1`（=1）→ `check_abort`（557-561）判 `line_max<20 且 lost<2` → 返回 `(False,"")` **不 abort** → `phase_b` 走 else 分支（784-793）`self.p[key]=cur_val` 恢复该键、log REVERT → **进入下一键继续试**。
- 第二档又 DNF：`consec_fail=2` → **仍无任何代码读它** → 继续换键试。
- 结果：❌ **不对**。文档头承诺的"连续 2 次不达标→回退"**没走到任何回退行**，`last_good` 永不恢复。只有 `check_abort` 的硬阈（20mm/lost≥2）能触发 rollback，DNF-软失败完全裸奔（M2）。

**白名单/步长/钳位/连续失败 四条总评**：白名单 ✅、步长 ✅（正常路径）、钳位 ✅（vmax 双钳，但 `or` 陷阱脆 S2）、**连续失败回退 ❌（死变量 M2）**。

### 4.4 "收不满圈数"的降级路径

- **结论**：❌ **静默降级，不满足"每档 2 圈取最差"的承诺**。
- 证据：[645-647 行](file:///c:/Users/asus/Desktop/test16/脚本/调参/调参迭代.py#L645-L647) `recs=self.tp.run(laps)` 后直接 `EvalResult(recs,...)`，注释自己写"收到的圈数可能少于请求……据实评估"——**"据实评估"= 有几圈算几圈**。`EvalResult` 里 `finished = n>0 and all(...)`（574 行），n=1 时那 1 圈 ok 就判 True，`score` 基于单圈 `worst`（=单圈值）。**没有"不足 n 圈则判失败/告警"的任何分支**。
- 串口超时/丢帧 → `run(2)` 回 1 圈 → 脚本当成"1 圈达标"接受 → 实车上一档结论建立在单圈偶然值上。回 0 圈 → `worst` 全 `default=0.0` → `check_abort` 判"0<20 没超阈" → 当成正常 REVERT，**连"这档没数据"都不报**。
- **最小修法**：见 M3（`if len(recs)<laps: recs=[]` 强制判失败，或至少 `say` 告警 + 在 CSV note 列标 `SHORT`）。

### 4.5 加速阶段(C) 的目标函数

- **`score` 里有没有时间项？** ❌ 没有。[593-597 行](file:///c:/Users/asus/Desktop/test16/脚本/调参/调参迭代.py#L593-L597)：`score = w_line·worst_line_p95 + w_ins·worst_ins_p95`，纯偏差。
- **`meets_gate` 里有没有时间项？** ❌ 没有。[598-601 行](file:///c:/Users/asus/Desktop/test16/脚本/调参/调参迭代.py#L598-L601)：只判 `finished`/`line_p95`/`ins_p95`/`lost`。
- **C 阶段凭什么判"更快了"？** 分裂：
  - **C-1（升 vmax）**：[842 行](file:///c:/Users/asus/Desktop/test16/脚本/调参/调参迭代.py#L842) `if ev.meets_gate:` 就升，**不比时间**。隐含假设"vmax↑ 则 time↓ 单调"，合成模型里碰巧成立，实车不一定（M4）。
  - **C-2（look_mm/a_acc）**：[887 行](file:///c:/Users/asus/Desktop/test16/脚本/调参/调参迭代.py#L887) `if ev.meets_gate and ev.time_ms < best_time*(1-eps)` —— **这里才有时间判断**。
  - 全局 `_maybe_best`（665 行）`if ev.meets_gate and ev.time_ms < self.best_time` 也用时间，但只在达标时比。
- **C 阶段是否被验证过？** ❌ **没有**。`调参收敛.txt` 最后一条是 `42 B corr_kp`，**无任何 C 行**；`调参日志.csv` 同样只到 round 42 全 B；工作报告 §6 自认"C 被闸门挡住没进、调到 4.0 后没再跑"。best.json 里 `p95_gate_mm` 还是 3.5（与 JSON 的 4.0 不一致）。C 的二分（860-869）/回退（837）/触顶（849-851）三条路径**零实测记录**。
- **最小修法**：见 M4（C-1 加时间门）+ M5（复跑 `--sim --phase C` 补齐验证、重生成存档到 gate 一致）。

---

## 5. 两条边界判断（用户点名要点明）

### 5.1 SimTransport 是合成/玩具模型 —— 42 轮收敛≠参数物理正确【已证实】

- **位置**：[调参迭代.py:190-290](file:///c:/Users/asus/Desktop/test16/脚本/调参/调参迭代.py#L190-L290)
- **机制**：`SimTransport` 的"真值最优点 = 载入时的种子车参"（201 行 `self.opt = {k: seed_params[k]}`），响应面是绕最优点的碗状惩罚 `dz=log(v/opt)`（221-226 行），噪声是播种高斯。`perturb_for_sim`（911-923 行）先把种子扰动 ±15%，再让坐标下降"找回去"。
- **一句人话警告**：
  > **42 轮收敛只证明"这台迭代机器能转、不追噪声、能停"，不证明"参数物理上正确"。** 合成模型的真值最优点就是你自己填进 JSON 的种子值——脚本只是把被扰动的种子又找了回来，等于"自己出题自己答对"。实车响应面不是这个碗：可能有多个局部极小、非单调区、迟滞、温漂、电池电压变化。**参数对不对，必须上台架/赛道用真实 LAP 行重跑才知道，别把 best.json 当成"调好了"。**
- **怎么验证（推测部分）**：拿一段真实 LAP 行用 `--replay` 跑（[392-418 行](file:///c:/Users/asus/Desktop/test16/脚本/调参/调参迭代.py#L392-L418) 已留接口），对比 sim 收敛点与 replay 表现是否一致；不一致即坐实"碗≠实车"。

### 5.2 SerialTransport 写参数后无回读校验 —— 超时/丢帧/异常下"以为写进去了其实没生效"【已证实】

- **位置**：[调参迭代.py:330-333](file:///c:/Users/asus/Desktop/test16/脚本/调参/调参迭代.py#L330-L333)（set 无回读）+ [636-639](file:///c:/Users/asus/Desktop/test16/脚本/调参/调参迭代.py#L636-L639)（push_all 吞返回值）
- **异常路径逐条**：
  | 场景 | 代码行为 | 后果 |
  |---|---|---|
  | 超时（`_readline` 返回 None） | `set` 返回 `False` | `push_all` 不检查 → **静默继续 RUN，车带旧参数跑** |
  | 丢帧（OK 丢了） | 同上 | 同上 |
  | 固件返回 `ERR KEY`（键不在白名单） | `line.startswith("OK")=False` → 返回 `False` | 同上，**且不区分"键错"和"超时"** |
  | 固件收到 SET 但解析成别的值（浮点截断） | 返回 `OK` → `set` 返回 `True` | **永远发现不了**，脚本以为写对了 |
- **结论**：用户口述契约的"回读确认"**完全未实现**。这是"不报错、只在实车现形"的头号隐患——串口一旦不稳，整个调参建立在"参数已生效"的假设上，而该假设无任何校验。
- **最小修法**：见 M1（set 后跟 GET 回读 + push_all 检查返回值、失败即 raise 停车）。

---

## 6. 总结：这个脚本现在能不能上实车？

**不能。** 离线策略验证（A 诊断 + B 坐标下降 + 安全阀 + 不追噪声）在合成数据上**勉强自证通过**，可以冻结留档（D1）继续当原型。但**接实车的半条命全是缺口**：

1. **参数写进去没有回读校验**（M1）——串口一抖，调参建立在"参数已生效"的幻觉上；
2. **连续失败不回退**（M2）——文档头承诺的安全阀是死变量，DNF 软失败裸奔；
3. **收不满圈静默降级**（M3）——"每档 2 圈取最差"会悄悄变成"1 圈定生死"；
4. **C 阶段目标函数没时间项 + C 从未跑过**（M4/M5）——"加速"阶段名不副实，二分/回退/触顶零验证。

**缺的临门一脚**（按优先级）：①给 `SerialTransport.set` 加 GET 回读、`push_all` 检查返回值失败即停；②把 `self.consec_fail` 接上 rollback；③`run(n)` 收不满圈判失败；④C-1 加时间门；⑤`p95_gate_mm` 调到能过闸的值复跑 `--sim --phase C`，重生成 best/curve 到 gate 一致。**这五条做完，才谈得上"接实车"；在此之前，best.json 里的参数只是合成碗的碗底，不是赛道的最优。**

---

*本报告由检察官 2026-10-11 出具。只读复核，未改动任何代码/文档/法律正文，未碰 git，未碰实车。所有【已证实】条均可在标注行号处复核；【推测】条已附验证方法。*
