xigua862/SMARTCAR2/100g-wall-climbing-mini-car/100g-wall-climbing-mini-car-master/8.jpg

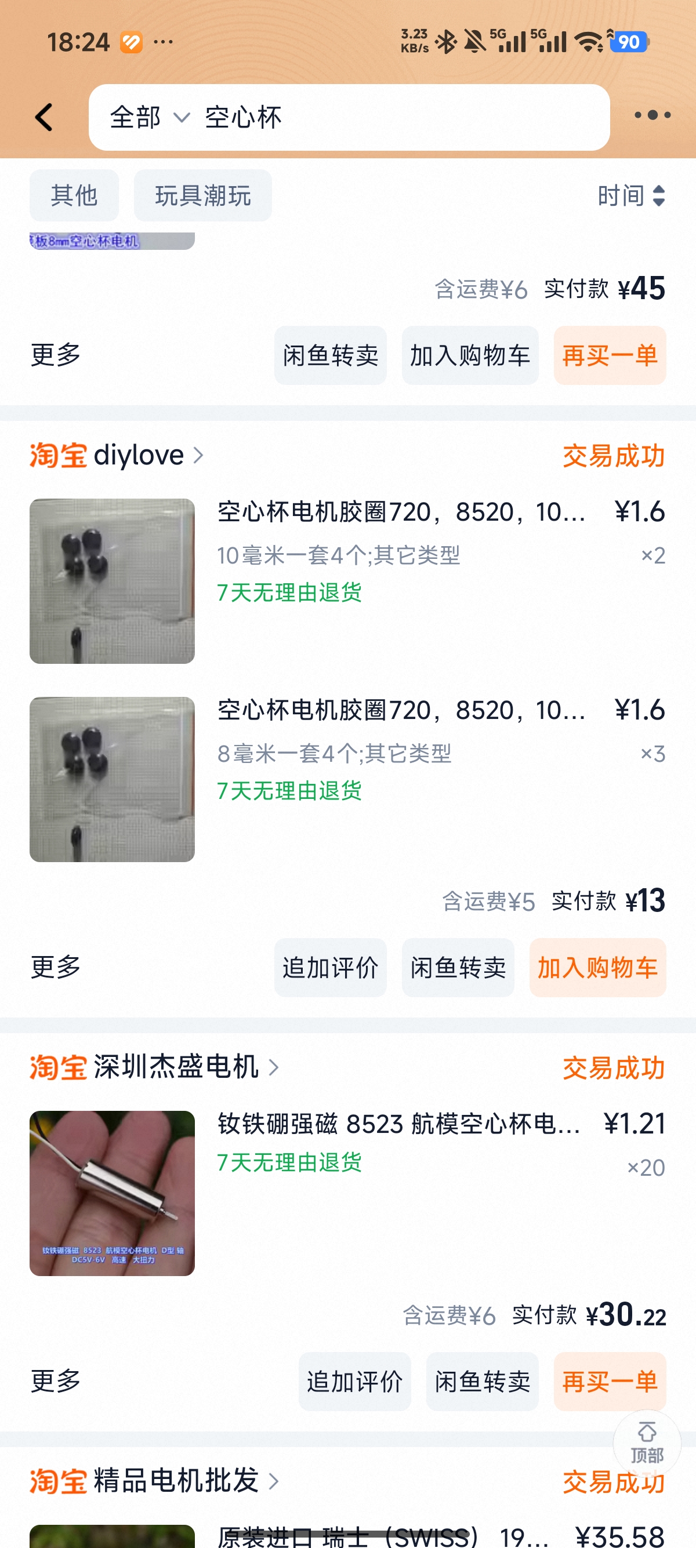
100g-wall-climbing-mini-car/100g-wall-climbing-mini-car-master/8.jpg
