xigua862/SMARTCAR2/CYH-NYY19届负压镜头纯跟踪算法/CYH-NYY19届负压镜头逆透视代码/视觉/灰度分布图/675e270833c9449da3ca24fe6a8cc9e.jpg

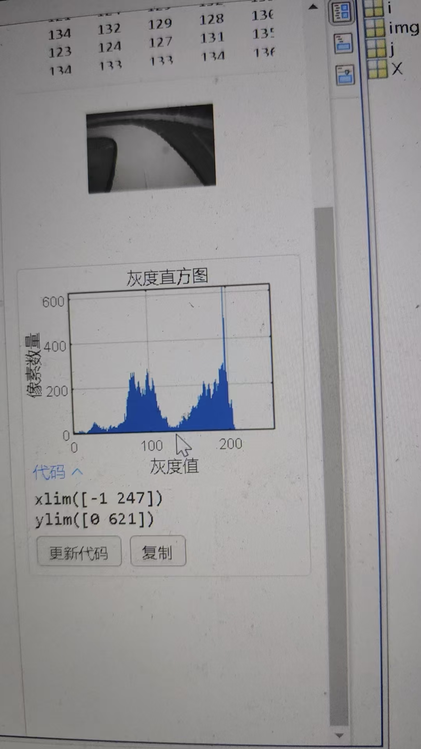
CYH-NYY19届负压镜头纯跟踪算法/CYH-NYY19届负压镜头逆透视代码/视觉/灰度分布图/675e270833c9449da3ca24fe6a8cc9e.jpg
