xigua862/SMARTCAR2/CYH-NYY19届负压镜头纯跟踪算法/CYH-NYY19届负压镜头逆透视代码/视觉/逆透视/逆透视/样本/120度/图片/小s.jpg

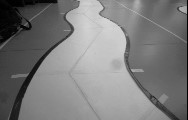
CYH-NYY19届负压镜头纯跟踪算法/CYH-NYY19届负压镜头逆透视代码/视觉/逆透视/逆透视/样本/120度/图片/小s.jpg
