xigua862/SMARTCAR2/地图导出/_dbg_skel.png

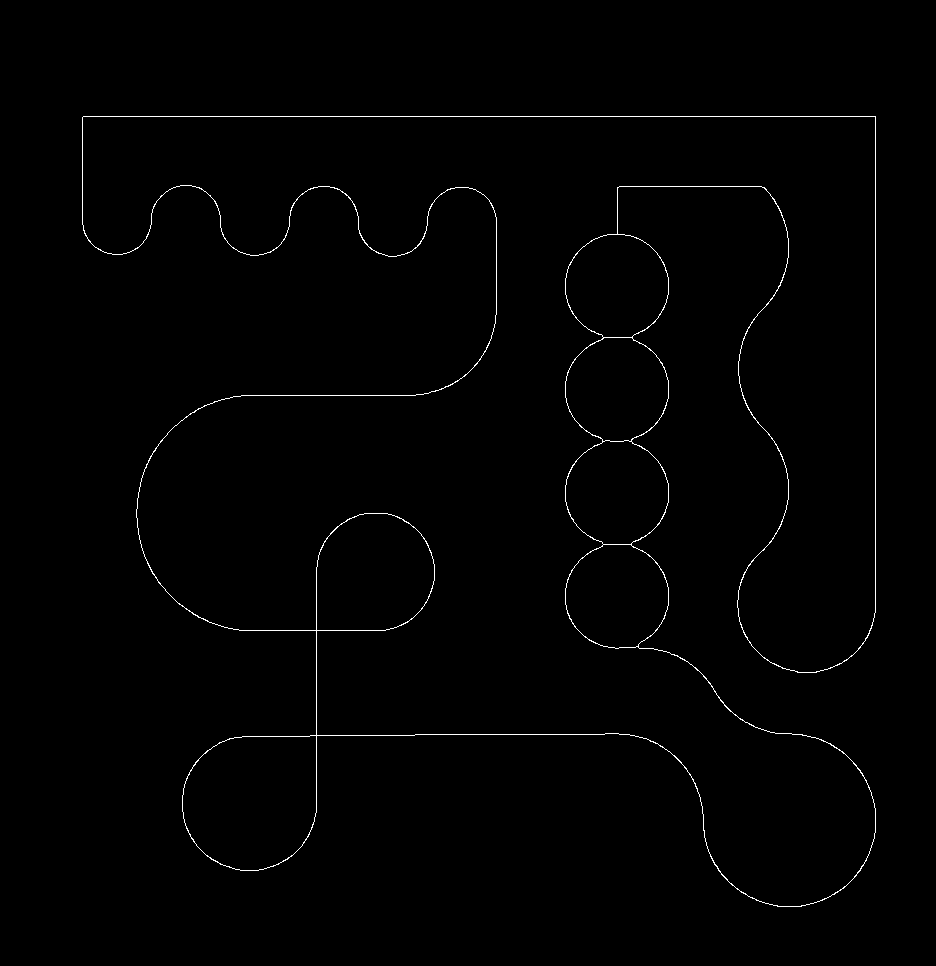
地图导出/_dbg_skel.png
