xigua862/SMARTCAR2/地图导出/_E_新.png

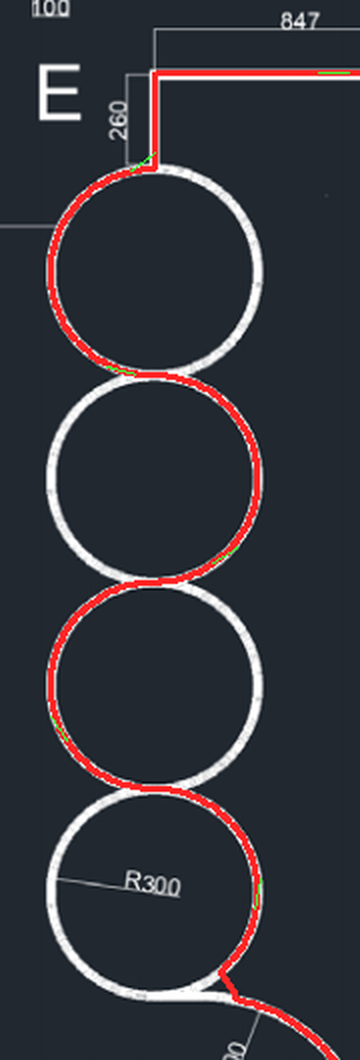
地图导出/_E_新.png
