xigua862/SMARTCAR2/地图导出/_g1.png

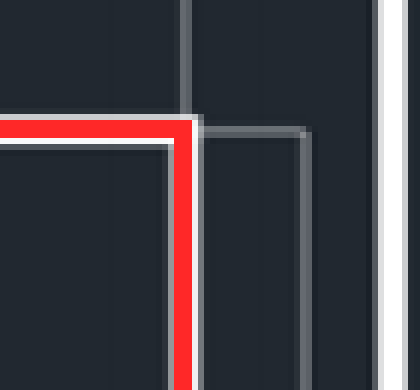
地图导出/_g1.png
