xigua862/SMARTCAR2/地图导出/_g2.png

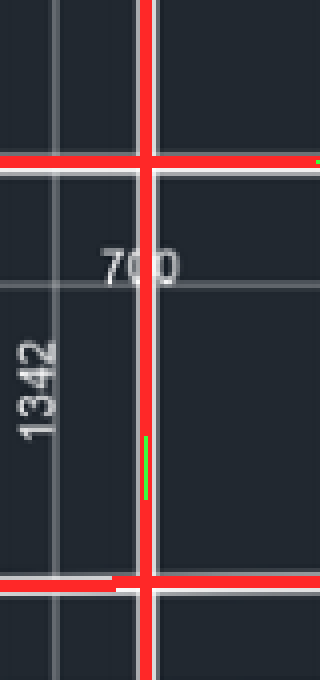
地图导出/_g2.png
