xigua862/SMARTCAR2/开源工程/19届负压镜头-逆透视+纯跟踪/视觉/灰度分布图/a86c2f61fa233148c1cfd85d19f0190.jpg

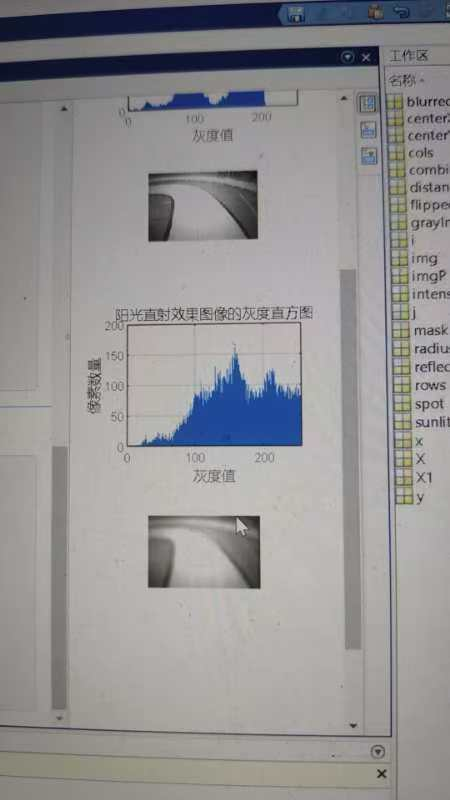
开源工程/19届负压镜头-逆透视+纯跟踪/视觉/灰度分布图/a86c2f61fa233148c1cfd85d19f0190.jpg
