xigua862/SMARTCAR2/开源工程/19届负压镜头-逆透视+纯跟踪/视觉/灰度分布图/d8d6bf0c26bcd2985237ca9120dd95e.jpg

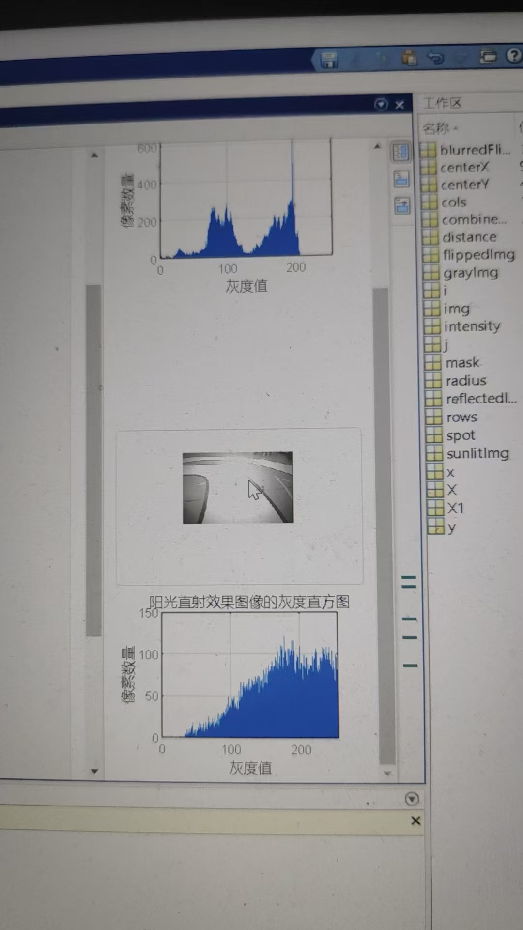
开源工程/19届负压镜头-逆透视+纯跟踪/视觉/灰度分布图/d8d6bf0c26bcd2985237ca9120dd95e.jpg
