xigua862/SMARTCAR2/开源工程/19届负压镜头-逆透视+纯跟踪/视觉/逆透视/逆透视/样本/150度/十字最终.jpg

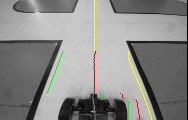
开源工程/19届负压镜头-逆透视+纯跟踪/视觉/逆透视/逆透视/样本/150度/十字最终.jpg
