xigua862/SMARTCAR2/开源工程/惯导矫正仿真/地图预览.png

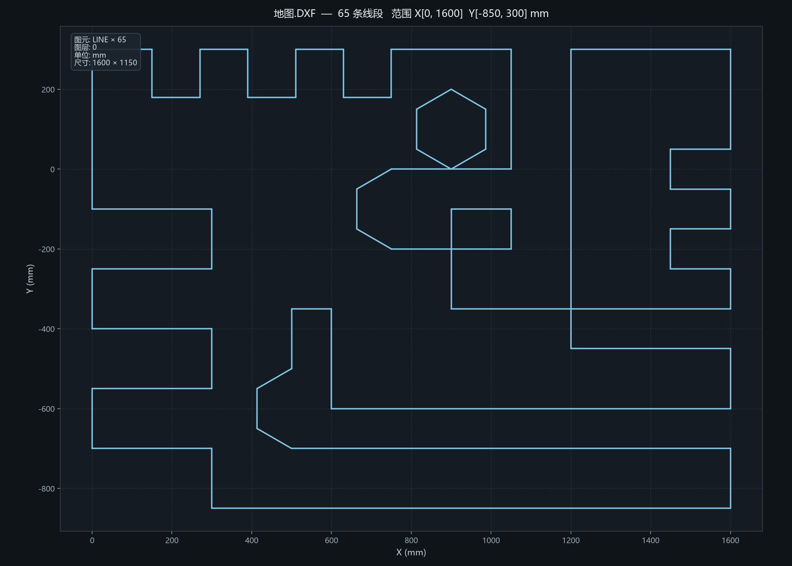
开源工程/惯导矫正仿真/地图预览.png
