xigua862/SMARTCAR2/硬件工程/丝印/丝印-校徽融合机器人工程.png

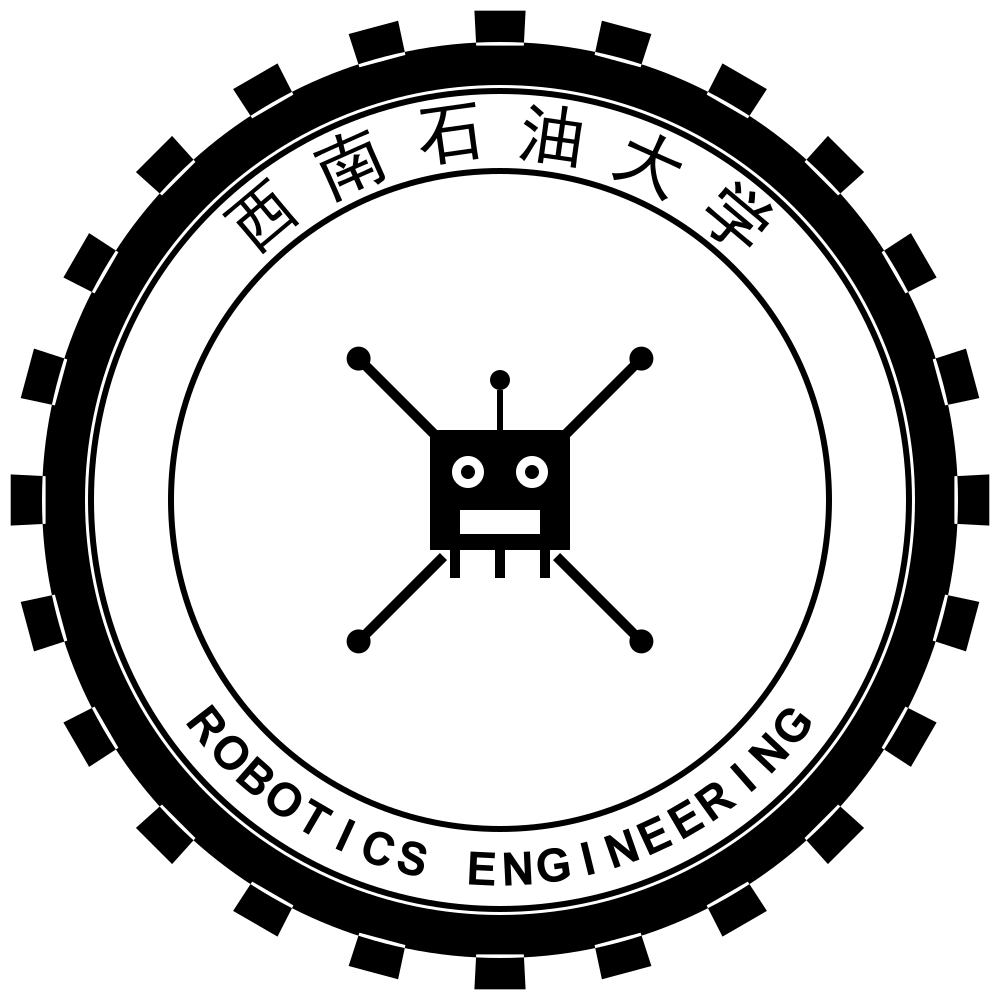
硬件工程/丝印/丝印-校徽融合机器人工程.png
