xigua862/SMARTCAR2/硬件工程/丝印/丝印-西南石油大学机器人工程-透明底.png

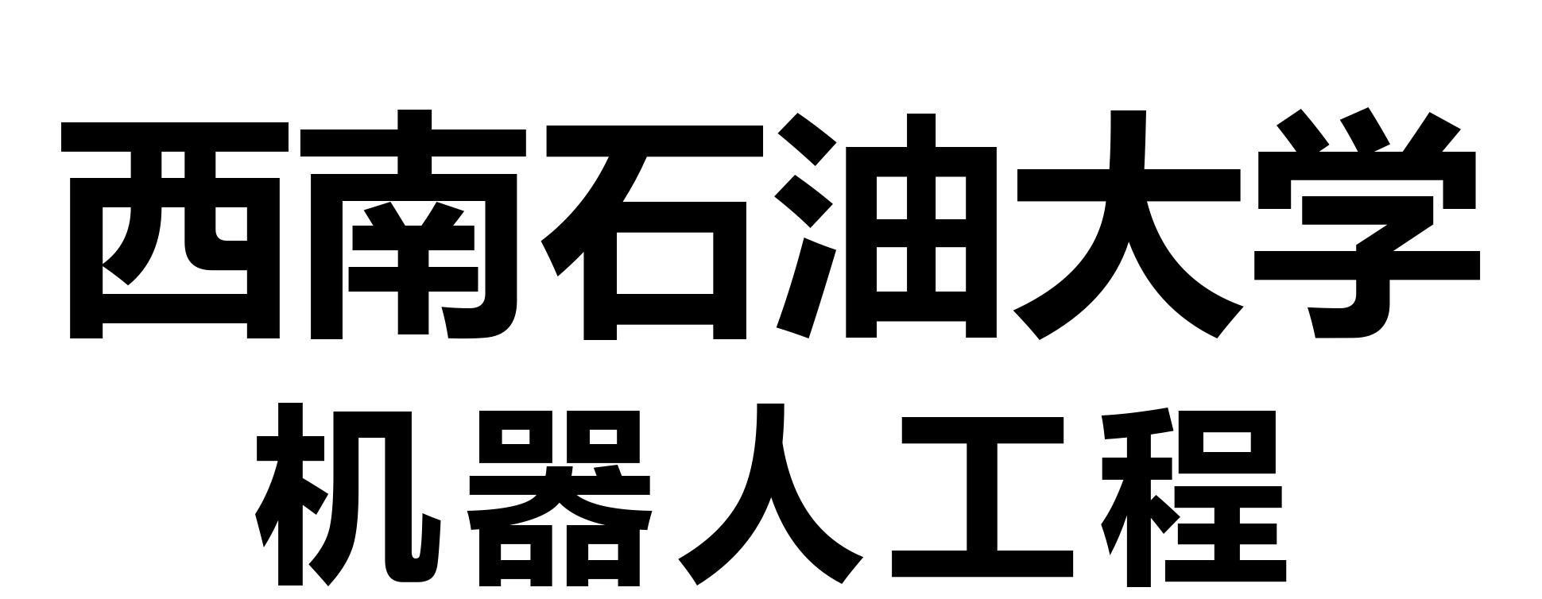
硬件工程/丝印/丝印-西南石油大学机器人工程-透明底.png
