xigua862/SMARTCAR2/硬件工程/丝印/吉祥物-黄胖2-剪影+眼睛-透明底.png

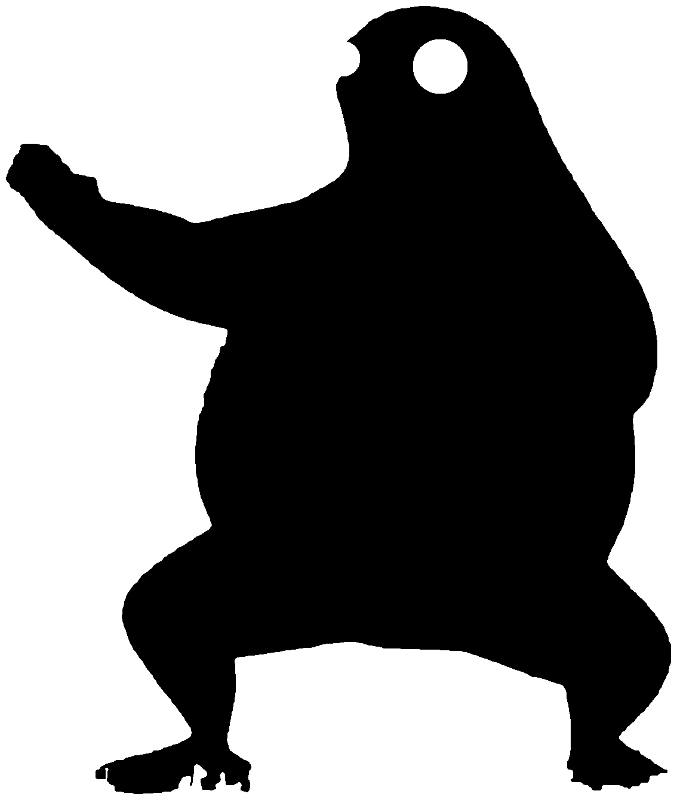
硬件工程/丝印/吉祥物-黄胖2-剪影+眼睛-透明底.png
