xigua862/SMARTCAR2/硬件工程/丝印/徽章-西南石油大学机器人工程.png

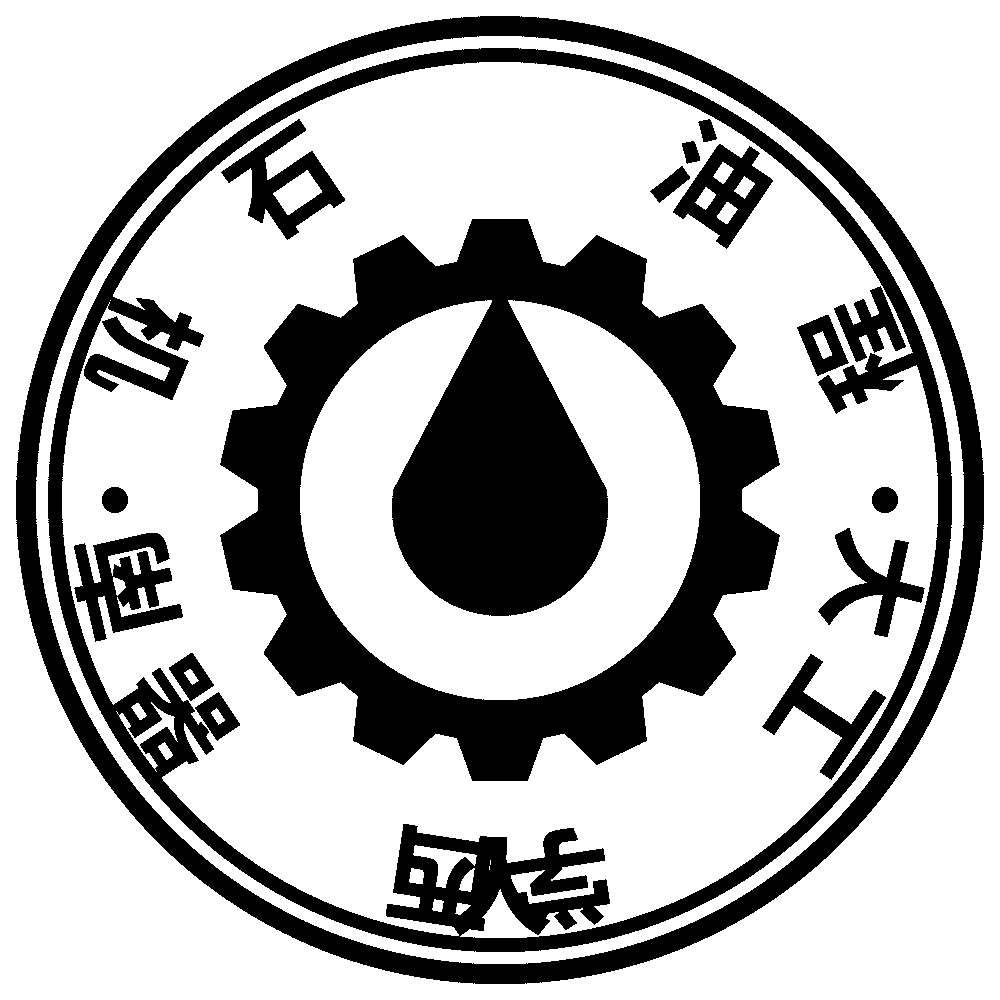
硬件工程/丝印/徽章-西南石油大学机器人工程.png
