xigua862/SMARTCAR2/硬件工程/丝印/校徽-西南石油大学-丝印-精简版-透明底.png

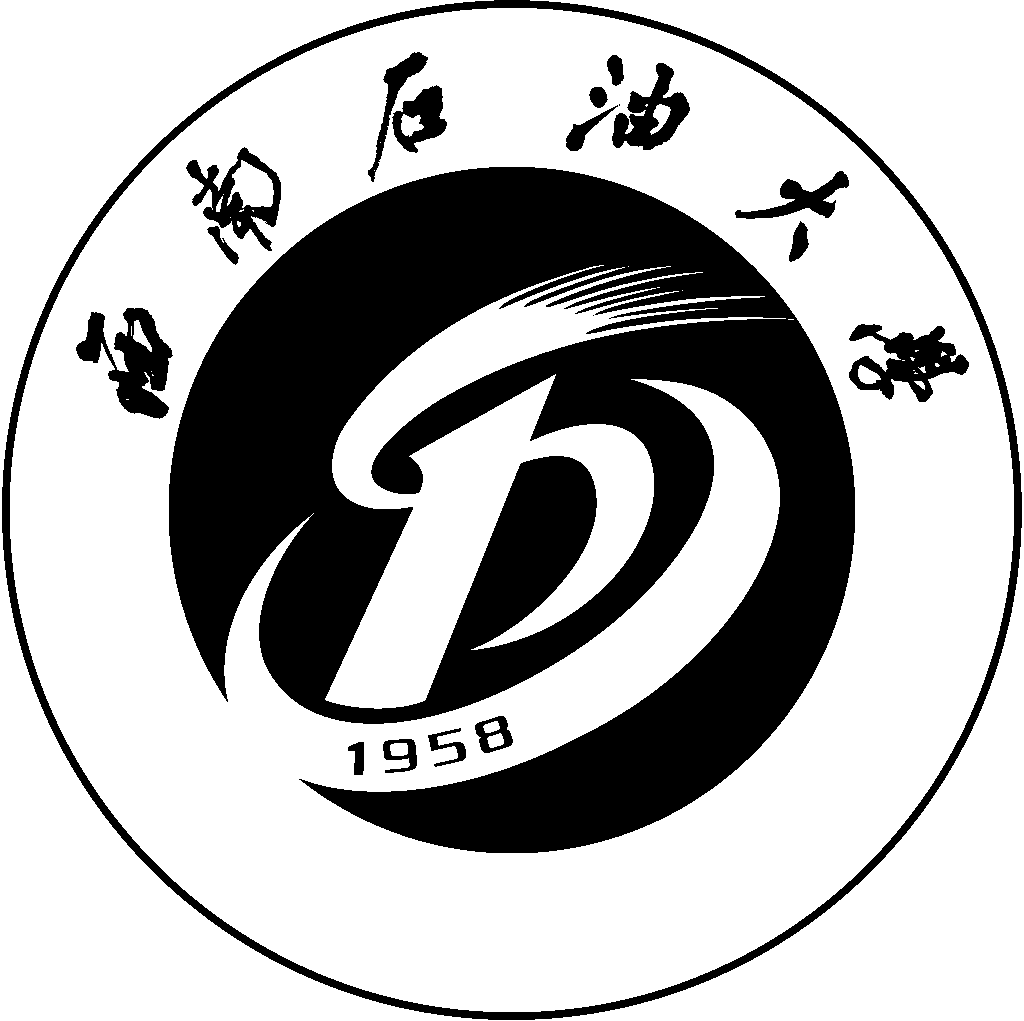
硬件工程/丝印/校徽-西南石油大学-丝印-精简版-透明底.png
