xigua862/SMARTCAR2/文档/购物车清单-B车C8T6-20261002.md

# B 车购物车清单 v1.8 · C8T6 自画板 · 2026-10-03

> 2026-10-03 军师同步 **v1.8**（配套 `框架定稿-B车C8T6-20261002.md` v1.8）
> 取代 `下单清单-今天就能拍板-20261002.md`（2000 元三合一板方案，费用部分作废）
> 前提：**3D 打印免费** + **电机/轮/编码器/陀螺/风机/电池是学长现成件**
> 价格为立创/淘宝**预估**，下单前自己核一遍，**别照抄**。

---

## 0. 总账（v1.8 重算）

| 项 | 金额 |
|---|---|
| 电子元件（含冗余） | **≈ 210** |
| 电池/充/胎皮/杂项 | **≈ 110** |
| 结构件（3D 打印） | **0** |
| 电机/轮/编码器/陀螺/风机/电池 | **0** |
| **合计** | **≈ 320**（v1.7 是 375~395） |

**v1.8 三处变动**：① 灰度改外购模块（自画子板作废）→ **ITR9909/LM393/电位器三项暂缓，省 ~36**；② **电池已有**（自备 3S 2000mAh）→ **省 110**；③ 新增**灰度模块 + 配套连接器**（+~70）与**弹簧垫圈**（+3）。

---

## 1. 手上已有（先确认，别重复买）

| 件 | 参数 | 备注 |
|---|---|---|
| 驱动电机 **SEEKFREE BN30-HSA** ×2 | 11.1V / 33000rpm / 空载 230mA / 堵转力矩 200gf·cm / "<15A" | **内部减速比待查**（决定能不能提速，框架定稿 §7） |
| 带框架的轮子 ×2 | **轮径 23 / 轮宽 22 / 轴距 26 / 轮距 110** | 【实测】完整几何见框架定稿 §1.1 |
| 齿轮 | 轮 **44T(22mm)** / 电机 **10T(5mm)**，0.5 模，合计 54 | 一级 4.4:1；**提速靠换配对**（40+14、34+20） |
| 逐飞增量式迷你编码器 Pro ×2 | 1024 P/R、正交 A/B | ⚠ **带 5mm 齿轮 = 齿轮驱动** → **标度必须推车标定**，不能用 πD/4096 |
| **逐飞 IMU660RC**（LSM6DSV16X）×1 | 8P，丝印 `VCC/GND/SCL-SPC/SDA-SDI/SA0-SDO/CS/INT1/INT2` | ✅ 照片已确认，不买 |
| 负压风机 + 扇叶 + 支架 | 风机 5Ω → 12.6V 约 2.5A | 底板开圆孔 + 4 螺丝孔即可 |
| **3S 11.1V 2000mAh 电池 ×1** | **63×18×15mm**，带平衡头，XT30 | ✅ 已有 → 省 110。⚠ **充电器还没有，必须买** |
| 12V→4.7V 降压模块 | ⚠ **不能用在逻辑轨**（要 5V） | 降级为备件 |
| 实验室 3D 打印 | 免费 | 只打**遮光围裙/法兰/螺纹座**（承力件改用 PCB） |

---

## 2. 必买 · 电子（立创商城一次买齐）

| # | 型号 / 规格 | 数量 | 单价 | 小计 | 备注 |
|---|---|---|---|---|---|
| 1 | **STM32F103C8T6** LQFP48 | 3 | 15 | 45 | 1 装 + 1 备 + 1 练手 |
| 2 | **AT8236N** ESOP-8 单通道 H 桥（杭州中科微） | 6 | 4 | 24 | ★ **买 N 版**：内部 VREF 3.3V（免外部基准）+ **多一个 nFAULT 故障输出**。VM **5.5~36V** / 连续 3A / 峰值 6A。2/车 + 1 负压预留 + 备。**TB6612 不能用**（13.5V/1.2A 不够） |
| 3 | **8MHz 晶振** HC-49S 或 3225 | 3 | 0.6 | 2 | 跑 115200 必须 HSE |
| 4 | **ME6211C33M5G-N**（SOT-23-5，3.3V LDO） | 4 | 1 | 4 | 按实际原理图；3.3V 只喂 MCU/IMU/编码器/LED ≈**120mA** → 够。⚠ 严禁 RT9013 |
| 5 | 0603/0805 阻容包（上拉/退耦/晶振负载/BOOT0 下拉）+ **灰度 8 组分压：1k×8 + 1.5k×8 + 100nF×8** | 1 包 | 25 | 25 | ⚠ **不再需要子板那套**（180Ω/470k/470Ω/10k×17、100pF）；★ 新增的是「并出」模式的 8 组分压 |
| 6 | 电解 470µF/25V + 100µF/16V | 各 2 | 1 | 6 | 功率轨就近 / DCDC 输出 |
| 7 | 磁珠 600Ω@100MHz（0805） | 10 | 0.3 | 3 | 单点地、电机 OUT 端 |
| 8 | **AT8236 采样电阻 0.11Ω / ≥1W（2512）** | 6 | 1 | 6 | 手册公式 `ITRIP = VREF/(10·R_ISEN)`；AT8236N 内部 VREF 3.3V → R=0.11Ω 得 **3.0A**。⚠ **ISEN 绝对最大仅 0.5V ⇒ R ≤ 0.167Ω**；**不是 mΩ 级**（原稿写错）。详见 `文档/AT8236-照这个画-20261003.md` |
| 9 | XT30 公母带线 | 4 对 | 3 | 12 | 电池 / 充电口 |
| 10 | **VM 轨：一次性慢熔贴片保险丝 10A**（2410，6.1×2.6mm，如 BSMD2410C-2100T）+ **逻辑轨：PTC 0.5A**（SMD1206-050-16） | 各 4 | 2 | 16 | ★ **两路分开**：VM 用一次性慢熔（正常永不烧，**备 3 片**）；逻辑轨用 0.5A PTC（旧板 F1 同款）。⚠ VM 峰值 4~6A（最坏 8.5A）→ 10A 不会误断，死短路则立断 |
| 11 | 2.54 排针/排母（SWD 4P、**IMU 8P**、**灰度模块接口**、板间若拆板） | 1 组 | 12 | 12 | ⚠ **11P 子板排针作废** |
| 12 | 蜂鸣器（**有源 5V**，2.4kHz）+ **SS8050** + 1N4148W | 4 | 1.5 | 6 | 上电自检发声。⚠ **有源 = 只开/关，不能 PWM 调音**；负载在 5V、基极由 3.3V 驱动 |
| 13 | 轻触键 6×6 | 8 | 0.3 | 2 | |
| 14 | LED 0805 红/绿 | 10 | 0.1 | 1 | |
| 15 | **12V→5V 降压模块**（**必须 5V**，连续 **≥400mA**） | 2 | 4 | 8 | ★ 灰度模块走 5V（≈170）+ LDO 输入（≈120）≈290mA；4.7V 不行；输出并 220µF 降纹波 |
| 16 | **灰度模块：龙邱 8 路模拟量循迹模块**（有「并出」/「串出」两种输出） | **1 + 备 1** | ~60 | ~60 | ★ **我们用「并出」10P**：A0~A7 → PA0~PA7（ADC 扫描 + DMA，零偏斜、≈10µs）。3.3~5V 宽压。⚠ 网页提示"建议备份至少一个模块"——**听它的** |
| 17 | **灰度模块配套连接器 + 线**（照模块接口配，XH2.54/GH1.25） | 1 套 | ~10 | ~10 | 别等模块到了再补 |
| 18 | **PCB 打样（2 层）**：结构底板 + 电路板（+可选驱动板） | 2~3 单 | 0~15 | 0~45 | 结构底板：**2.0mm + 双面铺铜 + 哑黑阻焊** |
| 19 | **弹簧垫圈 M2**（长槽夹紧用） | 20 | 0.1 | 2 | 防振动松脱 |
| | **电子小计** | | | **≈ 210** | |

### ⏸ 暂缓（**别删、别买**）——自画灰度子板作废，但它是唯一退路

| 件 | 为什么留着 |
|---|---|
| ITR9909 ×20 | 若喷绘布 940nm 对比度不过关、又找不到 6mm 可用 + settling ≤20µs 的模块，**自画子板是唯一退路** |
| LM393 ×8 / 多圈电位器 ×20 | 同上 |

---

## 3. 必买 · 动力与行走（淘宝）

| # | 件 | 数量 | 单价 | 小计 | 备注 |
|---|---|---|---|---|---|
| 20 | ~~3S 锂电~~ | — | — | **0** | ✅ **已有**（2000mAh，63×18×15） |
| 21 | **B3 平衡充** | 1 | 45 | 45 | ★ 没充电器电池就是消耗品，**别漏** |
| 22 | **胎皮**（牛爷爷硅胶包海绵 / 青山世一） | 2 套 | 15 | 30 | ★ 开源原话"抓地第一"，**唯一买得到的物理上限，不打折** |
| 23 | 大棚膜 2㎡（负压裙边）+ 纳米胶 | 1 | 6 | 6 | 作者实测 2㎡ 2.6 元 |
| 24 | **M2 铜柱/螺丝/尼龙垫片** + **六面螺母 6×6×6** | 1 包 | 20 | 20 | ⚠ 侧框架孔是 **φ2**，要配螺母/六角螺母 |
| 25 | 18AWG 硅胶线 + 热缩管 | 1 | 15 | 15 | 电机线双绞、≤10cm |
| 26 | 减震柱/橡胶垫（陀螺仪用） | 1 | 6 | 6 | 扇叶共振→螺丝松→陀螺漂 |
| 27 | **螺纹胶** + 502 + 扎带 | 1 | 8 | 8 | ★ 螺纹胶必须有（长槽接头/震动） |
| | **动力杂项小计** | | | **≈ 130** | |

---

## 4. 明确**不买**

| 划掉的 | 原因 |
|---|---|
| STC32G + 第二片 MCU | 平台定 C8T6 |
| DRV8701E + 分立 MOS | 手焊风险高，被 AT8236 全集成替代 |
| ICM-42688 LGA 手焊 | 已有现成陀螺模块 |
| **碳板** | **导电**（旁边就是模拟线/5V）；且校赛**不称重** ⇒ "轻"这个优势等于零。结构件改用 **PCB** |
| **3D 打印做底板/结构件** | 蠕变、刚性不足；开源作者原话"能用碳板用碳板，不要用 3d 打印"→ 他并列推荐 PCB |
| **船型开关** | 插件件、朝下会刮/误动作；**优先取消**，用"发车时插 XT30"当总开关 |
| TB6612 / DRV8833 / MX1508 / L298N | 耐压或电流不合规 |
| SMT 贴片工程费 | 全手焊 |

---

## 5. 下单前必须确认的 5 件事

1. **学长件齐不齐**：N30×2、轮+框架×2、编码器 Pro×2、风机+扇叶+支架、IMU660RC、3S 电池 —— **充电器不在其中，要买**。
2. **灰度模块先问客服 8 条**（框架定稿 §2.4）：路数 / 档距（要板框图+标尺）/ **最小检测高度** / 输出电平 / 波长 / **地址切换 settling** / 板框尺寸 / 供电。**最关键两条：最小检测高度（6mm 能不能认线）、settling（≤20µs）**。
3. **5V 降压模块**：输出必须 **5V**（不是 4.7V）；输入耐压吃 12.6V；连续 **≥400mA**（灰度模块 170 + LDO 输入 120 ≈ 290mA）；纹波靠 220µF + LDO 压住（纹波直进陀螺仪 = Z 零偏漂）。
4. **AT8236 采样电阻阻值**：手册公式 `ITRIP = VREF / (10·R_ISEN)`。**用 AT8236N**（内部 VREF=3.3V）→ 要 3A 就 **R = 0.11Ω**；⚠ ISEN 绝对最大 0.5V ⇒ **R ≤ 0.167Ω**（0.2Ω 不行）。详见 `文档/AT8236-照这个画-20261003.md`。
5. **PCB 打样规格**：结构底板写 **2.0mm 板厚 + 双面铺铜 + 哑黑阻焊**（哑黑=遮光，绿油在近红外下会透光）。

---

## 6. 花钱优先级

```
① 灰度模块 + 5V 模块 + 主芯片   ← 车能不能跑
② 胎皮                        ← 唯一买得到的物理上限
③ 充电器                      ← 没它一天只能跑一趟
④ 结构 PCB / 电路板打样        ← 打样券常免
⑤ 负压整套（第 3 颗 AT8236）    ← 可 0 元先留焊盘、暂不装
⑥ 备用芯片/备用板              ← 最可砍，但砍了出事就没法比赛
```

## 7. 修订记录

- **v1.8（2026-10-03）**：灰度改**外购龙邱 8 路模拟量模块**（+60）与配套连接器（+10），ITR9909/LM393/电位器**三项暂缓**（−36，作退路保留）；**电池已有**（−110）；新增**弹簧垫圈 M2**（+2）；**船型开关取消**；**碳板与 3D 打印结构件改 PCB**；5V 模块要求 **≥400mA**（灰度模块走 5V）；PCB 打样改为"结构底板 + 电路板（+可选驱动板）"，并指定 **2.0mm/双面铺铜/哑黑阻焊**。总账 ≈320。
- **v1.8 当日补订（画板评审后，2026-10-03）**：① **灰度模块改走 5V**（宽压下发射管更亮 → 直接对冲"喷绘布对比度"这个头号风险；且不占 LDO）⇒ **5V 模块要求回到 ≥400mA**；② **灰度改用「并出」**：A0~A7 → PA0~PA7（8 路 ADC + 扫描/DMA，**零偏斜、≈10µs**），模块供 5V ⇒ **8 路各一组 1k/1.5k 分压 + 100nF**（16 只电阻 + 8 只电容，并进阻容包）；③ **LDO 定为 ME6211C33M5G-N**（按实际原理图，3.3V 负载 ≈120mA）。
- **v1.7（2026-10-02）**：子板恢复双轨；新增必买 12V→5V ≥400mA；R1 82Ω→180Ω/0805。总账 375~395。
- **v1.6 / v1.5 / v1.4 / v1.3 / v1.2 / v1.1 / v1（2026-10-02）**：见旧版留档（子板单/双轨反复、ITR9909 定型号、IMU 核实、编码器装轮轴等）。⚠ **其中"编码器装轮轴"已被 v1.8 推翻。**
