xigua862/SMARTCAR2/文档/待并入v1.8-清单-20261003.md

> ✅ **2026-10-03：本清单已整批并入 `框架定稿-B车C8T6-20261002.md` v1.8 与 `购物车清单-B车C8T6-20261002.md` v1.8。**
> **本文降为"增量来源记录"留档**——以后要查"这个结论是怎么来的/当时的原始增量"，看这里；**要动手改设计，一律以 v1.8 正文为准。**
> 结构：§一 新确认事实 / §二 6 个待测数 / §三 规则依据 / §三·补 2 惯导主线 / §四 军师自查待改项 / **§五 实测值（2026-10-03 追加）**

---

# 待并入 v1.8 的清单（纯追加，正文未改）

> 2026-10-03 建立 · 作者：军师
> **纪律：数据未定之前，`框架定稿-B车C8T6` 正文一个数字都不改。** 本清单只收集增量，等 6 个实测数到齐后**一次性并入 v1.8**（一次成型，不做 1.8a/1.8b）。

---

## 一、用户新确认的事实（2026-10-02 夜，口述）

1. **驱动构型 = 2 个电机**：每侧一个 N30 带动同侧两个轮，**同侧两轮同速同转**；编码器**每侧一个、与齿轮平齐**。
   → 硬件口径自洽：2 电机 ×（IN1/IN2）= 四路 PWM + 2×AT8236（4 半桥）✓；2 路编码器（PA15/PB3 + PB4/PB5）✓
   ⚠ §2.3/§7 的"双电机"表述**正确，不要改成 4 电机**（军师 10-02 曾误判 4 电机，**已撤销**）
2. **行为等价**：同侧两轮同速 ⇒ 等价于"每侧一个大接触面的差速车"，转向中心在**两轴中点**。
   ⚠ **"同侧前后轮反向拖拽 ω·L"这个机制在本车上不存在**（军师 10-02 的推断，**已撤销**）。
   真实代价 = 整侧横向刮擦 `ω·b/2`（R200、1.2m/s → ω=6rad/s、b=110 → **≈0.33 m/s**），**与轴距无关**
3. **赛道布 = 喷绘布（已确认）** ⇒ §4 里"黑色哑光喷绘布"不再是"待定"，但**940nm 穿透风险升级为最高优先级**：
   买两块不同波长（940nm + 红/白光）成品模块，布上做黑白对比验证。
   **判据**：LED 黑白分明 + 万用表 DO 两态差 **≥1.0V**
4. **参考图（淘宝车模尺寸图）≠ 本车真值**：只能引用"**结构关系 + 齿数标注方式**"；
   图中 **轮径 24.30 / 同侧轮中心距 25.50 / 总高 55 / 140 系列孔位链** 一律**不得**当本车数据（黑名单第 1 条）

## 二、需实测的 6 个数（明天量，拍照最省事）

| # | 量什么 | 用途 |
|---|---|---|
| 1 | **轮径 D**（软尺绕胎一圈 ÷ π） | `mm/count = π·D/4096`；牵引力换算 |
| 2 | **同侧两轮中心距** | 转向中心/前瞻几何 |
| 3 | **左右轮中心距**（复核 110） | 差速比、抗侧倾 |
| 4 | **单轮宽**（复核 22）+ 说明参考图上"7"指什么 | 板宽 88 的成因复核 |
| 5 | **齿轮齿数**：电机齿轮 ?T / 轮毂齿轮 ?T | **决定齿比 → 决定"提速旋钮"往哪拧** |
| 6 | **电机+齿轮箱外形包络**（长×宽×高，含输出轴）+ 横放/纵放 | 底板布局硬约束 |

## 三·补、规则依据（2026-10-03 查证，来源：test17\文档\5.机器车循迹比赛规则.pdf）

> ✅ **口径已确认（用户 2026-10-03）**：微缩车（B 车）报的**就是本赛项（机器车循迹）**，下列条款全部生效。
> 用户定位：**"微缩车做好了进这个比赛＝降维打击"** → 军师量化如下。

### 微缩车的优势与代价（量化，供 v1.8 设计输入）

| 项 | 我们（b=110） | 大车（b=150 / 200） | 结论 |
|---|---|---|---|
| R200 上差速比 `(R+b/2)/(R−b/2)` | **1.76** | 2.2 / 3.0 | 小轮距=物理优势 |
| 内外轮速差 `v·b/R` @1.2m/s | **0.66 m/s** | 0.90 / 1.20 | 驱动更从容 |
| 转动惯量 `I ∝ mL²+b²` | 小 | 大 | 响应更快 |
| 弧上前缘扫出 | 小 | 大 | 不易压相邻线 |

**★但有一处必须补的短板**：判据延迟的**绝对位移与车长无关** —— 1.2m/s × 50ms（10ms 拍×5）= **60mm**；对 66mm 车长的我们 = **0.9 个车身**（大车只是 1/5 车身）⇒ **容错相对紧一倍以上**。
⇒ **设计输入：控制/判据周期 10ms → 5ms（甚至 3ms）**，判据窗口拍数同步压缩；前瞻"短而准"。

| 条款（原文要点） | 对我们的作用 |
|---|---|
| **"机器车垂直投影最大宽度不能超过 30 cm"**（唯一宽度条款） | ⇒ **88mm 不是限宽**，是车板宽度（军师 10-03 已更正措辞）；合规上限 300mm，我们 132mm 远低于它 |
| **"机器车主控制器、传感器均不限制"** | 自画 C8T6 + 外购灰度模块**合规** ✓ |
| **电路板（主控/电机驱动/传感器至少选其一）必须出现"2026 机器车循迹+队伍名"丝印** | ★**进画板检查表**：主板/子板至少一块印，检录要能看清 |
| **严禁购买成品车模或不作改动使用实验室现成作品** | **合规站得住**（用户 2026-10-03 更正军师误判）：**车体＝用户自画 3D 打印**；**电控＝自画板 + 丝印已有**；**固件自写**；**唯一外来件＝侧框架组件（学长车上拆的结构件，轮子/电机/编码器都嵌在上面、随件一并拆下）** ⇒ 属零件复用，非"整车现成作品"。检录话术："车体自画 3D 打印、电控自画带丝印、固件自写；仅侧框架组件为复用件" |
| 场地：5m×5m、**黑色哑光喷绘布（550 布）**、**25mm 白线**、线与外框 ≥200mm；S-G 斑马线间隔 **400mm**、斑马线中心距 **50mm** | 与现有《赛道情报》一致 ✓（940nm 穿透风险仍按最高优先级处理） |
| **脱线判定**："接触地面的车轮不允许明显全部出现在循迹线同一侧"（可短暂压线） | 进判据/几何设计输入 |
| 15 分钟内 2 次发车；**成绩按行驶距离积分**+时间排名 | 与"先锁完赛/跑远"策略一致 ✓ |

## 三·补 2、★架构主线：**惯导为主、光电为辅**（用户 2026-10-03 口述）

> 用户原话："**我们的车主线是惯导喔，光电不过是辅助**"。方案级信息，影响选型 / 判据 / 标定 / 验收。

**IMU 型号（文档记录）**：**逐飞 IMU660RC（芯片 LSM6DSV16X）** —— 见《框架定稿》v1.1"三项确认" + 《交接2》§6 核实（无 UART、只有 I2C/SPI；SPI2 分频 /4 = 9MHz；**SDO=SA0 复用、SPI 下严禁接地/接 3V3**；8P 座含 INT1/INT2）。

⚠ **型号混淆警告（防带偏）**：库里另有 `ICM-42688-P`（**已作废的 2000 元三合一板方案** + 开源车参考件）与 `MPU6500`（**A 车**陀螺 + 用户 9/28 拼单价）—— **都不是 B 车这件**。
⚠ **待实物确认**：看侧框架上陀螺模块的丝印，确认是否"逐飞 IMU660RC"（惯导主线全靠它，错了代码全废）。

| 影响 | 说明 |
|---|---|
| **IMU 升为头号关键件** | 主传感器 ⇒ 零偏稳定性 / 噪声 / 温漂决定成败 |
| **第一道门（尽早测）** | 静止 10s 航向漂移 <1°、60s 漂多少、零偏重复性 → 不过则"惯导主线"降级 |
| **灰度选型压力↓** | 光电仅做脱线保护 + 位置修正 ⇒ **不需要亚档距精度** ⇒ 地址选通的时间偏斜问题**降级**（settling 容忍度放宽） |
| **判据体系改** | 元素识别（十字 / 圆环 / 终点 / 斑马线）以 **里程 + 航向 + 已知赛道几何（CAD）** 为主，光电做修正/保护 |
| **标定升为主线** | ①上电静止零偏 ②**积分必须用实测 dt**（禁假设固定节拍）③里程 `πD/4096` + 打滑修正 |
| **★最大风险** | 漂移累积 → 必须设计 **地标重置点**（过十字/斑马线时用光电重新对齐航向或里程） |

**成本口径同步更正**：轮子 / 电机 / 编码器 / 负压风机 **随侧框架一并拆下（免费）**，**陀螺仪也免费**；需采购的是 C8T6 + 2×AT8236 + 电源器件 + 接插件 + **外购灰度模块**。

## 四、军师 10-02 审查出的待改项（数值等实测，先记不先改）

| 组 | 项 |
|---|---|
| **A 已被今天推翻、正文仍带"定稿"标签** | §1.1 尺寸表（75~85 / 总长≤130）；§2.5 整节收腰 + "板宽 88 比轮距略宽"错警；§2.1/§2.4 自画子板（应降级留档）；§8 缺 v1.8 记录 |
| **B 标签与证据不匹配** | §4 把喷绘布写成事实；§2.2 "RT9013 只 250mA"待核 datasheet；§2.4 "现成模块就栽在挂 100nF"是对成品模块的**断言**→改"买回实测"；§2.5 "捕获范围 ±52.5" 与交接2 的 "±44" **口径不一致**（须给定义）；§2.5 "精度预期"未标"估算" |
| **C 口径复核** | **C1 已撤销**（"负压 ×4.4" 是对的：1.2kgf+0.35kg → 1.55/0.35 = 4.43 ✓）；C2 §7 牵引 27.6N 用的是 D≈42.6 口径、与 §1.3 的 D=32 不一致 → 轮径实测后统一；C3 §1.1 "驱动轴→车尾"套了前瞻公式（`d²/2R`），**依据要换**（后悬摆出去吃转向半径） |
| **D 缺项** | **USART1 用 PB6/PB7 必须重映射**（应进"必踩软件坑"）；**输入侧缺 TVS / 反接保护**；§2.3 表里 PB1/PB2 的 5V 容忍栏空着（PB1 非 FT） |

## 四、明天之后的分工（建议）

1. **用户**：量 6 个数（拍照丢对话）+ 画中间底盘（侧边组件已建模）→ **顺手下单两块不同波长模块**（48~70 元档）
2. **军师（我）**：数据到齐后**一次性出 v1.8**（正文 + 引脚图 html + 购物车清单同步提交），并给一份**《底板设计输入表》**——轮廓/孔位/电机座/灰度板前伸/负压孔/电池位，按用户画图习惯给：**Y=长边、X=宽、X=0 对称轴、先画一半再镜像**

---

## 五、追加 · 2026-10-03 实测值（口述 + 照片，**进 v1.8 的原始数据**）

| # | 项 | **实测值** | 直接用途 |
|---|---|---|---|
| 1 | 轮径 D | **23 mm** | 周长 72.26mm；标度基准 |
| 2 | **轴距**（同侧前后轮中心距） | **26 mm** | ★转向中心在两轴中点 → 前瞻基准（见下） |
| 3 | 轮上齿轮直径 | **22 mm**（每轮一个） | 一级齿比 22/5 = **4.4** |
| 4 | 电机自带齿轮直径 | **5 mm** | 同上 |
| 5 | 编码器齿轮直径 | **5 mm** | ⚠ 说明编码器是**齿轮驱动**，不在轮轴上 → 见"前提被推翻" |
| 6 | 侧框架孔位（最前孔为原点，y 向后） | **(0,9) (0,26) (0,35) (0,49)**，孔 **φ2mm**，**上下都有孔** | 0→26 正好 = 轴距 ⇒ 这两个就是前后轴承孔 |
| 7 | 电池 | **3S 11.1V 2000mAh，63×18×15mm**，带平衡头，接口可选 XT30 | 已有（0 元）；尺寸 = 底板硬输入 |
| 8 | IMU | **✅ 照片确认 = 逐飞 IMU660RC（8P）** | 型号风险解除 |

**IMU 丝印引脚序（主板排针照这个画，别自己排）**：
`VCC / GND / SCL-SPC / SDA-SDI / SA0-SDO / CS / INT1 / INT2`

**电机型号（照片丝印）**：**SEEKFREE `BN30-HSA`**

### ⚠ 前提被推翻：`mm/count = πD/4096` 不成立

`框架定稿 §1.3` 与 `购物车 §1` 都写"编码器已确认装在**轮轴**"，据此"减速比彻底不用知道"。
**但实测编码器带一个 5mm 齿轮 → 它是齿轮驱动的**。若咬轮上 22mm 齿轮，编码器轴 : 轮 = **22/5 = 4.4**：

| k = 编码器转数/轮转数 | mm/count | 1.2m/s 计数率 | 16 位溢出(72MHz) |
|---|---|---|---|
| 1（旧假设） | 0.01764 | 68 kHz | 0.96 s |
| **4.4（按齿轮算）** | **0.00401** | **299 kHz** | **0.22 s** |

**处理：不要推导，直接标定。** 把 §1.3 的"推车 1m 数脉冲"从**校验**升为**主标定** → `mm/count = 1000 / counts`，k 与 D 都不必知道。
⚠ 先确认 TIM 硬件编码器接口吃得下 299kHz（F103 可以，但只在 10ms 窗口读、不开中断）。

### 还要查：电机总减速比

22/5 = 4.4 只是**一级**，N30 内部还有减速箱 → **总比 = 内部比 × 4.4** 未知：

| 总减速比 | 轮转速 | 理论最高速(D=23) |
|---|---|---|
| 4.4（假设无内部减速） | 7500 rpm | 9.03 m/s（离谱 ⇒ 一定有内部减速） |
| 22 | 1500 rpm | 1.81 m/s |
| 44 | 750 rpm | 0.90 m/s |

→ **查 BN30-HSA 的减速比**。判据：R200 瓶颈需 1.1~1.4 m/s ⇒ 总比落在 **约 22~40** 最合适。

### 前瞻重算（轴距 26 ⇒ 转向中心在前轴后 13mm）

`d = L + 13`，稳态跟弧偏差 ≈ `d²/(2R)`：

| 灰度前缘→前轴 L | d | R200 偏差 | 占 11mm 档 |
|---|---|---|---|
| 25 mm | 38 | 3.61 mm | 0.33 |
| 35 mm | 48 | 5.76 mm | 0.52 |
| 45 mm | 58 | **8.41 mm** | 0.76 |

→ 轴距只有 26mm（很短）⇒ 前瞻稳态偏差远小于按 60mm 的旧估 ⇒ **45mm 上限可以保留**。
