xigua862/SMARTCAR2/文档/下单清单-今天就能拍板-20261002.md

# 下单清单 · 今天就能拍板 · 2026-10-02

> ### ⛔ 本文件**费用与器件部分已作废**（2026-10-02 同日更新）
> 前提变了：**3D 打印免费 + 电机/轮/编码器/风机全是学长现成件** → 2000 元三合一板方案不再需要。
> **请看 → `购物车清单-B车C8T6-20261002.md`（总账 ≈370，单车增量 ≈190）
> 与 `框架定稿-B车C8T6-20261002.md` / `引脚图-B车C8T6-20261002.html`。**
> 本文件保留价值：§1 电源定稿、§3 负压风机=有刷电机的判定、赛道事实 —— 仍然有效。

> 口径变更（你刚说的三条，全部采纳）：
> **① 不要求重量**（普通省赛，只要快）→ **撤销所有减重优化**，负压风机**整套保留**。
> **② 驱动电机 = 微缩组标配、逐飞车模自带那种（030 级有刷）** → 不用另选型。
> **③ 负压风机万用表量到 5Ω、两根线** → **它就是有刷电机** → **无感换向那条链（EG2134 + 6 MOS + 第 2 片 STC32G）当场删除**。
> 目标：**能下单 → 能跑起来**，不再做优化。

---

## 1. 电源定稿（不用再算了，就这个）

| 项 | 定稿值 | 依据 |
|---|---|---|
| 电池 | **3S 锂聚 11.1V**，满电 12.6V，**9.6V 停跑** | 严禁 4S（入口 TVS `SMAJ16CA` 16V 钳位） |
| 容量 | **450~600mAh**（不再追小容量） | 不要求重量 → 大电池**压降小、发热低、续航长、更便宜**，纯粹更好 |
| 倍率 | **≥20C**（450mAh×20C=9A / 600mAh×20C=12A） | 见下面电流预算 |
| 数量 | **4 块** + **1 个 3S 平衡充**（B6AC / HT692 级别，别用 B3 那种 1A 的） | 一天要跑几十趟 |
| 保险 | 电池主线串 **5A 自恢复保险丝**（可选但推荐） | A 车烧板教训，几十块保几百块 |
| 端子 | **XT30 公母（带 18AWG 硅胶线）** | 原板 `ZX-PZ2.0` 只有 2~3A，**必改** |

### 电流预算（用你给的 5Ω 风机重算，已定稿）

| 负载 | 正常 | 峰值/堵转 | 算法 |
|---|---|---|---|
| **负压风机**（5Ω 有刷） | 0.5~1.0 A | **2.5 A** | \(12.6 / 5 = 2.52\,\text{A}\)，启动瞬间就是这个 |
| 左轮 030 有刷 | 0.3~0.6 A | **1.6~2.5 A** | 030 级 DCR 典型 5~8Ω |
| 右轮 030 有刷 | 0.3~0.6 A | **1.6~2.5 A** | 同上 |
| 电子（5V/3.3V + 红外 150~200mA + 陀螺 20mA） | 0.35 A | 0.5 A | — |
| **合计** | **≈1.6~2.5 A** | **≈6.5~8 A** | 20C@500mAh = 10A → **够用有余量** |

> 顺手把驱动电机的 DCR 也量一下（两根线，30 秒）：读到 5Ω 就是 2.5A 堵转，读到 10Ω 就是 1.3A。
> 但**这条不卡下单**——上面按最坏情况已经留了余量。

---

## 2. 板子（嘉立创，今天必须提交）

### ① 原理图/PCB 改动（在 EDA 专业版里做，按《改板清单》执行）

| 动作 | 具体 | 状态 |
|---|---|---|
| **删** | 4 路电感输入口 + `U19 RS824XQ`×4 + `3224W` 电位器×4 + 前端 RC + 运放独立 LDO（VCCCOP）+ 0Ω 分地 | ✅ 赛道黑底白线，确定删 |
| **删** | `U21 EG2134` + `Q1~Q6 100N03DF` + **`U20` 第 2 片 STC32G(LQFP48)** + 反电势检测 RC | ✅ 风机是有刷，确定删 |
| **加** | 8 路红外座（`VCC/GND/IR0..IR7`，**接 `P1.0~P1.7`**）+ 每路 100Ω~1kΩ 串阻 + 10µF/100nF 去耦，**VCC 走 3.3V** | 见《赛道情报》§3 |
| **改** | 电池入口 `ZX-PZ2.0` → **XT30** | 必做 |
| **接** | 风机 → **DRV8701 第 3 路半桥（C 相）**：`IN5 = PWM`、`IN6 = 常低`，风机接 `VS3 → 风机 → 功率地` | ★**零新增元件**，见 §3 |

### ② 下单参数
- **PCB 5 片**（打样 2 天，别只要 2 片，调试必烧）
- **SMT 贴片**（不是可选项）：`DRV8701E`(VQFN-24) / `ICM-42688-P`(LGA) / `TPN2R703NL`(功率封装) / `TPS62933` 手焊风险高
- **BOM 必须自己在 EDA 里导出**（下载的那个 xlsx 是空表）→ 元件位号可参考已扒出的 `硬件工程/开源整车情报-BOM-飞檐走壁.csv`
- 功率走线：VM ≥40mil、大电容紧贴 VM、开散热铜窗、信号线远离电机线

---

## 3. 现成件（今天淘宝/立创商城下单，1~2 天到）

| # | 买什么 | 规格要点 | 数量 |
|---|---|---|---|
| 1 | **8 路数字红外循迹模块**（买现成，**别自己画**） | 发射+接收一体、板载调阈值、**间距 15~20mm**、3.3~5V 供电、**带防呆排线**、遮光罩 | **2 套**（1 用 1 备） |
| 2 | **USB 转 TTL** | **CH340/CP2102，且必须能输出 3.3V 逻辑**（5V 电平会打 STC32G 的 GPIO） | 1~2 |
| 3 | **STC-ISP 下载线/座** | 板已有 4P 下载座，只需线；备一个 **SOP/QFN 烧录座** 以防变砖 | 1 |
| 4 | **3S 450~600mAh ≥20C 软包/成品电池** | 带 **XT30 + 平衡头**；**不要带保护板的成品**（内阻大、放电弱） | **4** |
| 5 | **3S 平衡充电器** | B6AC / HT692 级别，能充锂电 3S | 1 |
| 6 | **XT30 公母端子带线 + 热缩管** | 18AWG 硅胶线 | 4 套 |
| 7 | **负压风机电机（5Ω 那种）备用** | 学长车上拆不动就买同尺寸（`8520`/`1725` 级）+ **扇叶** | **2**（碳刷是耗材） |
| 8 | **030 驱动电机（逐飞车模标配版，带编码器）** | ★**下单前确认带编码器版本**，源码要两路脉冲+方向 | 2（或从学长车拆） |
| 9 | **硅胶线** | 22~24AWG（电机/传感器）、18AWG（电池） | 各 2m |
| 10 | **黑色热缩管 + 黑卡纸/遮光胶带** | 红外管遮光用，**黑底白线方案的命根子** | 1 包 |
| 11 | 尼龙螺丝/间隔铜柱/杜邦线/微动开关 | 前瞻板固定（他们经验：**尼龙螺丝 + 502**，别用铝螺丝） | 1 批 |

> **备选（想再快一档）**：逐飞 **TSL1401 线性相机**（1280 像素灰度），源码 `zf_device_tsl1401.c` **驱动现成**，循迹精度远超 8 路红外。
> 代价：要跑 AD 采样时序、2ms 周期偏紧 → **只在红外版跑通后有余力再上**，别当第一版。

---

## 4. 结构件（今天定，打印要 2~3 天）

- **先从学长车上拆**：底板 / 侧板 / 铜柱 / 轴承（`F682-2Z 2×5×1.5`）/ 轮 / 胎皮 / 负压支架 / 扇叶 —— **能用就不打印**（省 3 天）
- **缺的按 3D 打印**：`开源工程/微缩车模型-Micro_car/更新_看这个/`（`底板`/`侧板`/`负压支架`/`扇叶`/`轮`/`Standard Motor 030`）
  - 材料：**PETG 或尼龙**（他们开源车用的就是 `petgcf`），PLA 夏天赛场会软
  - 嘉立创 3D 打印下单：**2 套**（一套装机、一套备损）
- 模型以 `更新_看这个/A整车.SLDASM` 为准（外层那份是旧版）

---

## 5. 下单前的确认项（✅ 已基清）

1. ~~编码器~~ → ✅ **你确认有编码器** → `encoder.c` 直接用（源码要两路脉冲+方向：`P34/P35` 与 `P04/P53`）。
   ⚠️ 只剩一件：**儿根引线**（3 根=单脉冲无方向 / 4 根=脉冲+方向 / 5~6 根=含 VCC GND）→ 接线时对上就行。
2. ~~爬不爬墙~~ → ✅ 风机保留 → **`flyboard()` 飞坡状态机也留**（和圆环一起）。
3. **白线线宽**（唯一还没数的）→ 定红外管间距 15 还是 20mm；**不阻塞画板**（先按 18mm 画，孔径留余量）。

---

## 6. 一句话总结

> **板子中删（电磁那套 + 无刷那套全删）、加（红外座接 P1）、改（XT30）、接（风机走 DRV8701 第 3 半桥）→ 今天提交打样+SMT；
> 红外模块/电池/充电器/USB-TTL/备用风机 → 今天淘宝；结构件先拆学长车、缺的今天打印；
> 电池 **3S 450~600mAh ≥20C + XT30**，峰值按 **8A** 留的余量，重量不再管。**

---

## 7. 成本估算（✅ 红外自己画、✅ 3D 打印你自己管 → 打印费不计入）

> 价格为 **2026 年立创商城/淘宝行情估算，±30%**；**准数请在嘉立创 BOM 一键报价（匹配 + 下单）里出**。
> 口径：**主控板打 5 片、SMT 贴 3 套**（调试必烧，一个人 7 天没地方买时间，只能拿板子当保险）。

### ① 一次性投入（打样 + 贴片）——**约 640~780 元**
| 项 | 数 | 金额 |
|---|---|---|
| 主控板 PCB（4 层、5 片） | 1 | 60~90 |
| 红外小板 PCB（2 层、5 片） | 1 | 20~30 |
| **SMT 工程费 + 钢网（一次性，大头）** | 1 | **500~600** |
| SMT 贴装费（约 500~700 焊点 × 3 片） | 3 | 50~80 |

### ② 元件（3 套）——**约 600 元**
| 位号 | 型号 | 单价 | 数量 | 小计 |
|---|---|---|---|---|
| U1 | STC32G12K128-35I-LQFP64 | 15 | 3 | 45 |
| U13/U16 | DRV8701E（VQFN-24） | 22 | 6 | **132** |
| U9~U18 | TPN2R703NL 功率 MOS | 4 | 24 | **96** |
| U5 | **ICM-42688-P**（LGA） | 38 | 3 | **114** ← 单件最贵 |
| U2/U3/U4/L2 | TPS62933 + RT9013 + TPS7A2033 + 6R8 电感 | ~14 | 3 套 | 42 |
| 电容 | 470~1000µF/25V 大电容 + MLCC 一批 | 25 | 3 套 | 75 |
| 阻容/保护 | 0402/0603 散件 + SS54F + SMAJ16CA + 自恢复保险 | 15 | 3 套 | 45 |
| 接插件 | 下载座/电机座/红外座/XT30/按键/蜂鸣器/排针 | 20 | 3 套 | 60 |

### ③ 红外（自己画，2 套）——**约 110 元**
| 项 | 金额 |
|---|---|
| TCRT5000 反射式红外管 ×10/套（含备损） | 80 |
| LM393 / SGM8774 比较器 + 3224 电位器 + 串阻去耦 | 30 |

### ④ 动力与能源——**约 350 元**（学长车上能拆则 **230**）
| 项 | 金额 |
|---|---|
| 3S 500mAh 45C 电池 ×4 | 120 |
| 3S 平衡充（B6AC 级） | 60 |
| 备用负压风机 + 扇叶 ×2（碳刷是耗材） | 50 |
| **030 电机带编码器** ×2（★学长给就不花） | 120 |

### ⑤ 杂项——**约 110 元**
USB 转 TTL（3.3V 逻辑）×2 = 40 · 硅胶线/热缩/遮光胶带/502/尼龙螺丝 = 40 · 胎皮/轴承/铜柱补件 = 30

### 总账

| 口径 | 金额 |
|---|---|
| **全部加起来（一次性 + 3 套元件 + 红外 + 电池 + 杂项）** | **≈ 1,800~2,060 元** |
| **单车边际成本**（元件 200 + 红外 55 + 电池/电机 120 + 杂项） | **≈ 420~500 元** |
| 交叉校验 | 开源队自报整车 **~500 元** → **吻合 ✓** |

**已经省下的**：删 `U20` 第 2 片 MCU + `EG2134` + `Q1~Q6` + `4×RS824XQ` + `4×电位器` ≈ **150~200 元/套**，还少一整条会调不完的无感换向。

**三条能再省（按性价比排序）**
1. **电机/编码器/轮/轴承全从学长车拆** → 省 **120~150 元**（★最划算，但先确认不坏）；
2. **SMT 只贴 2 套** → 省 **~20 元**贴装费（工程费省不掉），但只剩 1 块备用板 → **不建议**；
3. 主控板改 **2 层板**重布局 → 省 30~40 元，但 **DRV8701 + 8 MOS + 3S 走线用 2 层会很难受** → **不建议**。

**一条别省**：SMT 工程费 500。手焊 VQFN-24 / LGA / 功率封装在“一个人 7 天”里是**拿三天换五百块**，不划算。
