xigua862/SMARTCAR2/文档/改板清单-三合一板改红外-20261002.md

# 三合一板改红外 · 改板清单 · 2026-10-02

> 决定：**主控+驱动直接沿用「飞檐走壁三合一 V3.0」（STC32G12K128 + DRV8701E）**，把**电磁前瞻换成红外循迹**。
> ✅ **2026-10-02 已确认：赛道 = 5000×5000 黑底白线** → 删电磁那一刀**从“建议”升为“确定执行”**；红外具体规格见 `赛道情报-黑底白线5m-20261002.md` §3。
> 本文 = 改板依据。位号是从 `.epro2` 里扒出来的（`开源整车情报-BOM-飞檐走壁.csv`，383 个带位号元件）。
> ⚠️ 我只能给**位号级删改清单 + 新增接法**，`.epru` 是嘉立创专有格式，**动手改必须在嘉立创EDA专业版里画**。

---

## 0. 先回答你两个问题（重要，关系到工具链）

### 能不能用 ST-Link 烧录？——**不能，绝对不行**

- STC32G12K128 是**宏晶 8051 内核**，不是 STM32 的 ARM Cortex-M，**没有 SWD 口**。
- ST-Link / J-Link / DAP-Link / STC-Link 这类**一个都用不上**。
- 唯一烧录方式：**串口 ISP** —— USB转TTL（CH340/CP2102/FT232 都行）+ 官方 **STC-ISP** 软件。
- **好消息：这块板已经把下载电路画好了**（你截图左下「下载电路」）：
  - 4P 下载座 `PZ127V-11-04-0720`：`GND / TXD / RXD / VCC3V3`
  - `R6 10kΩ` 上拉 RST + `C46 100nF` + `SW1` 复位按键 → **冷启动下载**（点一下复位就能进 ISP）
  - → 你只需要一根 **3.3V 电平的 USB 转 TTL**，插上去、STC-ISP 里选型号、按复位，就能烧。
- 芯片本身**带 USB**（原理图引脚名 `P3.0/RxD/D-`、`P3.1/TxD/D+`，USB 与串口复用），但**本板没把 USB 引出来**；剩十多天，**别改 USB，走串口**。

### 串口能用吗？——**能用，而且不止一路**

- 从符号引脚名看，这芯片至少 **4 路独立 UART**：
  | 串口 | 引脚 | 建议用途 |
  |---|---|---|
  | SCI1 | `P3.0/RxD` `P3.1/TxD` | **烧录 + 下载专用**（已接下载座，别再挂别的） |
  | SCI2 | `P1.0/RxD2` `P1.1/TxD2` | **接蓝牙 / 上位机遥测**（调参口） |
  | SCI3 | `P5.0/RXD3` `P5.1/TXD3` | 备用（屏幕 / GPS / 第二外设） |
  | SCI4 | `P5.2/LIN_RX_2` `P5.3/TXD4` | 备用 |
  | 另有 | `P4.3/RxD_4` `P4.4/TxD_4`、`P3.6/RxD_2` `P3.7/TxD_2` | 复用脚，被 SPI/CAN 抢，先别当串口用 |
- **铁律：下载口和调试口必须分开**。STC 下载靠 RXD 检测冷启动帧，**如果下载口上还挂着蓝牙/屏幕，会抢线导致时好时坏烧不进去**（这是 STC 平台最常见的"板子坏了"假象）。
- ⚠️ **STC 不能在线单步调试**（没有 ARM 那种调试器）。所有排查只能靠**串口打印**。
  → A 车那套**遥测 + `tune.ps1` 串口调参**的工作流**必须移植**，这是唯一能撑住 7 天调车的办法。

---

## 1. 直接删掉的（电磁前瞻那一坨，省时间 + 省重量）

| 位号 | 型号 | 数量 | 原用途 | 删掉的理由 |
|---|---|---|---|---|
| **U19** | `RS824XQ` 四通道轨到轨运放 | **4** | 放大电感线圈微弱信号 | 红外模块**自带数字输出**，不需要模拟放大 |
| — | `3224W-1-104E`（100k 电位器） | 4 | 各路采样阈值调零 | 同上 |
| — | 运放外围 R/C（每路约 4~6 个 0402/0603） | ~20 | 滤波/偏置/反馈 | 同上 |
| — | 4 路线圈输入接口（图上那 4 个线圈符号） | 4 | 电磁拾取线圈 | 换成一个红外座 |
| — | `RC0402FR-070RL` / `NCD0402R1`（**0Ω**） | 3~4 | **数字地/模拟地单点连接** | 没有模拟前端了，地不用分 |
| **U3 或 U4** | `RT9013-12GB` / `TPS7A2033` | 1 | 说明里给运放供电的那路 **VCCCOP** | 运放删了就没负载 → **先确认是哪一路再删**（文档说 RT9013 出 3.3V 给主控，和型号 `-12` 对不上，**以原理图为准**） |

> 删完大约省 **30+ 个元件 + 1 路 LDO**，对 100g 限重的车是白捡的克数。

---

## 2. 必须加上的（红外循迹）

| 加什么 | 具体接法 | 为什么 |
|---|---|---|
| **1 个红外接口座** | 1×9 或 1×10（**2.54mm 带定位**，或直接用现成的 `SM10B-GHS-TB` 防呆座）：`VCC / GND / IR0..IR7` | 别用排针裸插——A 车烧板连环案就是悬空+错插 |
| **8 路串阻** | 每路信号 **100Ω~1kΩ** 串电阻（0402） | 错插/热插拔时保护 GPIO；顺带抑制振铃 |
| **本地去耦** | 红外座旁 `10µF`（或 100µF 钽/MLCC）+ `100nF`×2 | 红外发射管是脉冲负载，纹波会打 ADC 和陀螺 |
| **供电 = 3.3V** | 红外模块 VCC 接 **U4 出来的 3.3V**，**不要接 5V** | STC32G 3.3V 供电，**GPIO 不耐 5V**；数字红外模块 3.3V 也能正常工作，输出电平=3.3V，直接进 MCU 最省事 |
| **8 个 GPIO → 接 `P1.0~P1.7`** | 已核对源码全部宏：**P1 整组一个脚都没用** | 不用改任何现有网络，而且 **8051 能一条指令读整个 P1 口**（`ir = ~P1;`），比 8 次 `gpio_get_level` 快一个量级。⚠️ 若要用第二路串口（蓝牙/遥测）就让出 `P1.0/P1.1`（RxD2/TxD2），改用 `P1.2~P1.7 + P2.0/P2.1` |
| **（可选）1 路发射管使能** | 找一个 GPIO 经三极管控红外 VCC | 能**主动关发射管省电/减热**，也能做"上电自检" |

> **红外机械规格（定稿用）**：管间距 **18~20mm**（等线宽确认）· 离地 **3~8mm 固定死**（禁悬空叠装）· **必须遮光**（每套管黑色热缩管 + 整条遮光罩；赛场日光灯/阳光含红外，裸管会漂到不可用——黑底白线方案最常见的翻车点）· 8 路常亮约 **150~200mA**（走 3.3V 那路 LDO，余量够）· 代码留极性宏 `IR_WHITE_IS` + 上电用**蜂鸣器 P67** 做自检。

> **前瞻距离**：A 车已验证 **110~120mm**；但本赛道最小半径 **R200**（A 区四连 S 波），**建议取偏短 90~110mm**，否则大角度入弯会切线出线。红外条装他们**原前瞻板的位置**（那块独立小板，尼龙螺丝+502 固定），结构不用重新设计。

---

## 3. ★ 最大的省时间决定：负压走**有刷**，把第二套驱动整个删掉

> ✅ **2026-10-02 定稿（风机已量）**：你那台负压风机**万用表欧姆档 = 5Ω、两根线** → **它本来就是普通有刷电机**，
> 所以 B+C 两条链（`EG2134` + `Q1~Q6` + 第 2 片 `U20`）**直接删，不是“改”，是“本来就不需要”**。
> 堵转电流 = 12.6 / 5 = **2.5 A**（和我原来给的 2~3A 预算吻合）。
> ⚠️ 重量不再作为约束（普通省赛、只要快）→ 风机**整套保留**，`flyboard()` 飞坡状态机也**不删**。

现在板子上有**两条独立驱动链**：

| 链 | 器件 | 干什么 |
|---|---|---|
| A：**U13 + U16** | 2× `DRV8701E` + **8× `TPN2R703NL`**（16 MOS） | 左右两轮 **两个 H 桥**（有刷） |
| B：**U21 + Q1~Q6** | `EG2134` + **6× `100N03DF`** 三相全桥 + 反电势换向检测 | **无刷负压风机** |
| C：**U20** | 第 2 片 `STC32G12K128-35I-LQFP48` | 专职跑无刷驱动算法 |

**定稿：删掉 B + C，风机就用你车上那台 5Ω 有刷的，接现成的 A 链第 3 个半桥。**

### ★ 风机接法（**零新增元件**，这是本清单最省时间的一条）

| 项 | 接法 |
|---|---|
| 驱动级 | **DRV8701 第 3 路半桥（C 相）**：高边+低边已现成，**体二极管/同步整流自带续流** → 不需外加 MOS、不需续流二极管 |
| 输入 | `IN5 = PWM`（原 `PWMB_CH4_P77` 那路改接此处）、`IN6 = **常低**`（拉地）→ 只做低边斩波，控制最简单 |
| 输出 | `VS3（半桥中点）→ 风机 +`，`风机 − → 功率地` |
| 代码 | `pwm_init(PWMB_CH4_P77, 50, 500)` 和 `pwm_set_duty(..., power=888)` **一行不用改**，只是物理上换了一个驱动链 |
| 保护 | 风机两端并一个 **100nF + 磁珠**（抑 EMI，碳刷电机是噪声源），可选但便宜 |

理由（都是"一个人、十多天"的约束）：
1. **DRV8701 天生是三相预驱 = 每片 3 个半桥**，两片共 **6 个半桥 = 3 个 H 桥** → **左轮 + 右轮 + 负压风机**，**现成的 A 链就够三路**，只要把第 3 个半桥接出来；
2. 无感反电势换向（`VS1/VS2/VS3` + 比较器 + 那 4 个电位器调阈值）是**最容易调不完的东西**，国一队伍也是拿一整年磨的；
3. 删掉 = **少 1 颗 MCU + 1 颗预驱 + 6 个大电流 MOS + 一整套换向检测**，**重量、焊接量、代码量同时砍**；
4. 负压风机**不需要精确控制**，PWM 调速就够（`Micro_car` 作者 7W 吸 1.2kg 就是有刷方案）。

**代价**：有刷风机寿命短、噪音大 → **备 2 个电机（几十块钱，今天下单）**。
> ✅ ~~如果规则必须无刷~~ → **已确认不需要**：你车上现成风机就是有刷（5Ω），原开源那套无感换向对我们是**纯负资产**，删。

---

## 4. 保留不动的（照抄，别手痒）

| 位号 | 型号 | 用途 |
|---|---|---|
| U1 | STC32G12K128-35I-LQFP64 | 主控 |
| U2 | TPS62933FDRLR + L2(NLCV32T-6R8M) | 3S→5V 同步降压 |
| U4 | TPS7A2033 | 5V→3.3V（主控/IMU/红外） |
| U5 | ICM-42688-P | 六轴姿态（**别翻面装，GZ 符号会反；上电时车要静止**） |
| U13/U16 + U9~U18 | DRV8701E + TPN2R703NL | 有刷 H 桥 |
| D1 | SS54F | 电池防反接（**保留，A 车烧板教训**） |
| SMAJ16CA / 1N5819W / FC-F1005 | D10/D11 等 | TVS + 肖特基 + 磁珠/PTC 电源入口防护 |
| 下载座 + SW1 + R6 + C46 | — | 串口 ISP 下载 |
| 按键 / 屏幕座(U6,U7) / 蓝牙 / 发车开关 / Test-Point | — | 调参人机口，**没调试器全靠这些** |
| 编码器接口 | — | 双路编码器测速（`Micro_car` 的磁编码方案对得上） |

---

## 5. 现实提醒（打样 / 贴片 / 时间）

1. **DRV8701E 是 VQFN-24（0.5mm 间距，底部散热盘）**、**ICM-42688-P 是 LGA**、**TPN2R703NL 是大功率模块** → **手焊风险高**。
   → **直接下嘉立创 SMT 贴片**（BOM 已导出：`开源整车情报-BOM-飞檐走壁.csv`，383 行带位号+型号+封装），别自己焊。
2. 打样 + SMT 一般 **3~5 天**到手 → **板子必须今天/明天定稿**，否则 7 天里没车可调。
3. 功率级注意：**VM 走线 ≥40mil**、**大电容紧贴 DRV8701 的 VM**、**开铜/散热窗**、**信号线远离晶振和电机线**（A 车《CSDN-B6》里记的）。
4. **丝印留队伍名**（A 车文档记录检查看板子要有"年份+赛项+队伍名"丝印，缺了可能被卡）——B 车按自己组规则核。
5. `.epro2` 是**别人 4.1.60 版本的工程**，你本地编辑器版本要 ≥ 它，否则可能打不开/丢东西 → **先打开确认能看能改，再动手**（这一步做完再告诉我）。

---

## 6. 优先级（一个人 7 天，只做这四件）

| 顺序 | 干什么 | 为什么排这个位置 |
|---|---|---|
| **①** | **去立创开源广场搜「21届智能车-飞檐走壁-致远探界整车工程」，把附件三「国赛软件源码」下下来** | **源码到手 = 这条路能走；拿不到源码，STC32G + 无感换向基本做不完** → 这比画板更该先做，今天就能确认 |
| ② | 在 EDA 里按本文 §1/§2/§3 改板，**当天出 Gerber + SMT BOM/坐标** | 板子在路上的时间 = 你能写代码的时间 |
| ③ | 板子路上：搭 STC-ISP 环境、把源码跑起来、把**串口遥测协议**对齐 A 车的 `tune.ps1` | 不占手，且是最大不确定性 |
| ④ | 结构：红外条装原前瞻板位置（110~120mm 前瞻）、碳板按 `Micro_car` 抄 | 结构错了改不动，但比电路慢半天没关系 |

---

## 7. 要你拍板的 3 件事

1. **负压：有刷（删第二套驱动，我强烈推荐）还是无刷（原样抄，必须拿源码）？**
2. **红外模块用哪一款？**（几路、输出高有效还是低有效、3.3V 能不能驱动 → 决定 §2 的串阻和上下拉）
3. **要不要我下一步去把另外 3 块 PCB 是什么板扒出来？**（4 块板里我只确认了这块三合一板；如果其中一块就是**前瞻板**，你连红外小板都能直接抄）
