xigua862/SMARTCAR2/硬件工程/BOM-立创配单-干净版.csv

数量 | 立创编号 | 封装 | 位号 | 品名/规格 | 品牌 | 供应商编号
1 | TMB12A05 | BUZ-TH_BD12.0-P7.60-D0.6-FD | BUZZER2 | 2.4kHz | 华能 | C96093
5 | CL10A105KO8NNNC | C0603 | C1,C2,C12,C14,C15 | 1uF | SAMSUNG(三星) | C1592
19 | FCC0603B104K500CT | C0603 | C3,C4,C5,C6,C7,C8,C11,C13,C16,C18,C20,C28,C29,C30,C31,C32,C33,C34,C35 | 100nF | FOJAN(富捷) | C5137636
2 | FCC0603N180J500CT | C0603 | C9,C10 | 18pF | FOJAN(富捷) | C5137620
1 | MA35V100M6X8 | CAP-SMD_BD6.3-L6.6-W6.6-RD | C17 | 100uF | JIERR(捷而瑞) | C46550467
1 | CC1H104MC1FD3F6C10MF | CAP-TH_L5.0-W2.5-P5.00-D1.0 | C22 | 降压模块电容12V | Dersonic(德尔创) | C254085
1 | JVJ25V220M6x8 | CAP-SMD_BD6.3-L6.6-W6.6-LS7.3-FD-H7.7 | C23 | 降压模块电解电容 | JIERR(捷而瑞) | C46550404
1 | CC1H104MC1FD3F6C10MF | CAP-TH_L5.0-W2.5-P5.00-D1.0 | C24 | VM电容 | Dersonic(德尔创) | C254085
1 | CC1H104MC1FD3F6C10MF | CAP-TH_L5.0-W2.5-P5.00-D1.0 | C26 | 5V电容 | Dersonic(德尔创) | C254085
1 | JVJ25V220M6x8 | CAP-SMD_BD6.3-L6.6-W6.6-LS7.3-FD-H7.7 | C27 | 5V电解电容 | JIERR(捷而瑞) | C46550404
1 | FCC0805B104K500DT | C0805 | C36 | 100nF | FOJAN(富捷) | C5137467
1 | XT30PW-M30.G.Y | CONN-TH_XT30PW-M | CN1 | XT30PW-M30.G.Y | AMASS(艾迈斯) | C431092
1 | PTVS15VS1BR | SOD-123FL_L2.7-W1.9-LS3.7-BI | D1 | PTVS15VS1BR | FUXINSEMI(富芯森美) | C20421281
1 | 1N4148W | SOD-123_L2.7-W1.6-LS3.7-FD | D2 | 1N4148W | R+O(宏嘉诚) | C7420318
1 | SMD1206-050-33 | F1206 | F1 | SMD1206-050-33 | R+O(宏嘉诚) | C46641017
1 |  | FUSE-SMD_L6.1-W2.6 | F2 | VM轨保险 一次性慢熔 10A 2410贴片
1 | PZ254V-12-10P | HDR-TH_10P-P2.54-V-M-R2-C5-S2.54 | H4 | 2*5P | XFCN(兴飞) | C492422
1 | KEY2 | SW-SMD_4P-L6.0-W6.0-P4.50-LS9.0_H5.0 | KEY1 | KEY2 | kinghelm(金航标) | C2837531
1 | BLM18AG601SN1D | L0603 | L1 | BLM18AG601SN1D | muRata(村田) | C19330
2 | GH1.25-6PWT | CONN-SMD_6P-P1.25_FWF12514-S06B24W5M | L2,R33 | GH1.25-6PWT | XUNPU(讯普) | C52037408
1 | ME6211C33M5G-N | SOT-23-5_L3.0-W1.7-P0.95-LS2.8-BL | LDO1 | ME6211C33M5G-N | MICRONE(南京微盟) | C82942
2 | GL0603UG01 | LED0603-RD | LED0,LED5 | GL0603UG01 | Guiguang light(桂光光电) | C51933293
1 | GL0603UR01 | LED0603-FD | LED6 | GL0603UR01 | Guiguang light(桂光光电) | C51933292
1 | GL0603UB01 | LED0603-RD_BLUE | LED7 | GL0603UB01 | Guiguang light(桂光光电) | C51933294
1 | SS8050 | SOT-23-3_L2.9-W1.3-P1.90-LS2.4-BR | Q1 | SS8050 | R+O(宏嘉诚) | C7420370
11 | FRC0603F1001TS | R0603 | R1,R15,R17,R19,R21,R23,R25,R27,R29,R31,R37 | 1kΩ | FOJAN(富捷) | C2907002
5 | FRC0603J103 TS | R0603 | R2,R3,R4,R5,R32 | 10kΩ | FOJAN(富捷) | C2930027
6 | FRC0603F47R0TS | R0603 | R6,R7,R9,R10,R12,R13 | 47Ω | FOJAN(富捷) | C2907043
3 |  | R2512 | R8,R11,R14 | 采样电阻 110mR 2512 2W ±1%
8 | FRC0603F1501TS | R0603 | R16,R18,R20,R22,R24,R26,R28,R30 | 1.5kΩ | FOJAN(富捷) | C2930050
3 | FRC0603J471 TS | R0603 | R34,R35,R36 | 470Ω | FOJAN(富捷) | C2907172
1 | KH-6X6X5H-STM | SW-SMD_4P-L6.0-W6.0-P4.50-LS9.0_H5.0 | SW1 | KH-6X6X5H-STM | kinghelm(金航标) | C2837531
1 | RS601A-1020013BB | SW-TH_RS601A-1020013BB | SW3 | RS601A-1020013BB | HCTL(华灿天禄) | C5124216
1 | KEY1 | SW-SMD_4P-L6.0-W6.0-P4.50-LS9.0_H5.0 | SW4 | KEY1 | kinghelm(金航标) | C2837531
1 | STM32F103C8T6 | LQFP-48_L7.0-W7.0-P0.50-LS9.0-BL | U1 | STM32F103C8T6 | ST(意法半导体) | C8734
1 | WAFER-PH2.0-6PZZ | CONN-TH_6P-P2.00_PH2.0-6P | U3 | WAFER-PH2.0-6PZZ | XUNPU(讯普) | C5359603
3 | AT8236 | ESOP-8_L4.9-W3.9-P1.27-LS6.0-BL-EP | U4,U5,U6 | AT8236 | 杭州中科微 | C2827823
1 | LAIL-PM2.54-8P-L | HDR-TH_LAIL-PM2.54-8P-L | U8 | LAIL-PM2.54-8P-L | LAILAN(莱联) | C54973824
3 | KF301-5.0-2P | CONN-TH_P5.00_KF301-5.0-2P | U9,U10,U11 | KF301-5.0-2P | KEFA(科发) | C474881
1 | A2008WR-10P | CONN-TH_A2008WR-10P | U12 | A2008WR-10P | CJT(长江连接器) | C273108
1 | HY8M49SSMDOB2R20 | CRYSTAL-SMD_L11.4-W4.7-LS12.7 | X1 | 8MHz | Huiyuan crystal(惠源晶工) | C5265773
