xigua862/SMARTCAR2/硬件工程/BOM_21届智能车-飞檐走壁-致远探界整车工程.xlsx

ID | Name | Designator | Footprint | Quantity | Manufacturer Part | Manufacturer | Supplier | Supplier Part
1 | HX PZ1.27-1x6P ZZ | H3 | HDR-TH_HXPZ1.27-ZZ | 1 | HX PZ1.27-1x6P ZZ | hanxia(韩下) | LCSC | C22438103
