xigua862/SMARTCAR2/文档/待并入v1.9-清单-20261011.md

# 待并入 v1.9 清单 —— §3 调参接口 / 遥测 / AUTORUN 增量 · 2026-10-11

> 状态：**增量暂存（未并入正文）**。承《`讨论-调参迭代器与固件契约-20261011.md`》D2 / D3 / D5 签字。
> 作者：军师。房规（README §二.4）：本清单**不改 v1.8 正文一个字**；并入时**一次性出 v1.9**，不做 v1.8a/1.8b。
> 定位：这是"要动哪几处"清单 + 逐条提案正文，**并入前还要你最后一次点头**（§0）。

---

## 0. 军师建议：挂起，先不并入（结论先行）

**建议把本增量挂"待并入"，到固件里程碑再与其它 §3 改动一次性出 v1.9。** 三条理由：

1. **会返工**：LAP 结算点、参数表键集、P95 口径这些细节，**真正写固件时**才会收敛；现在并进去，大概率固件一开写又要改法律。
2. **撞 v1.8 规矩**：v1.8 明确"数据没实测完不动正文数字、一次成型不来回改"（§8 / 开场提示词理念 9）。
3. **含待实测项**：`vmax_ceiling` 来自 §7 齿比实测、遥测 P95 阈值需实跑标定——现在都是空的。

⇒ 你若坚持现在并，我照办（仍走三道门）；否则**挂起**，本清单作为固件里程碑的输入。

---

## 1. 要动哪几处（逐条，标到 v1.8 位置）

| # | v1.8 位置 | 动作 | 提案（并入时照抄） | 出处 / 依据 |
|---|---|---|---|---|
| 1 | §3 分层代码块 `control/` 行 | **加一个模块** | `ins_corr.c(光电修正/地标重置环)` | D2 签字；§3"惯导为主·地标重置点" |
| 2 | §3 分层代码块 `app/` 行 | **明确职责** | `param.c` = 参数表(EEPROM) + 串口 `SET/GET/RUN`；`telemetry.c` = 每圈 LAP 结算 + 打印(TX DMA) | D5；§2.3 USART1 重映射 |
| 3 | §3 末尾 | **新增子节 §3.1 调参接口与遥测契约** | 见本清单 §2 ~ §5 | D5 签字 |
| 4 | §3"判据纪律" | **加一条** | "调参器 SET 白名单外的键禁改：**电机方向 / 限流 R_ISEN / 引脚映射** 为固件常量，绝不进白名单" | v1.8 §0.3、§2.2、§2.3 |

> 注：**只增不改**——不删 v1.8 §3 任何现有行，不动任何现有数字。

---

## 2. 【提案】§3.1-A 参数表（D3：以 §3 模块名重落键名）

固件 `param.c` 照此建表；**串口 `SET/GET` 的键名 = 本表键名**（不是仿真键名）。

| v1.8 模块 | 键名（新） | 原仿真键 | 单位 | SET 白名单 | 本轮自动调 | 备注 |
|---|---|---|---|---|---|---|
| `control/angle_pd` | **`kp_angle`** | kp_steer | — | ✓ | B | 转向 PD（**改名**） |
| `control/angle_pd` | **`kd_angle`** | kd_steer | — | ✓ | B | 转向 PD（**改名**） |
| `control/gyro_damp` | `k_gyro` | k_gyro | — | ✓ | B | 陀螺阻尼 |
| `control/speed_pid` | `kp_speed` `ki_speed` `kd_speed` | 同 | — | ✓ | 否（本轮手动） | 速度环 |
| `control/profile` | `vmax` `vmin` | 同 | mm/s | ✓ | C（vmax） | 速度剖面 |
| `control/profile` | `a_acc` `a_brake` | 同 | mm/s² | ✓ | C（a_acc） | 加/减速斜坡 |
| `control/slowsafe` | `a_lat` | a_lat | mm/s² | ✓ | 否（**待实测**） | 弯心侧向上限≈μ·g（§3 `v_曲率=√(μ·g·R)`、§5 待测 8）|
| `middleware/line_pos`（软件前瞻） | `look_mm` | look_mm | mm | ✓ | B | **语义＝软件前瞻量**（权值表/曲率前馈，§2.5），**非物理探头位**（物理位 35~55 是机械槽，不进调参）|
| `control/ins_corr`（D2 新建） | `corr_kp` `corr_ki` `corr_kd` | 同 | — | ✓ | B（kp,ki） | 光电修正 / 地标重置环 |
| `control/ins_corr` | `corr_on` | corr_on | 0/1 | ✓ | 否 | 修正环开关（比赛常开）|
| `control/ins_corr` | `straight_min` `corner_margin` | 同 | mm | ✓ | 否（手动） | "只修长直道核心段"的几何门 |
| `control/ins_corr` | `corr_enc_k` | corr_enc_k | 1/s | ✓ | 否（手动） | 里程弧长向几何投影靠拢系数（§1.3 打滑修正）|
| `app/fsm` | `autorun` | autorun | 圈 | ✓ | 否 | 上电自跑圈数 |

**禁改（非白名单 · 固件常量）**：电机方向（§0.3 侧框架翻转定）、`R_ISEN` 限流（§2.2）、引脚映射（§2.3）、`vmax_ceiling`（来自 §7 齿比实测，**待实测**，不由调参器拍）。

**改名影响**：仅 `kp_steer→kp_angle`、`kd_steer→kd_angle` 两处；其余沿用。冻结原型 `脚本/调参/` 仍用旧名（§8 说明差异处置）。

---

## 3. 【提案】§3.1-B 串口协议（115200 · USART1 重映射 PB6/PB7 · TX 走 DMA）

```
SET <键> <值>   → OK            （值：整数不带小数点，浮点 %.8g；键不在白名单 → ERR KEY）
GET <键>        → OK <值>
RUN <n>         → ACK           （随后跑 n 圈，每圈结束打一行 LAP）
非法命令/解析失败 → ERR <原因>
行尾 \n；命令应答超时 = 调参器侧 serial_timeout_s；固件侧不阻塞控制周期（TX DMA）
```

- 与两键语义的关系（§3）：**PB0 测试键** 进测试模式时，电机滑行休眠、**串口纯做取数/调参**（正是调参器接入的窗口）；**PC13 发车键** 走正式流程。
- `autorun` 与 `RUN n`：上电按 `autorun` 自跑；`RUN n` 为在线覆盖。

---

## 4. 【提案】§3.1-C 每圈 LAP 遥测行（字段顺序固定，脚本按行解析）

```
LAP,<圈号>,<跑完0/1>,<耗时ms>,<里程mm>,<线RMS>,<线P95>,<线MAX>,<惯导RMS>,<惯导P95>,<补偿角均值deg>,<脱线次数>,<结束原因>
例：LAP,3,1,8420,13720,1.8,3.9,6.4,2.1,4.8,0.7,0,OK
```

**口径（已按错位 3 修正到 v1.8）**：

| 字段 | v1.8 口径 | 出处 |
|---|---|---|
| 线偏差 RMS/P95/MAX | `line_pos` 归一化加权质心 err 的绝对值统计 | §2.5 `err=Σ(IR_POS·p)/Σp` |
| 惯导横向偏差 RMS/P95 | `odom` 位置相对**已知 CAD 中心线**的横向偏差 | §3 惯导为主·已知几何 |
| 补偿角均值 deg | `ins_corr` 环输出的航向补偿均值（**左正**，与 §2.5 符号标定一致） | D2 新建环 |
| 脱线次数 | 本圈 `Σp==0` 丢线分支命中次数 | §2.5 丢线分支 |
| 结束原因 | 枚举 `OK/LOST/TIMEOUT/OFFTRACK/SPIN/ABORT/INCOMPLETE` | 本提案 |
| 结算点 | **过起点**（里程窗 ∧ 圈数达标，与 `finish` 判据同源、元素互斥） | §3 判据纪律 |
| 采样口径 | 每 **5ms** 控制拍采一次；P95 = 排序取 95 分位（或近似分位） | §3 5ms 周期 |

⚠ 若 D2 的 `ins_corr` 环最终未建，则"补偿角均值"列恒填 0 并在固件注明（不删列，保脚本兼容）。

---

## 5. 【提案】§3.1-D 上电自检联动（补 §3 自检项）

在 §3 现有上电自检（灰度极值 / 编码器方向 / IMU 零偏）基础上，**加一条**：自检结果与 `autorun` 联动——**任一自检不过 → 蜂鸣 + 不进 autorun**（避免带病自跑）。

---

## 6. 三道门自检（README §三）

1. **门 1 数据/出处**：本增量是**接口设计决策**，出处＝讨论稿 + `开源工程/惯导矫正仿真/开源说明/惯导控制思路.md` + 用户签字；**不含任何伪"实测"数字**；`a_lat`/`vmax_ceiling`/P95 阈值一律标"待实测/整定"。✅
2. **门 2 用户拍板**：D2/D3/D5 已签字（2026-10-11）；**并入正文前再要一次点头**（§0）。⏳
3. **门 3 写清出处**：每条提案带来源列。✅

---

## 7. 里程碑归属（并入后挂在哪个进度点）

本增量属**固件里程碑**（PCB 打样 → 焊接 → 上电自检 → 驱动/编码器/IMU 打通 → **param.c + 遥测 + ins_corr** → 调参器接实车）。**当前 PCB 阶段不触发**。

---

## 8. 与冻结原型（`脚本/调参/`）的关系

- 原型用**旧仿真键名**（`kp_steer`…），已冻结（D1/D4），仅离线策略验证用。
- 本清单是**前向契约**（v1.8 键名）。二者键名差异**已知、可接受**。
- 固件里程碑启动时派生**工人卡**：把原型 `port` 到对齐键名 + 接串口后端 + 复跑 `--sim` 与实车对拍。

---

## 9. 修订记录

- **2026-10-11**：军师建清单（承 D2/D3/D5 签字）。**未动 v1.8 正文**；等 §0 的点头决定"现在并 / 挂起"。
