xigua862/SMARTCAR2/开源整车情报-BOM-飞檐走壁.csv

DES | Name | MPN | LCSC | Footprint
C1
C1 |  |  |  | e4a067bb0e46c874
C10 |  |  |  | 35bc40f298fdf5b6
C10
C11
C11 |  |  |  | 35bc40f298fdf5b6
C12
C12 |  |  |  | 35bc40f298fdf5b6
C13 |  |  |  | 35bc40f298fdf5b6
C13
C14 |  |  |  | 35bc40f298fdf5b6
C14
C15 |  |  |  | 35bc40f298fdf5b6
C15
C16
C16 |  |  |  | 35bc40f298fdf5b6
C17 |  |  |  | 35bc40f298fdf5b6
C17
C18 |  |  |  | 35bc40f298fdf5b6
C18 |  |  |  | 35bc40f298fdf5b6
C19 |  |  |  | 35bc40f298fdf5b6
C19 |  |  |  | 35bc40f298fdf5b6
C2 |  |  |  | 35cd5bf0824dcdca
C2
C20 |  |  |  | e4a067bb0e46c874
C20
C21 |  |  |  | e4a067bb0e46c874
C21
C22 |  |  |  | e4a067bb0e46c874
C22
C23 |  |  |  | e4a067bb0e46c874
C23
C24
C24 |  |  |  | e4a067bb0e46c874
C25
C25 |  |  |  | e4a067bb0e46c874
C26 |  |  |  | e4a067bb0e46c874
C26
C27 |  |  |  | e4a067bb0e46c874
C27
C28 |  |  |  | e4a067bb0e46c874
C28
C29 |  | TAJA106K016RNJ | C7171
C29 |  |  |  | d6236baad33562c9
C3
C3 |  |  |  | 35cd5bf0824dcdca
C30
C30 |  |  |  | e4a067bb0e46c874
C31 |  |  |  | 35bc40f298fdf5b6
C31
C32 |  | CL10A106MA8NRNC | C96446
C32 |  |  |  | 35bc40f298fdf5b6
C33 |  |  |  | 35bc40f298fdf5b6
C33 |  | CL10A106MA8NRNC | C96446
C34 |  |  |  | 35bc40f298fdf5b6
C34
C35
C35 |  |  |  | 35bc40f298fdf5b6
C36 |  |  |  | e4a067bb0e46c874
C36
C37
C37 |  |  |  | 35bc40f298fdf5b6
C38 |  |  |  | 35bc40f298fdf5b6
C38
C39 |  |  |  | 35bc40f298fdf5b6
C39
C4
C4 |  |  |  | 35cd5bf0824dcdca
C40
C40 |  |  |  | 35cd5bf0824dcdca
C41 |  |  |  | 35cd5bf0824dcdca
C41
C42 |  |  |  | e4a067bb0e46c874
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
R32 |  | 0402WGF1001TCE | C11702
R33 |  |  |  | 29bf744950c1fdde
R33 |  | FRC0402F5101TS | C2906874
R34 |  |  |  | 29bf744950c1fdde
R34 |  | FRC0402F5101TS | C2906874
R35 |  |  |  | 29bf744950c1fdde
R35 |  | 0402WGF1001TCE | C11702
R36 |  |  |  | 29bf744950c1fdde
R36
R37 |  |  |  | 29bf744950c1fdde
R37
R38 |  |  |  | d8f634c49776e1b7
R38
R39 |  | RT0603BRD07100RL | C122970
R39 |  |  |  | d8f634c49776e1b7
R4 |  |  |  | 29bf744950c1fdde
R4
R40 |  | FRC0402F1002TS | C2906861
R40 |  |  |  | 29bf744950c1fdde
R41 |  | FRC0402F1002TS | C2906861
R41 |  |  |  | 29bf744950c1fdde
R42 |  |  |  | 29bf744950c1fdde
R42
R43
R43 |  |  |  | 29bf744950c1fdde
R44
R44 |  |  |  | 29bf744950c1fdde
R45
R45 |  |  |  | 29bf744950c1fdde
R46 |  |  |  | 29bf744950c1fdde
R46
R47
R47 |  |  |  | 29bf744950c1fdde
R48
R48 |  |  |  | 29bf744950c1fdde
R49
R49 |  |  |  | 29bf744950c1fdde
R5 |  |  |  | 29bf744950c1fdde
R5
R50 |  |  |  | 29bf744950c1fdde
R50
R51 |  |  |  | 29bf744950c1fdde
R51
R52
R52 |  |  |  | 29bf744950c1fdde
R53 |  |  |  | 29bf744950c1fdde
R53
R54
R54 |  |  |  | 29bf744950c1fdde
R55 |  |  |  | 29bf744950c1fdde
R55
R56 |  |  |  | 29bf744950c1fdde
R56
R57 |  |  |  | 29bf744950c1fdde
R57
R58
R58 |  |  |  | 29bf744950c1fdde
R59 |  |  |  | d8f634c49776e1b7
R59
R6
R6 |  |  |  | 29bf744950c1fdde
R62 |  | RT0603BRD07100RL | C122970
R62 |  |  |  | d8f634c49776e1b7
R7
R7 |  |  |  | 29bf744950c1fdde
R8 |  |  |  | 29bf744950c1fdde
R8
R9
R9 |  |  |  | 29bf744950c1fdde
SCREW1
SCREW1
SCREW2
SCREW2
SCREW3
SCREW3
SCREW4
SCREW4
SW1 |  |  |  | 59bd19153ddd1673
SW1 |  | TS-1101-C-W | C318938 | 59bd19153ddd1673
SW2 |  | TS-1101-C-W | C318938 | 59bd19153ddd1673
SW2 |  |  |  | 59bd19153ddd1673
SW3 |  | TM-4175-B-A | C465995 | d9c4ae71075e0521
SW3 |  |  |  | d9c4ae71075e0521
TP2 |  |  |  | c5a59edd1ed37c64_3cda4089a32640cea7e3cb1da21de0c1
TP2
TP3 |  |  |  | c5a59edd1ed37c64_98f27f0fcd0a95482217cacaf29a4589
TP3
U1 |  |  |  | 1fec0e22d3579f68
U1 |  | STC32G12K128-35I-LQFP64 | C5210761 | 1fec0e22d3579f68
U10 |  | TPN2R703NL,L1Q(M | C5307666
U10 |  |  |  | 85839d7c94a5c4f3
U11 |  |  |  | 85839d7c94a5c4f3
U11 |  | TPN2R703NL,L1Q(M | C5307666
U12 |  |  |  | 85839d7c94a5c4f3
U12 |  | TPN2R703NL,L1Q(M | C5307666
U13 |  | DRV8701E | C132049 | 35168376726d4128
U13 |  |  |  | 35168376726d4128
U14 |  |  |  | 85839d7c94a5c4f3
U14 |  | TPN2R703NL,L1Q(M | C5307666
U15 |  | TPN2R703NL,L1Q(M | C5307666
U15 |  |  |  | 85839d7c94a5c4f3
U16 |  | DRV8701E | C132049 | 35168376726d4128
U16 |  |  |  | 35168376726d4128
U17 |  |  |  | 85839d7c94a5c4f3
U17 |  | TPN2R703NL,L1Q(M | C5307666
U18 |  | TPN2R703NL,L1Q(M | C5307666
U18 |  |  |  | 85839d7c94a5c4f3
U19 |  | RS824XQ | C255445
U19 |  |  |  | ab8965e9a7875217
U19 |  | RS824XQ | C255445
U19 |  | RS824XQ | C255445
U19 |  | RS824XQ | C255445
U2 |  |  |  | b8888eb9bfe42eeb
U2 |  | TPS62933FDRLR | C5219272
U20 |  | STC32G12K128-35I-LQFP48 | C5210760
U20 |  |  |  | 7e0d04b57591dc8a
U21 |  |  |  | 6ffd33061179675e
U21 |  | EG2134 | C480661
U22 |  | SE8550K2-HF | C115012
U22 |  |  |  | d44d8c77386d69bc
U23 |  |  |  | 35bc40f298fdf5b6
U23
U3 |  |  |  | ab43c4a1468f2b19
U3 |  | RT9013-12GB | C58464
U4
U4 |  |  |  | 305d7c3b88ae7465
U5 |  |  |  | b061f15796cfe30b
U5 |  | ICM-42688-P | C1850418 | b061f15796cfe30b
U6 | ={Manufacturer Part} | ZX-SH1.0-6PWT | C7430448 | a9de697e8b895b64
U6 |  |  |  | a9de697e8b895b64
U7 | ={Manufacturer Part} | ZX-SH1.0-6PWT | C7430448 | a9de697e8b895b64
U7 |  |  |  | a9de697e8b895b64
U9 |  | TPN2R703NL,L1Q(M | C5307666
U9 |  |  |  | 85839d7c94a5c4f3
