xigua862/SMARTCAR2/车模/车模/镜头车模.SLDASM

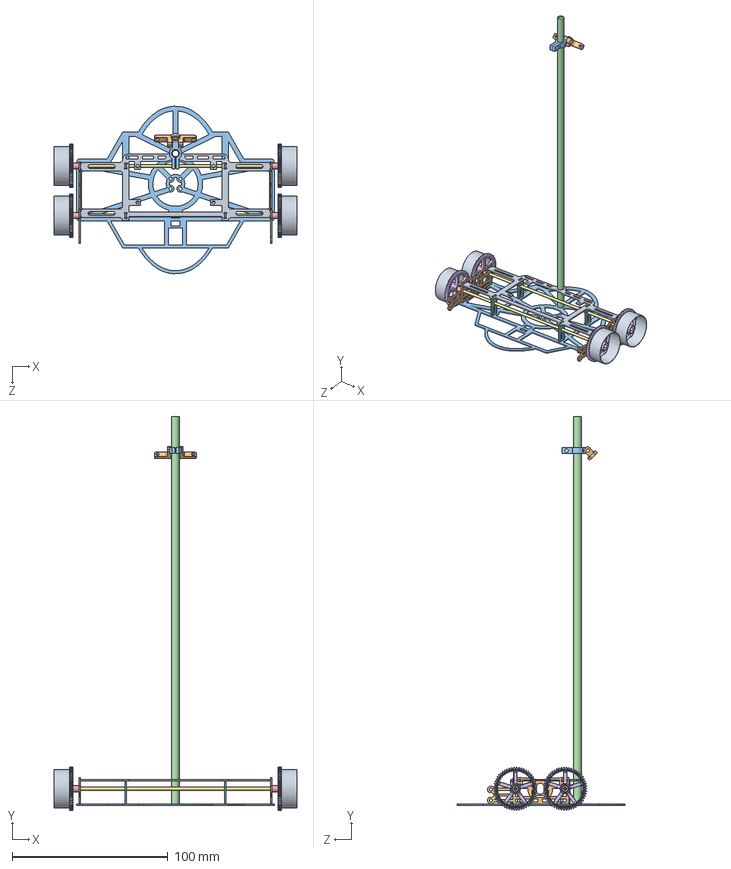
[picture p30: CAD file, 2026-10-02]
车模/车模/镜头车模.SLDASM
156.0 x 253.3 x 107.7 mm
底板镜头
54齿侧板 x 2
横板
支架 x 4
碳杆 x 2
54齿碳杆 x 4
轴套 x 4
摄像头碳杆
镜头支架2
镜头支架1
碳管轮毂 x 4
