xigua862/SMARTCAR2/100g-wall-climbing-mini-car/100g-wall-climbing-mini-car-master/底盘5.10petgcf.SLDPRT

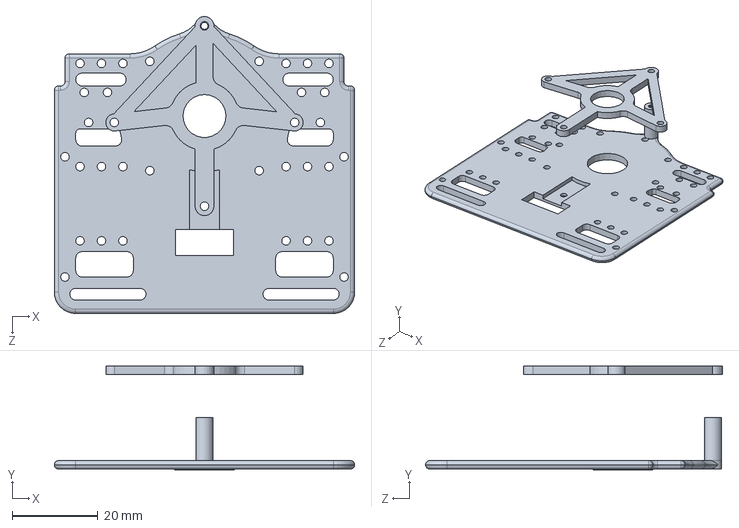
[picture p31: CAD file, 2026-10-02]
100g-wall-climbing-mini-car/100g-wall-climbing-mini-car-master/底盘5.10petgcf.SLDPRT
70.0 x 24.2 x 69.2 mm
