xigua862/SMARTCAR2/开源工程/100g爬壁小车/再改2次的尼龙.SLDPRT

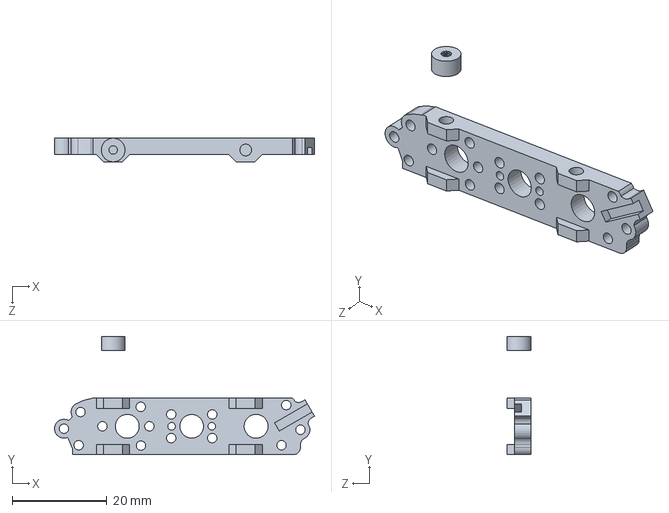
[picture p32: CAD file, 2026-10-02]
开源工程/100g爬壁小车/再改2次的尼龙.SLDPRT
54.9 x 25.0 x 5.00 mm
