xigua862/SMARTCAR2/开源工程/车模-SolidWorks/碳杆.SLDPRT

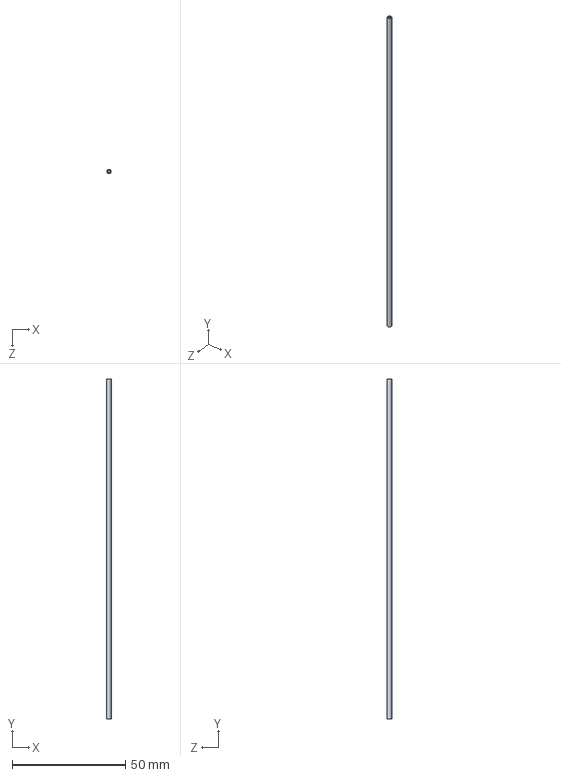
[picture p33: CAD file, 2026-10-02]
开源工程/车模-SolidWorks/碳杆.SLDPRT
2.00 x 150.0 x 2.00 mm
