xigua862/SMARTCAR2/硬件工程/丝印/丝印-校徽融合机器人工程.dxf

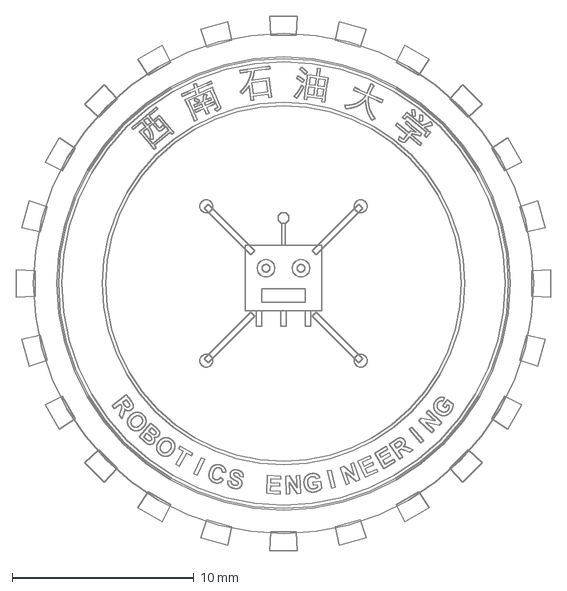
[picture p34: CAD file, 2026-10-12]
硬件工程/丝印/丝印-校徽融合机器人工程.dxf
29.4 x 29.4 mm
