xigua862/SMARTCAR2/车模/车模/摄像头碳杆.SLDPRT

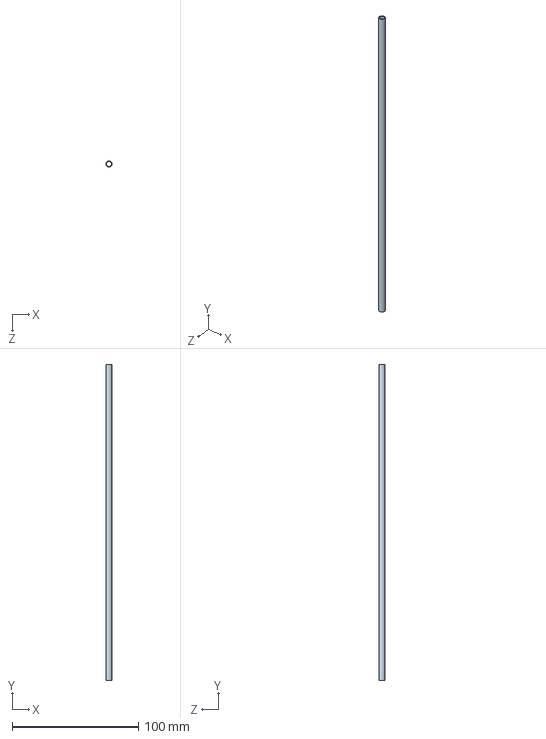
[picture p35: CAD file, 2026-10-02]
车模/车模/摄像头碳杆.SLDPRT
5.00 x 250.0 x 5.00 mm
