xigua862/SMARTCAR2/开源工程/100g爬壁小车/扇叶反向1104.SLDPRT

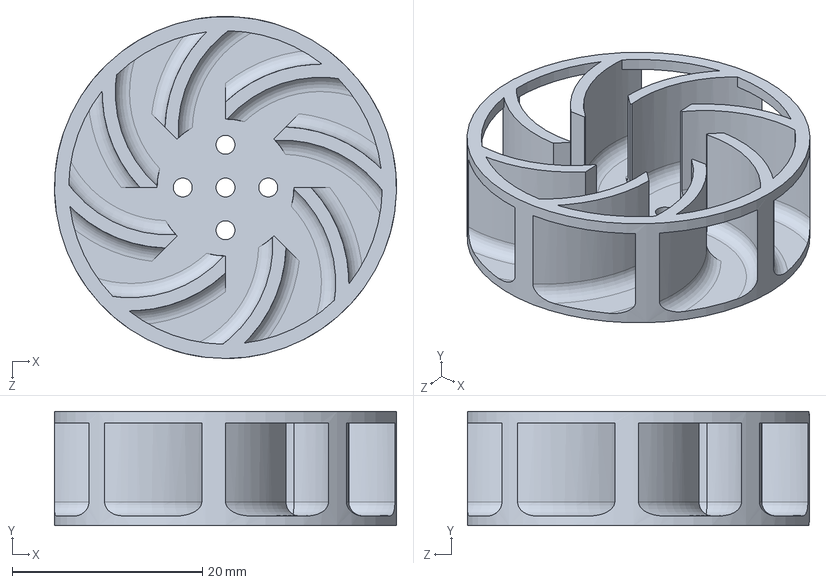
[picture p36: CAD file, 2026-10-02]
开源工程/100g爬壁小车/扇叶反向1104.SLDPRT
36.0 x 12.0 x 36.0 mm
