xigua862/SMARTCAR2/开源工程/车模-SolidWorks/支架.SLDPRT

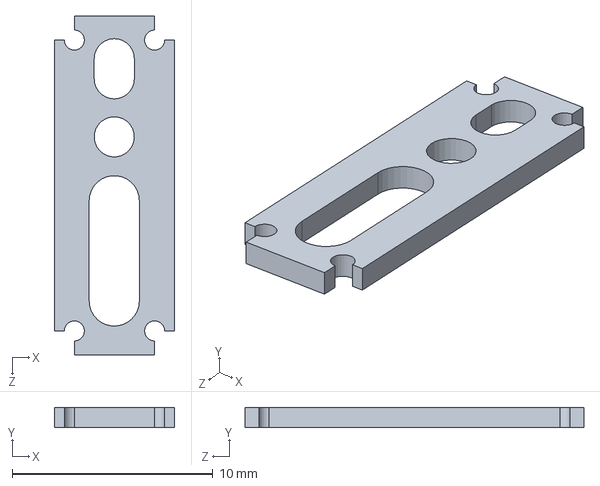
[picture p37: CAD file, 2026-10-02]
开源工程/车模-SolidWorks/支架.SLDPRT
6.00 x 1.00 x 16.9 mm
