xigua862/SMARTCAR2/车模/车模/54齿侧板.SLDPRT

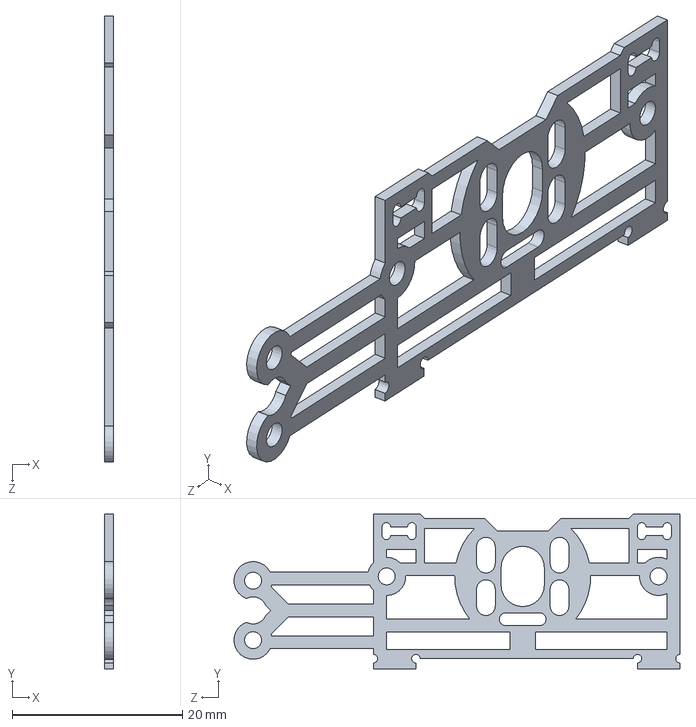
[picture p38: CAD file, 2026-10-02]
车模/车模/54齿侧板.SLDPRT
1.00 x 18.2 x 52.5 mm
