xigua862/SMARTCAR2/开源工程/100g爬壁小车/8mm车轮三条.SLDPRT

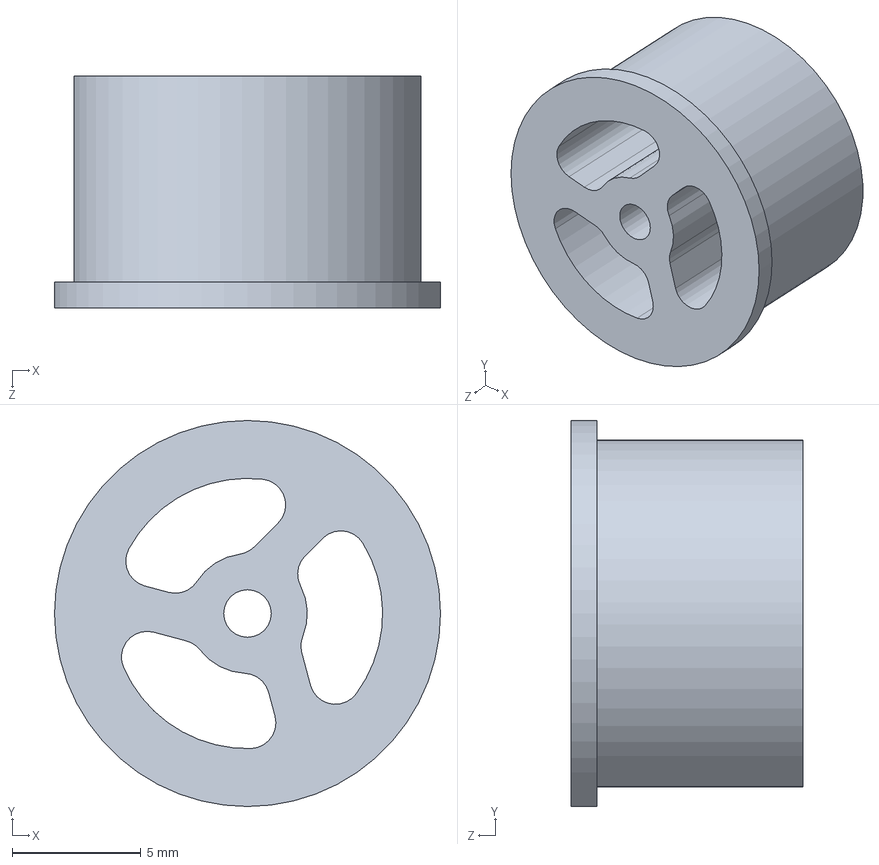
[picture p39: CAD file, 2026-10-02]
开源工程/100g爬壁小车/8mm车轮三条.SLDPRT
15.0 x 15.0 x 9.00 mm
