xigua862/SMARTCAR2/开源工程/车模-SolidWorks/镜头支架2.SLDPRT

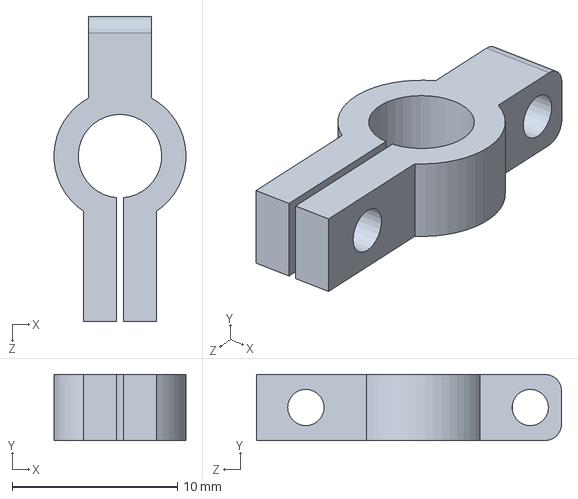
[picture p40: CAD file, 2026-10-02]
开源工程/车模-SolidWorks/镜头支架2.SLDPRT
7.99 x 4.00 x 18.5 mm
