xigua862/SMARTCAR2/车模/车模/横板.SLDPRT

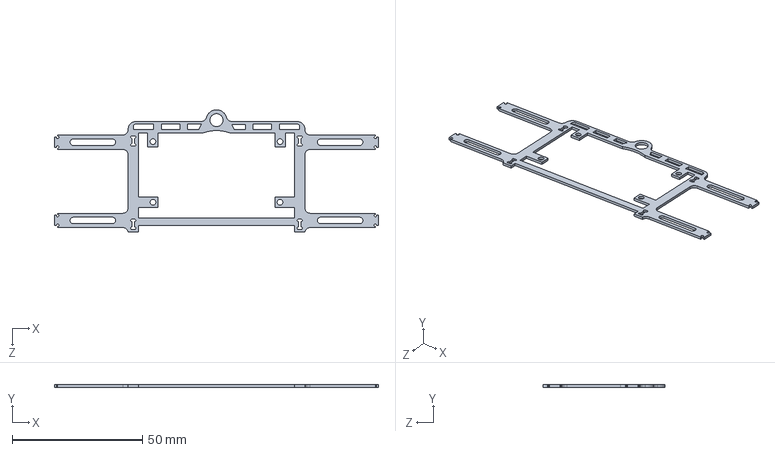
[picture p41: CAD file, 2026-10-02]
车模/车模/横板.SLDPRT
124.4 x 1 x 47.0 mm
