xigua862/SMARTCAR2/开源工程/100g爬壁小车/四轮改4.17钛合金2号.SLDPRT

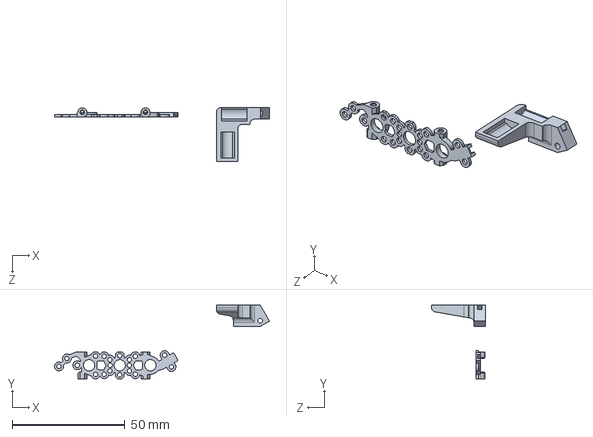
[picture p42: CAD file, 2026-10-02]
开源工程/100g爬壁小车/四轮改4.17钛合金2号.SLDPRT
95.5 x 32.7 x 24.0 mm
