xigua862/SMARTCAR2/开源工程/车模-SolidWorks/碳管轮毂.SLDPRT

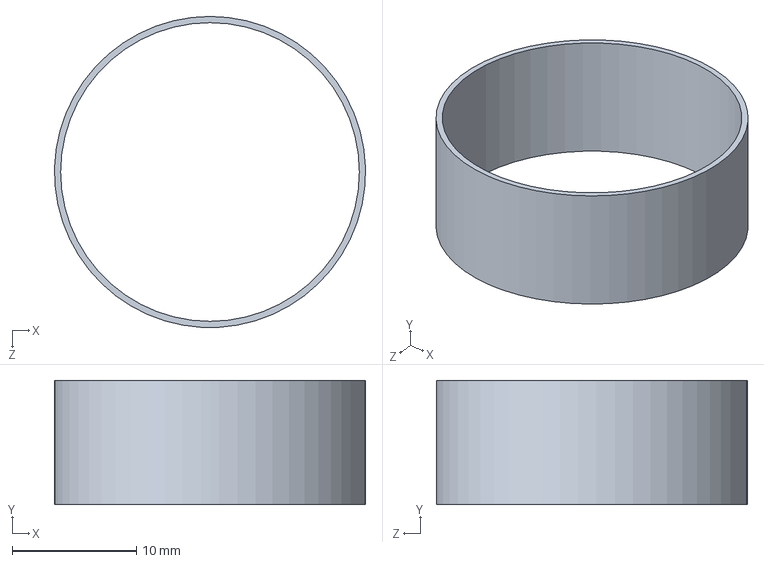
[picture p43: CAD file, 2026-10-02]
开源工程/车模-SolidWorks/碳管轮毂.SLDPRT
25.0 x 10.0 x 25.0 mm
