xigua862/SMARTCAR2/车模/车模/轴套.SLDPRT

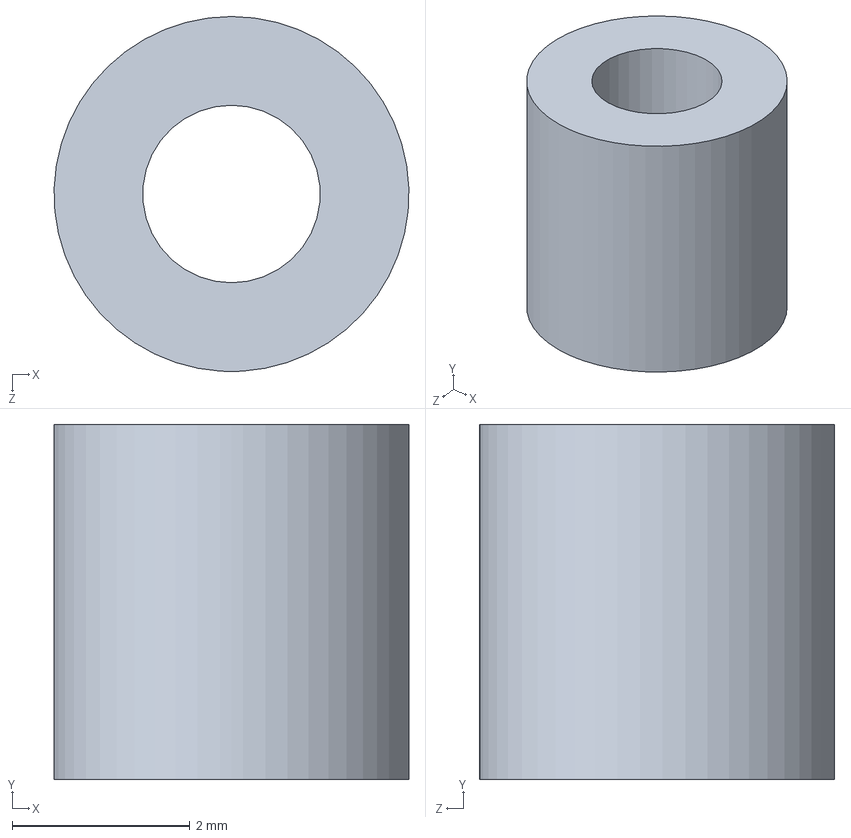
[picture p44: CAD file, 2026-10-02]
车模/车模/轴套.SLDPRT
4.00 x 4.00 x 4.00 mm
