xigua862/SMARTCAR2/开源工程/100g爬壁小车/底盘4.18 下午.SLDPRT

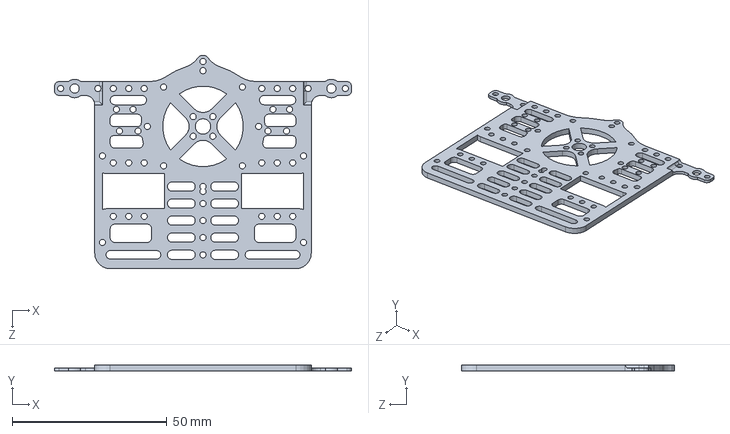
[picture p45: CAD file, 2026-10-02]
开源工程/100g爬壁小车/底盘4.18 下午.SLDPRT
96.0 x 2.00 x 69.0 mm
