xigua862/SMARTCAR2/车模/车模/54齿碳杆.SLDPRT

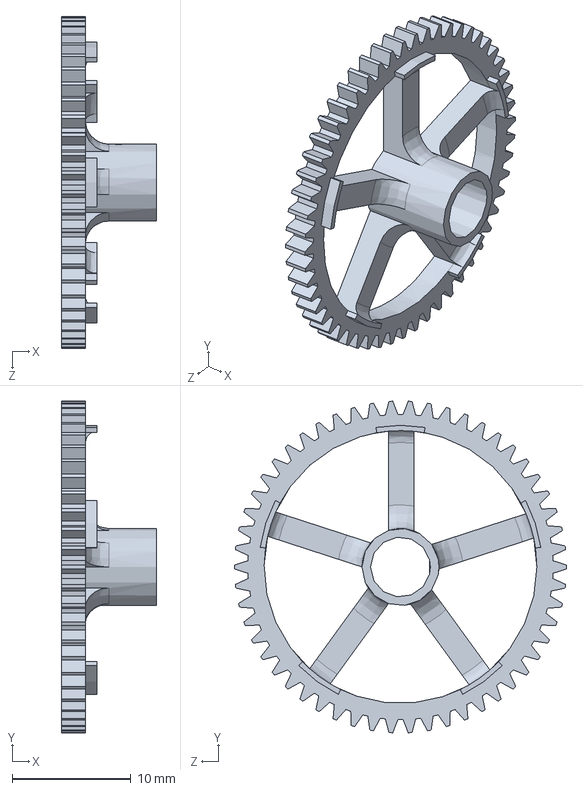
[picture p46: CAD file, 2026-10-02]
车模/车模/54齿碳杆.SLDPRT
8.00 x 28.0 x 28.0 mm
