xigua862/SMARTCAR2/开源工程/100g爬壁小车/底盘4.21petgcf.SLDPRT

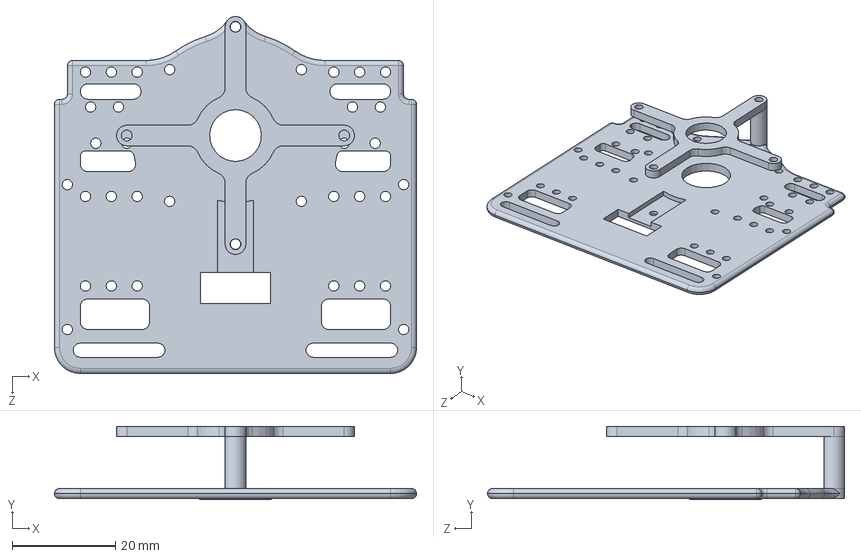
[picture p47: CAD file, 2026-10-02]
开源工程/100g爬壁小车/底盘4.21petgcf.SLDPRT
70.0 x 14.2 x 69.0 mm
