xigua862/SMARTCAR2/车模/车模/底板镜头.SLDPRT

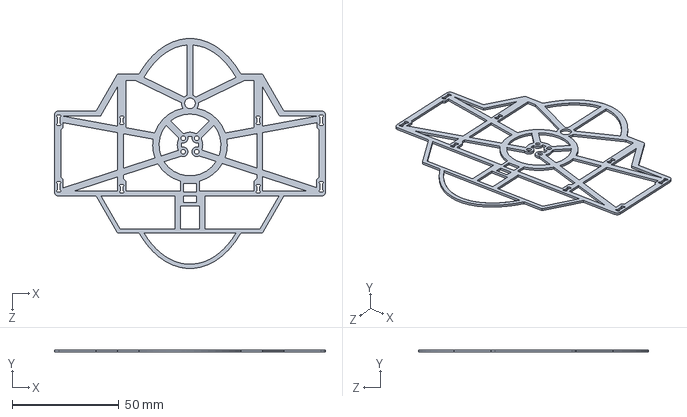
[picture p48: CAD file, 2026-10-02]
车模/车模/底板镜头.SLDPRT
127.0 x 1.00 x 107.7 mm
