xigua862/SMARTCAR2/车模/车模/镜头支架1.SLDPRT

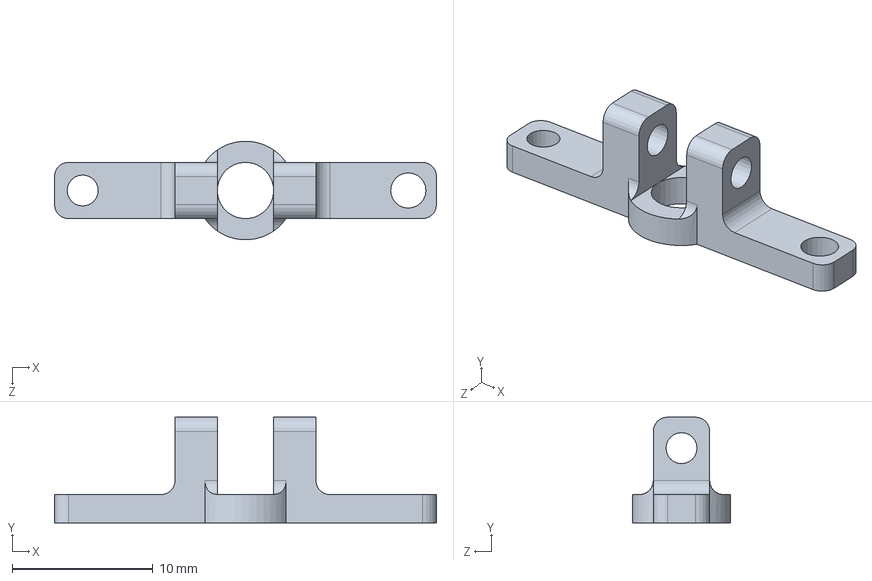
[picture p49: CAD file, 2026-10-02]
车模/车模/镜头支架1.SLDPRT
27.1 x 7.50 x 6.98 mm
