xigua862/SMARTCAR2/开源工程/微缩车模型-Micro_car/更新_看这个/A整车.SLDASM

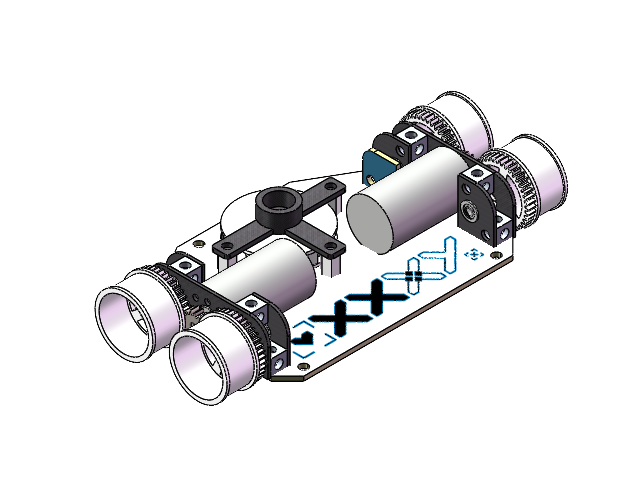
[picture p51: CAD file, 2026-10-02]
开源工程/微缩车模型-Micro_car/更新_看这个/A整车.SLDASM
侧板 x 2
F682-2Z 2×5×1.5_法兰轴承 x 6
零件9^轮 x 4
spur gear_gb x 2
六面螺母 x 8
胎皮 x 2
零件1 x 2
TSSOP-16_L5.0-W4.4-P0.65-LS6.4-BL~TSSOP-16_L5.0-W4.4-H1.0-LS6.4-P0.65~ZMgj.step
Board~ZMgj.step
扇叶 - 副本
8520支架 - 副本
铜柱7mm x 3
Board~bjQy.step
TopSilkscreen~bjQy.step
BottomSilkscreen~bjQy.step
