xigua862/SMARTCAR2/开源工程/微缩车模型-Micro_car/更新_看这个/侧轮整体.SLDASM

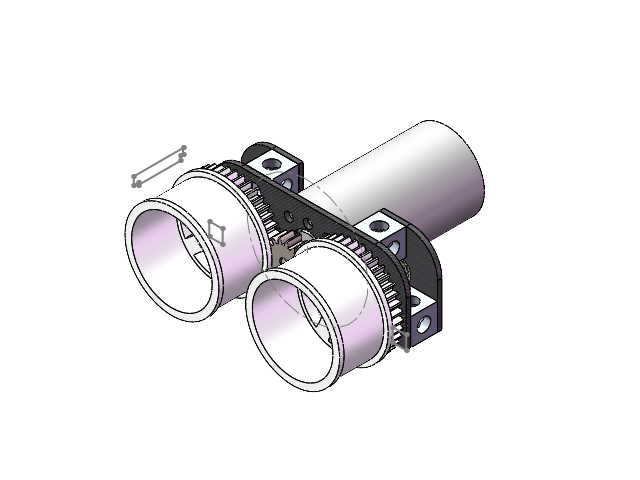
[picture p52: CAD file, 2026-10-02]
开源工程/微缩车模型-Micro_car/更新_看这个/侧轮整体.SLDASM
侧板
F682-2Z 2×5×1.5_法兰轴承 x 3
零件9^轮 x 2
spur gear_gb
六面螺母 x 4
胎皮
零件1
