xigua862/SMARTCAR2/(list of files, cad)

Other CAD files:
开源工程/微缩车模型-Micro_car/更新_看这个/轮.SLDASM
开源工程/惯导矫正仿真/地图.SLDPRT
开源工程/微缩车模型-Micro_car/更新_看这个/胎皮.SLDPRT
开源工程/惯导矫正仿真/地图.DXF
