xigua862/SMARTCAR2/MDK-ARM/build_log.txt

*** Using Compiler 'V5.06 update 5 (build 528)', folder: 'C:\Keil_v5\ARM\ARMCC\Bin'
Build target 'test16'
compiling main.c...
linking...
Program Size: Code=11124 RO-data=404 RW-data=52 ZI-data=1204  
FromELF: creating hex file...
"test16\test16.axf" - 0 Error(s), 0 Warning(s).
Build Time Elapsed:  00:00:01
