xigua862/SMARTCAR2/脚本/调参/存档-原版-20261011/调参日志.csv

round | phase | tune_key | lap | snapshot | finished | time_ms | dist_mm | line_rms | line_p95 | line_max | ins_rms | ins_p95 | comp_deg_mean | lost_count | reason | score | decision | note
1 | A | - | 1 | kp_steer=0.0204146;kd_steer=0.000801429;k_gyro=0.189355;kp_speed=1.20827;ki_speed=0.00685653;kd_speed=1.83375;vmax=2500;vmin=800;a_acc=2200;a_brake=3400;a_lat=5200;look_mm=58.1187;corr_kp=0.0017;corr_ki=3.4e-06;corr_kd=0.0002;corr_enc_k=1.2;straight_min=220;corner_margin=80;straight_deg=10;corr_on=1;autorun=0 | 1 | 8403.1 | 13720.0 | 1.873 | 4.657 | 9.390 | 2.954 | 6.766 | 0.705 | 0 | OK | 8.8232 | DIAG
1 | A | - | 2 | kp_steer=0.0204146;kd_steer=0.000801429;k_gyro=0.189355;kp_speed=1.20827;ki_speed=0.00685653;kd_speed=1.83375;vmax=2500;vmin=800;a_acc=2200;a_brake=3400;a_lat=5200;look_mm=58.1187;corr_kp=0.0017;corr_ki=3.4e-06;corr_kd=0.0002;corr_enc_k=1.2;straight_min=220;corner_margin=80;straight_deg=10;corr_on=1;autorun=0 | 1 | 8367.3 | 13720.0 | 1.888 | 4.682 | 9.455 | 2.941 | 6.777 | 0.705 | 0 | OK | 8.8232 | DIAG
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
