xigua862/SMARTCAR2/开源工程/惯导矫正仿真/开源说明/惯导控制思路.pdf

# 惯导跟表，直道把惯导拽回来

比赛车上没有 GPS，不知道自己在场地的哪一个坐标。能用的只有两样：

编码器：这一小段轮子滚了多远（路程 ds ）
陀螺：车头现在朝哪（航向 yaw ）

每走一小段，用「朝哪 × 走多远」算出新的 (x, y) 。一路加下去，就是惯导。建图时把这些点存下来，就是路表。 正式跑时按这张表开车。

线（光电 / 电感 / 摄像头）建图时用来稳稳贴线；正式跑时不再打方向，只在长直道上告诉你：惯导是不是歪了。 歪了就拧一下惯导的 yaw 。 yaw 一变，后面积出来的 (x, y) 才会慢慢走回来。

起点随便定，一般就当 (0, 0) ，车头朝上， yaw = 90° （和数学一样：0° 朝 +X，逆时针为正）。

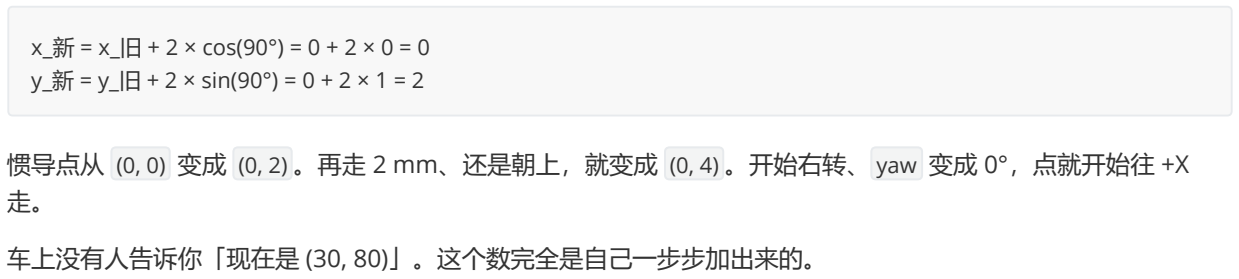
[picture p53: figure]
车上没有人告诉你「现在是 (30, 80)」。这个数完全是自己一步步加出来的。

惯导点从 (0, 0) 变成 (0, 2) 。再走 2 mm、还是朝上，就变成 (0, 4) 。开始右转、 yaw 变成 0°，点就开始往 +X

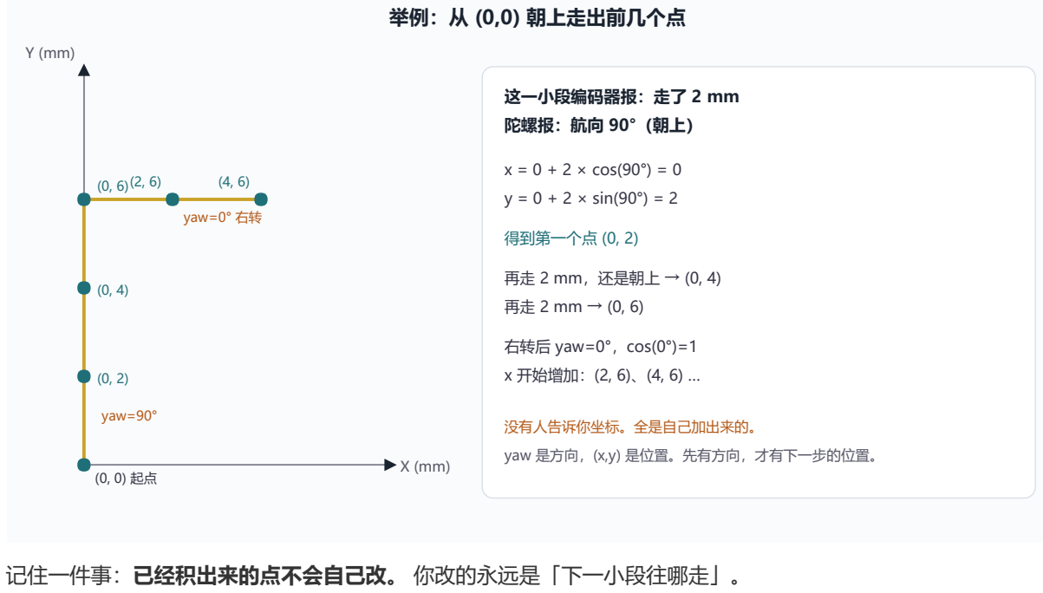
[picture p54: figure]
举例：从 (0,0) 朝上走出前几个点; yaw=90°; yaw=0° 右转; 这一小段编码器报：走了 2 mm 陀螺报：航向 90°（朝上）; x = 0 + 2 × cos(90°) = 0 y = 0 + 2 × sin(90°) = 2; 得到第一个点 (0, 2); 再走 2 mm，还是朝上 → (0, 4) 再走 2 mm → (0, 6); 右转后 yaw=0°，cos(0°)=1 x 开始增加：(2, 6)、(4, 6) …; 没有人告诉你坐标。全是自己加出来的。; yaw 是方向，(x,y) 是位置。先有方向，才有下一步的位置。; 记住一件事：已经积出来的点不会自己改。 你改的永远是「下一小段往哪走」。

# 2. 建图：这些点怎么变成一张表

x_新 = x_旧 + 2 × cos(90°) = 0 + 2 × 0 = 0
y_新 = y_旧 + 2 × sin(90°) = 0 + 2 × 1 = 2

# 2. 建图：这些点怎么变成一张表

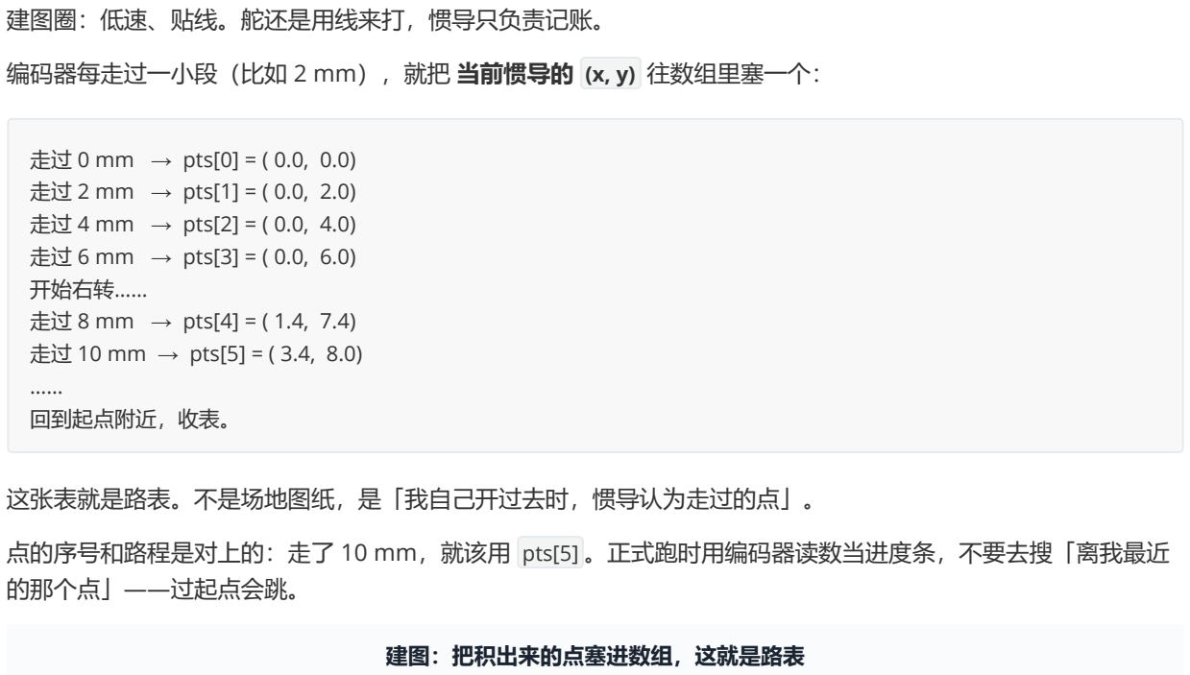
[picture p55: figure]
建图圈：低速、贴线。舵还是用线来打，惯导只负责记账。; 这张表就是路表。不是场地图纸，是「我自己开过去时，惯导认为走过的点」。; 点的序号和路程是对上的：走了 10 mm，就该用 pts[5] 。正式跑时用编码器读数当进度条，不要去搜「离我最近 的那个点」——过起点会跳。; 建图：把积出来的点塞进数组，这就是路表; 走过 0 mm → pts[0] = ( 0.0, 0.0) 走过 2 mm → pts[1] = ( 0.0, 2.0) 走过 4 mm → pts[2] = ( 0.0, 4.0) 走过 6 mm → pts[3] = ( 0.0, 6.0) 开始右转…… 走过 8 mm → pts[4] = ( 1.4, 7.4) 走过 10 mm → pts[5] = ( 3.4, 8.0) …… 回到起点附近，收表。

编码器每走过一小段（比如 2 mm），就把 当前惯导的 (x, y) 往数组里塞一个：

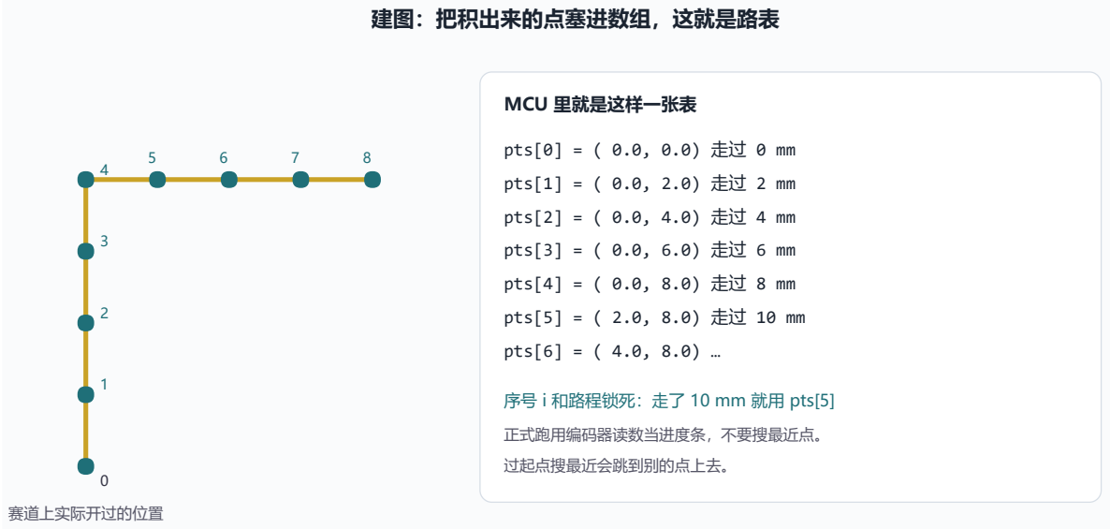
[picture p56: figure]
赛道上实际开过的位置; MCU 里就是这样一张表; pts[0] = ( 0.0, 0.0) 走过 0 mm; pts[1] = ( 0.0, 2.0) 走过 2 mm; pts[2] = ( 0.0, 4.0) 走过 4 mm; pts[3] = ( 0.0, 6.0) 走过 6 mm; pts[4] = ( 0.0, 8.0) 走过 8 mm; pts[5] = ( 2.0, 8.0) 走过 10 mm; pts[6] = ( 4.0, 8.0) …; 序号 i 和路程锁死：走了 10 mm 就用 pts[5]; 正式跑用编码器读数当进度条，不要搜最近点。; 过起点搜最近会跳到别的点上去。

表里不用存航向。相邻两点一减，就是那段路朝哪。前瞻点也是沿这张表再往前数几个，不是沿车头伸出去——头 已经偏了，沿车头看会越瞄越歪。

建图尽量慢、少丢线。表本身带一点偏没关系，后面矫正对准的就是这张表。

# 3. 正式跑：假装自己坐在惯导点上

控制器看不见车实际在哪，只看得见：

惯导现在的 (x, y) 、 yaw
路表上的点
编码器说走到第几毫米了

# 4. yaw 错了，(x, y) 会怎样

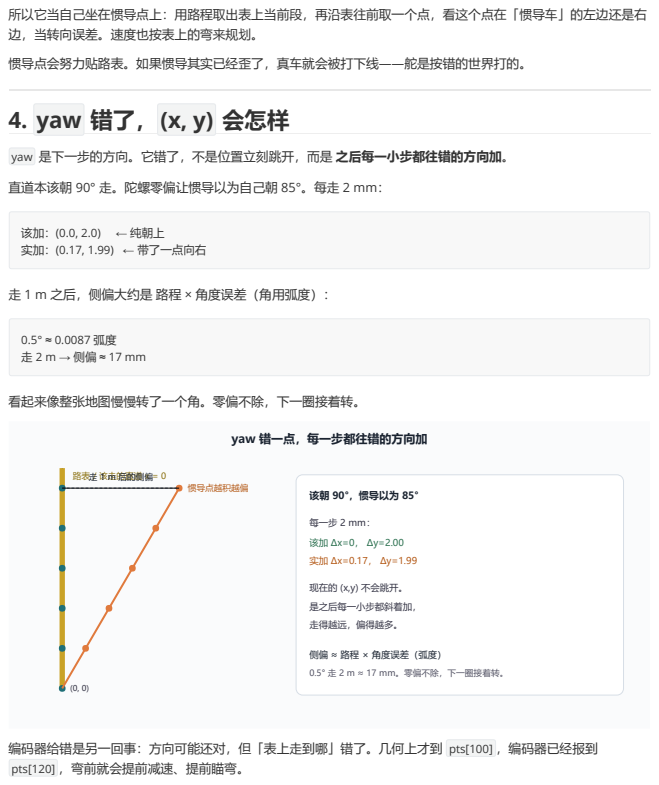
[picture p57: page 3]
路表 / 该走的直道 x = 0; 惯导点越积越偏; 走 1 m 后的侧偏; 该朝 90°，惯导以为 85°; 现在的 (x,y) 不会跳开。; 是之后每一小步都斜着加，; 走得越远，偏得越多。; 该加：(0.0, 2.0) ← 纯朝上 实加：(0.17, 1.99) ← 带了一点向右

所以它当自己坐在惯导点上：用路程取出表上当前段，再沿表往前取一个点，看这个点在「惯导车」的左边还是右
边，当转向误差。速度也按表上的弯来规划。
惯导点会努力贴路表。如果惯导其实已经歪了，真车就会被打下线——舵是按错的世界打的。

yaw 是下一步的方向。它错了，不是位置立刻跳开，而是 之后每一小步都往错的方向加。
直道本该朝 90° 走。陀螺零偏让惯导以为自己朝 85°。每走 2 mm：

走 1 m 之后，侧偏大约是 路程 × 角度误差（角用弧度）：

看起来像整张地图慢慢转了一个角。零偏不除，下一圈接着转。

yaw 错一点，每一步都往错的方向加

每一步 2 mm：

侧偏 ≈ 路程 × 角度误差（弧度）
0.5° 走 2 m ≈ 17 mm。零偏不除，下一圈接着转。

编码器给错是另一回事：方向可能还对，但「表上走到哪」错了。几何上才到 pts[100] ，编码器已经报到
pts[120] ，弯前就会提前减速、提前瞄弯。

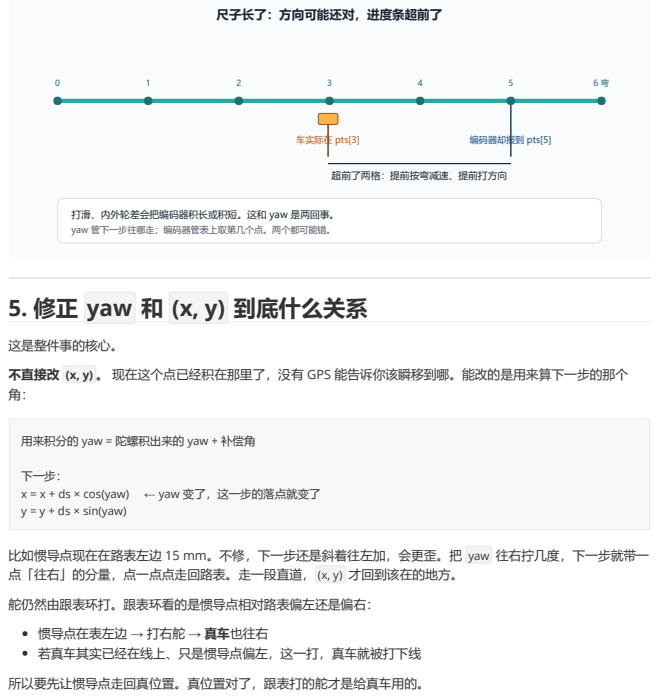
[picture p58: page 4]
车实际在 pts[3]; 编码器却报到 pts[5]

尺子长了：方向可能还对，进度条超前了

超前了两格：提前按弯减速、提前打方向

打滑、内外轮差会把编码器积长或积短。这和 yaw 是两回事。
yaw 管下一步往哪走；编码器管表上取第几个点。两个都可能错。

5. 修正 yaw 和 (x, y) 到底什么关系

这是整件事的核心。
不直接改 (x, y) 。 现在这个点已经积在那里了，没有 GPS 能告诉你该瞬移到哪。能改的是用来算下一步的那个

用来积分的 yaw = 陀螺积出来的 yaw + 补偿角

下一步：
x = x + ds × cos(yaw) ← yaw 变了，这一步的落点就变了
y = y + ds × sin(yaw)

比如惯导点现在在路表左边 15 mm。不修，下一步还是斜着往左加，会更歪。把 yaw 往右拧几度，下一步就带一
点「往右」的分量，点一点点走回路表。走一段直道， (x, y) 才回到该在的地方。
舵仍然由跟表环打。跟表环看的是惯导点相对路表偏左还是偏右：
惯导点在表左边 → 打右舵 → 真车也往右
若真车其实已经在线上、只是惯导点偏左，这一打，真车就被打下线
所以要先让惯导点走回真位置。真位置对了，跟表打的舵才是给真车用的。

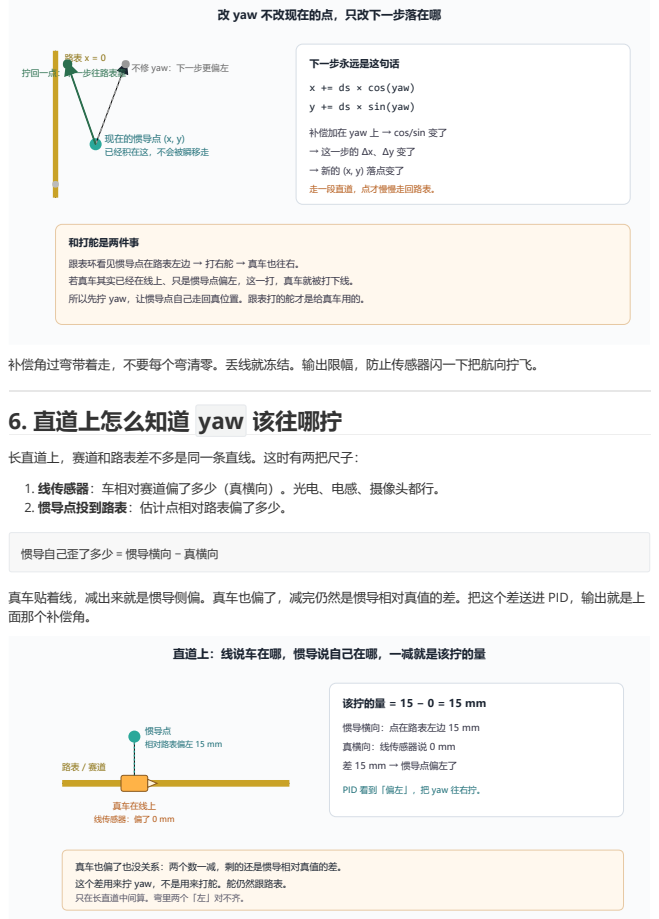
[picture p59: page 5]
现在的惯导点 (x, y) 已经积在这，不会被瞬移走; 下一步永远是这句话; 惯导点 相对路表偏左 15 mm; 该拧的量 = 15 − 0 = 15 mm

改 yaw 不改现在的点，只改下一步落在哪

不修 yaw：下一步更偏左 拧回一点：下一步往路表靠

x += ds × cos(yaw)
y += ds × sin(yaw)

补偿加在 yaw 上 → cos/sin 变了
→ 这一步的 Δx、Δy 变了
→ 新的 (x, y) 落点变了
走一段直道，点才慢慢走回路表。

和打舵是两件事
跟表环看见惯导点在路表左边 → 打右舵 → 真车也往右。
若真车其实已经在线上、只是惯导点偏左，这一打，真车就被打下线。
所以先拧 yaw，让惯导点自己走回真位置。跟表打的舵才是给真车用的。

补偿角过弯带着走，不要每个弯清零。丢线就冻结。输出限幅，防止传感器闪一下把航向拧飞。
6. 直道上怎么知道 yaw 该往哪拧

长直道上，赛道和路表差不多是同一条直线。这时有两把尺子：
1. 线传感器：车相对赛道偏了多少（真横向）。光电、电感、摄像头都行。
2. 惯导点投到路表：估计点相对路表偏了多少。

惯导自己歪了多少 = 惯导横向 − 真横向

真车贴着线，减出来就是惯导侧偏。真车也偏了，减完仍然是惯导相对真值的差。把这个差送进 PID，输出就是上
面那个补偿角。

直道上：线说车在哪，惯导说自己在哪，一减就是该拧的量

惯导横向：点在路表左边 15 mm
真横向：线传感器说 0 mm
差 15 mm → 惯导点偏左了

PID 看到「偏左」，把 yaw 往右拧。

真车在线上
线传感器：偏了 0 mm

真车也偏了也没关系：两个数一减，剩的还是惯导相对真值的差。
这个差用来拧 yaw，不是用来打舵。舵仍然跟路表。
只在长直道中间算。弯里两个「左」对不齐。

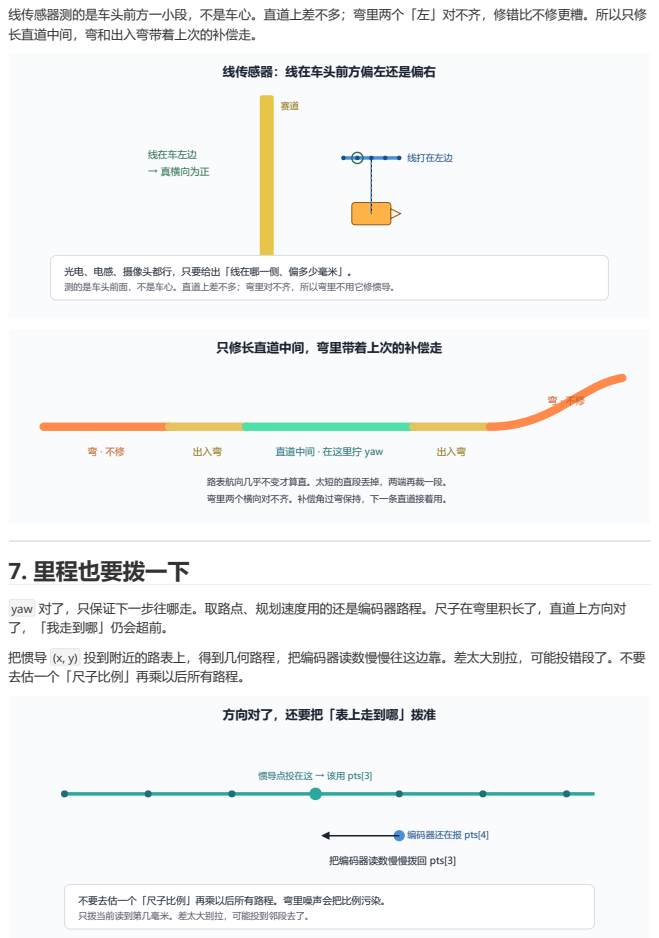
[picture p60: page 6]
线传感器：线在车头前方偏左还是偏右; 线在车左边; 线打在左边; → 真横向为正; 只修长直道中间，弯里带着上次的补偿走; 出入弯; 直道中间 · 在这里拧 yaw; 7. 里程也要拨一下; 编码器还在报 pts[4]; 把编码器读数慢慢拨回 pts[3]

线传感器测的是车头前方一小段，不是车心。直道上差不多；弯里两个「左」对不齐，修错比不修更糟。所以只修
长直道中间，弯和出入弯带着上次的补偿走。

光电、电感、摄像头都行，只要给出「线在哪一侧、偏多少毫米」。
测的是车头前面，不是车心。直道上差不多；弯里对不齐，所以弯里不用它修惯导。

路表航向几乎不变才算直。太短的直段丢掉，两端再裁一段。
弯里两个横向对不齐。补偿角过弯保持，下一条直道接着用。

yaw 对了，只保证下一步往哪走。取路点、规划速度用的还是编码器路程。尺子在弯里积长了，直道上方向对
了，「我走到哪」仍会超前。
把惯导 (x, y) 投到附近的路表上，得到几何路程，把编码器读数慢慢往这边靠。差太大别拉，可能投错段了。不要
去估一个「尺子比例」再乘以后所有路程。

方向对了，还要把「表上走到哪」拨准

惯导点投在这 → 该用 pts[3]

不要去估一个「尺子比例」再乘以后所有路程。弯里噪声会把比例污染。
只拨当前读到第几毫米。差太大别拉，可能投到邻段去了。

# 8. 上场时

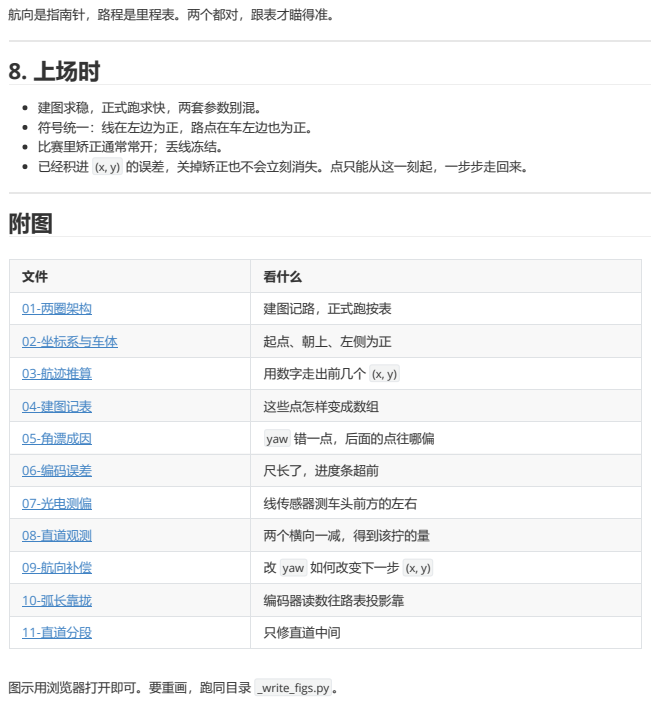
[picture p61: page 7]

航向是指南针，路程是里程表。两个都对，跟表才瞄得准。

建图求稳，正式跑求快，两套参数别混。
符号统一：线在左边为正，路点在车左边也为正。
比赛里矫正通常常开；丢线冻结。
已经积进 (x, y) 的误差，关掉矫正也不会立刻消失。点只能从这一刻起，一步步走回来。

文件 | 看什么

01-两圈架构 | 建图记路，正式跑按表

02-坐标系与车体 | 起点、朝上、左侧为正

03-航迹推算 | 用数字走出前几个 (x, y)

04-建图记表 | 这些点怎样变成数组

05-角漂成因 | yaw 错一点，后面的点往哪偏

06-编码误差 | 尺长了，进度条超前

07-光电测偏 | 线传感器测车头前方的左右

08-直道观测 | 两个横向一减，得到该拧的量

09-航向补偿 | 改 yaw 如何改变下一步 (x, y)

10-弧长靠拢 | 编码器读数往路表投影靠

11-直道分段 | 只修直道中间

图示用浏览器打开即可。要重画，跑同目录 _write_gs.py 。
