xigua862/SMARTCAR2/固件-STM32空壳/Core/Inc/main.h

#define DIR1_Pin GPIO_PIN_4
#define DIR1_GPIO_Port GPIOA
#define DIR2_Pin GPIO_PIN_5
#define DIR2_GPIO_Port GPIOA
#define DIR3_Pin GPIO_PIN_3
#define DIR3_GPIO_Port GPIOB
#define DIR4_Pin GPIO_PIN_4
#define DIR4_GPIO_Port GPIOB
#define IR_L_Pin GPIO_PIN_8
#define IR_L_GPIO_Port GPIOA
#define IR_LM_Pin GPIO_PIN_15
#define IR_LM_GPIO_Port GPIOA
#define IR_C_Pin GPIO_PIN_5
#define IR_C_GPIO_Port GPIOB
#define IR_RM_Pin GPIO_PIN_6
#define IR_RM_GPIO_Port GPIOB
#define IR_R_Pin GPIO_PIN_7
#define IR_R_GPIO_Port GPIOB
#define HALL1_Pin GPIO_PIN_11
#define HALL1_GPIO_Port GPIOA
#define HALL2_Pin GPIO_PIN_12
#define HALL2_GPIO_Port GPIOA
