xigua862/SMARTCAR2/开源工程/TC264逐飞开源库/user/cyh_code/cyh_motor.h

#ifndef _cyh_motor_h
#define _cyh_motor_h

/******************************************************************************/
/*----------------------------------Includes----------------------------------*/
/******************************************************************************/

#include "zf_common_headfile.h"
#include "cyh_headfile.h"

/******************************************************************************/
/*-----------------------------------Macros-----------------------------------*/
/******************************************************************************/

/******************************************************************************/
/*------------------------------Type Definitions------------------------------*/
/******************************************************************************/

extern int pwml,pwmr;
extern float speedtobel,speedtober;


void motor_int(void);
void motor_out(void);
void madasudu(void);


#endif
