xigua862/SMARTCAR2/纯跟踪算法-19届负压镜头源码/Seekfree_TC264_Opensource_Library/user/cyh_code/cyh_encoder.h

#ifndef _cyh_encoder_h
#define _cyh_encoder_h

/******************************************************************************/
/*----------------------------------Includes----------------------------------*/
/******************************************************************************/

#include "zf_common_headfile.h"
#include "cyh_headfile.h"

/******************************************************************************/
/*-----------------------------------Macros-----------------------------------*/
/******************************************************************************/

/******************************************************************************/
/*------------------------------Type Definitions------------------------------*/
/******************************************************************************/

extern int speedl,speedr;



void encoder_int(void);
void get_encoder(void);


#endif
