xigua862/SMARTCAR2/开源工程/马铃薯-国赛光电管-5.5m/国赛光电管/smartcar/Crazy_Car/Seekfree_TC264_Opensource_Library/code/nav_path.h

//-------------------------------------------------------------------------
// nav_path.h - 由 map_editor.html 自动生成,请勿手改
// 生成时间: 2026/8/23 10:01:42
// 采样间隔: 5 mm; 航向单位: 0.01 度; 相对发车朝向,右转为正
// 坐标 nav_path_x/y 单位 mm,发车坐标系:原点=路线起点,x=发车朝向,y=其右侧
// nav_path_curvature 单位: 0.000001 rad/mm 每 LSB,由连续航向表离线差分生成
// nav_path_curvature_derivative 单位: 1e-8 rad/mm² 每 LSB
// nav_speed_cmps RLE: 每LSB=0.1cm/s; nav_acceleration_cmps2 RLE单位: cm/s²
// 本文件只包含地图编辑器当前选中的一条路线和当前播放方向。
// 如需反向运行，请在导出前对当前路线点击‘反转路线’；车端固定使用路线 0。
// [0] 盲盒任务：第二圈 P53-P35 后矩形中心(当前播放方向): P87 -> P56 -> P88 -> P3 -> P57 -> P9 -> P58 -> P8 -> P60 -> P53 -> P37 -> P65 -> P64 -> P36 -> P15 -> P13 -> P12 -> P61 -> P11 -> P10 -> P62 -> P13 -> P15 -> P63 -> P8 -> P60 -> P53 -> P35 -> P83 -> P86 -> P52 -> P43 -> P39 -> P41 -> P24 -> P74 -> P23 -> P22 -> P28 -> P31 -> P32 -> P33 -> P34 -> P31 -> P28 -> P75 -> P29 -> P30 -> P47 -> P48 -> P78 -> P79 -> P50 -> P49 -> P80 -> P77 -> P47 -> P30 -> P76 -> P44 -> P45 -> P67 -> P42 -> P40 -> P66 -> P39 -> P82 -> P26 -> P73 -> P72 -> P25 -> P81 -> P18 -> P70 -> P17 -> P59 -> P5 -> P6 -> P68 -> P7 -> P69 -> P21 -> P19 -> P71 -> P18 -> P70 -> P17 -> P59 -> P5 -> P4 -> P1 -> P54 -> P2 -> P16 -> P55 -> P4 -> P1 -> P54 -> P2 -> P87 -> P56 -> P88 -> P3 -> P57 -> P9 -> P58 -> P8 -> P60 -> P53 -> P35 -> P83 -> BLIND_CENTER
//     目标几何 46.88 m, 拓扑折线 49.87 m, 9376 点, Pure Pursuit 自适应圆弧(名义半径 150 mm, 缓和每侧 0 mm)
//     几何拟合说明: 连续短弯链 P35->P83 已合并为单条复合曲线；峰值曲率 0.006643 1/mm，曲率上限 0.006667 1/mm。 连续短弯链 P35->P83 已合并为单条复合曲线；峰值曲率 0.006627 1/mm，曲率上限 0.006667 1/mm。
//     复合短弯 P35->P83: cut 178.12/187.50 mm, handle 344.55 mm, peak kappa 0.00664316 1/mm <= 0.00666667 1/mm, saving 123.23 mm, circular_arc_curvature_blend.v12
//     复合短弯 P35->P83: cut 150.00/306.70 mm, handle 353.08 mm, peak kappa 0.00662675 1/mm <= 0.00666667 1/mm, saving 225.69 mm, circular_arc_curvature_blend.v12
//     扫描特征 69 个原始顶点(连续顶点构成物理线段,不做圆角化)
//-------------------------------------------------------------------------
#ifndef NAV_PATH_H_
#define NAV_PATH_H_

#define NAV_PATH_SAMPLE_MM (5.0f)
#define NAV_SINGLE_ROUTE_PROTOCOL (1)
#define NAV_SOURCE_ROUTE_INDEX (0u)
#define NAV_PATH_COUNT (1)
#define NAV_ROUTE_BLIND_BOX (1)
#define NAV_REFERENCE_CURVATURE_TABLES (1)
#define NAV_REFERENCE_CURVATURE_LSB_PER_MM (0.000001f)
#define NAV_REFERENCE_CURVATURE_DERIVATIVE_TABLES (1)
#define NAV_REFERENCE_CURVATURE_DERIVATIVE_LSB_PER_MM2 (1e-8f)
#define NAV_REFERENCE_SPEED_TABLES (1)
#define NAV_REFERENCE_SPEED_LSB_CMPS (0.1f)
#define NAV_REFERENCE_ACCELERATION_TABLES (1)
#define NAV_REFERENCE_ACCELERATION_LSB_CMPS2 (1.0f)
#define NAV_SPEED_PROFILE_PRECOMPUTED (1)
#define NAV_SPEED_PROFILE_MAX_SPEED_CMPS (420.0f)
#define NAV_SPEED_PROFILE_MAX_ACCEL_CMPS2 (3000.0f)
#define NAV_SPEED_PROFILE_MAX_DECEL_CMPS2 (5000.0f)
#define NAV_SPEED_PROFILE_MAX_LATERAL_ACCEL_CMPS2 (11760.0f)
#define NAV_SPEED_PROFILE_SAFETY_MARGIN_MM (80.0f)
#define NAV_SPEED_PROFILE_END_CMPS (0.0f)

// [0] 盲盒任务：第二圈 P53-P35 后矩形中心(当前播放方向): P87 -> P56 -> P88 -> P3 -> P57 -> P9 -> P58 -> P8 -> P60 -> P53 -> P37 -> P65 -> P64 -> P36 -> P15 -> P13 -> P12 -> P61 -> P11 -> P10 -> P62 -> P13 -> P15 -> P63 -> P8 -> P60 -> P53 -> P35 -> P83 -> P86 -> P52 -> P43 -> P39 -> P41 -> P24 -> P74 -> P23 -> P22 -> P28 -> P31 -> P32 -> P33 -> P34 -> P31 -> P28 -> P75 -> P29 -> P30 -> P47 -> P48 -> P78 -> P79 -> P50 -> P49 -> P80 -> P77 -> P47 -> P30 -> P76 -> P44 -> P45 -> P67 -> P42 -> P40 -> P66 -> P39 -> P82 -> P26 -> P73 -> P72 -> P25 -> P81 -> P18 -> P70 -> P17 -> P59 -> P5 -> P6 -> P68 -> P7 -> P69 -> P21 -> P19 -> P71 -> P18 -> P70 -> P17 -> P59 -> P5 -> P4 -> P1 -> P54 -> P2 -> P16 -> P55 -> P4 -> P1 -> P54 -> P2 -> P87 -> P56 -> P88 -> P3 -> P57 -> P9 -> P58 -> P8 -> P60 -> P53 -> P35 -> P83 -> BLIND_CENTER
static const signed short nav_path_data_0[9376] =
{
    0, 0, 0, 0, 0, 0, 0, 0, 0, 0, 0, 0, 0, 0, 0, 0,
    0, 0, 0, 0, 0, 0, 0, 0, 0, 0, 0, 0, 0, 0, 0, 0,
    0, 0, 0, 0, 0, 0, 0, 0, 0, 0, 0, 0, 0, 0, 0, 0,
    0, 0, 0, 0, 0, 0, 0, 0, 0, 0, 0, 0, 0, 0, 0, 0,
    0, 0, 0, 0, 0, 0, 0, 0, 0, 0, 0, 0, 0, 0, 0, 0,
    0, 0, 0, 0, 0, 0, 0, 0, 0, 0, 0, 0, 0, 0, 0, 0,
    0, 0, 0, 0, 0, 0, 0, 0, 0, 0, 0, 0, 0, 0, 0, 0,
    0, 0, 0, 0, 0, 0, 0, 0, 0, 0, 0, 0, 0, 0, 0, 0,
    0, 0, 0, 0, 0, 0, 0, 0, 0, 0, 0, 0, 0, 0, 0, 0,
    0, 0, 0, 0, 0, 0, 0, 0, 0, 0, 0, 0, 0, 0, 0, 0,
    0, 0, 0, 0, 0, 0, 0, 0, 0, 0, 0, 0, 0, 0, 0, 0,
    0, 0, 0, 0, 0, 0, 0, 0, 0, 0, 0, 0, 0, 0, 0, 0,
    0, 0, 0, 0, 0, 0, 0, 0, 0, 0, 0, 0, 0, 0, 0, 0,
    0, 0, 0, 0, 0, 0, 0, 0, 0, 0, 0, 0, 0, 0, 0, 0,
    0, 0, 0, 0, 0, 0, 0, 0, 0, 0, 0, -191, -382, -573, -764, -955,
    -1146, -1337, -1528, -1719, -1910, -2101, -2292, -2483, -2674, -2865, -3056, -3247, -3438, -3629, -3820, -4011,
    -4202, -4393, -4584, -4775, -4966, -5157, -5348, -5539, -5730, -5921, -6112, -6303, -6494, -6685, -6875, -7066,
    -7257, -7448, -7639, -7830, -8021, -8212, -8403, -8594, -8785, -8976, -9000, -9000, -9000, -9000, -9000, -9000,
    -9000, -9000, -9000, -9000, -9000, -9000, -9000, -9000, -9000, -9000, -9000, -9000, -9000, -9000, -9000, -9000,
    -9000, -9000, -9000, -9000, -9000, -9000, -9000, -9000, -9000, -9000, -9000, -9000, -9000, -9000, -9000, -9000,
    -9000, -9000, -9000, -9000, -9000, -9000, -9000, -9000, -9000, -9000, -9000, -9000, -9000, -9000, -9000, -9000,
    -9000, -9000, -9000, -9000, -9000, -9000, -9000, -9000, -9000, -9000, -9000, -9000, -9000, -9000, -9000, -9000,
    -9000, -9000, -9000, -9000, -9000, -9000, -9000, -9000, -9000, -9000, -9000, -9000, -9000, -9000, -9000, -9000,
    -9000, -9000, -9000, -9000, -9000, -9000, -9000, -9000, -9000, -9000, -9000, -9000, -9000, -9000, -9000, -9000,
    -9000, -9000, -9000, -9000, -9000, -9000, -9000, -9000, -9000, -9000, -9000, -9000, -9000, -9000, -9000, -9000,
    -9000, -9000, -9000, -9000, -9000, -9000, -9000, -9000, -9000, -9000, -9000, -9000, -9000, -9000, -9000, -9000,
    -9000, -9000, -9000, -9000, -9000, -9000, -9000, -9000, -9000, -9000, -9000, -9000, -9000, -9000, -9000, -9000,
    -9000, -9000, -9000, -9000, -9000, -9000, -9000, -9000, -9000, -9000, -9000, -9000, -9000, -9000, -9000, -9000,
    -9000, -9000, -9000, -9000, -9000, -9000, -9000, -9000, -9000, -9000, -9000, -9000, -9000, -9000, -9000, -9000,
    -9000, -9000, -9000, -9000, -9000, -9000, -9000, -9000, -9000, -9000, -9000, -9000, -9000, -9000, -9000, -9000,
    -9000, -9000, -9000, -9000, -9000, -9000, -9000, -9000, -9000, -9000, -9000, -9000, -9000, -9000, -9000, -9000,
    -9000, -9000, -9000, -9000, -9000, -9000, -9000, -9000, -9000, -9000, -9000, -9000, -9000, -9000, -9000, -9000,
    -9000, -9000, -9000, -9000, -9000, -9000, -9000, -9000, -9000, -9000, -9000, -9000, -9000, -9000, -9000, -9000,
    -9000, -9000, -9000, -9000, -9000, -9000, -9000, -9000, -9000, -9000, -9000, -9000, -9000, -9000, -8833, -8642,
    -8451, -8260, -8069, -7878, -7687, -7496, -7305, -7114, -6923, -6732, -6541, -6350, -6159, -5968, -5777, -5586,
    -5395, -5204, -5013, -4822, -4631, -4440, -4249, -4058, -3867, -3676, -3485, -3294, -3103, -2912, -2721, -2530,
    -2339, -2148, -1957, -1766, -1575, -1384, -1193, -1002, -811, -620, -429, -238, -47, 0, 0, 0,
    0, 0, 0, 0, 0, 0, 0, 0, 0, 0, 0, 0, 0, 0, 0, 0,
    0, 0, 0, 0, 0, 0, 0, 0, 0, 0, 0, 0, 0, 0, 0, 0,
    0, 0, 0, 0, 0, 0, 0, 0, 0, 0, 0, 0, 0, 0, 0, 0,
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
};

static const signed short nav_path_x_0[9376] =
{
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
    9363, 9364, 9366, 9367, 9368, 9369, 9370, 9371, 9372, 9373, 9374, 9375,
};
static const signed short nav_acceleration_cmps2_0[92] =
{
    2483, 3104, 3034, 3009, 3002, 2995, 3001, 2987, 2974, 2973, 2972, 2975, 2984, 2972, 2973, 2966,
    2975, 2979, 2977, 2971, 2958, 2968, 2975, 2978, 2975, 2968, 2959, 2947, 2963, 2977, 2958, 2969,
    2978, 2953, 2959, 2963, 2966, 2968, 2969, 2968, 2966, 2963, 2958, 2953, 2946, 2976, 2968, 2959,
    2948, 2936, 2964, 2951, 2936, 2962, 2946, 2093, 630, 0, -1092, -3590, -4978, -4985, -4989, -4985,
    -4977, -4965, -4949, -4965, -4974, -4978, -4974, -4965, -4980, -4986, -4983, -4970, -4976, -4968, -4976, -4991,
    -4988, -4986, -4977, -4993, -4988, -5000, -5021, -5027, -5051, -5155, -7063, 0,
};

// [0] 全黑保护放宽区 60 段(样本下标;可信点云匹配后可短时放宽停车保护;转向始终使用地图目标 yaw;曲线入口提前150mm/出口不后延,起终点前/后300/100mm,直穿三叉路口前/后0/0mm;直行必经点和直行四叉路口不单独放宽;手工保护点前/后0/0mm):
//     [0..99](0.00~0.49m)ROUTE_START+START:P56 [204..281](1.02~1.41m)CURVE_MAP_TAKEOVER [361..361](1.80~1.80m)JUNCTION:P9 [512..588](2.56~2.94m)CURVE_MAP_TAKEOVER [628..628](3.14~3.14m)JUNCTION:P37 [769..845](3.85~4.22m)CURVE_MAP_TAKEOVER+JUNCTION:P36 [915..915](4.58~4.58m)JUNCTION:P15 [1025..1025](5.13~5.13m)JUNCTION:P13 [1076..1152](5.38~5.76m)CURVE_MAP_TAKEOVER [1253..1329](6.26~6.64m)CURVE_MAP_TAKEOVER [1350..1426](6.75~7.13m)CURVE_MAP_TAKEOVER+JUNCTION:P10 [1527..1603](7.63~8.02m)CURVE_MAP_TAKEOVER+JUNCTION:P13 [1624..1700](8.12~8.50m)CURVE_MAP_TAKEOVER+JUNCTION:P15 [1881..1958](9.40~9.79m)CURVE_MAP_TAKEOVER [2013..2125](10.06~10.63m)CURVE_MAP_TAKEOVER+JUNCTION:P35+JUNCTION:P83 [2209..2337](11.04~11.69m)CURVE_MAP_TAKEOVER+JUNCTION:P43 [2448..2524](12.24~12.62m)CURVE_MAP_TAKEOVER+JUNCTION:P41 [2855..2855](14.28~14.28m)JUNCTION:P23 [2895..2971](14.47~14.86m)CURVE_MAP_TAKEOVER+JUNCTION:P22 [3052..3052](15.26~15.26m)JUNCTION:P28 [3172..3172](15.86~15.86m)JUNCTION:P31 [3212..3289](16.06~16.45m)CURVE_MAP_TAKEOVER [3300..3376](16.50~16.88m)CURVE_MAP_TAKEOVER [3387..3463](16.93~17.32m)CURVE_MAP_TAKEOVER [3474..3550](17.37~17.75m)CURVE_MAP_TAKEOVER+JUNCTION:P31 [3581..3657](17.91~18.29m)CURVE_MAP_TAKEOVER+JUNCTION:P28 [3818..3818](19.09~19.09m)JUNCTION:P29 [3868..3944](19.34~19.72m)CURVE_MAP_TAKEOVER [4025..4025](20.13~20.13m)JUNCTION:P47 [4075..4151](20.38~20.75m)CURVE_MAP_TAKEOVER [4462..4538](22.31~22.69m)CURVE_MAP_TAKEOVER [4559..4636](22.80~23.18m)CURVE_MAP_TAKEOVER+JUNCTION:P49 [4947..5023](24.73~25.11m)CURVE_MAP_TAKEOVER+JUNCTION:P47 [5044..5120](25.22~25.60m)CURVE_MAP_TAKEOVER [5291..5367](26.45~26.84m)CURVE_MAP_TAKEOVER+JUNCTION:P44 [5388..5464](26.94~27.32m)CURVE_MAP_TAKEOVER+JUNCTION:P45 [5515..5591](27.57~27.95m)CURVE_MAP_TAKEOVER+JUNCTION:P42 [5612..5688](28.06~28.44m)CURVE_MAP_TAKEOVER+JUNCTION:P40 [6199..6275](31.00~31.38m)CURVE_MAP_TAKEOVER+JUNCTION:P25 [6296..6373](31.48~31.86m)CURVE_MAP_TAKEOVER+JUNCTION:P18 [6384..6460](31.92~32.30m)CURVE_MAP_TAKEOVER+JUNCTION:P17 [6681..6757](33.41~33.78m)CURVE_MAP_TAKEOVER+JUNCTION:P5 [6877..6877](34.38~34.38m)JUNCTION:P6 [6968..7044](34.84~35.22m)CURVE_MAP_TAKEOVER+JUNCTION:P7 [7224..7224](36.12~36.12m)JUNCTION:P21 [7265..7341](36.33~36.70m)CURVE_MAP_TAKEOVER+JUNCTION:P19 [7512..7512](37.56~37.56m)JUNCTION:P18 [7552..7628](37.76~38.14m)CURVE_MAP_TAKEOVER+JUNCTION:P17 [7909..7909](39.55~39.55m)JUNCTION:P5 [8029..8029](40.15~40.15m)JUNCTION:P4 [8069..8145](40.34~40.73m)CURVE_MAP_TAKEOVER [8166..8242](40.83~41.21m)CURVE_MAP_TAKEOVER+JUNCTION:P2 [8253..8330](41.27~41.65m)CURVE_MAP_TAKEOVER [8351..8427](41.76~42.13m)CURVE_MAP_TAKEOVER+JUNCTION:P4 [8438..8514](42.19~42.57m)CURVE_MAP_TAKEOVER [8594..8594](42.97~42.97m)JUNCTION:P2 [8669..8749](43.34~43.74m)START:P56 [8855..8931](44.27~44.66m)CURVE_MAP_TAKEOVER [9011..9011](45.05~45.05m)JUNCTION:P9 [9212..9375](46.06~46.88m)CURVE_MAP_TAKEOVER+JUNCTION:P35+ROUTE_END
#define NAV_MAP_TAKEOVER_COUNT_0 (60)
static const unsigned short nav_map_takeover_lo_0[60] =
{
    0, 204, 361, 512, 628, 769, 915, 1025, 1076, 1253, 1350, 1527, 1624, 1881, 2013, 2209,
    2448, 2855, 2895, 3052, 3172, 3212, 3300, 3387, 3474, 3581, 3818, 3868, 4025, 4075, 4462, 4559,
    4947, 5044, 5291, 5388, 5515, 5612, 6199, 6296, 6384, 6681, 6877, 6968, 7224, 7265, 7512, 7552,
    7909, 8029, 8069, 8166, 8253, 8351, 8438, 8594, 8669, 8855, 9011, 9212,
};
static const unsigned short nav_map_takeover_hi_0[60] =
{
    99, 281, 361, 588, 628, 845, 915, 1025, 1152, 1329, 1426, 1603, 1700, 1958, 2125, 2337,
    2524, 2855, 2971, 3052, 3172, 3289, 3376, 3463, 3550, 3657, 3818, 3944, 4025, 4151, 4538, 4636,
    5023, 5120, 5367, 5464, 5591, 5688, 6275, 6373, 6460, 6757, 6877, 7044, 7224, 7341, 7512, 7628,
    7909, 8029, 8145, 8242, 8330, 8427, 8514, 8594, 8749, 8931, 9011, 9375,
};

static const unsigned short nav_path_point_count[NAV_PATH_COUNT] =
{
    9376
};

static const signed short *const nav_path_data[NAV_PATH_COUNT] =
{
    nav_path_data_0
};

static const signed short *const nav_path_x[NAV_PATH_COUNT] =
{
    nav_path_x_0
};

static const signed short *const nav_path_y[NAV_PATH_COUNT] =
{
    nav_path_y_0
};

static const signed short *const nav_path_curvature[NAV_PATH_COUNT] =
{
    nav_path_curvature_0
};

static const signed short *const nav_path_curvature_derivative[NAV_PATH_COUNT] =
{
    nav_path_curvature_derivative_0
};

#define NAV_SCAN_FEATURE_TABLES (1)
#define NAV_SCAN_VERTEX_TYPE_STRAIGHT (0u)
#define NAV_SCAN_VERTEX_TYPE_CORNER (1u)
#define NAV_SCAN_VERTEX_TYPE_JUNCTION (2u)
#define NAV_SCAN_JUNCTION_SUPPORT_TABLES (1)
#define NAV_SCAN_SEGMENT_VALID_TABLES (1)
#define NAV_SCAN_CORNER_CALIBRATION_MASK_TABLES (1)
#define NAV_SCAN_SEGMENT_CALIBRATION_MASK_TABLES (1)
static const unsigned short nav_scan_vertex_count[NAV_PATH_COUNT] =
{
    NAV_SCAN_VERTEX_COUNT_0
};
static const signed short *const nav_scan_vertex_x[NAV_PATH_COUNT] =
{
    nav_scan_vertex_x_0
};
static const signed short *const nav_scan_vertex_y[NAV_PATH_COUNT] =
{
    nav_scan_vertex_y_0
};
static const unsigned short *const nav_scan_vertex_progress[NAV_PATH_COUNT] =
{
    nav_scan_vertex_progress_0
};
static const unsigned char *const nav_scan_vertex_type[NAV_PATH_COUNT] =
{
    nav_scan_vertex_type_0
};
static const unsigned char *const nav_scan_vertex_corner_calibration_allowed[NAV_PATH_COUNT] =
{
    nav_scan_vertex_corner_calibration_allowed_0
};
static const signed short *const nav_scan_vertex_support_x[NAV_PATH_COUNT] =
{
    nav_scan_vertex_support_x_0
};
static const signed short *const nav_scan_vertex_support_y[NAV_PATH_COUNT] =
{
    nav_scan_vertex_support_y_0
};
static const unsigned short nav_scan_segment_valid_count[NAV_PATH_COUNT] =
{
    ((NAV_SCAN_VERTEX_COUNT_0 > 0) ? (NAV_SCAN_VERTEX_COUNT_0 - 1) : 0)
};
static const unsigned char *const nav_scan_segment_valid[NAV_PATH_COUNT] =
{
    nav_scan_segment_valid_0
};
static const unsigned char *const nav_scan_segment_calibration_allowed[NAV_PATH_COUNT] =
{
    nav_scan_segment_calibration_allowed_0
};

#define NAV_MAP_TAKEOVER_TABLES (1)
#define NAV_MAP_TAKEOVER_ENTRY_LEAD_MM (150u)
static const unsigned char nav_map_takeover_count[NAV_PATH_COUNT] =
{
    NAV_MAP_TAKEOVER_COUNT_0
};
static const unsigned short *const nav_map_takeover_lo[NAV_PATH_COUNT] =
{
    nav_map_takeover_lo_0
};
static const unsigned short *const nav_map_takeover_hi[NAV_PATH_COUNT] =
{
    nav_map_takeover_hi_0
};

#define NAV_SPEED_TABLES (1)
static const unsigned short nav_speed_count[NAV_PATH_COUNT] =
{
    NAV_SPEED_COUNT_0
};
static const unsigned short *const nav_speed_end[NAV_PATH_COUNT] =
{
    nav_speed_end_0
};
static const signed short *const nav_speed_cmps[NAV_PATH_COUNT] =
{
    nav_speed_cmps_0
};
static const unsigned short nav_acceleration_count[NAV_PATH_COUNT] =
{
    NAV_ACCEL_COUNT_0
};
static const unsigned short *const nav_acceleration_end[NAV_PATH_COUNT] =
{
    nav_acceleration_end_0
};
static const signed short *const nav_acceleration_cmps2[NAV_PATH_COUNT] =
{
    nav_acceleration_cmps2_0
};

#endif /* NAV_PATH_H_ */
