xigua862/SMARTCAR2/开源工程/马铃薯-国赛光电管-5.5m/国赛光电管/smartcar/Crazy_Car/Seekfree_TC264_Opensource_Library/code/telemetry.c

/**
 * @file telemetry.c
 * @brief 单次运行日志采集、冻结、EMEM 管理和串口导出。
 * @author 高冷马铃薯
 *
 * @par 所属项目
 * 2026 智能车国赛（光电管）
 *
 * @par WegooAI 中转站
 * 本项目用户代码 99% 通过作者自建的 WegooAI 中转站，
 * 使用 Claude Code、Codex 等 AI 编程工具完成。
 * WegooAI 由作者高冷马铃薯搭建并维护，
 * 方便大家接入 AI 编程工具编写和修改代码，欢迎使用 :)
 * 官网：https://ai.wegoo.site/
 *
 * @par 联系作者
 * Bilibili：https://space.bilibili.com/513729639
 * QQ：1153626206
 * Email：moonserver@foxmail.com
 */

#include "telemetry.h"
#include "competition_config.h"

#include <string.h>

#include "control.h"
#include "flash.h"
#include "globals.h"
#include "gyroscope.h"
#include "navigation.h"
#include "phototube_scan.h"
#include "prestart.h"
#include "phototube_array.h"
#include "Emem/Std/IfxEmem.h"
#include "IfxCbs_reg.h"
#include "IfxScu_reg.h"
#include "IfxScuWdt.h"

#define TELEMETRY_CONTROL_QUEUE_CAPACITY (64u)
#define TELEMETRY_NAVIGATION_QUEUE_CAPACITY (16u)
#define TELEMETRY_VISION_QUEUE_CAPACITY (32u)
#define TELEMETRY_EVENT_QUEUE_CAPACITY (16u)
#define TELEMETRY_PHOTOTUBE_SCAN_QUEUE_CAPACITY (256u)
#define TELEMETRY_LOCALIZATION_QUEUE_CAPACITY (16u)
#define TELEMETRY_EVENT_QUEUE_CRITICAL_RESERVE (8u)
#define TELEMETRY_EVENT_STORAGE_CRITICAL_RESERVE (10u)
#define TELEMETRY_RUNTIME_LEDGER_EVENT_COUNT (12u)
#define TELEMETRY_DROP_SUMMARY_MAX_EVENT_COUNT (10u)
#define TELEMETRY_TERMINAL_EVENT_COUNT \
    (TELEMETRY_RUNTIME_LEDGER_EVENT_COUNT + 1u)
#define TELEMETRY_EVENT_STORAGE_FINAL_RESERVE \
    (TELEMETRY_DROP_SUMMARY_MAX_EVENT_COUNT + TELEMETRY_TERMINAL_EVENT_COUNT)
#define TELEMETRY_CONTROL_DRAIN_LIMIT (16u)
#define TELEMETRY_NAVIGATION_DRAIN_LIMIT (4u)
#define TELEMETRY_VISION_DRAIN_LIMIT (8u)
#define TELEMETRY_EVENT_DRAIN_LIMIT (4u)
#define TELEMETRY_IMU_DRAIN_LIMIT (16u)
#define TELEMETRY_PHOTOTUBE_SCAN_DRAIN_LIMIT (16u)
#define TELEMETRY_LOCALIZATION_DRAIN_LIMIT (4u)
#define TELEMETRY_SERVICE_PHASE_COUNT (7u)
#define TELEMETRY_SERVICE_SOFT_BUDGET_US (500u)
/* Export only runs while the vehicle is fully idle.  Literal blocks stay
 * small enough for bounded scanning; long cleared EMEM regions collapse into
 * two-byte zero-run headers on the wire. */
#define TELEMETRY_EXPORT_CHUNK_BYTES (256u)
#define TELEMETRY_EXPORT_ZERO_MIN_RUN (8u)
#define TELEMETRY_LINK_BEACON_INTERVAL_MS (500u)
#define TELEMETRY_IMU_PRODUCER_WAIT_LIMIT (10000u)
#define TELEMETRY_SELF_TEST_OFFSET (TELEMETRY_EMEM_SIZE - 32u)
/* CHID is bits [15:8] of the complete TC264DA CHIPID 0x05476852. */
#define TELEMETRY_EMEM_REQUIRED_CHIP_ID (0x68u)
#define TELEMETRY_EMEM_TILESTATE_MASK (0x0000FFFFu)

#if TELEMETRY_EMEM_SIZE > IFXEMEM_SIZE
#error "Telemetry image exceeds the EMEM size supplied by the iLLD"
#endif

#if (TELEMETRY_EMEM_SIZE % 32u) != 0u
#error "Telemetry EMEM image must contain complete 32-byte ECC lines"
#endif

#if (TELEMETRY_SELF_TEST_OFFSET % 32u) != 0u
#error "Telemetry self-test must start on a 32-byte ECC-line boundary"
#endif

#if (TELEMETRY_SELF_TEST_OFFSET + 32u) > TELEMETRY_EMEM_SIZE
#error "Telemetry self-test line exceeds the logical EMEM image"
#endif

#if (TELEMETRY_PHOTOTUBE_SCAN_OFFSET + TELEMETRY_PHOTOTUBE_SCAN_HEADER_SIZE + \
     TELEMETRY_PHOTOTUBE_SCAN_CAPACITY * TELEMETRY_PHOTOTUBE_SCAN_RECORD_SIZE) > \
    TELEMETRY_SELF_TEST_OFFSET
#error "Phototube archive overlaps the reserved EMEM self-test line"
#endif

#if TELEMETRY_EVENT_QUEUE_CRITICAL_RESERVE >= (TELEMETRY_EVENT_QUEUE_CAPACITY - 1u)
#error "Telemetry event queue reserve leaves no room for ordinary events"
#endif

#if TELEMETRY_EVENT_STORAGE_FINAL_RESERVE >= TELEMETRY_EVENT_CAPACITY
#error "Telemetry final event reserve exceeds event capacity"
#endif

#if TELEMETRY_EVENT_STORAGE_CRITICAL_RESERVE >= \
    (TELEMETRY_EVENT_CAPACITY - TELEMETRY_EVENT_STORAGE_FINAL_RESERVE)
#error "Telemetry active critical reserve exceeds event capacity"
#endif

#if TELEMETRY_IMU_DECIMATION == 0u
#error "Telemetry IMU decimation must be greater than zero"
#endif

#if ((TELEMETRY_PHOTOTUBE_SCAN_QUEUE_CAPACITY & \
      (TELEMETRY_PHOTOTUBE_SCAN_QUEUE_CAPACITY - 1u)) != 0u)
#error "Phototube telemetry queue capacity must be a power of two"
#endif

#if PHOTOTUBE_ARRAY_SCAN_HZ != TELEMETRY_VISION_SOURCE_SAMPLE_HZ
#error "Phototube acquisition and telemetry source rates must match"
#endif

#if TELEMETRY_EXPORT_CHUNK_BYTES > TELEMETRY_WIRE_BLOCK_MAX_LENGTH
#error "Telemetry export literal block exceeds the wire-format limit"
#endif

#if TELEMETRY_EXPORT_ZERO_MIN_RUN == 0u
#error "Telemetry export zero-run threshold must be greater than zero"
#endif

typedef union
{
    float value;
    uint32 word;
} TelemetryFloatWord;

/* CPU1-private compression/decimation state.  The cross-core SPSC mailbox
 * itself is declared centrally in globals.c/.h. */
#pragma section all "cpu1_dsram"

static uint32 imu_last_timestamp_4us;
static uint8 imu_have_timestamp;
static uint8 imu_log_decimation_countdown;
static uint32 imu_telemetry_local_epoch_seq;
static uint32 imu_telemetry_local_start_us;

#pragma section all restore
#pragma section all "cpu0_dsram"

static volatile TelemetryControlRecord control_queue[TELEMETRY_CONTROL_QUEUE_CAPACITY];
static volatile TelemetryNavigationRecord navigation_queue[TELEMETRY_NAVIGATION_QUEUE_CAPACITY];
static volatile TelemetryVisionRecord vision_queue[TELEMETRY_VISION_QUEUE_CAPACITY];
static volatile TelemetryEventRecord event_queue[TELEMETRY_EVENT_QUEUE_CAPACITY];
static TelemetryPhototubeScanRecord phototube_scan_queue[
    TELEMETRY_PHOTOTUBE_SCAN_QUEUE_CAPACITY];
static TelemetryLocalizationRecord localization_queue[
    TELEMETRY_LOCALIZATION_QUEUE_CAPACITY];
static TelemetryLocalizationFeatureRecord localization_feature_queue[
    TELEMETRY_LOCALIZATION_QUEUE_CAPACITY];

static volatile uint8 control_head;
static volatile uint8 control_tail;
static volatile uint8 navigation_head;
static volatile uint8 navigation_tail;
static volatile uint8 vision_head;
static volatile uint8 vision_tail;
static volatile uint8 event_head;
static volatile uint8 event_tail;
/* IMU records are produced by CPU1 and drained by CPU0.  Keep producer-side
 * drops separate from the CPU0-owned EMEM capacity counter so the two cores
 * never update the same session-header field concurrently. */
static uint16 phototube_scan_queue_head;
static uint16 phototube_scan_queue_tail;
static uint8 localization_queue_head;
static uint8 localization_queue_tail;
static uint8 localization_feature_queue_head;
static uint8 localization_feature_queue_tail;
static uint16 imu_storage_drop_count;

static volatile uint8 logger_enabled;
static volatile uint8 logger_accepting;
static volatile uint8 logger_finalized;
static volatile uint8 export_requested;
static volatile TelemetryState logger_state = TELEMETRY_STATE_DISABLED;
static uint16 position_saturation_count;
static volatile uint32 session_sequence;
static uint8 vision_log_decimation_countdown;
static uint8 vision_have_first_frame_seq;
static uint8 telemetry_service_phase;
static TelemetrySessionHeader session_header;
static TelemetryLocalizationConfigBlock localization_config_block;
static TelemetryTrackingConfigBlock tracking_config_block;
static TelemetryLocalizationFeatureHeader localization_feature_header;
static TelemetryWirePrefix wire_prefix;
static uint32 firmware_image_hash;
static uint32 export_prefix_offset;
static uint32 export_payload_offset;
static uint32 export_session_sequence;
static uint32 telemetry_link_last_ms;
static uint16 phototube_scan_archive_count;
static uint16 phototube_scan_archive_write_index;
static uint32 phototube_scan_archive_first_frame_seq;
static uint16 phototube_scan_archive_overwrite_count;
static uint16 phototube_scan_queue_drop_count;
static uint16 localization_queue_drop_count;
static uint8 phototube_scan_archive_have_first_frame;
static uint8 phototube_scan_header_finalized;
static const uint8 invalid_magic[4] = {0u, 0u, 0u, 0u};

static volatile uint8 *const telemetry_emem = (volatile uint8 *)IFXEMEM_START_ADDR_CPU;

static uint8 telemetry_next_index(uint8 index, uint8 capacity)
{
    index++;
    return (index >= capacity) ? 0u : index;
}

static void telemetry_increment_drop(volatile uint16_t *counter)
{
    if (*counter < 0xFFFFu)
    {
        (*counter)++;
    }
}

static void telemetry_emem_write(uint32 offset, const void *source, uint32 size)
{
    const uint8 *bytes = (const uint8 *)source;
    uint32 index;

    if ((offset > TELEMETRY_EMEM_SIZE) || (size > (TELEMETRY_EMEM_SIZE - offset)))
    {
        return;
    }
    for (index = 0u; index < size; index++)
    {
        telemetry_emem[offset + index] = bytes[index];
    }
    __dsync();
}

static void telemetry_emem_read(uint32 offset, void *destination, uint32 size)
{
    uint8 *bytes = (uint8 *)destination;
    uint32 index;

    if ((NULL == destination) || (offset > TELEMETRY_EMEM_SIZE) ||
        (size > (TELEMETRY_EMEM_SIZE - offset)))
    {
        return;
    }
    __dsync();
    for (index = 0u; index < size; index++)
    {
        bytes[index] = telemetry_emem[offset + index];
    }
}

static void telemetry_emem_clear(void)
{
    uint32 offset;

    /*
     * EMEM ECC is line based.  A byte/word write to a virgin line can perform
     * an internal read-modify-write and raise an ECC trap.  Start every
     * 32-byte line on its alignment boundary and issue four consecutive
     * 64-bit stores, covering both ECC halves without a preceding read.
     */
    for (offset = 0u; offset < TELEMETRY_EMEM_SIZE; offset += 32u)
    {
        volatile uint64 *line_words =
            (volatile uint64 *)(IFXEMEM_START_ADDR_CPU + offset);
        line_words[0] = 0u;
        line_words[1] = 0u;
        line_words[2] = 0u;
        line_words[3] = 0u;
    }
    __dsync();
}

static uint8 telemetry_emem_self_test(void)
{
    static const uint32 patterns[8] = {
        0x55AA33CCu,
        0xA55AC33Cu,
        0x01234567u,
        0x89ABCDEFu,
        0x13579BDFu,
        0x2468ACE0u,
        0x0F0FF0F0u,
        0xF0F00F0Fu};
    volatile uint32 *test_words =
        (volatile uint32 *)(IFXEMEM_START_ADDR_CPU + TELEMETRY_SELF_TEST_OFFSET);
    uint8 passed = 1u;
    uint8 index;

    for (index = 0u; index < 8u; index++)
    {
        test_words[index] = patterns[index];
    }
    __dsync();
    for (index = 0u; index < 8u; index++)
    {
        if (test_words[index] != patterns[index])
        {
            passed = 0u;
        }
        test_words[index] = 0u;
    }
    __dsync();
    return passed;
}

static void telemetry_reset_queues(void)
{
    control_head = 0u;
    control_tail = 0u;
    navigation_head = 0u;
    navigation_tail = 0u;
    vision_head = 0u;
    vision_tail = 0u;
    event_head = 0u;
    event_tail = 0u;
    imu_telemetry_head = 0u;
    imu_telemetry_tail = 0u;
    phototube_scan_queue_head = 0u;
    phototube_scan_queue_tail = 0u;
    localization_queue_head = 0u;
    localization_queue_tail = 0u;
    localization_feature_queue_head = 0u;
    localization_feature_queue_tail = 0u;
    imu_storage_drop_count = 0u;
}

static uint8 telemetry_wait_imu_producer_idle(void)
{
    uint32 wait_count = 0u;

    /* Freeze/begin-run is called from CPU0 context.  The CPU1 IMU ISR is
     * bounded and clears this flag on every exit.  Keep a guard anyway: a
     * broken peripheral must never make the CPU0 menu spin forever. */
    while (imu_telemetry_producer_active &&
           (wait_count++ < TELEMETRY_IMU_PRODUCER_WAIT_LIMIT))
    {
        __dsync();
    }
    return (uint8)(0u == imu_telemetry_producer_active);
}

static void telemetry_merge_imu_producer_drops(void)
{
    uint16 producer_drops;
    uint32 total_drops;

    __dsync();
    producer_drops =
        (imu_telemetry_producer_epoch_seq == imu_telemetry_epoch_seq) ?
            imu_telemetry_producer_drop_count : 0u;
    total_drops = (uint32)producer_drops + (uint32)imu_storage_drop_count;
    session_header.imu_drop_count = (uint16)((total_drops > 0xFFFFu) ?
                                             0xFFFFu : total_drops);
}

static void telemetry_store_float_word(uint8 index, float value)
{
    TelemetryFloatWord converted;

    converted.value = value;
    session_header.parameter_words[index] = converted.word;
}

static void telemetry_snapshot_parameters(void)
{
    /* Keep the fixed schema-21 parameter layout for host compatibility, but
     * publish zeroes for the retired motor-feedforward/anti-reversal slots.
     * The active firmware path is the pure incremental PI from the pre-race
     * finish version. */
    telemetry_store_float_word(0u, 0.0f);
    telemetry_store_float_word(1u, 0.0f);
    telemetry_store_float_word(2u, 0.0f);
    telemetry_store_float_word(3u, 0.0f);
    telemetry_store_float_word(4u, 0.0f);
    telemetry_store_float_word(5u, 0.0f);
    telemetry_store_float_word(6u, 0.0f);
    telemetry_store_float_word(7u, 0.0f);
    telemetry_store_float_word(8u, 0.0f);
    session_header.parameter_words[9] = 0u;
    telemetry_store_float_word(10u, g_flash_parameters.speed_KP);
    telemetry_store_float_word(11u, g_flash_parameters.speed_KI);
    telemetry_store_float_word(12u, 0.0f);
    telemetry_store_float_word(13u, g_flash_parameters.speed_IncrementLimit);
    telemetry_store_float_word(14u, 0.0f);
    telemetry_store_float_word(15u, nav_get_speed_profile_max_accel_cmps2());
    telemetry_store_float_word(16u, nav_get_speed_profile_max_decel_cmps2());
    telemetry_store_float_word(17u, nav_get_speed_profile_safety_margin_mm());
    telemetry_store_float_word(18u, 0.0f);
    telemetry_store_float_word(19u, 0.0f);
}

static uint32 telemetry_fnv1a_update(uint32 hash, const void *data, uint32 size)
{
    const uint8 *bytes = (const uint8 *)data;
    uint32 index;

    for (index = 0u; index < size; index++)
    {
        hash ^= bytes[index];
        hash *= 16777619u;
    }
    return hash;
}

static uint32 telemetry_calculate_firmware_config_fingerprint(
    const TelemetryLocalizationConfigBlock *localization_block,
    const TelemetryTrackingConfigBlock *tracking_block)
{
    const uint32 layout_constants[] = {
        TELEMETRY_SCHEMA_VERSION,
        TELEMETRY_PROTOCOL_VERSION,
        TELEMETRY_EMEM_SIZE,
        TELEMETRY_HEADER_REGION_SIZE,
        TELEMETRY_HEADER_CRC_OFFSET,
        TELEMETRY_LOCALIZATION_CONFIG_OFFSET,
        TELEMETRY_LOCALIZATION_CONFIG_SIZE,
        TELEMETRY_LOCALIZATION_CONFIG_VERSION,
        TELEMETRY_LOCALIZATION_FEATURE_OFFSET,
        TELEMETRY_LOCALIZATION_FEATURE_HEADER_SIZE,
        TELEMETRY_LOCALIZATION_FEATURE_RECORD_SIZE,
        TELEMETRY_LOCALIZATION_FEATURE_CAPACITY,
        TELEMETRY_LOCALIZATION_FEATURE_VERSION,
        TELEMETRY_TRACKING_CONFIG_OFFSET,
        TELEMETRY_TRACKING_CONFIG_SIZE,
        TELEMETRY_TRACKING_CONFIG_VERSION,
        TELEMETRY_CONTROL_OFFSET,
        TELEMETRY_CONTROL_REGION_SIZE,
        TELEMETRY_NAVIGATION_OFFSET,
        TELEMETRY_NAVIGATION_REGION_SIZE,
        TELEMETRY_VISION_OFFSET,
        TELEMETRY_VISION_REGION_SIZE,
        TELEMETRY_EVENT_OFFSET,
        TELEMETRY_EVENT_REGION_SIZE,
        TELEMETRY_LOCALIZATION_OFFSET,
        TELEMETRY_LOCALIZATION_RECORD_SIZE,
        TELEMETRY_LOCALIZATION_CAPACITY,
        TELEMETRY_RESERVED_OFFSET,
        TELEMETRY_RESERVED_REGION_SIZE,
        TELEMETRY_SESSION_HEADER_SIZE,
        TELEMETRY_PARAMETER_WORD_COUNT,
        TELEMETRY_CONTROL_CAPACITY,
        TELEMETRY_NAVIGATION_CAPACITY,
        TELEMETRY_VISION_CAPACITY,
        TELEMETRY_EVENT_CAPACITY,
        sizeof(TelemetryControlRecord),
        sizeof(TelemetryNavigationRecord),
        sizeof(TelemetryVisionRecord),
        sizeof(TelemetryEventRecord),
        sizeof(TelemetryLocalizationRecord),
        sizeof(TelemetryLocalizationFeatureHeader),
        sizeof(TelemetryLocalizationFeatureRecord),
        sizeof(TelemetryTrackingConfigBlock),
        sizeof(TelemetryImuRecord),
        TELEMETRY_IMU_OFFSET,
        TELEMETRY_IMU_REGION_SIZE,
        TELEMETRY_IMU_CAPACITY,
        TELEMETRY_IMU_SOURCE_SAMPLE_HZ,
        TELEMETRY_IMU_SAMPLE_HZ,
        TELEMETRY_IMU_DECIMATION,
        TELEMETRY_CONTROL_LOG_DIVIDER,
        TELEMETRY_CONTROL_LOG_RATE_HZ,
        TELEMETRY_VISION_SOURCE_SAMPLE_HZ,
        TELEMETRY_VISION_LOG_DIVIDER,
        TELEMETRY_VISION_LOG_RATE_HZ,
        TELEMETRY_PHOTOTUBE_SCAN_OFFSET,
        TELEMETRY_PHOTOTUBE_SCAN_REGION_SIZE,
        TELEMETRY_PHOTOTUBE_SCAN_HEADER_SIZE,
        TELEMETRY_PHOTOTUBE_SCAN_RECORD_SIZE,
        TELEMETRY_PHOTOTUBE_SCAN_CAPACITY,
        sizeof(TelemetryPhototubeScanHeader),
        sizeof(TelemetryPhototubeScanRecord)};
    uint32 hash = 2166136261u;

    hash = telemetry_fnv1a_update(hash, &firmware_image_hash,
                                   sizeof(firmware_image_hash));
    hash = telemetry_fnv1a_update(hash, layout_constants, sizeof(layout_constants));
    hash = telemetry_fnv1a_update(hash, &session_header.route_hash,
                                   sizeof(session_header.route_hash));
    hash = telemetry_fnv1a_update(hash, &session_header.route_point_count,
                                   sizeof(session_header.route_point_count));
    hash = telemetry_fnv1a_update(hash, &session_header.wheel_diameter_mm,
                                   sizeof(session_header.wheel_diameter_mm));
    hash = telemetry_fnv1a_update(hash, &session_header.gear_ratio,
                                   sizeof(session_header.gear_ratio));
    hash = telemetry_fnv1a_update(hash, &session_header.distance_per_pulse_mm,
                                   sizeof(session_header.distance_per_pulse_mm));
    hash = telemetry_fnv1a_update(hash, &session_header.cmps_per_count,
                                   sizeof(session_header.cmps_per_count));
    hash = telemetry_fnv1a_update(hash, &session_header.pid_sample_s,
                                   sizeof(session_header.pid_sample_s));
    hash = telemetry_fnv1a_update(hash, &session_header.nav_sample_mm,
                                   sizeof(session_header.nav_sample_mm));
    hash = telemetry_fnv1a_update(hash, &session_header.nav_min_lookahead_mm,
                                   sizeof(session_header.nav_min_lookahead_mm));
    hash = telemetry_fnv1a_update(hash, &session_header.encoder_ppr,
                                   sizeof(session_header.encoder_ppr));
    hash = telemetry_fnv1a_update(hash, &session_header.imu_flags,
                                   sizeof(session_header.imu_flags));
    hash = telemetry_fnv1a_update(hash, &session_header.imu_rate_hz,
                                   sizeof(session_header.imu_rate_hz));
    hash = telemetry_fnv1a_update(
        hash, &session_header.control_config.preview_time_s,
        sizeof(session_header.control_config.preview_time_s));
    hash = telemetry_fnv1a_update(
        hash, &session_header.control_config.min_lookahead_mm,
        sizeof(session_header.control_config.min_lookahead_mm));
    hash = telemetry_fnv1a_update(
        hash, &session_header.control_config.max_lookahead_mm,
        sizeof(session_header.control_config.max_lookahead_mm));
    hash = telemetry_fnv1a_update(
        hash, &session_header.control_config.kd_cmps_per_degps_per_speed_scale,
        sizeof(session_header.control_config.kd_cmps_per_degps_per_speed_scale));
    hash = telemetry_fnv1a_update(hash, session_header.parameter_words,
                                   sizeof(session_header.parameter_words));
    hash = telemetry_fnv1a_update(hash, &localization_block->config_hash,
                                   sizeof(localization_block->config_hash));
    hash = telemetry_fnv1a_update(hash, &localization_block->algorithm_version,
                                   sizeof(localization_block->algorithm_version));
    hash = telemetry_fnv1a_update(hash, &tracking_block->config_hash,
                                   sizeof(tracking_block->config_hash));
    hash = telemetry_fnv1a_update(hash, &tracking_block->algorithm_version,
                                   sizeof(tracking_block->algorithm_version));
    return hash;
}

static void telemetry_fill_header_layout(void)
{
    session_header.magic[0] = TELEMETRY_SESSION_MAGIC_0;
    session_header.magic[1] = TELEMETRY_SESSION_MAGIC_1;
    session_header.magic[2] = TELEMETRY_SESSION_MAGIC_2;
    session_header.magic[3] = TELEMETRY_SESSION_MAGIC_3;
    session_header.schema_version = TELEMETRY_SCHEMA_VERSION;
    session_header.header_size = TELEMETRY_SESSION_HEADER_SIZE;
    session_header.init_status = 1u;
    session_header.control_offset = TELEMETRY_CONTROL_OFFSET;
    session_header.navigation_offset = TELEMETRY_NAVIGATION_OFFSET;
    session_header.vision_offset = TELEMETRY_VISION_OFFSET;
    session_header.event_offset = TELEMETRY_EVENT_OFFSET;
    session_header.control_record_size = sizeof(TelemetryControlRecord);
    session_header.navigation_record_size = sizeof(TelemetryNavigationRecord);
    session_header.vision_record_size = sizeof(TelemetryVisionRecord);
    session_header.event_record_size = sizeof(TelemetryEventRecord);
    session_header.control_capacity = TELEMETRY_CONTROL_CAPACITY;
    session_header.navigation_capacity = TELEMETRY_NAVIGATION_CAPACITY;
    session_header.vision_capacity = TELEMETRY_VISION_CAPACITY;
    session_header.event_capacity = TELEMETRY_EVENT_CAPACITY;
    session_header.localization_offset = TELEMETRY_LOCALIZATION_OFFSET;
    session_header.localization_record_size = sizeof(TelemetryLocalizationRecord);
    session_header.localization_capacity = TELEMETRY_LOCALIZATION_CAPACITY;
    session_header.imu_offset = TELEMETRY_IMU_OFFSET;
    session_header.imu_record_size = sizeof(TelemetryImuRecord);
    session_header.imu_capacity = TELEMETRY_IMU_CAPACITY;
    session_header.imu_sample_rate_hz = TELEMETRY_IMU_SAMPLE_HZ;
    session_header.imu_decimation = TELEMETRY_IMU_DECIMATION;
    session_header.control_log_divider = TELEMETRY_CONTROL_LOG_DIVIDER;
    session_header.control_log_rate_hz = TELEMETRY_CONTROL_LOG_RATE_HZ;
    session_header.control_config.preview_time_s = NAV_PP_PREVIEW_TIME_S;
    session_header.control_config.min_lookahead_mm =
        NAV_PP_MIN_LOOKAHEAD_MM;
    session_header.control_config.max_lookahead_mm =
        NAV_PP_MAX_LOOKAHEAD_MM;
    /* v17 reuses the fixed header layout: legacy KD is unused. */
    session_header.control_config.kd_cmps_per_degps_per_speed_scale = 0.0f;
    session_header.wheel_diameter_mm = WHEEL_DIAMETER_MM;
    session_header.gear_ratio = GEAR_RATIO;
    session_header.distance_per_pulse_mm = DIST_PER_PULSE_MM;
    session_header.cmps_per_count = CMPS_PER_COUNT;
    session_header.pid_sample_s = PID_SAMPLE_S;
    session_header.nav_sample_mm = nav_get_path_sample_mm();
    session_header.nav_min_lookahead_mm = NAV_PP_MIN_LOOKAHEAD_MM;
    session_header.encoder_ppr = ENCODER_PPR;
    session_header.imu_flags =
        (uint16_t)(gyro_zero_calibration_done() ? 1u : 0u) |
        (uint16_t)(gyro_zero_calibration_running() ? 2u : 0u);
    session_header.imu_rate_hz = (float)TELEMETRY_IMU_SOURCE_SAMPLE_HZ;
}

static void telemetry_snapshot_localization_config(void)
{
    NavLocalizationConfigSnapshot config;

    nav_get_localization_config_snapshot(&config);
    localization_config_block.magic[0] =
        TELEMETRY_LOCALIZATION_CONFIG_MAGIC_0;
    localization_config_block.magic[1] =
        TELEMETRY_LOCALIZATION_CONFIG_MAGIC_1;
    localization_config_block.magic[2] =
        TELEMETRY_LOCALIZATION_CONFIG_MAGIC_2;
    localization_config_block.magic[3] =
        TELEMETRY_LOCALIZATION_CONFIG_MAGIC_3;
    localization_config_block.version =
        TELEMETRY_LOCALIZATION_CONFIG_VERSION;
    localization_config_block.size = TELEMETRY_LOCALIZATION_CONFIG_SIZE;
    localization_config_block.config_hash = nav_get_localization_config_hash();
    localization_config_block.algorithm_version = config.algorithm_version;
    localization_config_block.sensor_count = config.sensor_count;
    localization_config_block.adc_group = config.adc_group;
    localization_config_block.adc_channel = config.adc_channel;
    localization_config_block.mux_selector_count = config.mux_selector_count;
    localization_config_block.scan_hz = config.scan_hz;
    localization_config_block.sensor_spacing_mm = config.sensor_spacing_mm;
    localization_config_block.sensor_forward_mm = config.sensor_forward_mm;
    localization_config_block.scan_min_step_mm = config.scan_min_step_mm;
    localization_config_block.match_travel_window_mm =
        config.match_travel_window_mm;
    localization_config_block.feature_radius_mm = config.feature_radius_mm;
    localization_config_block.max_feature_point_residual_mm =
        config.max_feature_point_residual_mm;
    localization_config_block.max_rms_mm = config.max_rms_mm;
    localization_config_block.max_correction_mm = config.max_correction_mm;
    localization_config_block.max_correction_yaw_deg =
        config.max_correction_yaw_deg;
    localization_config_block.black_scan_stop_distance_mm =
        config.black_stop_distance_mm;
}

static void telemetry_snapshot_tracking_config(void)
{
    uint32 hash;

    memset(&tracking_config_block, 0, sizeof(tracking_config_block));
    tracking_config_block.magic[0] = TELEMETRY_TRACKING_CONFIG_MAGIC_0;
    tracking_config_block.magic[1] = TELEMETRY_TRACKING_CONFIG_MAGIC_1;
    tracking_config_block.magic[2] = TELEMETRY_TRACKING_CONFIG_MAGIC_2;
    tracking_config_block.magic[3] = TELEMETRY_TRACKING_CONFIG_MAGIC_3;
    tracking_config_block.version = TELEMETRY_TRACKING_CONFIG_VERSION;
    tracking_config_block.size = TELEMETRY_TRACKING_CONFIG_SIZE;
    tracking_config_block.algorithm_version =
        NAV_TRACKING_REFERENCE_ALGORITHM_VERSION;
    tracking_config_block.wheel_track_mm = DRIVE_WHEEL_TRACK_MM;
    tracking_config_block.preview_time_s = NAV_PP_PREVIEW_TIME_S;
    tracking_config_block.min_lookahead_mm = NAV_PP_MIN_LOOKAHEAD_MM;
    tracking_config_block.max_lookahead_mm = NAV_PP_MAX_LOOKAHEAD_MM;
    /* TRK1 v2 layout is fixed.  In v17 the legacy KD slot is zero, the
     * former GKD field carries K_omega, and target_rate_window_ms carries
     * the delayed curvature-feedforward preview time. */
    tracking_config_block.kd_cmps_per_degps_per_speed_scale = 0.0f;
    tracking_config_block.gkd_cmps_per_radps =
        NAV_TRACK_YAW_RATE_FB_CMPS_PER_RADPS;
    tracking_config_block.turn_limit_ratio = NAV_TURN_LIMIT_RATIO;
    tracking_config_block.path_sample_mm_x100 =
        (uint16)(nav_get_path_sample_mm() * 100.0f + 0.5f);
    tracking_config_block.target_rate_window_ms =
        (NAV_TRACKING_REFERENCE_ALGORITHM_VERSION >= 17u) ?
        (uint16)(NAV_TRACK_CURVATURE_PREVIEW_TIME_S * 1000.0f + 0.5f) : 0u;

    hash = 2166136261u;
    hash = telemetry_fnv1a_update(
        hash, &tracking_config_block.algorithm_version,
        (uint32)sizeof(tracking_config_block) -
            (uint32)offsetof(TelemetryTrackingConfigBlock, algorithm_version));
    tracking_config_block.config_hash = hash;
}

static void telemetry_initialize_localization_features(void)
{
    TelemetryLocalizationFeatureRecord record;
    uint16 occurrence;
    uint16 feature_count = nav_get_scan_feature_count();

    memset(&localization_feature_header, 0,
           sizeof(localization_feature_header));
    localization_feature_header.magic[0] =
        TELEMETRY_LOCALIZATION_FEATURE_MAGIC_0;
    localization_feature_header.magic[1] =
        TELEMETRY_LOCALIZATION_FEATURE_MAGIC_1;
    localization_feature_header.magic[2] =
        TELEMETRY_LOCALIZATION_FEATURE_MAGIC_2;
    localization_feature_header.magic[3] =
        TELEMETRY_LOCALIZATION_FEATURE_MAGIC_3;
    localization_feature_header.version =
        TELEMETRY_LOCALIZATION_FEATURE_VERSION;
    localization_feature_header.header_size =
        TELEMETRY_LOCALIZATION_FEATURE_HEADER_SIZE;
    localization_feature_header.record_size =
        TELEMETRY_LOCALIZATION_FEATURE_RECORD_SIZE;
    localization_feature_header.capacity =
        TELEMETRY_LOCALIZATION_FEATURE_CAPACITY;

    memset(&record, 0, sizeof(record));
    for (occurrence = 0u;
         occurrence < TELEMETRY_LOCALIZATION_FEATURE_CAPACITY;
         occurrence++)
    {
        telemetry_emem_write(
            TELEMETRY_LOCALIZATION_FEATURE_OFFSET +
                TELEMETRY_LOCALIZATION_FEATURE_HEADER_SIZE +
                (uint32)occurrence * sizeof(record),
            &record, sizeof(record));
    }

    if (feature_count > TELEMETRY_LOCALIZATION_FEATURE_CAPACITY)
    {
        feature_count = TELEMETRY_LOCALIZATION_FEATURE_CAPACITY;
    }
    for (occurrence = 0u; occurrence < feature_count; occurrence++)
    {
        uint8 feature_type;
        uint16 feature_progress_points;

        if (!nav_get_scan_feature_info(occurrence, &feature_type,
                                       &feature_progress_points) ||
            (0u == feature_type))
        {
            continue;
        }
        memset(&record, 0, sizeof(record));
        record.route_feature_occurrence = (uint8)occurrence;
        record.status_flags = TELEMETRY_LOCALIZATION_FEATURE_REGISTERED;
        (void)feature_progress_points;
        telemetry_emem_write(
            TELEMETRY_LOCALIZATION_FEATURE_OFFSET +
                TELEMETRY_LOCALIZATION_FEATURE_HEADER_SIZE +
                (uint32)occurrence * sizeof(record),
            &record, sizeof(record));
        localization_feature_header.registered_count++;
    }
    telemetry_emem_write(TELEMETRY_LOCALIZATION_FEATURE_OFFSET,
                         &localization_feature_header,
                         sizeof(localization_feature_header));
}

static uint8 telemetry_event_queue_count(uint8 head, uint8 tail)
{
    if (head >= tail)
    {
        return (uint8)(head - tail);
    }
    return (uint8)(TELEMETRY_EVENT_QUEUE_CAPACITY - tail + head);
}

static uint8 telemetry_event_is_critical(uint8 type)
{
    return (uint8)((TELEMETRY_EVENT_RUN_START == type) ||
                   (TELEMETRY_EVENT_RUN_STOP == type) ||
                   (TELEMETRY_EVENT_PRESTART_STATE == type) ||
                   (TELEMETRY_EVENT_PROTECTION == type) ||
                   (TELEMETRY_EVENT_RUNTIME_BUDGET == type));
}

static void telemetry_push_event(uint8 type, uint8 source, uint16 code, int32 value0, int32 value1)
{
    uint8 head;
    uint8 next;
    uint8 queued;
    uint32 interrupt_state;
    TelemetryEventRecord record;

    if (!logger_enabled)
    {
        return;
    }
    interrupt_state = interrupt_global_disable();
    head = event_head;
    next = telemetry_next_index(head, TELEMETRY_EVENT_QUEUE_CAPACITY);
    queued = telemetry_event_queue_count(head, event_tail);
    if ((next == event_tail) ||
        ((!telemetry_event_is_critical(type)) &&
         (queued >= (TELEMETRY_EVENT_QUEUE_CAPACITY - 1u -
                     TELEMETRY_EVENT_QUEUE_CRITICAL_RESERVE))))
    {
        telemetry_increment_drop(&session_header.event_drop_count);
        interrupt_global_enable(interrupt_state);
        return;
    }
    record.timestamp_ms = vision_clock_ms - session_header.start_ms;
    record.type = type;
    record.source = source;
    record.code = code;
    record.value0 = value0;
    record.value1 = value1;
    event_queue[head] = record;
    __dsync();
    event_head = next;
    interrupt_global_enable(interrupt_state);
}

static uint8 telemetry_queues_empty(void)
{
    return (uint8)((control_head == control_tail) &&
                   (navigation_head == navigation_tail) &&
                   (vision_head == vision_tail) &&
                   (event_head == event_tail) &&
                   (imu_telemetry_head == imu_telemetry_tail) &&
                   (phototube_scan_queue_head ==
                    phototube_scan_queue_tail) &&
                   (localization_queue_head == localization_queue_tail) &&
                   (localization_feature_queue_head ==
                    localization_feature_queue_tail) &&
                   (0u == imu_telemetry_producer_active));
}

static void telemetry_append_event_direct(uint8 type, uint8 source, uint16 code, int32 value0, int32 value1)
{
    TelemetryEventRecord record;

    if (session_header.event_count >= TELEMETRY_EVENT_CAPACITY)
    {
        telemetry_increment_drop(&session_header.event_drop_count);
        return;
    }
    record.timestamp_ms = session_header.end_ms - session_header.start_ms;
    record.type = type;
    record.source = source;
    record.code = code;
    record.value0 = value0;
    record.value1 = value1;
    telemetry_emem_write(
        TELEMETRY_EVENT_OFFSET +
            (uint32)session_header.event_count * sizeof(TelemetryEventRecord),
        &record,
        sizeof(record));
    session_header.event_count++;
}
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
