xigua862/SMARTCAR2/开源工程/马铃薯-国赛光电管-5.5m/国赛光电管/smartcar/Crazy_Car/Seekfree_TC264_Opensource_Library/code/telemetry_format.h

/**
 * @file telemetry_format.h
 * @brief EMEM 遥测记录的字节序、校验和格式编码。
 * @author 高冷马铃薯
 *
 * @par 所属项目
 * 2026 智能车国赛（光电管）
 *
 * @par WegooAI 中转站
 * 本项目用户代码 99% 通过作者自建的 WegooAI 中转站，
 * 使用 Claude Code、Codex 等 AI 编程工具完成。
 * WegooAI 由作者高冷马铃薯搭建并维护，
 * 方便大家接入 AI 编程工具编写和修改代码，欢迎使用 :)
 * 官网：https://ai.wegoo.site/
 *
 * @par 联系作者
 * Bilibili：https://space.bilibili.com/513729639
 * QQ：1153626206
 * Email：moonserver@foxmail.com
 */

#ifndef CODE_TELEMETRY_FORMAT_H_
#define CODE_TELEMETRY_FORMAT_H_

#include <stddef.h>
#include <stdint.h>

#ifdef __cplusplus
extern "C"
{
#endif

#define TELEMETRY_SCHEMA_VERSION (21u)
#define TELEMETRY_PROTOCOL_VERSION (2u)

/*
 * This is the exported logical image size, not a claim about the physical
 * EMEM capacity of every TC26x derivative.  The image is used only after
 * telemetry_init() has positively identified an EMEM-capable device.
 */
#define TELEMETRY_EMEM_SIZE (0x50000u)
#define TELEMETRY_HEADER_OFFSET (0x00000u)
#define TELEMETRY_HEADER_REGION_SIZE (0x01000u)
#define TELEMETRY_CONTROL_OFFSET (0x01000u)
#define TELEMETRY_CONTROL_REGION_SIZE (0x11B40u)
#define TELEMETRY_NAVIGATION_OFFSET (0x12B40u)
#define TELEMETRY_NAVIGATION_REGION_SIZE (0x073E0u)
#define TELEMETRY_VISION_OFFSET (0x19F20u)
#define TELEMETRY_VISION_REGION_SIZE (0x080C0u)
#define TELEMETRY_EVENT_OFFSET (0x21FE0u)
#define TELEMETRY_EVENT_REGION_SIZE (0x01000u)
#define TELEMETRY_EVENT_CAPACITY (256u)
#define TELEMETRY_IMU_OFFSET (0x22FE0u)
#define TELEMETRY_IMU_REGION_SIZE (0x13560u)
#define TELEMETRY_RESERVED_OFFSET (0x36540u)
#define TELEMETRY_RESERVED_REGION_SIZE (0x19AC0u)

/* The tail is split into a compact localization ledger followed by the raw
 * odom phototube scan.  The two blocks share the old reserved tail without
 * changing the control/navigation/vision/IMU offsets. */
#define TELEMETRY_LOCALIZATION_OFFSET (TELEMETRY_RESERVED_OFFSET)
#define TELEMETRY_LOCALIZATION_CAPACITY (512u)
#define TELEMETRY_LOCALIZATION_RECORD_SIZE (44u)
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
