xigua862/SMARTCAR2/(commit log)

2026-10-02 B车初始快照
2026-10-02 chore: 忽略 IDE 目录 .qoder-cn
2026-10-02 D1-D2: 飞檐走壁开源整车情报 + 改红外改板清单 + epro2探测脚本 + BOM
2026-10-02 整理目录结构 + 源码调查(Retirement_Dance) + 电源需求 + xlsx探测脚本
2026-10-02 重构: 目录整理(文档/硬件工程/开源工程/固件/脚本/压缩包) + 源码调查与电源需求 + 交接文档更新 + 禁用内层嵌套git
2026-10-02 赛道确认黑底白线: 新增赛道情报文档 + 赛道图入库 + 纠正圆环状态机不可删 + 红外规格/电机测量法
2026-10-02 风机实测5Ω=有刷: 删无感换向链改接DRV8701第3半桥 + 不要求重量撤销减重 + 新增下单清单
2026-10-02 编码器已确认有 + 红外自己画/打印自己管: 新增成本估算(总1800~2060, 单车420~500)
2026-10-02 B车搁置(成本过高1800~2060元): 交接文档标状态 + 可复用情报移交 test17/文档/B车搁置-可复用情报-20261002.md
2026-10-02 B车复活v1: 框架定稿+引脚图+购物车(打印免费/学长件白嫖, 总账370) + 旧下单清单与旧接线表加作废指引
2026-10-02 框架v1.1: 底板改自设计(附尺寸约束+球脚判据) / 编码器确认装轮轴(减速比彻底不需要, 更正563kHz溢出警告) / IMU=逐飞IMU660R(新增必须确认能切SPI) / 负压扇叶支架已有只需底板开孔
2026-10-02 框架v1.2: 上网核实逐飞IMU660RC(官方资料+TC264库) -> 撤销'默认UART需切SPI'误判, 定SPI2@9MHz, 新增SDO=SA0复用脚严禁接地坑, IMU座留8P含INT1(DRDY)
2026-10-02 v1.3: 逻辑轨 4.7V->5V, 灰度子板改 5V/3.3V 双轨(排针10P->11P), 3.3V 预算重算; 修正 LM393 双路=4片、IMU 座 8P
2026-10-02 v1.4: 新增框架定稿 2.4 灰度子板单路定稿(双轨+元件值+迟滞+防插错排针序); 极性更正为白=1/黑=0; 补修 v1.1 漏改的编码器563kHz旧结论
2026-10-02 docs(B-che): v1.5 ITR9909 confirmed + datasheet-driven fixes (R1 180R/0805, height 6mm, 5V budget 160mA, oversampling >=50us, 8ch width conflict flagged)
2026-10-02 docs(B-che): v1.6 drop dual rail - subboard single 3.3V (collector pullup split 20k+20k to clamp node at 1.65V, R1 82R/0805, header 11P->10P, logic rail back to existing 4.7V)
2026-10-02 docs(B-che): v1.7 revert to dual rail 5V+3.3V per final schematic (R1 180R/0805, 4x LM393 with 100nF decoupling, header 10P->11P, 5V module >=400mA mandatory; new 2.5 sensor geometry waist-tapered po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
2026-10-02 docs(B-che): handover package 2 - progress snapshot for next person (measured dims 110 tread / 88x66 baseplate, retract board-width conclusions, IR tracking switches to off-the-shelf module, arc diff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
2026-10-03 docs(B-che): v1.8 finalize - merge all 10-03 conclusions into the law/pinout/cart
    - framework v1.8: add 0.5 change table (10 items) + board checklist
    * measured truth replaces all old dims: tread 110 / outer 132 / wheelbase 26 / wheel D 23 / baseplate 88x66
    * encoder is GEAR-DRIVEN (5mm pinion) -> pi*D/4096 is void, calibrate by pushing 1m
    * split: structural baseplate (2.0mm, copper pour, matte black, NO components) + upper circuit board
    * material: PCB for structure, carbon REJECTED (conductive; weight not scored)
    * gray sensing: off-the-shelf LongQiu 8ch ANALOG module (self-drawn subboard void, schematic archived)
    judgment upgraded to per-channel normalization + weighted pos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
2026-10-03 docs(B-che): v1.8 rev - gray module on 5V + AO divider + LDO fixed
    - gray module VCC now on 5V (wide-voltage modules drive the IR emitters
    harder at 5V -> directly de-risks the "printed cloth contrast" issue)
    and it no longer loads the 3.3V LDO
    - only the AO line needs level shifting: 1k / 1.5k divider + 100nF into PA3
    (AD0~AD2 are MCU outputs, no divider)
    - 5V budget back to >=400mA (module ~170 + LDO input ~120 = ~290mA)
    - LDO pinned to ME6211C33M5G-N per the actual schematic; 3.3V load is only
    ~120mA (MCU/IMU/encoders/buzzer) so it is sufficient
    - swept all stale refs (3.3V-module supply, >=250mA, AMS1117, 1k/2.2k per-channel)
2026-10-03 docs(B-che): flag superseded 3.3V-module-supply conclusion in the 10-03 discussion draft (points to v1.8: module on 5V, AO divider only)
2026-10-03 docs(B-che): AT8236 datasheet sourced + application-circuit sheet; fix sense-resistor spec
    - downloaded the official AT8236 datasheet (Hangzhou Zhongke Micro, v1.1, 10 pages)
    into 硬件工程/ so it ships with the repo - the datasheet IS the missing tutorial
    - new 文档/AT8236-照这个画-20261003.md: pinout, truth table, current-limit formula
    ITRIP = VREF/(10*R_ISEN), typical circuit, PCB layout notes, protection behaviour
    - two firmware gotchas captured: (1) IN1=IN2=0 is coast AND sleep (>1ms, needs ~1ms
    to wake) so use 11 (brake) to stop; (2) blanking time 2.2us -> min PWM on-time
    - CORRECTED the sense resistor: it is NOT mOhm-class. With AT8236N (internal
    VREF 3.3V) a 3A limit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
2026-10-03 docs(B-che): VM fuse = one-shot 10A slow-blow (2410); retract the "drop the switch" advice
    - VM rail protection is a one-shot slow-blow SMD fuse 10A (2410, 6.1x2.6mm),
    not a resettable PTC (a 2410 PTC physically tops out around 2-3A hold)
    - logic rail keeps the 0.5A PTC (SMD1206-050-16, the old board's F1)
    - two rails get separate protection; VM peak is 4-6A (worst case 8.5A) so a
    10A slow-blow will not nuisance-trip but still opens on a dead short
    - RETRACTED: v1.8 said "drop the switch". Wrong - the senior's car needed the
    tape because its switch sat on the BOTTOM layer. Our boards are on the UPPER
    layer, so the pins protrude into the 12mm sandwich, nowhere near the ground.
    SW2 s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
2026-10-04 docs(B-che): gray sensor -> module PARALLEL analog output (A0-A7 -> PA0-PA7, ADC scan+DMA)
    - the LongQiu 8-ch module exposes TWO headers: "串出" (address-select, 1 ADC +
    3 GPIO, 400us polling, inter-channel skew) and "并出" (8 simultaneous analog outs)
    - we take 并出: A0~A7 -> PA0~PA7 (= ADC1_IN0~IN7), ADC scan + DMA, ~10us total,
    zero channel skew -> the settling / bit-map-distortion concerns disappear
    - module stays on 5V (brighter IR emitters = directly helps the printed-cloth
    contrast risk) so all 8 outputs are 5V level -> 8x (1k/1.5k + 100nF) dividers
    - 16-ch rejected: it CANNOT do parallel (would need 16 ADC pins; we can muster
    10) so it is forced back onto the slow seria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
2026-10-04 docs(B-che): pinout html - add a per-module supply/level table (3.3V group / 5V group / VM group + rail hierarchy)
2026-10-04 docs(B-che): encoder is a 6P connector (1 GND / 2 VCC / 3 LSB-A / 4 DIR / 5 Z / 6 B) - add wire-by-wire table; we use quadrature A+B only, DIR/Z left open
2026-10-04 docs(B-che): 2 keys (PC13 launch / PB0 test-start) + 3 status LEDs (PC14/PC15/PA12, 470R); free pin is now only PB11
2026-10-04 docs(B-che): buzzer moves to active 5V (low-side NPN, load on 5V / 3.3V control); 5V budget 290->320mA; 3.3V list swaps buzzer for LEDs
2026-10-04 docs(B-che): board outline + mounting holes (frame 54.5 long, board 66 with rear flush, holes at 14.5/23.5/40.5/49.5/63.5 from front edge; probe line 21.5 ahead of front edge)
2026-10-04 docs(B-che): widen board to 88mm per user (recommend 87 for 0.5mm wheel clearance); add the missing hole-X input (frame hole -> wheel inner face distance)
2026-10-04 docs(B-che): add PCB layout work-instruction sheet (pre-start 7 items, layout order, 3 critical rules, pre-Gerber checklist); linked from handover3
2026-10-04 docs(B-che): side frame flipped front/rear by user (encoder now front, motor rear) -> hole table updated to Y=14/28/37/54/63, front axle 28, probe line 17mm ahead of front edge; firmware: flip motor 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
2026-10-04 docs(B-che): handover3 gains a section-0 one-page current state (PCB stage: outline/holes, frame flip, all 10-03/10-04 decisions, pending measurements, the unsolved serial RX mystery, and the working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
2026-10-11 tune(B-che): lap-by-lap auto tuner lands, with review fixes M1-M4 + S1
    - add 脚本/调参/ (调参迭代.py / 调参参数.json / 日志 / 收敛 / best): 工人原型
    - M1 serial SET is now read-back verified; push_all no longer swallows the result
    - M2 self.consec_fail is read again: B phase rolls back to last_good after N DNFs
    - M3 short lap batches are voided (return None) instead of echoing a 1-lap verdict
    - M4 time enters the score; C-1 accepts a vmax only when it is still faster
    - S1 accept_eps kept at 1% + new confirm re-run (measured: 1.1-2.8% signal vs 2.5% noise)
    - C-2 guard: do not probe from a base config that fails the gate
    - fix --check false alarm (6 sig-fig LAP format compa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
2026-10-12 docs(B-che): add tuning review/report/discussion, wiring-order html, BOM exports, silkscreen assets, node manifest, and ins-correction reference
2026-10-12 docs(B-che): add strategist kickoff prompt for firmware skeleton (framework-only, no code; project isolation vs test17)
2026-10-12 docs(B-che): firmware framework proposal draft (bcar project, layered bsp/drivers/middleware/control/app, 5ms tick, flash param store, 9 staged milestones)
2026-10-12 fw(B-che): bcar stage0+1 skeleton - CubeMX project (not named test16) + bsp(afio/gpio/systick) + drivers(led/uart_dbg) + 5ms tick, builds 0err0warn
2026-10-12 fw(B-che): move own sources to src/ (Windows case-collision: drivers/ vs CubeMX Drivers/); patch script now idempotent and rebuilds groups
2026-10-12 docs(B-che): firmware bcar stage0 report - build verified, hardware criteria pending, two build-system traps documented
2026-10-12 fw(B-che): stage1 done (buzzer/key) + stage2 motor PWM TIM1+MOE + serial cmdline; parser split to pure module with PC unit tests (78 pass); fix arg-order bug found by tests
2026-10-12 docs(B-che): update firmware status - stage1 done, stage2 code in place, 4 build traps recorded, PC unit tests 78/78
2026-10-12 fw(B-che): stage3 encoder (TIM2/TIM3 quadrature + partial remap) + odom middleware; PC unit tests 100 pass (78 parse + 22 odom); builds 0err0warn
2026-10-12 docs(B-che): status update - stage3 encoder+odom in, PC tests 100/100, command list
2026-10-12 fw(B-che): stage4 IMU660RC (SPI2 9MHz, mode autodetect, DRDY EXTIs) + heading middleware with bias calib & dead zone; PC tests 117 pass; builds 0err0warn
2026-10-12 docs(B-che): status - stage4 IMU+heading in, PC tests 117/117, add IMU/GYROZERO/HEAD commands
2026-10-12 fw(B-che): stage5 grayscale 8ch ADC1 scan+DMA circular + line_pos normalized centroid; IR/IRBLACK/IRWHITE/IRPOS bench commands; PC tests 144 pass; builds 0err0warn
2026-10-12 docs(B-che): status - stage5 grayscale+A/D+DMA+centroid in, PC tests 144/144, IR bench commands
2026-10-12 fw(B-che): stage6 telemetry - UART TX DMA (non-blocking LAP lines), P2 quantile, per-lap stats (errMean/errP95/lost), LAP/LAPSTART/TLM commands; PC tests 196 pass
2026-10-12 docs(B-che): status - stage6 telemetry in (TX DMA, P2 quantile, lap stats), PC tests 196/196
2026-10-12 docs(B-che): firmware handover doc (single entry for fw line: quickstart, discipline, pitfalls, bench checklist, next steps); mark status doc superseded; remove dead usart.c that would hijack motor P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
2026-10-12 chore(B-che): remove dead usart.c/usart.h and its call from main.c (it would configure PA9/PA10 as UART = motor PWM pins); mark old status doc superseded (previous commit message anticipated this cle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
2026-10-13 docs(all-che): add shareable code-strategy & methods note (layering, PC unit tests, bench CLI, staged bring-up, discipline, pitfalls, design decisions) for teammates/C car to reuse
2026-10-13 feat(navmap): add track-centerline map export + generator script
    Auto-extract the track centerline from the 5000x5000 CAD drawing for
    inertial-navigation use (frame geometry table):
    - 地图导出/nav_map.h : C table, 50mm spacing, 869 pts (~17KB flash)
    - 地图导出/赛道中心线-mm.json : 10mm spacing, full precision (s/x/yaw/radius)
    - 地图导出/赛道中心线-预览.png : overlay preview for verification
    - 脚本/赛道图转惯导地图.py : generator (numpy+PIL only, re-runnable)
    Calibration 5.8005 mm/px (field frame 862px = 5000mm, cross-checked with
    E-area R300 circle). Closed loop, lap length 43.43 m, skeleton coverage 100%.
    Same copy was pushed to the C car repo (j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
2026-10-14 feat(navmap): rebuild map per real travel direction + analytic E-area serpentine
    Fixes on top of the first export:
    - direction: s now increases along the REAL travel direction (car starts in
    the S-G gap facing S => top straight runs -X); verified numerically
    - s=0 moved to the start point (S-G gap centre, 2772/203 mm)
    - E area (4 tangent R300 circles) rebuilt ANALYTICALLY as the intended
    serpentine (4th->3rd->2nd->1st, alternating halves) instead of the walker's
    arbitrary branch choice; circles fitted R=51.7px = 300.0mm (matches nominal)
    - splice now rejects any connector > 100 mm (the old 570 mm straight cuts
    through circles are gone)
    - added two self-checks: max single step <= 100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
2026-10-15 fix(bcar): 5 on-board bring-up bugs found by first real hardware run
    None of these could ever pass the previously-untested hardware gate; the
    firmware had never successfully printed a single line:
    1. uart_dbg: fmt_core ignored width specifiers (%08X/%4u/%02u). It consumed no
    va_arg for them, so every later argument was misaligned -> the following %s
    dereferenced a number -> HardFault on the very first banner line.
    Added %[0][width] parsing + zero/space padding for d/i/u/x/X/s.
    2. uart_dbg: wrong baud formula ((pclk2*25)/(4*baud) = 3906 instead of
    pclk2/baud = 625) -> actual 18432 baud vs 115200 -> all output was garbage.
    3. main: imu660_init() was never called -> SPI2 never enab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
2026-10-15 fw(B-che): stage7-lite closed loop - steering PD + differential mixer + lost-line safety (hold 200ms then brake); bench-tunable PD/BASE/GAIN commands; PC tests 216 pass (control 20); fixes first-tick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
2026-10-15 fix(bcar): wire the stage7 controller to the FSM (it was dead code)
    control_enter_run()/control_exit_run() were defined but never called
    anywhere, so s_running stayed 0 and control_step() returned at its first
    line -> the 'closed loop' would have done nothing on hardware (pressing the
    start key would not move the car), and entering/leaving RUN would not reset
    the PD history or brake.
    main.c now tracks the FSM state edge:
    enter RUN -> control_enter_run() (reset PD history + lost counter, prints BASE)
    leave RUN -> control_exit_run() (brakes the motors, prints)
    while RUN -> control_step(err_mm, visible)
    Also fixed the HELP text for PD (said 'kp2.5?' where kp must be 25.0 for
    'PD 2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
2026-10-15 docs(B-che): handover for the firmware line (2026-10-15) - first on-board run, 5 bring-up bugs, stage7 wiring fix, and the new key/launch-flow requirements
    - new single entry: 文档/交接-固件bcar-20261015.md
    * 3-min quickstart (build / flash with DAPLink retry / COM17 pyserial / bench CLI)
    * the 5 hardware bring-up bugs with root causes + the SWD forensics method
    * stage7 review: control_enter/exit_run were dead code -> wired to the FSM edge
    * hardware verification table (what passed / what is still unverified)
    * SECTION 4 = the user's newly stated key + launch flow spec (NOT implemented yet):
    power-on -> IDLE, 1 beep
    PB0 -> TEST mode, 2 beeps, then wait for seria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
2026-10-15 fw(B-che): key/launch flow per the 2026-10-15 spec + gyro bias auto-zero during the countdown
    Launch flow (the user's spec, now implemented end-to-end):
    - power-on -> IDLE + 1 beep (existed); PB0 -> TEST + 2 beeps (waits for serial commands);
    PC13 short press -> ignored with a hint; PC13 held >=200ms -> COUNTDOWN
    - COUNTDOWN: 3s with 3 beeps (short, short, long) -> RUN. PB0 cancels; MODE COUNTDOWN
    lets the bench test it without touching the keys. The controller hands over on the
    RUN edge as before, so the car actually drives when the countdown ends.
    - source: new src/app/launch.c/.h (countdown sequencer, pure logic, PC-tested),
    key.c (debounced long/short press + hold-ms, long press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
2026-10-15 docs(B-che): handover update - launch flow landed, bench acceptance list, and the measured 0.4 dps gyro drift
    - mark the key/launch flow as implemented (2da800f) with requirement-by-requirement mapping
    - new section 3.2: measured gyro Z offset ~0.4 dps => yaw drifts 0.4 deg/s (45s -> 18.3 deg,
    ~16 deg per lap), which would silently wreck the INS-first design; the countdown now
    auto-zeros it, with the follow-up checks listed
    - add a bench acceptance checklist for the launch flow (what to press / hear / read)
    - record two serial gotchas: DAPLink VCP batches replies by 0.5s-several seconds (do not
    conclude "firmware is dead"), and the printf-vs-TX-DMA race fix needs a re-test
    - flag the o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
2026-10-15 docs(B-che): flashed the launch-flow build and verified it; the serial oddities are all DAPLink VCP, not the firmware
    Flashed bcar.hex (2da800f) over OpenOCD, one shot. Verified without pressing anything:
    - boot banner carries the new 3-line launch-flow text; STATE=IDLE; KEY now reports held= ms;
    MODE TEST/IDLE round-trip prints the new tail; GAIN/PING/HELLO fine; hello runs 1/s with a
    continuous sequence for 148 s; TLM 1 streamed 40 complete lines in 4 s (TX DMA path works)
    - SWD: AFIO->MAPR = 0x02000504 (TIM2/TIM3 partial remaps applied, so the left-encoder fix is
    in), s_tx_busy = 0, s_tx_drop = 0
    Serial gotchas, proven to be the DAPLink VCP rather than the firmware (SWD evidence: S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
2026-10-15 docs(B-che): launch flow accepted on the bench; gyro zero-bias calibration verified (0.0 deg/s over 64 s)
    - section 4 checklist marked accepted: the user ran it and reported "all normal"
    - section 3.2 follow-up closed: GYROZERO measured bias(x,y,z) = (-1.6, 0.7, 0.4) dps; the Z value
    matches the measured 0.405 deg/s drift exactly (so the drift was pure offset), and after
    calibrating the car drifted 0.000 deg/s over 64 s of chip time (target < 0.05 deg/s). The
    countdown auto-zero runs the same code path, so that is verified too
    - remaining gyro items are non-blocking: thermal drift is absorbed because every launch
    re-zeroes, and in-motion noise versus the 0.3 dps dead zone is checked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
2026-10-15 fw(B-che): implement the missing straight-line driving (gyro heading hold) so the car actually drives after launch
    The complaint was right: RUN only had the grey-sensor line loop, and on losing the line it
    braked after 200 ms - so on a bench (no line) pressing PC13 produced no motion at all, and
    at launch the car could not get going unless the line happened to be exactly under the sensor.
    Now RUN has two modes:
    - LINE (grey PD) whenever the line is visible;
    - STRAIGHT (gyro heading hold) at launch and whenever the line is lost: it keeps the heading
    it had at that moment and keeps driving to look for the line, at 0.6x speed. Only after
    BCAR_STR_LOST_MS (2.5 s) without any line does it br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
2026-10-15 docs(B-che): record the straight-line (gyro heading hold) patch - what was missing, the sign convention, SDIR/SGAIN, and the three-step bench check
2026-10-15 fw(B-che): bake the measured grey-sensor calibration (per-channel black/white) and correct the probe pitch
    The sensor readings were unusable because the config carried placeholder references
    (black=200, white=3000) while the module is actually inverted: it outputs a HIGHER voltage
    for a DARKER surface. On plain black it rails at 5 V (raw ~3750), on the white line it reads
    ~30, and in the air (ambient light) 110-270. With the placeholders the firmware computed p up
    to 1.0 on a pure black background - it believed the line was 2.1 mm to the left - which is the
    real reason the car would not drive and steered the wrong way; nothing was wrong with the
    module or the motors.
    Measured on the real tr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
2026-10-15 fw(B-che): add kickstart (the drivetrain has high stiction) and fix the left encoder sign
    The car would not move on a command. Proved the firmware side clean by reading TIM1 over SWD while
    MOTOR FWD 300 was active: CCR1=CCR3=1080 (30% of ARR), CCR4=0, MOE=1, CCER=0x1111 - the PWM really
    is on the pins. The encoders also work (turning the wheel by hand moved the left one by 1092 counts).
    A duty sweep with the encoder as the judge showed the real cause: the motor does not turn at 40% or
    60%, spins at 80% and 100%, but after a 0.25 s full-power kick it keeps turning at 30%. So starting
    from rest needs a big jolt while cruising does not - classic static friction, i.e. a mechanical
    issue (to be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
2026-10-15 fw(B-che): zebra-crossing detection (S/G) + stop at G, thresholds taken from real track data
    Implements the user's spec: the first zebra crossing (S) is logged, the second one (G) ends the
    lap and stops the car, with a distance fallback so the car cannot run away if a crossing is
    missed (the white bars are only 18 mm tall, so at some lateral positions the probe bar may not
    see two of them).
    Thresholds come from measurements on the real track, not from the drawing. That mattered: an
    earlier estimate from the map ("white span > 40 mm") would have false-fired on a plain line,
    because the real line measures a 44 mm span of WEAK white (neighbour probes catch each other's
    light). Real data:
    pla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
2026-10-15 fw(B-che): print a build timestamp on the banner and in STATUS, and add Tools/build.py
    Two traps hit today, both now closed:
    1) A build that failed silently was flashed. UV4 appends to build.log, so the previous run's
    "0 Error(s), 0 Warning(s)" was still in the file while the new errors used a different format
    ("error: #8: missing closing quote") that the usual grep does not match - so a broken build
    looked green and the old hex went onto the board. Tools/build.py deletes the log first and
    matches both error formats; it prints PASS/FAIL and the first errors.
    2) No way to tell which build was on the board. The banner and STATUS now print the compiler's
    __DATE__/__TIME__, e.g.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
2026-10-15 fw(B-che): calibrate the odometry by pushing 1 m, and fix the inverted motor direction
    Both facts come from one measurement: pushing the car 1.00 m toward its nose (the grey-sensor end)
    produced 201330 raw counts on the left encoder.
    1) mm_per_count = 1000/201330 = 0.004967 mm/count (200 counts/mm). The placeholder was 0.1, i.e.
    twenty times off - so every distance, speed and the lap fallback were meaningless. Worth
    remembering: the encoder is gear driven, so pi*D/4096 does not apply; push the car to calibrate.
    2) Motor direction was inverted. Raw counts: pushing forward gives +, MOTOR FWD gives -. So the
    firmware's "forward" drove the car backwards, which also inverts the differen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
2026-10-15 fw(B-che): fan driver (software PWM on PB1/PB2) and a soft-start ramp instead of the kick
    Fan: the board really does have the third AT8236 (U6) on PB1/PB2 through 47R, confirmed by the
    user. Since TIM3 is taken by the right encoder, the fan pins are plain GPIO, so the fan is driven
    by a 200 Hz software PWM (5 ms period, 1 ms of low level every period) from the SysTick ISR - a
    static high level was tried first and the motor only buzzed, which is the signature of the chip
    current-limiting (and a clone H-bridge may also need switching to keep its high side alive). A
    boot self-test spins the fan for 350 ms so the path can be judged without the flaky serial.
    The fan itself turned out to be a dead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
2026-10-15 fw(B-che): tame the line loop (gains 25/3 -> 10/1.5, steer clamp = BASE), add LSDIR to flip the line sign, and debounce the LINE/STRAIGHT handover so a flickering 'visible' cannot make the steering j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
2026-10-15 fw(B-che): add a speed loop (PI on the encoder speed) so friction is compensated automatically
    The car stops after the launch: at BASE=350 (35% duty) the drivetrain cannot sustain motion under
    load - the earlier "30% sustains" measurement was taken with the wheels off the ground. Rather than
    guess a bigger BASE (which changes with every battery and every surface), the loop compensates it:
    the integral raises the duty until the measured speed reaches the target.
    This is the ADRC idea the user asked about (treat friction as a disturbance and cancel it) done with
    the encoder we already have, in two parameters instead of six: speed_pi.c is a pure, unit-tested PI
    with a conditional-integration a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
2026-10-15 fw(B-che): put the gyro heading-hold behind a switch and default it OFF - the user wants plain grey-sensor line following tuned first (GYRO 1 brings it back). Lost line now just drives straight for t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
2026-10-15 fix(bcar): stop the speed loop from fighting the steering, and rate-limit the steering
    The user's geometry note explains the violent swing: the left two wheels are driven by one motor
    and the encoder only reads the left side, so the speed loop measures "left wheel speed". But the
    steering works by making the left and right wheels differ - so the speed loop saw the steering as
    a speed error and countered it. Two loops fighting at the same bandwidth = the nose whips out once
    and the line is gone.
    - VEL_KP/VEL_KI 0.6/2.0 -> 0.15/0.4: the speed loop is now a slow trim (about a second) that only
    compensates friction, well below the steering loop's bandwidth (cascade practice: the inner loop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
2026-10-15 fix(bcar): clamp the steering to a fraction of the current base duty instead of an absolute value - with the high base needed to beat friction, an absolute steer of 400 made the inner wheel reverse a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
2026-10-15 fw(bcar): report the commanded steer in the TLM line (st=) so field tuning can see what the controller actually asks for, not just the resulting error
2026-10-15 fix(bcar): freeze the speed loop while the steering is heavy, and cap the base duty
    The encoder only reads the left side, and the left wheel is also the inner wheel in half of the
    turns, so the steering drags the measured speed down; the speed loop then reads that as 'the car
    slowed down' and adds duty, which sharpens the turn, which drags the left wheel further - a positive
    feedback loop that ends in the car jamming. The speed loop now holds its last output whenever the
    steering exceeds a quarter of it (normal cascade decoupling: the inner loop owns the vehicle during
    a hard turn), and the base duty is capped at 700 so a runaway cannot pin the wheels either.
2026-10-15 docs(B-che): on-track parameter cheat sheet - live commands vs compile-time constants, current defaults and the tuning direction for each (the serial command table existed only in HELP until now)
