xigua862/SMARTCAR2/(notices)

Notices in the files:
固件-STM32空壳/Core/Src/main.c:
Copyright (c) 2026 STMicroelectronics.
All rights reserved.
This software is licensed under terms that can be found in the LICENSE file
开源工程/TC264逐飞开源库/user/cpu0_main.c:
Copyright (c) 2022 SEEKFREE Öð·É¿Æ¼¼
